medicalopenworld/IncuNest/README.md

# 🌍 IncuNest — Incubadora Neonatal de Código Abierto

**IncuNest** (de *in3ator*) es una incubadora neonatal de código abierto diseñada para hospitales con recursos limitados.
Su misión es reducir la mortalidad neonatal mundial proporcionando un dispositivo médico accesible, fiable y replicable localmente.

---

## 🩺 Contexto y Motivación

Cada año, más de **1,5 millones de bebés prematuros** mueren por falta de acceso a una incubadora. Las incubadoras comerciales son costosas (>35.000 €), haciéndolas inaccesibles en muchas regiones.

**IncuNest** es una alternativa **de bajo coste (≈ 350 € en componentes)** y **eficiente energéticamente**, capaz de mantener la temperatura y humedad vitales incluso con suministro eléctrico inestable.

---

## 📂 Estructura del Proyecto

Para una navegación detallada por todos los componentes del sistema, consulta nuestro **[Inventario de Documentación](docs/INVENTARIO.md)**.

### Resumen Rápido
- **[Firmware](Firmware/)**: Código fuente para ESP32 (Motherboard) y Pantalla (Display HMI).
- **[Hardware](Hardware/)**: Planos electrónicos (PCBs, Esquemáticos) y Mecánicos (CAD, Piezas 3D).
- **[Documentación](docs/)**: Guías detalladas e inventario.

---

## ⚙️ Características Clave

- **Control Automático**: Regulación precisa de temperatura y humedad.
- **Seguridad**: Sistema de energía redundante y alarmas.
- **Conectividad**: Telemetría remota y monitorización IoT.
- **Open Source**: Diseño libre para construir, adaptar y mejorar en cualquier lugar.

---

## 🌱 Impacto Social

El proyecto es desarrollado por la ONG [**Medical Open World**](https://medicalopenworld.org/).
- **+200 incubadoras** instaladas en 30 países.
- **Premio Social Princesa de Girona 2025**.

---

## 🤝 Contribuciones y Licencia

Este proyecto se distribuye bajo una **Licencia de Código Abierto para uso no comercial**.
Para uso comercial, se requiere autorización de **Medicina Abierta al Mundo**.

Consulta el archivo [`LICENSE`](LICENSE) para más detalles.

---

**IncuNest** - *"Para que el lugar donde nace un bebé prematuro no limite sus posibilidades de sobrevivir."*
