medicalopenworld/IncuNest/Firmware/SensorBoard_v2/docs/retro/README.md

# Retros (aprendizajes del loop)

Aquí aterrizan los aprendizajes que `retro-improver` extrae al cerrar cada iteración del loop engineering (paso 7, obligatorio al cerrar una sub-tarea de épica — lo blinda el hook `require-retro.sh`). Cada archivo describe qué costó, qué se repitió y qué mejora concreta se aplicó al propio framework (`.claude/` o `CLAUDE.md`), o bien registra el hallazgo como descartado con motivo cuando no supera el filtro de segunda ocurrencia.

## Convención de nombres

`docs/retro/<AAAA-MM-DD>-<slug>.md`, un archivo por retro.

## Filtro de segunda ocurrencia

No se sistematiza una regla por un fallo de primera vez (puede ser casualidad). Se enruta a `.claude/` (hook/rule/skill/agente) o a `CLAUDE.md` solo cuando el patrón se repite, tiene coste observable, o es claramente generalizable. Lo demás se anota aquí como descartado, con el motivo.

## Índice

- [2026-09-03 · Vigilante de host: reconexión USB sin cortar VBUS](2026-09-03-host-watch-reconexion-usb.md)
- [2026-09-03 · Autoswap D+/D- del PHY USB (conector invertido)](2026-09-03-usb-pin-autoswap.md)
- [2026-07-03 · Fase 5 · Cámara](2026-07-03-fase5-camera.md)
- [2026-07-03 · Fase 3 · Micrófono](2026-07-03-fase3-mic.md)
- [2026-07-03 · Fase 4 · Sensor de puerta](2026-07-03-fase4-door.md)
- [2026-07-03 · Fase 2 · Sensores ambientales](2026-07-03-fase2-env-sensors.md)
- [2026-07-03 · Fase 1 · Transporte USB CDC](2026-07-03-fase1-usb-cdc.md)
- [2026-07-03 · EPIC-000 · Adaptación del framework Genesis a ESP-IDF](2026-07-03-epic-000-adapt-genesis-esp-idf.md)
