medicalopenworld/IncuNest/Firmware/openspec/specs/mb-factory-test/spec.md

# mb-factory-test Specification

## Purpose
TBD - created by archiving change shared-factory-test. Update Purpose after archive.
## Requirements
### Requirement: La batería solo arranca con el control apagado

La motherBoard SHALL rechazar `HMI,FTEST,START` y `HMI,FTEST,RUN` con
`CTRL,FTEST_REJECT,1` si `in3.actuation != ACTUATION_OFF` o
`in3.phototherapy` está activa, y con `CTRL,FTEST_REJECT,0` si ya hay una
batería o un test único en curso. La comprobación SHALL hacerse antes de crear
la tarea de test.

#### Scenario: Control térmico activo
- **WHEN** llega `HMI,FTEST,START` con `in3.actuation = ACTUATION_TEMPERATURE`
- **THEN** la motherBoard responde `CTRL,FTEST_REJECT,1` y no toca ningún
  actuador
- *(Verificación manual en banco.)*

#### Scenario: Batería ya en curso
- **WHEN** llega un segundo `HMI,FTEST,START` mientras la tarea `FTEST` existe
- **THEN** la motherBoard responde `CTRL,FTEST_REJECT,0` y la batería en curso
  continúa sin alterarse
- *(Verificación manual en banco.)*

### Requirement: Estado seguro durante la batería y restauración incondicional

Antes del primer test la tarea SHALL: poner `in3.alarmsEnabled = false`,
levantar `g_factoryTestActive` (que hace que `PIDHandler()` y `turnFans()`
retornen sin escribir PWM), pasar los cuatro PIDs a MANUAL, escribir 0 en los
canales PWM de calefactor, fototerapia, ventilador y zumbador, apagar el
humidificador y poner `ACTUATORS_EN` en LOW. Al terminar, abortar o fallar,
SHALL restaurar `in3.alarmsEnabled` a su valor previo, bajar
`g_factoryTestActive` y dejar todos los PWM a 0 y `ACTUATORS_EN` LOW.

#### Scenario: Abort a mitad del test de actuadores
- **WHEN** llega `HMI,FTEST,ABORT` mientras corre `ACTUATORS`
- **THEN** el test en curso termina con `CTRL,FTEST,14,3,abort`, se emite
  `CTRL,FTEST_DONE`, todos los PWM quedan a 0, `ACTUATORS_EN` LOW,
  `in3.alarmsEnabled` vuelve a true y `PIDHandler()` vuelve a escribir PWM
- *(Verificación manual en banco.)*

#### Scenario: Ninguna alarma de actuador durante la batería
- **WHEN** la batería enciende el calefactor y la fototerapia en lazo abierto
- **THEN** no se declara `ALARM_HEATER_FAULT`, `ALARM_FAN_FAILURE` ni
  `ALARM_AIR_OUTLET_BLOCKED`, y `checkUsbFault()` no apaga el humidificador
- *(Verificación manual en banco.)*

### Requirement: El estado inhibido está acotado

La tarea SHALL estar suscrita al task WDT y alimentarlo en cada iteración y en
cada paso de espera. La batería SHALL abortar, con `restore()` y `FTEST_DONE`,
si supera `FTEST_BATTERY_MAX_MS` (6 min, `detail = max time`), si no llega
ninguna línea `HMI,` durante `FTEST_HMI_DEADMAN_MS` (5 s, `detail = hmi lost`)
o si `in3.actuation != ACTUATION_OFF || in3.phototherapy` pasa a ser cierto a
mitad (`detail = control on`). Ningún escritor de PWM (`PIDHandler()`,
`turnFans()`, bloque `newCommand`, regulación de fototerapia,
`buzzerHandler()`) SHALL escribir mientras `g_factoryTestActive`.

#### Scenario: El display se reinicia a mitad de la batería
- **WHEN** el HMI deja de enviar tramas durante más de 5 s con `ACTUATORS` en
  curso
- **THEN** el test termina como SKIP con `detail = hmi lost`, se emite
  `FTEST_DONE`, los PWM quedan a 0 y las alarmas se restauran
- *(Verificación manual en banco: desconectar el cable del HMI.)*

#### Scenario: Keepalive del HMI durante el test de actuadores
- **WHEN** la trama periódica `HMI,...` llega a 1 Hz mientras `actuatorsTest()`
  mide el calefactor al 100 %
- **THEN** el PWM del calefactor no cambia y la corriente medida se estabiliza
  igual que en el autotest de arranque
- *(Verificación manual en banco comparando el log `[HW] -> Heater:` con el
  del arranque.)*

### Requirement: Batería completa en orden fijo, un resultado por test

La tarea SHALL recorrer los `FTEST_MB_COUNT` tests en el orden de la tabla,
emitir `CTRL,FTEST,id,0` (RUNNING) al empezar cada uno y exactamente un
resultado final (`PASS`, `FAIL` o `SKIP`) al terminarlo, y cerrar con
`CTRL,FTEST_DONE,pass,fail,skip` cuyos contadores SHALL coincidir con la
secuencia emitida. `HMI,FTEST,RUN,id` SHALL ejecutar solo ese test dentro del
mismo estado seguro y cerrar igualmente con `FTEST_DONE`.

#### Scenario: Acumulación de resultados
- **WHEN** `ftest_summary` recibe la secuencia PASS, PASS, FAIL, SKIP, PASS
  para los IDs 0..4
- **THEN** los contadores son `pass = 3, fail = 1, skip = 1`, la máscara PASA
  vale `0b10011`, la máscara FALLA `0b00100` y la máscara EJECUTADO `0b11111`
- *(motherBoard `[env:native]`, `test/test_factory_test/`)*

#### Scenario: RUNNING, WAIT y CONFIRM no cuentan como resultado
- **WHEN** la secuencia para un ID es RUNNING, WAIT, WAIT, PASS
- **THEN** los contadores suman un único PASS y el ID aparece una vez en la
  máscara EJECUTADO
- *(motherBoard `[env:native]`)*

#### Scenario: Test único
- **WHEN** llega `HMI,FTEST,RUN,13` con el control apagado
- **THEN** solo se emiten `CTRL,FTEST,13,0`, un resultado final de 13 y
  `CTRL,FTEST_DONE` con la suma de ese único test
- *(Verificación manual en banco.)*

### Requirement: Tests de la SensorBoard por el enlace USB

`SB_STATUS` SHALL pedir `status` y exigir, en ≤ 5 s, las seis
disponibilidades (`sht0`, `sht1`, `sht2`, `als`, `door`, `cam`) a true,
informando `sb_fw` y `usb_swap` en `detail`; si no hay respuesta SHALL dar
FAIL con `detail = sin respuesta`. `SB_ENV` SHALL exigir las tres
temperaturas válidas y frescas, dispersión entre ellas ≤
`FTEST_SB_SPREAD_MAX_C` (1.0 °C) y diferencia entre su media y el SHT4x
exterior ≤ `FTEST_SB_VS_EXT_MAX_C` (3.0 °C). `SB_CAMERA` SHALL pedir una
captura y exigir un JPEG de ≥ 1000 bytes en ≤ 10 s, liberando el buffer. Los
cinco tests `SB_*` dependen de que `SENSORBOARD` haya pasado por USB.

#### Scenario: Decodificar la respuesta `status`
- **WHEN** `sb_json_decode_status_resp()` recibe
  `{"type":"resp","cmd":"status","id":7,"status":"ok","fw":"1.0.0","sensors":{"sht0":true,"sht1":true,"sht2":false,"als":true,"door":true,"cam":true,"usb_swap":false}}`
- **THEN** devuelve true con `fw = "1.0.0"`, `avail_sht = {true,true,false}`,
  `avail_als/door/cam = true`, `usb_swap = false`
- *(motherBoard `[env:native]`, `test/test_sensorboard_json/`)*

#### Scenario: Respuesta `status` incompleta
- **WHEN** falta el objeto `sensors` o `status` no es `"ok"`
- **THEN** el decodificador devuelve false y el snapshot no cambia
- *(motherBoard `[env:native]`)*

#### Scenario: Una SHT40 mal soldada
- **WHEN** `status` devuelve `sht2:false`
- **THEN** `SB_STATUS` da FAIL con `detail` que nombra `sht2`
- *(Verificación manual en banco.)*

### Requirement: Tests con estímulo del operario

`SB_DOOR` SHALL devolver SKIP con `detail = omitido` sin emitir WAIT mientras el
jig de fábrica no monte la puerta (pendiente de reactivar). `SB_LIGHT` SHALL
medir la base de lux durante 2 s, emitir WAIT y dar PASS si el lux cae por
debajo del 50 % de la base dentro de 20 s; con base < 20 lux SHALL dar SKIP con
`detail = poca luz`.

#### Scenario: Puerta omitida
- **WHEN** la batería llega a `SB_DOOR`
- **THEN** emite SKIP `omitido` de inmediato, sin instrucción al operario
- *(Verificación manual en banco.)*

#### Scenario: Operario no tapa el sensor de luz
- **WHEN** pasan 20 s sin caída de lux tras el WAIT de `SB_LIGHT`
- **THEN** `SB_LIGHT` da FAIL con `detail = timeout` y la batería continúa
- *(Verificación manual en banco.)*

### Requirement: Zumbador verificado con el micrófono, con confirmación de respaldo

`BUZZER` SHALL tomar la base de dBA del snapshot, activar el zumbador
(`ledcWrite(BUZZER_PWM_CHANNEL, BUZZER_HALF_PWM)`) hasta recibir una nueva
muestra de `sound_level` (≤ 7 s), apagarlo y dar PASS si la subida es ≥
`FTEST_BUZZER_DBA_DELTA` (6 dB). Si el snapshot no tiene `sound_seen`, SHALL
dar SKIP con `detail = sin microfono` sin hacer sonar el zumbador ni preguntar
al operario: el test de fábrica no hace preguntas de audio.

#### Scenario: Con SensorBoard con micrófono
- **WHEN** hay `sound_seen` y el zumbador suena
- **THEN** `BUZZER` da PASS con `detail` con la base y el pico en dBA
- *(Verificación manual en banco.)*

#### Scenario: Sin micrófono
- **WHEN** el snapshot no tiene `sound_seen`
- **THEN** `BUZZER` da SKIP `sin microfono` y no se emite ningún CONFIRM
- *(Verificación manual en banco.)*

### Requirement: Tests de actuadores y humidificador reutilizan el autotest

`ACTUATORS` SHALL invocar `actuatorsTest()` y dar FAIL si aparece en
`HW_error` cualquier bit nuevo de calefactor, fototerapia o ventilador
respecto al valor previo a la llamada. `FAN_RPM` SHALL exigir
`in3.fanHasSpeedFeedback && in3.fan_rpm >= FAN_MIN_RPM` tras `ACTUATORS`.
`HUMID_USB` SHALL devolver SKIP con `detail = omitido` sin tocar `USB_EN`
mientras el jig de fábrica no pueda medir el humidificador. `STANDBY` SHALL
invocar `testStandByCurrent()` con el mismo criterio de bits nuevos.

#### Scenario: Ventilador sin tacómetro
- **WHEN** `ACTUATORS` pasa pero `in3.fanHasSpeedFeedback` queda false
- **THEN** `FAN_RPM` da FAIL con `detail = sin feedback`
- *(Verificación manual en banco.)*

#### Scenario: Humidificador omitido
- **WHEN** la batería llega a `HUMID_USB`
- **THEN** emite SKIP `omitido` de inmediato y `USB_EN` sigue en LOW
- *(Verificación manual en banco.)*

### Requirement: Tests de comunicaciones pasivos

`GSM_AT` SHALL dar PASS si el módem ha respondido a algún comando AT
(`GPRS.modemResponded`, `GPRS.simReady`, `GPRS.connect` o `GPRS.post`) en ≤
45 s; `GSM_SIM` si `GPRS.simReady` (`+CPIN: READY`) en ≤ 15 s, con el CCID
solo informativo; `GSM_SIGNAL` (opcional) PASS si `1 <= GPRS.CSQ <= 31` en ≤
15 s, si no WARN `sin señal`; `GSM_NET` (opcional) PASS si `GPRS.post` en ≤
`FTEST_CONN_TIMEOUT_MS` (30 s), si no WARN `sin red`. `WIFI` (opcional) SHALL
dar PASS con RSSI si `WIFIIsConnected()` en ≤ 30 s, si no WARN `sin AP`.
`TB_PROVISION` (opcional) SHALL dar WARN `sin serie` si
`in3.serialNumber == 0`, PASS si `WIFIIsConnectedToServer() ||
GPRSIsConnectedToServer()` en ≤ 30 s, y WARN `sin servidor` en otro caso.
`TIME` (opcional) SHALL dar PASS si `time(nullptr) >= 1609459200` con la
fuente en `detail`, si no WARN `sin hora` a los 30 s. Ninguno de estos tests
SHALL escribir en `Serial2`, ni modificar credenciales WiFi, ni forzar
reconexiones. Solo `GSM_AT` y `GSM_SIM` pueden dar FAIL: conectarse es
opcional.

#### Scenario: Módem arrancado antes de pulsar el botón
- **WHEN** el módem completó su secuencia de arranque antes de `HMI,FTEST,START`
- **THEN** `GSM_AT` y `GSM_SIM` dan PASS de inmediato, sin esperar los 45 s
- *(Verificación manual en banco.)*

#### Scenario: Sin cobertura
- **WHEN** hay SIM pero `GPRS.CSQ` no es válido en 15 s
- **THEN** `GSM_SIGNAL` da WARN `sin señal` y `GSM_NET` WARN `sin red`; ningún
  test GSM queda en rojo
- *(Verificación manual en banco.)*

#### Scenario: Sin número de serie
- **WHEN** `in3.serialNumber == 0`
- **THEN** `TB_PROVISION` da WARN con `detail = sin serie` sin esperar los 30 s
- *(Verificación manual en banco.)*

#### Scenario: Sin SIM
- **WHEN** el módem responde pero `GPRS.simReady` sigue en false 15 s después
- **THEN** `GSM_SIM` da FAIL, y `GSM_SIGNAL` y `GSM_NET` dan SKIP con
  `detail = sin sim`
- *(Verificación manual en banco.)*

### Requirement: Persistencia del resultado

Al emitir `FTEST_DONE` tras una batería completa, la motherBoard SHALL
guardar en NVS `mb_ftest`: `epoch` (0 si no hay hora), máscaras PASA, FALLA,
AVISO y EJECUTADO, `FWversion` y `sb_fw`. Un test único SHALL actualizar solo
los bits de su ID en las cuatro máscaras.

#### Scenario: Reintento de un test fallido
- **WHEN** la batería guardó el ID 12 en FALLA y luego `RUN,12` da PASS
- **THEN** en NVS el bit 12 pasa de FALLA a PASA y el resto de bits no cambia
- *(motherBoard `[env:native]` para la lógica de máscaras de `ftest_summary`;
  la escritura NVS, verificación manual.)*

#### Scenario: Aviso que pasa a correcto
- **WHEN** `WIFI` quedó en AVISO y un `RUN` posterior da PASS
- **THEN** el bit pasa de la máscara AVISO a la máscara PASA
- *(motherBoard `[env:native]`)*

### Requirement: El TX hacia el display se serializa en una cola

Toda línea `CTRL,FTEST*` SHALL entregarse por una cola de
`FTEST_TX_QUEUE_LEN` (32) líneas de `FTEST_TX_LINE_MAX` (64) bytes que solo
`Communication_Task` drena y escribe en `hmiSerial`.

Los resultados y el `CTRL,FTEST_DONE` que emite la tarea FTEST SHALL usar
`CommunicationHost_EnqueueWait()`, esperando hasta 500 ms a que haya hueco:
la motherBoard emite UNA sola línea de resultado por test, y perderla deja
ese test sin cerrar en el display. La tarea FTEST corre a prioridad 3, por
debajo de `Communication_Task` (7), que drena la cola entera cada 1 ms, así
que esa espera es siempre corta.

Las líneas que emite `parse_line()` (eco de `RUN`, `CTRL,FTEST_REJECT`) SHALL
seguir usando `CommunicationHost_Enqueue()` sin espera: corren DENTRO de
`Communication_Task`, y esperar ahí sería esperarse a sí misma.

Agotado el plazo — o sin hueco, en la versión sin espera — la línea SHALL
descartarse con log de error y SHALL incrementar `CommunicationHost_TxDrops()`.
Al terminar cada batería la tarea FTEST SHALL registrar en el log el balance
(`p/f/s/w`) y ese contador: con el contador a 0 y tests sin cerrar en el
display, la pérdida NO fue en esta cola (banco 2026-09-07).

#### Scenario: Resultados durante la traza PPG
- **WHEN** la batería emite resultados mientras `CTRL,PPG` sale a 25 Hz
- **THEN** ninguna línea llega al display entrelazada con otra
- *(Verificación manual en banco con la sonda SpO2 aplicada.)*

### Requirement: Sensor ambiental por cualquiera de sus tres caminos

El test `ENV_SENSOR` (id 6) SHALL dar PASS si, en ≤ 10 s, cualquiera de estos
caminos entrega una lectura fresca (< 5 s; < 3 s para USB), finita y en rango:
`usb` (`sensorSourceGet() == SENSOR_SOURCE_SENSORBOARD`, enlace vivo,
`env_seen`, alguna temperatura válida), `i2c` (fuente I2C2 y
`in3.temperature[ROOM_DIGITAL_TEMP_SENSOR]` en `DIG_TEMP_ROOM_MIN..MAX`) o
`sht4x` (`ambientSensorPresent` e `in3.temperature[AMBIENT_DIGITAL_TEMP_SENSOR]`
en −10..60 °C). El camino va en `detail`. En otro caso FAIL con
`detail = sin sensor ambiental`. La cascada `sb_usb` SHALL marcarse OK solo
si el camino fue `usb`; `SB_STATUS`, `SB_ENV`, `SB_DOOR`, `SB_LIGHT` y
`SB_CAMERA` SHALL dar SKIP con `detail = sin usb` en otro caso. `SB_ENV` SHALL
comparar con el exterior solo si hay SHT4x con lectura fresca.

#### Scenario: Unidad con SensorBoard y sin SHT4x
- **WHEN** la SensorBoard publica `sensor_data` y no hay SHT4x exterior
- **THEN** `ENV_SENSOR` da PASS `usb` y `SB_ENV` evalúa solo la dispersión
  entre las tres SHT40
- *(Verificación manual en banco.)*

#### Scenario: Unidad antigua con SHT4x
- **WHEN** no hay SensorBoard, la fuente es I2C2 sin datos y el SHT4x lee
- **THEN** `ENV_SENSOR` da PASS `sht4x` y los cinco `SB_*` dan SKIP
- *(Verificación manual en banco.)*

### Requirement: Los tests no compiten por el bus I2C

Ningún cuerpo de test SHALL emitir transacciones I2C propias, salvo dentro de
`actuatorsTest()` y `testStandByCurrent()`. `CHARGER` SHALL esperar ≤ 12 s a
`g_bq_status_valid` con sello `g_bq_status_ms` fresco (que refresca
`sensors_Task` cada 5 s) y dar PASS si el BQ25730 respondió, informando VBAT,
VSYS y `ac`/`bat` en `detail`; si no responde SHALL dar WARN `sin vbus`: sin
alimentación externa el BQ25730 no está alimentado y no es un fallo de placa.
`POWER_SRC` SHALL devolver SKIP `omitido` mientras el jig no alimente por
VBUS. `SKIN_ADC` SHALL usar `skinProbeLastReading()` y el sello
`lastSuccesfullSensorUpdate[SKIN_SENSOR]`; `INA3221` SHALL usar los flags de
presencia. El runner SHALL esperar 60 ms entre el resultado final de un test y
el RUNNING del siguiente para no desbordar el anillo del display.

#### Scenario: Placa alimentada solo con batería
- **WHEN** no hay VBUS y el BQ25730 no responde
- **THEN** `CHARGER` da WARN `sin vbus` en ≤ 12 s y `POWER_SRC` da SKIP
  `omitido`; ningún test queda en RUNNING
- *(Verificación manual en banco.)*

#### Scenario: Ráfaga de tests omitidos
- **WHEN** varios tests consecutivos terminan en SKIP de inmediato
- **THEN** entre cada resultado y el RUNNING siguiente pasan al menos 60 ms
- *(Verificación manual en banco con el monitor serie.)*

### Requirement: Timeout cooperativo por test

El runner SHALL registrar el inicio de cada test y, si supera
`FTEST_TEST_TIMEOUT_MS` (90 s), el cuerpo SHALL terminar en su siguiente paso
de espera con FAIL y `detail = timeout`; la batería SHALL continuar con el
test siguiente. Un cuerpo bloqueado en una llamada no cooperativa solo lo
cubre el task WDT.

#### Scenario: Test que no progresa
- **WHEN** un cuerpo lleva 90 s en sus bucles de espera sin resultado
- **THEN** emite `CTRL,FTEST,<id>,2,timeout` y arranca el siguiente test
- *(Verificación manual en banco forzando un plazo corto.)*

### Requirement: Orden de ejecución con solape cooperativo

La tarea `FTEST` SHALL clasificar cada test como **pasivo** (solo observa
estado cacheado o una petición asíncrona: `charger`, `env_sensor`,
`sb_status`, `sb_camera`, `gsm_at`, `gsm_sim`, `gsm_signal`, `gsm_net`,
`wifi`, `tb_provision`, `time`, y los instantáneos `sysinfo`, `ina3221`,
`skin_adc`, `hmi_link`, `nvs`, `littlefs`, `power_src`, `humid_usb`,
`sb_door`, `afe_probe`) o **activo** (`standby`, `actuators`, `fan_rpm`,
`buzzer`, `afe_spi`, `sb_env`, `sb_light`). Al arrancar la batería SHALL
emitir RUNNING de todos los pasivos y arrancar un cronómetro común; SHALL
sondearlos cada 250 ms, incluidos los tramos de espera de los activos, y
emitir el resultado final de cada uno en cuanto se resuelva o venza su plazo
propio. Los activos SHALL ejecutarse secuencialmente, en el orden de la
tabla, uno a la vez y nunca solapados entre sí. Las cascadas SHALL
respetarse (`gsm_signal`/`gsm_net` esperan a `gsm_sim`; `sb_status`,
`sb_camera` y `sb_env` esperan a `env_sensor`). Tras el último activo la
tarea SHALL seguir sondeando hasta resolver todos los pasivos. ABORT,
dead-man y tope de batería SHALL cerrar los pasivos pendientes como SKIP con
el motivo. La cota de 90 s por test aplica a los activos; los pasivos se
acotan por su plazo propio. Todo ello sin crear tareas FreeRTOS nuevas: un
único escritor hacia el HMI y ningún acceso concurrente al bus.

#### Scenario: Fábrica sin cobertura ni AP
- **WHEN** no hay SIM registrable, ni AP, ni servidor, ni hora de red
- **THEN** la batería completa termina en menos de 60 s (frente a varios
  minutos en secuencial), con los mismos resultados WARN que antes
- *(Verificación manual en banco con cronómetro.)*

#### Scenario: Los activos nunca se solapan
- **WHEN** `actuators` está midiendo corriente
- **THEN** ningún otro activo está en RUNNING y los pasivos solo leen estado
  cacheado, sin tocar el bus I2C ni los actuadores
- *(Verificación manual en banco: monitor serie, un solo activo RUNNING a la vez.)*

#### Scenario: ABORT con pasivos pendientes
- **WHEN** llega `HMI,FTEST,ABORT` con `wifi` y `tb_provision` aún en RUNNING
- **THEN** ambos terminan como SKIP `abort`, se emite `FTEST_DONE` y se
  restaura el estado seguro
- *(Verificación manual en banco.)*

### Requirement: Activación de la SIM Onomondo

El test `SIM_ACT` (id 28, pasivo) SHALL ejecutarse solo si el ICCID leído del
módem empieza por `ONOMONDO_ICCID_PREFIX` (`894573`); con otra SIM SHALL dar
SKIP `sim no onomondo`, y SKIP `sin sim` si `GSM_SIM` falló. Con SIM Onomondo
SHALL arrancar la activación contra la API en cuanto haya ICCID y WiFi, y dar
PASS si la API confirma la SIM activada (ya activa, o activada en esta
pasada). Si la API **contesta** y la SIM queda sin activar (GET distinto de
200, cuerpo sin `activated`, PATCH rechazado) SHALL dar **FAIL** con el
motivo. Si **no se pudo consultar** la API (sin TLS/HTTP, 429/5xx
persistentes, build sin clave, sin tarea) o si en `FTEST_SIM_ACT_TIMEOUT_MS`
(80 s) no hubo ICCID o WiFi, SHALL dar **WARN** con el motivo (`sin iccid`,
`sin wifi`, `sin respuesta`, `api N`, `sin key`): no se conoce el estado de la
SIM y no es un fallo de la placa.

#### Scenario: Banco sin WiFi con SIM Onomondo
- **WHEN** hay ICCID `894573…` y `WIFIIsConnected()` es falso durante 80 s
- **THEN** `SIM_ACT` da WARN `sin wifi` y el veredicto no pasa a HW ERROR por
  ese test
- *(Verificación manual en banco.)*

#### Scenario: SIM Onomondo que la API no activa
- **WHEN** hay WiFi, el GET devuelve 404 (SIM fuera de la cuenta) o el PATCH
  es rechazado
- **THEN** `SIM_ACT` da FAIL con `get 404` o `patch N` y el veredicto es
  HW ERROR
- *(Verificación manual en banco con red.)*

#### Scenario: SIM de otro operador
- **WHEN** el ICCID no empieza por `894573`
- **THEN** `SIM_ACT` da SKIP `sim no onomondo` sin contactar con la API
- *(Verificación manual en banco.)*

#### Scenario: Activación correcta o ya activa
- **WHEN** hay WiFi y la API responde `activated: true`, ya sea antes o tras
  el PATCH
- **THEN** `SIM_ACT` da PASS con `ya activada` o `activada`
- *(Verificación manual en banco con red.)*
