medicalopenworld/IncuNest/Firmware/SensorBoard_v2/openspec/specs/usb-transport/spec.md

# usb-transport Specification

## Purpose
TBD - created by archiving change sb-phase1-usb-cdc. Update Purpose after archive.
## Requirements
### Requirement: CRC16-CCITT FALSE

El componente `usb_comm` SHALL calcular CRC16-CCITT FALSE (polinomio 0x1021, init 0xFFFF) sobre Type+Length+Payload, con API incremental (`sb_crc16_byte`) y por bloque (`sb_crc16`).

#### Scenario: Vector conocido

- **WHEN** se calcula el CRC de los 9 bytes ASCII `"123456789"`
- **THEN** el resultado es `0x29B1`

#### Scenario: Datos vacíos

- **WHEN** se calcula el CRC de 0 bytes
- **THEN** el resultado es el valor inicial `0xFFFF`

#### Scenario: Incremental equivale a bloque

- **WHEN** se calcula el CRC de un bloque byte a byte con `sb_crc16_byte`
- **THEN** el resultado es idéntico al de `sb_crc16` sobre el bloque completo

### Requirement: Frame encoder

`sb_frame_encode` SHALL producir `Magic(0xAB,0xCD) + Type(1B) + Length(4B little-endian) + Payload + CRC16(2B big-endian)`.

#### Scenario: Layout del frame

- **WHEN** se codifica un payload de N bytes
- **THEN** la salida mide N+9 bytes, empieza por `0xAB 0xCD`, lleva el tipo en el byte 2, la longitud little-endian en los bytes 3-6 y el payload desde el byte 7

#### Scenario: Buffer insuficiente

- **WHEN** el buffer de salida es menor que payload+9
- **THEN** el encoder devuelve 0 y no escribe fuera del buffer

### Requirement: Frame decoder con resincronización

El decoder SHALL ser una máquina de estados byte a byte que entrega frames válidos por callback, descarta silenciosamente frames con CRC inválido, se resincroniza tras bytes basura y rechaza longitudes mayores que su buffer.

#### Scenario: Round-trip

- **WHEN** se alimenta el decoder con un frame codificado por `sb_frame_encode`
- **THEN** el callback recibe exactamente una vez el mismo tipo y payload

#### Scenario: CRC corrupto

- **WHEN** se alimenta un frame con el CRC alterado
- **THEN** el callback no se invoca

#### Scenario: Resync tras basura

- **WHEN** se alimentan bytes arbitrarios que no forman un frame y después un frame válido
- **THEN** el callback se invoca exactamente una vez con el frame válido

#### Scenario: Payload vacío

- **WHEN** se alimenta un frame válido de longitud 0
- **THEN** el callback se invoca con longitud 0

#### Scenario: Longitud excesiva

- **WHEN** el campo Length excede el tamaño del buffer del decoder
- **THEN** el decoder descarta el frame y vuelve a buscar magic sin desbordar el buffer

### Requirement: Emisión única por cola TX

Todo dato saliente SHALL pasar por `sensorBoard_comm_send_json()` o `sensorBoard_comm_send_binary()`, que codifican el frame y lo encolan; solo `usb_tx_task` escribe en el endpoint CDC. `send_binary` SHALL enmarcar el payload en un buffer asignado en PSRAM (fallback a heap interna) cuyo **ownership pasa a la cola TX**: `usb_tx_task` lo transmite por chunks y lo libera siempre (también si el host no está conectado o el envío falla).

#### Scenario: JSON demasiado grande

- **WHEN** `send_json` recibe una cadena mayor que `SB_PROTO_MAX_JSON_PAYLOAD` (256 B)
- **THEN** devuelve error sin encolar nada

#### Scenario: send_binary con argumentos inválidos

- **WHEN** `send_binary` recibe buf NULL, longitud 0 o mayor que `SB_PROTO_MAX_BINARY_PAYLOAD`
- **THEN** devuelve error sin asignar memoria ni encolar

#### Scenario: send_binary sin init

- **WHEN** se invoca `send_binary` antes de `sensorBoard_comm_init()`
- **THEN** devuelve `ESP_ERR_INVALID_STATE`

#### Scenario: Round-trip de frame binario grande

- **WHEN** se codifica un payload `TYPE=0x01` de varios KB con `sb_frame_encode` y se alimenta a un decoder con buffer suficiente
- **THEN** el callback recibe el mismo tipo y payload exactos (el framing es el mismo de Fase 1)

### Requirement: Logs como frames JSON

`usb_comm` SHALL interceptar `ESP_LOG` vía `esp_log_set_vprintf()` y emitirlo como frames JSON `{"type":"log","ts":...,"msg":"..."}` con `"` y `\` escapados; si la cola TX no existe aún, el log se descarta sin bloquear.

#### Scenario: Log antes de init

- **WHEN** se emite un `ESP_LOG` antes de que exista la cola TX
- **THEN** el interceptor retorna sin bloquear ni crashear

### Requirement: Tolerancia a la inversión de D+/D-

`usb_comm` SHALL tolerar que el conector USB (SensorBoard HW_NUM 4) llegue con D+ y D- cruzados, intercambiándolos en el PHY USB del ESP32-S3 (`exchg_pins`) con un detach/attach visible para el host, **solo con evidencia de host**: la política SHALL armar un plazo de `CONFIG_SB_USB_AUTOSWAP_TIMEOUT_MS` (2000 ms por defecto, mínimo 1500) al observar el **primer bus reset** (`DCD_EVENT_BUS_RESET`) y, si al vencer el plazo el host no ha hablado al dispositivo (ni primer SETUP — `tud_connected` — ni `SET_CONFIGURATION` — `tud_mounted`), SHALL intercambiar **una sola vez** y esperar un nuevo bus reset antes de volver a intercambiar. Sin bus reset la orientación NUNCA cambia (arranque y espera sin host en orientación normal). Resets adicionales mientras el plazo está armado NO lo extienden. Con host activo NUNCA intercambia y el plazo se desarma. La decisión SHALL residir en una política pura (`sb_usb_orient_*`) sin dependencia de hardware. Cada intercambio SHALL registrarse con `ESP_LOGW` (visible en la retención de arranque al conectar) y el estado SHALL exponerse en la resp de `status` como `sensors.usb_swap`. Antes de intercambiar, `usb_comm` SHALL re-armar la retención de arranque (el flag DTR es pegajoso sin VBUS sensing), y toda escritura al CDC SHALL exigir DTR visto **y** `tud_cdc_n_connected()`.

#### Scenario: Sin evidencia de host no intercambia

- **WHEN** la política recibe ticks sin bus reset y sin host activo durante un tiempo arbitrariamente largo
- **THEN** no devuelve ninguna acción y la orientación sigue siendo la normal

#### Scenario: Reset sin host: un intercambio y quieto

- **WHEN** ve un bus reset en `t0` y no llega host activo
- **THEN** no actúa antes de `t0 + T`, devuelve la acción de intercambio exactamente una vez en `>= t0 + T`, la orientación pasa a intercambiada, y sin un nuevo reset no vuelve a actuar aunque pase el tiempo

#### Scenario: Resets repetidos no extienden el plazo

- **WHEN** ve bus resets en `t0`, `t0 + T/4` y `t0 + T/2` sin host activo
- **THEN** intercambia en `t0 + T`, no más tarde

#### Scenario: Host activo desarma

- **WHEN** ve un bus reset en `t0` y host activo antes de `t0 + T`
- **THEN** no devuelve ninguna acción en `t0 + T` ni después, y una caída posterior del host sin nuevo reset tampoco provoca intercambio

#### Scenario: Reset y host activo en el mismo tick

- **WHEN** en un mismo tick se observa un bus reset y el host ya está activo
- **THEN** no se arma ningún plazo: los ticks posteriores sin host ni reset no provocan intercambio

#### Scenario: Nueva evidencia tras intercambiar

- **WHEN** tras un intercambio ve otro bus reset sin host activo
- **THEN** intercambia de nuevo (vuelve a la orientación anterior) `T` después de ese reset, y el contador de intercambios vale 2

#### Scenario: Desbordamiento del reloj

- **WHEN** `now_ms` da la vuelta (uint32) entre el reset y el vencimiento
- **THEN** el plazo vence igualmente en `t0 + T` módulo 2^32

#### Scenario: Política desactivada

- **WHEN** el timeout configurado es 0
- **THEN** ningún tick devuelve acción, con o sin reset, con o sin host
