medicalopenworld/IncuNest/Firmware/docs/alarm_images_refs/sensor_aire/QUE_FOTOGRAFIAR.md

# Sensor de temperatura de aire

**Usada por las alarmas:** 3, 15

DOS fotos y la segunda es la que falta hoy: el sensor de cerca, y el sensor MONTADO, con suficiente contexto para ver en que punto de la cupula esta. El modelo lo esta colocando a ojo en la pared trasera.

Deja aqui los ficheros .jpg o .png sin mas. El script los reescala a 1024 px antes de enviarlos, asi que no hace falta prepararlos.

Si esta carpeta se queda vacia no pasa nada: el script avisa y genera igual, con la forma inventada que tiene hoy.
