medicalopenworld/IncuNest/Firmware/docs/alarm_images_refs/sensor_corriente/QUE_FOTOGRAFIAR.md

# Sensor de corriente del calefactor

**Usada por las alarmas:** 17

La placa con su pinza alrededor del cable, y un primer plano del conector de senal, enchufado y desenchufado. La 17 se juega en ese conector.

Deja aqui los ficheros .jpg o .png sin mas. El script los reescala a 1024 px antes de enviarlos, asi que no hace falta prepararlos.

Si esta carpeta se queda vacia no pasa nada: el script avisa y genera igual, con la forma inventada que tiene hoy.
