medicalopenworld/IncuNest/Firmware/docs/alarm_images_refs/sensorboard/QUE_FOTOGRAFIAR.md

# SensorBoard y su enlace USB

**Usada por las alarmas:** 18

El modulo montado en su sitio, su cable USB, y el puerto del equipo donde entra. La 18 necesita mostrar ese conector fuera del puerto.

Deja aqui los ficheros .jpg o .png sin mas. El script los reescala a 1024 px antes de enviarlos, asi que no hace falta prepararlos.

Si esta carpeta se queda vacia no pasa nada: el script avisa y genera igual, con la forma inventada que tiene hoy.
