medicalopenworld/IncuNest/Firmware/docs/alarm_images_refs/sonda_piel/QUE_FOTOGRAFIAR.md

# Sonda de temperatura de piel

**Usada por las alarmas:** 2, 4, 10, 11, 15

El disco y su cable sueltos, y la sonda COLOCADA sobre el abdomen (vale un muneco). La segunda define como se dibuja en 4, 10 y 11.

Deja aqui los ficheros .jpg o .png sin mas. El script los reescala a 1024 px antes de enviarlos, asi que no hace falta prepararlos.

Si esta carpeta se queda vacia no pasa nada: el script avisa y genera igual, con la forma inventada que tiene hoy.
