medicalopenworld/IncuNest/Hardware/Electronics/Motherboard/Project Outputs for IncuNest/BOM/Bill of Materials-IncuNest(Main).xlsx

Comment | Designator | Quantity | LCSC_PN
CUI CMT-1285C-035 | BUZ1 | 1 | C252915
1uF 0402 X5R 50V | C1, C13, C40, C56, C61, C96, C97 | 7 | C1518208
10uF 0402 X5R 10V | C2, C4, C5, C14, C15, C69, C70, C71, C72, C79, C80, C81, C82, C88, C89, C90, C91 | 17 | C77000
100nF 0402 X7R 50V | C3, C11, C12, C23, C24, C25, C26, C43, C57, C68, C73, C76, C77, C78, C83, C86, C87, C92, C95, C98, C99, C100, C103, C104, C106 | 25 | C77020
18pF 0402 X5R 50V | C6, C10, C21 | 3 | C33149
10nF 0402 X7R 50V | C7, C27, C29, C52 | 4 | C60133
2.2uF 0402 X5R 25V | C8, C9, C55 | 3 | C77002
15pF 0402 X5R 50V | C16, C62 | 2 | C86285
33pF 0402 X7R 50V | C22, C65 | 2 | C107005
1nF 0402 X7R 50V | C28 | 1 | C93920
10uF 0805 X5R 50V | C30, C31, C32, C33, C34, C35, C36, C37, C44, C45, C46, C47, C48, C49, C50, C51, C58, C59, C101, C102 | 20 | C2932476
47nF 1206 X7R 50V | C38, C39 | 2 | C107209
150pF 0402 X7R 50V | C41, C42 | 2 | C113789
33nF 0402 X7R 50V | C53, C54 | 2 | C106862
680pF 0402 X5R 50V | C60 | 1 | C307451
100pF 0402 X7R 50V | C63, C64, C66 | 3 | C281751
4.7 uF 0402 X7R 50V | C67 | 1 | C23733
10uF 0603 X5R 25V | C74, C75, C84, C85, C93, C94 | 6 | C91606
100uF 6v3 | C105 | 1 | C1954161
100uF 25V | C107 | 1 | C7469933
LESD5D5.0CT1G | D1, D12 | 2 | C383211
SS14 | D2 | 1 | C2480
BAV99W-7-F | D4, D5, D6, D7 | 4 | C93035
MMSZ5231BT1G | D8 | 1 | C2759896
ESDA6V1-5SC6 | D9 | 1 | C2827672
SMBJ24CA-E3/52 | D10 | 1 | C83268
SMBJ33CA-TR | D11 | 1 | C83325
SMBJ18CA | D13 | 1 | C83327
BAT54C | D14 | 1 | C181200
BZT52C3V0-7-F | D15 | 1 | C85212
BAS316Z | D16 | 1 | C549222
691305530004 | J3 | 1 | C441388
WJ15EDGVC-3.81-2P | J4 | 1 | C22365241
B4B-XH-A(LF)(SN) | J5 | 1 | C144395
2-5747706-0 | J6 | 1 | C189689
PJ-612 | J7 | 1 | C309284
691311400102 | J8, J11 | 2 | C19724644
Degson 2EDGK-5.08-02P-14-00AH | J9 | 1 | C8445
B6B-PH-K_LF__SN_ | J10 | 1 | C495261
1042240820 | J12 | 1 | C585349
TYPE-C 16PLC-H10.0 | J13, J14 | 2 | C3151747
SRP1265A-3R3M | L1 | 1 | C19268665
1217AS-H-3R3N=P3 | L2, L3, L4 | 3 | C514864
IPD90P03P404ATMA1 | Q1 | 1 | C845609
IRLR7843TRPBF | Q2, Q5 | 2 | C21988
2N7002-7-F | Q3, Q6 | 2 | C65189
IRLML6244TRPBF | Q4 | 1 | C143946
AON7528 | Q7, Q8 | 2 | C5297617
BSC059N04LS6ATMA1 | Q9, Q10, Q11, Q12 | 4 | C534356
AON6407 | Q13 | 1 | C13899
AON6442 | Q14 | 1 | C182465
AOD4185 | Q15, Q16 | 2 | C400894
10k 0402 0.1% | R1, R2, R3, R4, R8, R11, R12, R15, R20, R21, R23, R24, R25, R37, R64, R72, R73, R75, R76, R78, R80 | 21 | C190095
4k7 0402 1% | R5, R6 | 2 | C105871
33k 0402 1% | R7, R58 | 2 | C138003
100R 0402 0.1% | R9, R14, R22, R41, R42, R43, R45, R47, R83 | 9 | C106233
1k 0402 1% | R10, R28, R36, R38 | 4 | C106235
0.1R 0402 0.1% | R13, R19 | 2 | C2139031
4.99R 0402 1% | R16, R53, R54 | 3 | C844114
0.005R 1206 0.5W 1% | R17, R48, R49, R59 | 4 | C728276
0R 0402 1% | R18, R34, R35, R39, R40, R55, R56 | 7 | C60485
130Ohm 0402 1% | R26, R27, R29, R30, R31, R32, R33 | 7 | C413066
2k26 0402 0.1% | R44 | 1 | C852697
0.002R 1206 0.5W 1% | R46 | 1 | C728282
3R9 1206 0.5W 1% | R50, R51 | 2 | C17885
1R 0805 0.5W 1% | R60 | 1 | C144579
10R 0402 0.1% | R61, R62, R63, R65 | 4 | C138066
15k 0402 0.1% | R66 | 1 | C852545
383k 0402 1% | R67 | 1 | C2076791
169k 0402 1% | R68 | 1 | C327367
220k 0402 1% | R69 | 1 | C138030
30.1k 0402 1% | R70 | 1 | C138009
40.2k 0402 1% | R71 | 1 | C137983
73k2 0402 1% | R74 | 1 | C185398
56k 0402 0.1% | R77 | 1 | C114756
47k 0402 0.1% | R79 | 1 | C93943
PTS647SK70SMTR2N_LFS | S1 | 1 | C47324878
TS-1088-AR02016 | S2 | 1 | C720477
ESP32-S3-WROOM-1-N8 | U1 | 1 | C2913198
TPS2553DBVR | U2 | 1 | C55266
LM4040EIM7-2.0_NOPB | U3 | 1 | C1848440
AFE4490RHAR | U4 | 1 | C2651608
Simcom SIM800C | U5 | 1 | C2981431
INA3221AIRGVR | U7, U8 | 2 | C181255
ADS1110A0IDBVR | U9 | 1 | C16598
LM74700QDBVRQ1 | U10, U16, U17 | 3 | C2941042
BQ25730RSNR | U11 | 1 | C5219071
TPS563231DRLR | U12, U13, U14 | 3 | C779412
SPX3819M5-L-3-3/TR | U15 | 1 | C9055
UCC27517ADBVR | U18 | 1 | C2653784
ABM3-8.000MHZ-D2Y-T | Y1 | 1 | C144380
