medicalopenworld/IncuNest/Hardware/Electronics/SensorBoard/Project Outputs for SensorBoard/BOM/Bill of Materials-SensorBoard(Main).xlsx

Comment | Designator | Quantity | LCSC_PN
1uF 0402 X5R 50V | C1, C14, C16, C20, C22 | 5 | C1518208
10uF 0402 X5R 10V | C2, C9, C12, C18, C23 | 5 | C77000
100nF 0402 X7R 50V | C3, C4, C5, C6, C7, C8, C10, C11, C13, C15, C19, C21, C24 | 13 | C77020
22pF 0402 X5R 10V | C17 | 1 | C106203
LESD5D5.0CT1G | D1, D2, D3 | 3 | C5274290
SFV24R-1STE1HLF | J2 | 1 | C599469
KH-TYPE-C-16P | J3 | 1 | C709357
SWPA3015S2R2NT | L1 | 1 | C19734
ALS-PT19-315C_L177_TR8 | Q1 | 1 | C146233
10k 0402 0.1% | R1, R2, R6, R12, R14 | 5 | C190095
1k 0402 1% | R7 | 1 | C106235
100k 0402 1% | R8 | 1 | C60491
4k7 0402 1% | R9, R10, R23, R24 | 4 | C105871
0R 0402 1% | R11, R13, R15 | 3 | C60485
33R 0402 1% | R16, R17 | 2 | C138002
5k1 0402 1% | R18, R19 | 2 | C105872
680k 0402 1% | R20 | 1 | C163456
10k 0402 1% | R21 | 1 | C60490
150k 0402 1% | R22 | 1 | C93947
TS-1088-AR02016 | S1 | 1 | C720477
ESP32-S3-WROOM-1-N16R8 | U1 | 1 | C2913202
SHT40-AD1B-R3 | U2, U9 | 2 | C2848306
ICS-41350 | U3 | 1 | C3171856
SHT40-CD1B-R3 | U4 | 1 | C7461852
DRV5032FBDBZR | U5 | 1 | C2655033
XC6206P282MR-G | U6 | 1 | C347374
SY8088AAC | U7 | 1 | C79313
XC6206P152MR-G | U8 | 1 | C424701
