medicalopenworld/IncuNest/(list of files, cad)

Other CAD files:
Hardware/Electronics/FullLEDStrip/Project Outputs for IncuNest_Phototherapy/V4/ExportSTEP/IncuNest_Phototherapy.step
Hardware/Electronics/SensorBoard/Step/IncuNest.step
