medicalopenworld/IncuNest/Firmware/openspec/changes/shared-cascade-ota-distribution/README.md

# shared-cascade-ota-distribution

MB as the only ThingsBoard device, distributing firmware to Display_HMI (UART) and SensorBoard (USB CDC)
