medicalopenworld/IncuNest/Firmware/SensorBoard_v2/openspec/changes/sb-ota-receiver/README.md

# sb-ota-receiver

OTA receiver over USB CDC: write the motherBoard-pushed image to the inactive slot with rollback
