medicalopenworld/IncuNest/Firmware/SensorBoard_v2/CHANGELOG.md

# Changelog

Todos los cambios notables de este proyecto se documentan en este archivo.

El formato sigue [Keep a Changelog](https://keepachangelog.com/es-ES/1.1.0/) y este proyecto usa [Semantic Versioning](https://semver.org/lang/es/). La versión de referencia es `SB_PROTO_FW_VERSION` (definida en `sensorBoard_comm_protocol.h`), no un `package.json`.

## [Unreleased]

### Fixed

- **Tabla de particiones: OTA prometido pero imposible, y sin core dump.** `partitions.csv` (heredada del documento de fase 1) declaraba `factory` + `ota_0` + `ota_1` de 3 MB cada una **sin partición `otadata`**: sin ella `esp_ota_set_boot_partition()` no tiene dónde escribir y el bootloader arranca siempre `factory`, así que eran 6 MB reservados para una capacidad de actualización que no existía (tampoco hay ninguna llamada `esp_ota_*` en el código). Nuevo reparto sobre una app de 356 KB: `ota_0`/`ota_1` de 2 MB con su `otadata` en `0xD000`, `coredump` de 64 KB y `storage` de ~11,9 MB para los JPEG de la fase 5. `ota_0` sigue en `0x10000`, así que el flasheo de fábrica no cambia de offset — pero `flasher_tool` escribe ahora también `ota_data_initial.bin` en `0xD000`, que antes caía dentro de la NVS vieja.
- **Core dump a flash activado.** Con `CONFIG_ESP_CONSOLE_NONE=y` no hay consola y el backtrace de un panic no salía por ningún sitio. `CONFIG_ESP_COREDUMP_ENABLE_TO_FLASH=y` + `CONFIG_ESP_COREDUMP_CHECK_BOOT=y` en `sdkconfig.defaults`, y **`espcoredump` añadido explícitamente a `set(COMPONENTS ...)`**: con el build mínimo el componente quedaba fuera, y entonces sus símbolos Kconfig no existen y confgen descarta las opciones **en silencio** — compilaba, arrancaba y no volcaba nada. Se lee con `idf.py -p COMx coredump-info`. Coste: +18 KB de app.
- **Reconexión USB tras perder el host sin cortar VBUS** (`usb_comm`): el vigilante de host se disparaba solo con el DTR, que no cambia al desenchufar el cable ni al reiniciarse la motherboard (TinyUSB solo lo notifica ante `SET_CONTROL_LINE_STATE`; sin sensado de VBUS el bus solo reporta `SUSPEND`). Ahora "host presente" = `DTR && tud_ready()`, con la política en `sb_host_watch` (función pura con tests Unity `[hostwatch]`) y callbacks de suspend/resume de TinyUSB que limpian el flag de transmisión para que los frames vuelvan a la retención. Además se emite un heartbeat inmediato al volver el host, para que la motherboard levante el enlace en ~1 s y no en ≤30 s.

### Added

- **Tolerancia a la orientación del conector USB — HW_NUM 4 (`usb_comm`)**: tras ver un bus reset del host sin que llegue SETUP ni `SET_CONFIGURATION` en `CONFIG_SB_USB_AUTOSWAP_TIMEOUT_MS` (2 s, mín. 1,5 s), se intercambian D+/D- en el PHY del ESP32-S3 (`exchg_pins`) con detach/attach de 250 ms, una vez por evidencia (sin host no se alterna: la alternancia ciega enganchaba en fase con la pila host de la motherboard, banco 2026-09-03); política pura `sb_usb_orient_*` con 6 `TEST_CASE` en `comm_test`, Kconfig `SB_USB_AUTOSWAP`, log retenido por intercambio y estado `sensors.usb_swap` en `status` (ADR-0003). La V5 corrige el conector en hardware; el mecanismo queda activo e inocuo. El bootloader ROM no aplica el intercambio: flashear con el cable invertido sigue requiriendo girarlo.

### Fixed

- **Autoswap con la motherboard como host (banco 2026-09-03).** El detach del intercambio pasa a `CONFIG_SB_USB_SWAP_DETACH_MS` (1 s) y el enlace queda trazado con `USB bus reset seen` / `USB host active|inactive` (INFO, un evento por conexión). La causa raíz estaba en la motherboard: `gpio_reset_pin(19/20)` dejaba el pull-up interno en las líneas USB y el SensorBoard en modo intercambiado no se detectaba (fix en `sensorboard_comm.cpp` de la motherboard). Nueva opción `CONFIG_SB_LOG_MIRROR_CONSOLE` (por defecto off) para duplicar los logs a UART0 en banco.
- **`usb_comm`: DTR pegajoso.** Las escrituras al CDC exigen ahora DTR **y** `tud_cdc_n_connected()`: si el host desaparece sin cerrar el puerto (sin VBUS sensing), los frames vuelven a la retención de arranque en vez de perderse en un FIFO muerto.
- **Fase 5 — Cámara (`camera_sensor`)**: OV2640 (esp32-camera, QVGA JPEG) con SCCB compartiendo el bus I2C principal, comando `capture` bajo demanda (registro de comandos por componente en `usb_comm`), `sensorBoard_comm_send_binary()` real con frames `TYPE=0x01` en PSRAM y ownership en la cola TX, y `sensors.cam` en `status`.
- **Fase 3 — Micrófono (`mic_sensor`)**: ICS-41350 por I2S en modo PDM RX (16 kHz/16 bit), RMS→dB con offset de calibración Kconfig y gate de plausibilidad [0,140] dB, evento `sound_level` periódico y `sensors.mic` en `status`. El valor `dba` aún no lleva ponderación A (diferido hasta calibrar con sonómetro).
- **Fase 4 — Sensor de puerta (`door_sensor`)**: hall DRV5032FB en IO47 con ISR de solo hand-off, debounce configurable (≥ muestreo interno de 5 Hz del sensor), eventos `door_open`/`door_closed` solo en cambio estable, estado inicial publicado al arrancar y `sensors.door` en `status`.
- **Fase 2 — Sensores ambientales (`env_sensors`)**: 3× SHT40 en dos buses I2C con CRC-8 y conversión datasheet, ALS-PT19 por ADC (conversión sin calibrar, `CONFIG_SB_ALS_UV_PER_LUX`), `sensor_task` con polling configurable, evento `sensor_data` con redundancia posicional y `null` por sensor caído (ADR-0002), y campo `sensors{}` en la resp de `status` vía registro agnóstico en `usb_comm`.
- **Fase 1 — Transporte USB CDC (`usb_comm`)**: proyecto ESP-IDF v6 (ESP32-S3 N16R8, flash 16MB OTA, PSRAM OPI), framing binario `Magic+Type+Length+Payload+CRC16-CCITT`, tareas FreeRTOS RX/TX con `tx_queue`, logs `ESP_LOG` como frames JSON, comando `status`, heartbeat 30 s y test app Unity `comm_test` (ADR-0001).
- Documento de hardware `docs/hardware.md` con el pinout completo confirmado (SHT40 ×3, ALS-PT19 analógico, mic PDM ICS-41350, hall DRV5032, OV2640).
- Framework de agentes Genesis adaptado a ESP-IDF v6/C/FreeRTOS (agentes, rules, hooks, skills y documentación mínima: `ESTADO.md`, `docs/adr/`, `docs/retro/`, `docs/epics/`, `docs/architecture.md`, `docs/blueprint/`).

<!--
Plantilla de entrada al cortar una release (mover [Unreleased] a una sección versionada):

## [X.Y.Z] - AAAA-MM-DD

### Added
### Changed
### Fixed
### Removed
-->
