medicalopenworld/IncuNest/(list of files, drawings)

Other design files:
Hardware/Electronics/FullLEDStrip/IncuNest_Phototherapy.PcbDoc
Hardware/Electronics/FullLEDStrip/IncuNest_Phototherapy.PcbLib
Hardware/Electronics/FullLEDStrip/IncuNest_Phototherapy.PrjPcb
Hardware/Electronics/FullLEDStrip/IncuNest_Phototherapy.SchDoc
Hardware/Electronics/FullLEDStrip/IncuNest_Phototherapy.SchLib
Hardware/Electronics/Motherboard/IncuNest.PrjPcb
Hardware/Electronics/Motherboard/PCB/Motherboard.PcbDoc
Hardware/Electronics/Motherboard/Schematic/Actuators.SchDoc
Hardware/Electronics/Motherboard/Schematic/AFE.SchDoc
Hardware/Electronics/Motherboard/Schematic/Buzzer.SchDoc
Hardware/Electronics/Motherboard/Schematic/Display.SchDoc
Hardware/Electronics/Motherboard/Schematic/GSM.SchDoc
Hardware/Electronics/Motherboard/Schematic/Main.SchDoc
Hardware/Electronics/Motherboard/Schematic/PowerInput.SchDoc
Hardware/Electronics/Motherboard/Schematic/PowerManagement.SchDoc
Hardware/Electronics/Motherboard/Schematic/Sensors.SchDoc
Hardware/Electronics/Motherboard/Schematic/uC.SchDoc
Hardware/Electronics/old/Ambient_sensor/Camera.SchDoc
Hardware/Electronics/old/Ambient_sensor/Main.SchDoc
Hardware/Electronics/old/Ambient_sensor/Power_Input.SchDoc
Hardware/Electronics/old/Ambient_sensor/SensorBoard.PcbDoc
Hardware/Electronics/old/Ambient_sensor/SensorBoard.PrjPcb
Hardware/Electronics/old/Ambient_sensor/Sensors.SchDoc
Hardware/Electronics/old/Ambient_sensor/uC.SchDoc
Hardware/Electronics/SensorBoard/PCB/SensorBoard.PcbDoc
Hardware/Electronics/SensorBoard/Schematic/Main.SchDoc
Hardware/Electronics/SensorBoard/Schematic/PowerManagement.SchDoc
Hardware/Electronics/SensorBoard/Schematic/Sensors.SchDoc
Hardware/Electronics/SensorBoard/Schematic/uC.SchDoc
Hardware/Electronics/SensorBoard/SensorBoard.PcbDoc
Hardware/Electronics/SensorBoard/SensorBoard.PrjPcb
