medicalopenworld/IncuNest/Firmware/motherBoard/include/config/board.h

#ifndef HW_NUM
#error "HW_NUM must be defined via build_flags in platformio.ini (-DHW_NUM=16, -DHW_NUM=17 or -DHW_NUM=18)"
#endif
#define IS_HMI false
#define GPIO_EXP_BASE 100 // To differentiate with ESP32 GPIO
#define PWR_EN 2
#define ON_OFF_SWITCH 4
#define BUZZER 1
#define GSM_UART_TX_PIN 9
#define GSM_UART_RX_PIN 10
#define UART_MB_TX_PIN 15
#define UART_MB_RX_PIN 16
#define ACTUATORS_EN 14
#define HEATER 45
#define FAN 12
#define PHOTOTHERAPY 13
#define FAN_CTL 11
#define FAN_SPEED_FEEDBACK 38
#define USB_EN 5
#define USB_FAULT 6
#define BABY_NTC_PIN 8
#define BABY_TEMP_EN 18
#define ADS1110_I2C_ADDRESS 0x48 // I2C ADC for baby NTC
#define USB_D_MINUS 19
#define USB_D_PLUS 20
#define I2C2_SCL 19 // repurposed from USB_D_PLUS
#define I2C2_SDA 20 // repurposed from USB_D_MINUS
#define I2C_SDA 47
#define I2C_SCL 48
#define AFE_MISO 37
#define AFE_MOSI 35
#define AFE_SCK 36
#define AFE_ADC_READY 17
#define AFE44XX_CS 21
#define FAKE_PIN 46
#define SCREENBACKLIGHT FAKE_PIN
#define AFE44XX_PWDN_PIN FAKE_PIN
#define GPRS_PWRKEY FAKE_PIN
#undef TFT_DC
#define TFT_DC FAKE_PIN
#define ENC_SWITCH FAKE_PIN
#define ENC_A FAKE_PIN
#define ENC_B FAKE_PIN
#undef TFT_CS
#define TFT_CS FAKE_PIN
#if ARDUINO_USB_MODE == 1
#define debugSerial Serial
#else
#define debugSerial Serial
#endif
#define SKIN_SENSOR 0
#define ROOM_DIGITAL_TEMP_SENSOR 1
#define AMBIENT_DIGITAL_TEMP_SENSOR 2
#define SENSOR_TEMP_QTY 3 // number of total temperature sensors in system
#define ROOM_DIGITAL_HUM_SENSOR 0
#define AMBIENT_DIGITAL_HUM_SENSOR 1
#define SENSOR_HUM_QTY 2 // number of total humidity sensors in system
#define SYSTEM_SHUNT_CHANNEL INA3221_CH1
#define PHOTOTHERAPY_SHUNT_CHANNEL INA3221_CH2
#define FAN_SHUNT_CHANNEL INA3221_CH3
#define HEATER_SHUNT_CHANNEL INA3221_CH1
#define DISPLAY_SHUNT_CHANNEL INA3221_CH2
#define USB_SHUNT_CHANNEL INA3221_CH2
#define BATTERY_SHUNT_CHANNEL INA3221_CH3
#if (HW_NUM >= 17)
#define HUMIDIFIER_SHUNT 100 // miliohms
#else
#define HUMIDIFIER_SHUNT 1   // flag (boolean legacy, not used as resistance)
#endif
#define SKIN_NTC_PULSED_EXCITATION false
#if (HW_NUM == 17)
#define HEATER_CURRENT_CORRECTION_FACTOR 5.80f
#define SYSTEM_SHUNT 1000        // miliohms (VSYS_SHUNT+ is not connected properly, is connected before O-ring)
#define HEATER_SHUNT 5        // miliohms
#define FAN_SHUNT 100         // miliohms
#define PHOTOTHERAPY_SHUNT 5   // miliohms
#define USB_SHUNT 100         // miliohms (humidifier via USB_EN channel)
#define BATTERY_SHUNT 27000   // miliohms
#elif (HW_NUM == 18)
#define SYSTEM_SHUNT 5        // miliohms
#define HEATER_SHUNT 2        // miliohms
#define FAN_SHUNT 100         // miliohms
#define PHOTOTHERAPY_SHUNT 5   // miliohms
#define USB_SHUNT 100         // miliohms (humidifier via USB_EN channel)
#define BATTERY_SHUNT 27000   // miliohms
#elif (HW_NUM >= 16)
#define SYSTEM_SHUNT 3        // miliohms
#define FAN_SHUNT 3           // miliohms
#define PHOTOTHERAPY_SHUNT 15 // miliohms
#define BATTERY_SHUNT 27000   // miliohms
#define USB_SHUNT 3           // miliohms
#define HEATER_SHUNT 3        // miliohms
#endif
#define DISPLAY_DEFAULT_ROTATION 3
#define SCREENBACKLIGHT_PWM_CHANNEL 0
#define BUZZER_PWM_CHANNEL 1
#define HEATER_PWM_CHANNEL 2
#define FAN_PWM_CHANNEL 7
#define PHOTOTHERAPY_PWM_CHANNEL 4
#define HUMIDIFIER_PWM_CHANNEL 5
#define FAN_CTL_PWM_CHANNEL 6
#define DEFAULT_PWM_RESOLUTION 8
#define DEFAULT_PWM_FREQUENCY 400
#define BUZZER_PWM_FREQUENCY 400
#define PHOTOTHERAPY_PWM_FREQUENCY 10000
#define HEATER_PWM_FREQUENCY DEFAULT_PWM_FREQUENCY
#define FAN_PWM_FREQUENCY DEFAULT_PWM_FREQUENCY
#define HUMIDIFIER_PWM_FREQUENCY 109000
#define maxADCvalue 4095
#define PWM_MAX_VALUE (pow(2, DEFAULT_PWM_RESOLUTION) - 1)
#define FAN_PWR_SUPPLY_PWM PWM_MAX_VALUE
#define FAN_CTL_PWM_DEFAULT 130
#define FAN_MIN_RPM 3000            // minimum acceptable fan RPM when speed feedback is present
#define FAN_MIN_RPM_HYSTERESIS 300  // rpm above FAN_MIN_RPM required to clear ALARM_FAN_FAILURE
#define FAN_TARGET_RPM 4000
#define FAN_PID_ENABLED_DEFAULT true
#define FAN_SPINUP_GRACE_MS 6000
#define FAN_DUTY_BLOCKED_THRESHOLD 220
#define FAN_DUTY_BLOCKED_HYSTERESIS 20 // duty below (threshold - this) required to clear ALARM_AIR_OUTLET_BLOCKED
#define FAN_DUTY_NORMAL_MAX_OBSERVED 188
#define AIR_BLOCKED_DETECTION_ENABLED true
#define AIR_BLOCKED_SUSTAIN_MS 5000
#if (ADC_READ_FUNCTION == MILLIVOTSREAD_ADC)
#define ADC_TO_DISCARD_MIN 500  // in mV
#define ADC_TO_DISCARD_MAX 2500 // in mV
#else
#define ADC_TO_DISCARD_MIN maxADCvalue / 5     // in ADC points
#define ADC_TO_DISCARD_MAX maxADCvalue * 4 / 5 // in ADC points
#endif
#define DIG_TEMP_TO_DISCARD_MAX 60
#define DIG_TEMP_TO_DISCARD_MIN 5
#define HEATER_CURRENT_LIMIT_ENABLED true
#if (HW_NUM == 18)
#define HEATER_POWER_REFERENCE_IS_SYSTEM_CURRENT true
#else
#define HEATER_POWER_REFERENCE_IS_SYSTEM_CURRENT false
#endif
#define HEATER_MAX_PWM PWM_MAX_VALUE
#define HEATER_HALF_PWR PWM_MAX_VALUE / 2
#define HEATER_START_PWM 1
#define BUZZER_MAX_PWM PWM_MAX_VALUE
#define BUZZER_HALF_PWM PWM_MAX_VALUE / 2
#define MIN_SYSTEM_VOLTAGE_TRIGGER 0
#define MAX_SYSTEM_VOLTAGE_TRIGGER 8
#define SCREEN_BRIGHTNESS_FACTOR                                               \
  0.7 // Max brightness will be multiplied by this constant
#define BACKLIGHT_POWER_DEFAULT PWM_MAX_VALUE *SCREEN_BRIGHTNESS_FACTOR
