medicalopenworld/IncuNest/Firmware/motherBoard/src/main.cpp

/*
  MIT License

  Copyright (c) 2022 Medical Open World, Pablo Sánchez Bergasa

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
*/

// pio run -e IncuNest_V15 -t upload ; pio device monitor

// Firmware version and head title of UI screen

#include "main.h"
#include "modules/util/system_clock.h"
#include "state/state.h"
#include "modules/debug/debug_mode.h"
#include "modules/control/photo_override.h"
#include "modules/sensorboard_comm/sensorboard_comm.h"
#include "modules/sensors/sensor_source.h"
#include "system/hw_selftest.h"
#include "DriveUpload.h"
#include "CrashReporter.h"
#include <Preferences.h>

static Preferences diag_prefs;
uint32_t g_bootCount = 0;
uint32_t g_gprsKillCount = 0;
uint32_t g_monKillCount = 0;
int g_hmiBootCount = 0;
int g_hmiLastRst = 0;
int g_restore_photo_minutes = 0;

// Build-flag crash simulator. Se enciende con la variable de entorno
// INCUNEST_CRASH_TEST (ver main/CMakeLists.txt); la instruccion anterior decia
// platformio.ini, que el porte a ESP-IDF dejo sin efecto. Dispara un panic
// pasados CRASH_TEST_MB_DELAY_S segundos (130 por defecto).
// La alternativa en caliente y sin recompilar es POST /debug/crash.
// Nunca en un binario de produccion.
//   CRASH_TEST_MB=1  → abort() (panic, RST_reason=12)
//   CRASH_TEST_MB=2  → null-pointer LoadProhibited
#ifdef CRASH_TEST_MB
#ifndef CRASH_TEST_MB_DELAY_S
#define CRASH_TEST_MB_DELAY_S 130
#endif
static void CrashTestMBTask(void *pv) {
  for (int i = CRASH_TEST_MB_DELAY_S; i > 0; i--) {
    ESP_LOGW("CRASH_TEST_MB", "MB crash firing in %d s", i);
    vTaskDelay(pdMS_TO_TICKS(1000));
  }
  ESP_LOGE("CRASH_TEST_MB", "Crashing now (CRASH_TEST_MB=%d)", CRASH_TEST_MB);
  vTaskDelay(pdMS_TO_TICKS(50));
#if CRASH_TEST_MB == 2
  { volatile int *p = (int *)0; *p = 0xDEAD; }
#else
  abort();
#endif
  vTaskDelete(NULL);
}
#endif

#if !CONFIG_IDF_TARGET_ESP32S3
TelemetryMessage ctrl_tel_msg = {0, 0, 0, 0};
HMI_CommandMessage hmi_cmd_msg = {0, 0, 0, 0, 0, 0, 0, false};
#endif
char pendingSSID[64] = "";
char pendingPass[64] = "";
char wifi_ssid[64] = "";
char wifi_pass[64] = "";

#include <Arduino.h>
#include <stdarg.h>
#include <stdio.h>

TwoWire *wire;
TwoWire *wire2 = nullptr; // second I2C bus (HW16: SHTC3 + STS35 on pins 19/20)
MAM_IncuNest_Humidifier in3_hum(DEFAULT_ADDRESS);
TFT_eSPI tft = TFT_eSPI(); // Invoke custom library
SHTC3 mySHTC3;             // Declare an instance of the SHTC3 class
SensirionI2cSts3x mySTS35[STS3X_NUM];
Adafruit_SHT4x sht4 = Adafruit_SHT4x();
Beastdevices_INA3221 mainDigitalCurrentSensor(INA3221_ADDR41_VCC);
Beastdevices_INA3221 secundaryDigitalCurrentSensor(INA3221_ADDR40_GND);
// BQ25730 gestionado por BQ25730.cpp (chargerPresent definido allí)

// Encoder rotativo. En la linea del port a ESP-IDF se retiro (e2e3ede), y al
// portar el modo depuracion (17312e3) el rebase arrastro la retirada de estos
// globales como un hunk limpio, dejando colgados los `extern` de ISR.cpp y
// security.cpp. En esta linea el encoder sigue en el arbol, asi que los
// globales vuelven aqui tal cual estaban.
RotaryEncoder encoder(ENC_A, ENC_B, RotaryEncoder::LatchMode::TWO03);
boolean A_set;
boolean B_set;
int encoderpinA = ENC_A;         // pin  encoder A
int encoderpinB = ENC_B;         // pin  encoder B
bool encPulsed, encPulsedBefore; // encoder switch status
bool updateUIData;
volatile int EncMove;                 // moved encoder
volatile int lastEncMove;             // moved last encoder
volatile int EncMoveOrientation = -1; // set to -1 to increase values clockwise
volatile int last_encoder_move;       // moved encoder
long encoder_debounce_time =
    true; // in milliseconds, debounce time in encoder to filter signal bounces
long last_encPulsed; // last time encoder was pulsed

bool WIFI_EN = true;
long lastDebugUpdate;
long loopCounts;
int page;

double errorTemperature[SENSOR_TEMP_QTY], temperatureCalibrationPoint;
double ReferenceTemperatureRange, ReferenceTemperatureLow;
double provisionalReferenceTemperatureLow;
float diffSkinTemperature,
    diffAirTemperature; // difference between measured temperature and user
                        // input real temperature
double RawTemperatureLow[SENSOR_TEMP_QTY], RawTemperatureRange[SENSOR_TEMP_QTY];
double provisionalRawTemperatureLow[SENSOR_TEMP_QTY];
double temperatureMax[SENSOR_TEMP_QTY], temperatureMin[SENSOR_TEMP_QTY];
int temperature_array_pos; // temperature sensor number turn to measure
bool humidifierState, humidifierStateChange;
int previousHumidity; // previous sampled humidity
float diffHumidity; // difference between measured humidity and user input real
                    // humidity

byte autoCalibrationProcess;

// Sensor check rate (in ms). Both sensors are checked in same interrupt and
// they have different check rates
byte encoderRate = true;
byte encoderCount = false;

volatile long lastEncPulse;
volatile bool statusEncSwitch;

bool roomSensorPresent[ROOM_SENSOR_POSIBILITIES];
bool ambientSensorPresent = false;
bool digitalCurrentSensorPresent[2];

// room variables

float minDesiredTemp[2] = {
    SKIN_TEMPERATURE_SET_MIN,
    AIR_TEMPERATURE_SET_MIN}; // minimum allowed temperature to be set
float maxDesiredTemp[2] = {
    SKIN_TEMPERATURE_SET_MAX,
    AIR_TEMPERATURE_SET_MAX}; // maximum allowed temperature to be set
int presetTemp[2] = {36, 32}; // preset baby skin temperature

// Text Graphic position variables
int humidityX;
int humidityY;
int temperatureX;
int temperatureY;
int separatorTopYPos, separatorMidYPos, separatorBotYPos;

bool enableSet;
float temperaturePercentage, temperatureAtStart;
float humidityPercentage, humidityAtStart;
int barWidth, barHeight, tempBarPosX, tempBarPosY, humBarPosX, humBarPosY;
int screenTextColor, screenTextBackgroundColour;

// User Interface display variables
bool selected;
char cstring[128];
char *textToWrite;
char *words[12];
char *helpMessage;
byte bar_pos = true;
byte menu_rows;
byte length;
long lastGraphicSensorsUpdate;
long lastSensorsUpdate;
bool enableSetProcess;
long blinking;
bool state_blink;
bool blinkSetMessageState;
long lastBlinkSetMessage;

long lastSuccesfullSensorUpdate[SENSOR_TEMP_QTY];
uint32_t g_sensorsTaskStartedMs = 0;

long lastSkinAttachedSensorUpdate;
long lastRoomSensorUpdate, lastCurrentSensorUpdate;
bool roomSensorOk = false;

IncuNest_parameters in3;

TaskHandle_t taskHandle =
    NULL; // Handle for the task we want to delete if it hangs
long GPRS_lastMillisTaskClear;
bool TB_connected;

void GPRS_Task(void *pvParameters); // forward decl: GPRSMonitorTask restarts it on hang

QueueHandle_t sharedSensorQueue;
// Mutex for protecting the shared variable
SemaphoreHandle_t GPRS_monitor_mutex;
SemaphoreHandle_t log_mutex = NULL;

void GPRSMonitorTask(void *pvParameters) {
  for (;;) {
    if (xSemaphoreTake(GPRS_monitor_mutex, portMAX_DELAY)) // Lock the mutex
    {
      if (millis() - GPRS_lastMillisTaskClear > GPRS_MONITOR_TASK_DELETE) {
        g_monKillCount++;
        diag_prefs.begin("diag", false);
        diag_prefs.putUInt("mon_kill", g_monKillCount);
        diag_prefs.end();
        {
          const char *m = "[MON] GPRS_Task hung, restarting it\n";
          crashReporterPut(m, strlen(m));
        }
        vTaskDelete(taskHandle); // Delete the hung task
        GPRS = GPRSstruct();     // drop state left over from the aborted attempt
        GPRS_lastMillisTaskClear = millis();
        // Recreate GPRS_Task so a single hung AT call doesn't kill cellular
        // connectivity for good; the new task spawns its own fresh monitor.
        xTaskCreatePinnedToCore(GPRS_Task, "GPRS", 16384, NULL,
                                GPRS_TAST_PRIORITY, &taskHandle,
                                CORE_ID_FREERTOS);
        xSemaphoreGive(GPRS_monitor_mutex);
        vTaskDelete(NULL); // this monitor's job is done
      }
      if (GPRSIsConnectedToServer() || WIFIIsConnectedToServer()) {
        vTaskDelete(NULL); // Delete the monitor task
      }
      // Unlock the mutex
      xSemaphoreGive(GPRS_monitor_mutex);
    }
    vTaskDelay(pdMS_TO_TICKS(GPRS_MONITOR_TASK_PERIOD));
  }
}

void GPRS_Task(void *pvParameters) {
  xTaskCreatePinnedToCore(GPRSMonitorTask, (const char *)"GPRS_MONITOR", 4096,
                          NULL, GPRS_MONITOR_TASK_PRIORITY, NULL,
                          CORE_MONITOR_FREERTOS);
  initGPRS();
  GPRS_TB_Init();
  for (;;) {
    GPRS_Handler();
    // Modify the shared variable
    GPRS_lastMillisTaskClear = millis();
    // Unlock the mutex
    xSemaphoreGive(GPRS_monitor_mutex);
    vTaskDelay(pdMS_TO_TICKS(GPRS_TASK_PERIOD_MS));
  }
}

BQ25730_Status g_bq_status      = {};
bool           g_bq_status_valid = false;
// millis() del ultimo refresco con exito: el test de fabrica exige frescura
// ademas del flag, porque un `true` sin sello sobreviviria a una tarea parada.
uint32_t       g_bq_status_ms    = 0;
void sensors_Task(void *pvParameters) {
  // Instante en que empieza a haber muestras periodicas de verdad. Lo usa
  // checkStatusOfSensor() (security.cpp) como referencia de frescura: el sello
  // que deja el autotest de initHardware() es varios segundos anterior y
  // levantaba ALARM_AIR_SENSOR_FAULT en cada arranque.
  g_sensorsTaskStartedMs = millis();
  if (g_sensorsTaskStartedMs == 0) {
    g_sensorsTaskStartedMs = 1; // 0 es el centinela de "aun no arranco"
  }
  for (;;) {
    fanSpeedHandler();
    if (millis() - lastSkinAttachedSensorUpdate >
        SKIN_SENSOR_UPDATE_PERIOD_MS) {
      measureSkinSensor();
      lastSkinAttachedSensorUpdate = millis();
    }
    {
      long roomPeriod = roomSensorOk ? ROOM_SENSOR_UPDATE_PERIOD_MS
                                     : ROOM_SENSOR_RECONNECT_MS;
      if (millis() - lastRoomSensorUpdate > roomPeriod) {
        roomSensorOk = updateRoomSensor();
        updateAmbientSensor();
        lastRoomSensorUpdate = millis();
      }
    }
    if (millis() - lastCurrentSensorUpdate > DIGITAL_CURRENT_SENSOR_PERIOD_MS) {
      powerMonitor();
      lastCurrentSensorUpdate = millis();
    }
    {
      static long lastChargerUpdate = 0;
      static bool prev_ac_present   = false;
      static bool charger_in_float  = false;
      static long ichg_low_since    = 0;
      if (chargerPresent && millis() - lastChargerUpdate > 5000) {
        g_bq_status_valid = charge_status(&g_bq_status);
        if (g_bq_status_valid) g_bq_status_ms = millis();
        lastChargerUpdate = millis();
        // Detecta transición ausente→presente del adaptador y reinicializa el
        // chip: algunos BQ25xxx pierden VINDPM/IIN al re-detectar VBUS, así que
        // reaplicamos toda la config para asegurar carga estable.
        // Al reconectar siempre se vuelve a absorción: la batería pudo haberse
        // descargado parcialmente durante el corte.
        if (g_bq_status_valid && g_bq_status.ac_present && !prev_ac_present) {
          if (LOG_CHARGER) logCharger("[CHG] Adaptador detectado → reinicializando config");
          extern TwoWire *wire;
          init_BQ25730(wire);  // restaura MaxChargeVoltage = 14.4V (absorción)
          charger_in_float = false;
          ichg_low_since   = 0;
        }
        if (g_bq_status_valid) prev_ac_present = g_bq_status.ac_present;

        // ── Transición Absorción → Flotación ─────────────────────────────────
        // Cuando ICHG cae por debajo del umbral de corte durante 60 s seguidos,
        // se cambia la tensión objetivo a flotación para mantener la batería sin
        // seguir gasificándola. El umbral (320 mA ≈ C/22 para 7 Ah) equivale a
        // 2–3 counts ADC; la ventana de 60 s evita falsos disparos por ruido.
        if (g_bq_status_valid && g_bq_status.ac_present && !charger_in_float) {
          if (g_bq_status.ichg_ma < BQ25730_ICHG_TERM_MA) {
            if (ichg_low_since == 0) {
              ichg_low_since = millis();
            } else if (millis() - ichg_low_since >= 60000UL) {
              set_charge_voltage(BQ25730_VCHARGE_FLOAT_MV);
              charger_in_float = true;
              ichg_low_since   = 0;
              if (LOG_CHARGER)
                logCharger("[CHG] Absorcion completa → Flotacion " +
                           String(BQ25730_VCHARGE_FLOAT_MV) + " mV");
            }
          } else {
            ichg_low_since = 0;
          }
        }
      }
    }
    // Las medidas simuladas del modo depuracion se pisan AQUI: despues de que
    // los sensores reales hayan escrito y ANTES de copiar a ctrl_tel_msg, para
    // que el control, securityCheck() y el display vean todos exactamente el
    // mismo valor. Con el modo apagado no hace nada y la medida real vuelve
    // sola en la pasada siguiente. Ver modules/debug/debug_mode.h.
    debug_sensors_apply();

    ctrl_tel_msg.detectedAirTemperature =
        in3.temperature[ROOM_DIGITAL_TEMP_SENSOR];
    ctrl_tel_msg.detectedSkinTemperature = in3.temperature[SKIN_SENSOR];
    ctrl_tel_msg.detectedHumidity = in3.humidity[ROOM_DIGITAL_HUM_SENSOR];
    vTaskDelay(pdMS_TO_TICKS(SENSORS_TASK_PERIOD_MS));
  }
}

// ---------------------------------------------------------------------------
// Consola de depuracion sobre debugSerial (el puerto por el que sale el log).
//
// NO es el enlace con el display: ese es Serial1 en los pines 15/16
// (hmiSerial en CommTask.cpp). Por debugSerial no habla nadie, asi que un
// comando aqui no compite con las tramas del protocolo ni puede corromperlas.
//
// Dos comandos, y a proposito ninguno mas:
//
//   "WIFI_EN,<0|1>"  para probar la OTA por 2G, que con la WiFi levantada no se
//                    ejercita nunca.
//   "PHOTO,<0|1>"    enciende/suelta la fototerapia para probar el lazo de
//                    intensidad sin nadie en la pantalla. PHOTO,1 exige el modo
//                    depuracion encendido; PHOTO,0 se acepta siempre, porque
//                    apagar nunca es lo peligroso. Va SOLO por aqui, sin
//                    endpoint HTTP: acciona un actuador y esta consola pide
//                    acceso fisico al USB (ver debug_mode.h).
//
// Nada de esto se guarda: cualquier reinicio vuelve a dejar la WiFi encendida
// y la fototerapia como la tenga el display. Lo demas se ignora.
// ---------------------------------------------------------------------------
// ESP_LOGx y no logI/logE: main.h compila esos dos fuera del binario
// (LOG_INFORMATION y LOG_ERRORS estan a false), asi que un acuse escrito con
// logI no se imprime nunca y la consola parece muerta aunque funcione.
static const char *DBGCON_TAG __attribute__((unused)) = "DBGCON";

static void debugConsoleHandle(const char *line) {
  if (strncmp(line, "PHOTO,", 6) == 0) {
    const char *arg = line + 6;
    // Mismo parseo estricto que WIFI_EN: un '0' o un '1' y nada mas.
    if ((arg[0] != '0' && arg[0] != '1') || arg[1] != '\0') {
      ESP_LOGW(DBGCON_TAG, "PHOTO: argumento invalido, se espera 0 o 1");
      return;
    }
    if (arg[0] == '0') {
      debug_photo_off();
      ESP_LOGW(DBGCON_TAG, "PHOTO,0: fototerapia de depuracion soltada; vuelve "
               "a mandar el display tras %u ms de gracia",
               (unsigned)PHOTO_OVERRIDE_RELEASE_GRACE_MS);
      return;
    }
    // in3.phototherapy es aqui la ultima orden REAL del display: todavia no
    // la ha podido contaminar esta prueba.
    if (!debug_photo_on(in3.phototherapy)) {
      ESP_LOGW(DBGCON_TAG, "PHOTO,1 rechazado: el modo depuracion esta apagado "
               "(POST /debug/mode?on=1)");
      return;
    }
    ESP_LOGW(DBGCON_TAG, "PHOTO,1: fototerapia de depuracion ENCENDIDA (se "
             "aplica con la siguiente trama del display)");
    return;
  }
  if (strncmp(line, "WIFI_EN,", 8) != 0) {
    ESP_LOGI(DBGCON_TAG, "comando desconocido, ignorado: %s", line);
    return;
  }
  const char *arg = line + 8;
  // Exactamente un '0' o un '1' y nada mas: sin atoi(), "WIFI_EN,0abc" no se
  // cuela como un apagado valido.
  if ((arg[0] != '0' && arg[0] != '1') || arg[1] != '\0') {
    ESP_LOGW(DBGCON_TAG, "WIFI_EN: argumento invalido, se espera 0 o 1");
    return;
  }
  wifiRequestEnable(arg[0] == '1');
}

void debugConsolePoll(void) {
  static char buf[40];
  static size_t len = 0;
  while (debugSerial.available()) {
    const char c = (char)debugSerial.read();
    if (c == '\r') continue;
    if (c != '\n') {
      // Al pasarse de largo se marca la linea y se descarta ENTERA al final,
      // en vez de procesar un trozo: media linea podria ser un comando valido
      // por accidente.
      if (len < sizeof(buf) - 1)
        buf[len++] = c;
      else
        len = sizeof(buf);
      continue;
    }
    if (len < sizeof(buf)) {
      buf[len] = '\0';
      debugConsoleHandle(buf);
    }
    len = 0;
  }
}

void OTA_WIFI_Task(void *pvParameters) {
  WIFI_TB_Init();
  for (;;) {
    debugConsolePoll();
    WifiOTAHandler();
    vTaskDelay(pdMS_TO_TICKS(OTA_TASK_PERIOD_MS));
  }
}

void buzzer_Task(void *pvParameters) {
  for (;;) {
    buzzerHandler();
    vTaskDelay(pdMS_TO_TICKS(BUZZER_TASK_PERIOD_MS));
  }
}

void security_Task(void *pvParameters) {
  for (;;) {
    if (ALARM_SYSTEM_ENABLED && in3.alarmsEnabled) {
      securityCheck();
    }
    vTaskDelay(pdMS_TO_TICKS(SECURITY_TASK_PERIOD_MS));
  }
}

void TimeTrack_Task(void *pvParameters) {
  for (;;) {
    timeTrackHandler();
    vTaskDelay(pdMS_TO_TICKS(TIME_TRACK_TASK_PERIOD_MS));
  }
}

void Communication_Receiver(void *pvParameters) {
  for (;;) {
    if (hmi_cmd_msg.newCommand) {
      hmi_cmd_msg.newCommand = false;

      String msg = "HMI CMD -> act=" + String(hmi_cmd_msg.actuation) +
                   " mode=" + String(hmi_cmd_msg.controlMode) +
                   " air=" + String(hmi_cmd_msg.desiredAirTemperature, 1) +
                   " skin=" + String(hmi_cmd_msg.desiredSkinTemperature, 1) +
                   " hum=" + String(hmi_cmd_msg.desiredHumidity, 0) +
                   " photo=" + String(hmi_cmd_msg.phototherapyMode) +
                   " mute=" + String(hmi_cmd_msg.muteAlarm) +
                   " lang=" + String(hmi_cmd_msg.language);

      logI(msg);

      // Reset the alarm stabilization window (see alarmTimerStart(),
      // security.cpp) only on the OFF->ON transition, matching what the
      // now-removed on-board UI (legacy/UI_actuatorsProgress.cpp) used to do
      // when a user confirmed activation from its menu. The HMI-driven path
      // resends this command on every command cycle even while actuation
      // stays on, so gating on the transition (rather than "actuation != 0")
      // avoids perpetually postponing the window and suppressing alarms.
      bool actuationWasOff = (in3.actuation == ACTUATION_OFF);
      in3.actuation = hmi_cmd_msg.actuation;
      { Preferences p; p.begin(NS_STATE, false); p.putUChar(KEY_ACTUATION, in3.actuation); p.end(); }
      if (actuationWasOff && in3.actuation != ACTUATION_OFF) {
        alarmTimerStart();
      }
      if (in3.controlMode != hmi_cmd_msg.controlMode) {
        in3.controlMode = hmi_cmd_msg.controlMode;
        { Preferences p; p.begin(NS_CFG, false); p.putUChar(KEY_CTRL_MODE, in3.controlMode); p.end(); }
      }

      const bool tempBlocked = ongoingCriticalWiringAlarm();

      switch (in3.actuation) {
      case ACTUATION_TEMPERATURE:
        in3.temperatureControl = !tempBlocked;
        in3.humidityControl = false;
        break;
      case ACTUATION_HUMIDITY:
        in3.temperatureControl = false;
        in3.humidityControl = true;
        break;
      case ACTUATION_TEMP_AND_HUMIDITY:
        in3.temperatureControl = !tempBlocked;
        in3.humidityControl = true;
        break;
      default:
        in3.temperatureControl = false;
        in3.humidityControl = false;
        break;
      }

      if (in3.temperatureControl) {
        double newDesiredTemp = in3.controlMode ? hmi_cmd_msg.desiredAirTemperature
                                                 : hmi_cmd_msg.desiredSkinTemperature;
        if (newDesiredTemp != in3.desiredControlTemperature) {
          in3.desiredControlTemperature = newDesiredTemp;
          // Persisted so a restoreState boot (crash/WDT) restarts the PID at
          // the setpoint the user actually configured, not the compiled-in
          // default (KEY_CTRL_TEMP's fallback in recapVariables()).
          Preferences p;
          p.begin(NS_CFG, false);
          p.putFloat(KEY_CTRL_TEMP, in3.desiredControlTemperature);
          p.end();
        }
        startPID(in3.controlMode);
      } else {
        stopPID(CONTROL_AIR);
        stopPID(!CONTROL_AIR);
        // El test de fabrica tiene el canal del calefactor en estado seguro
        // (design.md D4, shared-factory-test): no pisarlo con este keepalive
        // del HMI, que se repite en cada trama aunque actuation ya este OFF.
        if (!g_factoryTestActive)
          ledcWrite(HEATER_PWM_CHANNEL, false);
      }
      if (in3.humidityControl) {
        if (hmi_cmd_msg.desiredHumidity != in3.desiredControlHumidity) {
          in3.desiredControlHumidity = hmi_cmd_msg.desiredHumidity;
          // Same rationale as KEY_CTRL_TEMP above, for humidity restoreState boots.
          Preferences p;
          p.begin(NS_CFG, false);
          p.putUChar(KEY_CTRL_HUM, in3.desiredControlHumidity);
          p.end();
        }
        startPID(humidityPID);
      } else {
        stopPID(humidityPID);
        // Idem HEATER_PWM_CHANNEL arriba: el humidificador tambien es parte
        // del estado seguro del test de fabrica (design.md D4).
        if (!g_factoryTestActive)
          in3_hum.turn(OFF);
      }

      // Estado ANTERIOR, para distinguir el flanco de encendido del keepalive.
      const bool photoEstabaEncendida = in3.phototherapy;
      // Normalmente es lo que manda el display. Con un encendido de depuracion
      // en marcha (o en su ventana de gracia) manda photo_override: fuerza ON
      // durante la prueba e ignora despues el ON rancio que el display habra
      // adoptado. Ver modules/control/photo_override.h.
      in3.phototherapy = debug_photo_effective(hmi_cmd_msg.phototherapyMode);
      // Se guarda la orden DEL DISPLAY, y solo cuando no hay prueba en curso:
      // durante ella el display devuelve el ON adoptado, y guardarlo haria que
      // una caida reanudase una sesion de depuracion como si fuera real.
      if (debug_photo_may_persist()) {
        Preferences p;
        p.begin(NS_STATE, false);
        p.putUChar(KEY_PHOTO_ACTIVE, hmi_cmd_msg.phototherapyMode);
        p.end();
      }
      if (in3.language != hmi_cmd_msg.language) {
        in3.language = hmi_cmd_msg.language;
        resendActiveAlarms();
      }
      if (in3.phototherapy) {
        if (in3.photoFirstRun) {
          in3.phototherapy_intensity = PWM_MAX_VALUE * PHOTOTHERAPY_INITIAL_PWM_PCT / 100;
          in3.photoFirstRun = false;
        }
        // SOLO en el flanco de encendido. Esto estaba fuera del if y se
        // ejecutaba en cada mandato del HMI, que es un KEEPALIVE: CommTask.cpp
        // pone newCommand=true en cada trama recibida, ~1 por segundo.
        //
        // photoTurnOnTime es la marca de asentamiento que mira el lazo de
        // regulacion de intensidad (sensors_module.cpp, currentMonitor):
        //
        //     millis() - in3.photoTurnOnTime > PHOTO_SETTLE_MS   // 3000 ms
        //
        // Refrescandola cada segundo esa condicion NO se cumple NUNCA, asi que
        // el lazo no llegaba a ejecutarse jamas y PHOTO_TARGET_CURRENT era
        // codigo muerto: la lampara se quedaba en la semilla en lazo abierto.
        //
        // Medido en banco el 2026-09-23: semilla PWM 102 (extrapolada por el
        // autotest para 0.27 A desde una lectura de 0.10 A al 10 % de PWM) y
        // corriente real 0.59-0.60 A sostenida durante 6 minutos. La
        // extrapolacion 1/x se equivoca por 2.2x porque el consumo del LED no
        // es lineal con el duty; corregir eso es justo el trabajo del lazo.
        if (!photoEstabaEncendida) {
          in3.photoTurnOnTime = millis();
        }
      }
      // Idem: el canal de fototerapia tambien lo posee el test de fabrica
      // mientras dura la bateria. La reconciliacion con in3.phototherapy
      // (actualizado arriba, sin gate: eso SI debe seguir reflejando la
      // trama) la hace este mismo newCommand en su siguiente vuelta, en
      // cuanto g_factoryTestActive baje (ver cabecera de
      // factory_test_task.cpp).
      if (!g_factoryTestActive)
        ledcWrite(PHOTOTHERAPY_PWM_CHANNEL,
                  in3.phototherapy * in3.phototherapy_intensity);
      turnFans(bool(in3.phototherapy || in3.actuation));

      // AQUI NO SE PITA AL RECIBIR UNA TRAMA DEL DISPLAY.
      //
      // Habia un shutBuzzer() + buzzerTone() en este punto: el zumbador de la
      // placa sonaba cada vez que llegaba una trama, que era el truco con el
      // que el display conseguia confirmacion sonora al tocar un boton. Ese
      // papel lo cubre ahora el zumbador del propio display, y los envios de
      // estado que solo existian para dispararlo ya se retiraron.
      //
      // Quitarlo era obligado desde el latido de 1 Hz, que lo convertia en un
      // pitido por segundo. Pero el problema de fondo es peor y llevaba aqui
      // desde antes: buzzerHandler()/buzzerTone() y buzzerAlarmUpdate()
      // escriben el MISMO canal PWM. Cada trama recibida hacia shutBuzzer(),
      // o sea ledcWrite(0), pisando la rafaga de alarma que estuviera sonando
      // y destrozando el patron de la Tabla 3.
      //
      // Y un pulso suelto del zumbador de la placa es acusticamente identico
      // a una rafaga de prioridad BAJA, que es de UN solo pulso: el
      // transductor de las alarmas no puede emitir sonidos que no sean
      // alarmas.
    }

    // Handle Phototherapy timer expiration/calculation constantly
    // This runs even if no HMI is connected, ensuring hardware turns OFF.
    getRemainingPhotoTime();

    // Unconditional: every loop inside gates itself on its own PID mode, and
    // the fan loop must run for phototherapy-only activation too (fan is
    // commanded on with in3.actuation == 0 — gating on actuation left
    // FAN_CTL_PWM_CHANNEL undriven and false-fired ALARM_FAN_FAILURE).
    PIDHandler();
    vTaskDelay(pdMS_TO_TICKS(COMMUNICATION_TASK_PERIOD_MS));
  }
}

#if (HW_NUM >= 16)
// Apagado por pulsación larga del ON_OFF_SWITCH deshabilitado hasta nuevo
// aviso: mientras sea false, el equipo solo se apaga cortando alimentación
// externa (PWR_EN se mantiene latcheado por el arranque en setup()).
constexpr bool ON_OFF_SWITCH_POWEROFF_ENABLED = false;

void PowerManagement_Task(void *pvParameters) {
  if (!ON_OFF_SWITCH_POWEROFF_ENABLED) {
    vTaskDelete(NULL);
  }

  while (GPIORead(ON_OFF_SWITCH)) {
    vTaskDelay(pdMS_TO_TICKS(10));
  }
  for (;;) {
    if (GPIORead(ON_OFF_SWITCH)) { // button pressed (active HIGH)
      unsigned long pressStart = millis();
      unsigned long lastSend = 0;
      char msg[32];

      // Send initial PWR_OFF message with full hold time
      snprintf(msg, sizeof(msg), "CTRL,PWR_OFF,%d\n", PWR_HOLD_MS);
      CommunicationHost_Send(msg);
      lastSend = millis();

      while (GPIORead(ON_OFF_SWITCH)) {
        unsigned long elapsed = millis() - pressStart;
        if (elapsed >= (unsigned long)PWR_HOLD_MS) {
          CommunicationHost_Send("CTRL,PWR_OFF,0\n");
          logI("[PWR] Long press detected, powering off");
          vTaskDelay(pdMS_TO_TICKS(50)); // allow UART to flush
          digitalWrite(PWR_EN, LOW);
          while (true) {
            vTaskDelay(pdMS_TO_TICKS(100));
          }
        }
        // Send remaining time every PWR_OFF_UPDATE_INTERVAL_MS
        if (millis() - lastSend >= PWR_OFF_UPDATE_INTERVAL_MS) {
          int remaining = PWR_HOLD_MS - (int)elapsed;
          if (remaining < 0)
            remaining = 0;
          snprintf(msg, sizeof(msg), "CTRL,PWR_OFF,%d\n", remaining);
          CommunicationHost_Send(msg);
          lastSend = millis();
        }
        vTaskDelay(pdMS_TO_TICKS(10));
      }
      // Button released before timeout — cancel
      CommunicationHost_Send("CTRL,PWR_OFF_CANCEL\n");
    }
    vTaskDelay(pdMS_TO_TICKS(POWER_MANAGEMENT_TASK_PERIOD_MS));
  }
}
#endif

extern "C" int sync_vprintf(const char *fmt, va_list args) {
  // Tee formatted output into the crash-report ring so that, after a panic,
  // the last few KB of ESP_LOG context survive in RTC memory.
  char ring_buf[256];
  va_list args_copy;
  va_copy(args_copy, args);
  int ring_len = vsnprintf(ring_buf, sizeof(ring_buf), fmt, args_copy);
  va_end(args_copy);
  if (ring_len > 0) {
    if (ring_len > (int)sizeof(ring_buf))
      ring_len = sizeof(ring_buf);
    crashReporterPut(ring_buf, ring_len);
  }

  if (log_mutex == NULL) {
    return vprintf(fmt, args);
  }
  if (xSemaphoreTakeRecursive(log_mutex, portMAX_DELAY) == pdTRUE) {
    int res = vprintf(fmt, args);
    xSemaphoreGiveRecursive(log_mutex);
    return res;
  }
  return vprintf(fmt, args);
}

void setup() {
  state_init();

#if (HW_NUM >= 16)
  // Power latch: a single press (button already held when boot starts) is
  // enough to keep the device ON. Latch PWR_EN immediately, then wait for
  // the button to be released so the runtime task starts from a clean state.
  {
    pinMode(PWR_EN, OUTPUT);
    digitalWrite(PWR_EN, HIGH);
  }
#endif
  esp_bt_controller_mem_release(ESP_BT_MODE_BLE);
  debugSerial.begin(115200);
  log_mutex = xSemaphoreCreateRecursiveMutex();
  crashReporterInit();
  esp_log_set_vprintf(sync_vprintf);

  // Antes de que arranque ninguna tarea que haga configTime(): con SNTP el
  // reloj lo escribe lwIP por su cuenta, y sin este callback la motherBoard no
  // se enteraria de que la hora vigente la puso NTP. Sin eso el arbitro la
  // daria por desconocida y una fuente peor podria pisarla.
  systemClockInit();

  GPRS_monitor_mutex = xSemaphoreCreateBinary();
  security_check_reboot_cause();

  diag_prefs.begin("diag", false);
  g_bootCount = diag_prefs.getUInt("boots", 0) + 1;
  diag_prefs.putUInt("boots", g_bootCount);
  diag_prefs.putInt("last_rst", (int)esp_reset_reason());
  g_gprsKillCount = diag_prefs.getUInt("gprs_kill", 0);
  g_monKillCount  = diag_prefs.getUInt("mon_kill", 0);
  diag_prefs.end();
  logI("[DIAG] bootCount=" + String(g_bootCount) +
       " lastRst="    + String((int)esp_reset_reason()) +
       " gprs_kill="  + String(g_gprsKillCount) +
       " mon_kill="   + String(g_monKillCount));

  initEEPROM();
  initGPIO();

  // Set the serial number and log it
  ctrl_tel_msg.serialNumber = in3.serialNumber;
  logI("IncuNest debug uart, version v" + String(FWversion) + "/" +
       String(HWversion) + ", SN: " + String(in3.serialNumber));

  initHardware(false);
  initDriveUpload();
  crashReporterMaybeFlush();
  // SPO2/AFE must initialize SPI (GPIO19 as MISO) before USB host starts.
  // On V15, usb_host_install() claims GPIO19 as USB D−, which conflicts with
  // AFE SPI MISO. Initializing AFE first ensures the chip is configured and
  // DRDY is active before USB takes GPIO19.
  initSPO2();

#if CONFIG_IDF_TARGET_ESP32S3
  // --- Initialize UART/USB communication between ESP32 boards ---
  logI("Initializing communication task ...");
  CommunicationHost_Init();

  // 8 KB, up from 4 KB: the baby-profile handlers added a much deeper path
  // through this task (protocol parse -> LittleFS read/write -> float
  // formatting in the NTE range builder), which 4 KB could not absorb.
  xTaskCreatePinnedToCore(Communication_Task, "COMM_TASK", 8192, NULL,
                          COMMUNICATION_TASK_PRIORITY, NULL,
                          CORE_ID_FREERTOS // o 0/1 según tu placa
  );

  xTaskCreatePinnedToCore(Communication_Receiver, "COMM_TASK_RX", 4096, NULL,
                          COMMUNICATION_RECEIVER_PRIORITY, NULL,
                          CORE_ID_FREERTOS // o 0/1 según tu placa
  );
  logI("Communication task successfully created!\n");

  // ¿De dónde vienen la temperatura y la humedad de cabina en ESTE equipo?
  // Los pines 19/20 son el bus I2C2 hacia la PCBA de sensores en los equipos
  // antiguos y el USB hacia el SensorBoard en los nuevos. El sondeo del bus ya
  // lo hizo initRoomSensor() dentro de initHardware(): si respondió alguien,
  // este equipo lleva los sensores por I2C y NO se levanta el host USB —
  // hacerlo reclamaría esos pads y dejaría al PID sin variable de control.
  //
  // Va aquí, después de initSPO2(), para no cambiar el orden de arranque que
  // ya estaba validado.
  if (roomSensorI2CDetected()) {
    sensorSourceSet(SENSOR_SOURCE_I2C);
    logI("Air sensors found on I2C2: SensorBoard USB link not started");
  } else {
    sensorSourceSet(SENSOR_SOURCE_SENSORBOARD);
    logI("No air sensor on I2C2: starting SensorBoard USB link ...");
    sensorboard_comm_init();
    xTaskCreatePinnedToCore(sensorboard_comm_task, "SB_COMM", 4096, NULL,
                            SENSORBOARD_TASK_PRIORITY, NULL, CORE_ID_FREERTOS);
    logI("SensorBoard task successfully created!\n");
  }
#endif
  if (WIFI_EN) {
    wifiInit();
    logI("WiFi Initialization started.");
  }

#if (HW_NUM >= 16)
  logI("Creating power management task ...\n");
  while (xTaskCreatePinnedToCore(PowerManagement_Task, "PWR_MGMT", 2048, NULL,
                                 POWER_MANAGEMENT_TASK_PRIORITY, NULL,
                                 CORE_ID_FREERTOS) != pdPASS)
    ;
  logI("Power management task successfully created!\n");
#endif

  logI("Creating buzzer task ...\n");
  while (xTaskCreatePinnedToCore(buzzer_Task, "BUZZER", 4096, NULL,
                                 BUZZER_TASK_PRIORITY, NULL,
                                 CORE_ID_FREERTOS) != pdPASS)
    ;
  logI("Buzzer task successfully created!\n");

  logI("Creating sensors task ...\n");
  while (xTaskCreatePinnedToCore(sensors_Task, "SENSORS", 4096, NULL,
                                 SENSORS_TASK_PRIORITY, NULL,
                                 CORE_ID_FREERTOS) != pdPASS)
    ;
  logI("Sensors task successfully created!\n");

  logI("Creating security task ...\n");
  while (xTaskCreatePinnedToCore(security_Task, "SECURITY", 4096, NULL,
                                 SECURITY_TASK_PRIORITY, NULL,
                                 CORE_ID_FREERTOS) != pdPASS)
    ;
  logI("Security task successfully created!\n");

  logI("Creating GPRS task ...\n");
  while (xTaskCreatePinnedToCore(GPRS_Task, "GPRS", 16384, NULL,
                                 GPRS_TAST_PRIORITY, &taskHandle,
                                 CORE_ID_FREERTOS) != pdPASS)
    ;
  logI("GPRS task successfully created!\n");

  logI("Creating OTA task ...\n");
  while (xTaskCreatePinnedToCore(OTA_WIFI_Task, "OTA", 16384, NULL,
                                 OTA_TASK_PRIORITY, NULL,
                                 CORE_ID_FREERTOS) != pdPASS)
    ;
  logI("OTA task successfully created!\n");

  logI("Creating time track task ...\n");
  while (xTaskCreatePinnedToCore(TimeTrack_Task, "TimeTrack", 4096, NULL,
                                 TIME_TRACK_TASK_PRIORITY, NULL,
                                 CORE_ID_FREERTOS) != pdPASS)
    ;
  logI("Time track task successfully created!\n");

#ifdef CRASH_TEST_MB
  xTaskCreatePinnedToCore(CrashTestMBTask, "CRASH_TEST_MB", 2048, NULL, 1,
                          NULL, CORE_ID_FREERTOS);
#endif
}

void loop() {
  watchdogReload();
  updateData();
  vTaskDelay(pdMS_TO_TICKS(LOOP_TASK_PERIOD_MS));
}
