medicalopenworld/IncuNest/Firmware/motherBoard/include/main.h

#define _MAIN_H
#define TINY_GSM_MODEM_SIM800
#define modemSerial Serial2
#define THINGSBOARD_ENABLE_PSRAM 0
#define THINGSBOARD_ENABLE_DYNAMIC 1
#define THINGSBOARD_ENABLE_STREAM_UTILS 1
#include "ThingsBoard.h"
#include "config/transport_policy.h" // tabla única GPRS/WiFi
#include <Arduino.h>
#include <TinyGsmClient.h>
#include <ESPmDNS.h>
#include <Update.h>
#include <WebServer.h>
#include <WiFi.h>
#include "esp_log.h"
#include "esp_system.h"
#include "freertos/semphr.h"
#include <Beastdevices_INA3221.h>
#include <Preferences.h>
#include <Filters.h>
#include <RotaryEncoder.h>
#include <Wire.h>
#include <AH/Timing/MillisMicrosTimer.hpp>
#undef DEBUG
#include <Filters/Butterworth.hpp>
#include "Adafruit_GFX.h"
#include "Adafruit_SHT4x.h"
#include "BluetoothSerial.h"
#include "CommTask.h"
#include "control_types.h"
#include "alarm_ids.h"
#include "Credentials_public.h"
#include "ESP32_config.h"
#include "GPRS.h"
#include "PID.h"
#include "SPI.h"
#include "SPO2.h"
#include "SparkFun_SHTC3.h"
#include "TCA9555.h"
#include "Wifi_OTA.h"
#include "board.h"
#include "driver/rtc_io.h"
#include "esp32/ulp.h"
#include "esp_bt.h"
#include "esp_bt_main.h"
#include "IncuNest_humidifier.h"
#include "nvs_flash.h"
#if CONFIG_IDF_TARGET_ESP32S3
#include "usb/cdc_acm_host.h"
#include "usb/usb_host.h"
#include "usb/vcp.hpp"
#include "usb/vcp_ch34x.hpp"
#endif
#include "BQ25730.h"
#include <SensirionI2cSts3x.h>
#include <TFT_eSPI.h> // Hardware-specific library
#include <Arduino_MQTT_Client.h>
#include <Espressif_MQTT_Client.h>
#include <Espressif_Updater.h>
#define HW_REVISION 'A'
#define HWversion String(HW_NUM) + "." + String(HW_REVISION)
#define FWversion "18.48.0"
#define WIFI_NAME "IncuNest"
#define CURRENT_FIRMWARE_TITLE "IncuNest"
#define DEFAULT_WIFI_EN ON
#define LOG_MODEM_DATA true
#define LOG_INFORMATION false
#define LOG_ERRORS false
#define LOG_ALARMS true
#define LOG_PULSIOXIMETRY false
#define LOG_DRIVE false // Google Drive upload + MB/HMI crash capture
#define LOG_CHARGER false
#define DRIVE_DISABLE_UPLOAD 0
#define USE_SYSTEM_WITHOUT_ACTUATORS_TEST \
  true // only if previous test was OK and that fail cause is not being able to
#define WDT_TIMEOUT 75
#if (HW_NUM >= 14 && HW_NUM <= 16)
#define HEATER_MAX_POWER_AMPS 7.5
#else
#define HEATER_MAX_POWER_AMPS 9.5
#endif
#define HEATER_SAFE_MARGIN_AMPS 1
#define HEATER_POWER_FACTOR_INCREASE 3
#define HEATER_POWER_FACTOR_DECREASE 3
#define HEATER_RAMP_SAMPLE_CYCLES 3
#define HEATER_SENSOR_DROPOUT_ALARM_CYCLES 10
#define CURRENT_STABILIZE_THRESHOLD_RATIO 0.1
#define FAN_RPM_CONVERSION 13333333
#define FAN_UPDATE_TIME_MIN 1000
#define ALARM_SYSTEM_ENABLED true
#define FAN_MAX_CURRENT_OVERRIDE false
#define ACTUATORS_ALARM_STABILIZATION_MINS 30
#define RESTART_ALARM_GRACE_MINS 0
#define UKRAINE_MODE false
#define SENEGAL_MODE false
#define HOLD_PRESS_TO_GO_TO_SETTINGS 0
#define BROWN_OUT_BATTERY_MODE 0
#define BROWN_OUT_NORMAL_MODE 0
#define INIT_I2C_RETRIES 3
#define DEFAULT_I2C_SPEED 10000
#define INIT_CURRENT_SENSOR_RETRIES 3
#define ENABLE_WIFI_OTA true // enable wifi OTA
#define ENABLE_GPRS_OTA true // enable GPRS OTA
#define THINGSBOARD_BUFFER_SIZE 4096
#define THINGSBOARD_FIELDS_AMOUNT 112
#define MAX_MESSAGE_SIZE 1024
#define THINGSBOARD_QOS false
#define TELEMETRIES_DECIMALS 2
#define FIRMWARE_FAILURE_RETRIES 12
#define FIRMWARE_PACKET_SIZE 512
#define WAIT_FAILED_OTA_CHUNKS 10U * 1000U * 1000U
extern SemaphoreHandle_t GPRS_monitor_mutex;
extern SemaphoreHandle_t log_mutex;
#define defaultLanguage \
  ENGLISH // Preset number configuration when booting for first time
typedef enum
{
  NTC_BABY_MIN_ERROR = 0,
  NTC_BABY_MAX_ERROR,
  DIG_TEMP_ROOM_MIN_ERROR,
  DIG_TEMP_ROOM_MAX_ERROR,
  DIG_HUM_ROOM_MIN_ERROR,
  DIG_HUM_ROOM_MAX_ERROR,
  DIGITAL_SENSOR_NOTFOUND,
  HEATER_CONSUMPTION_MIN_ERROR,
  FAN_CONSUMPTION_MIN_ERROR,
  PHOTOTHERAPY_CONSUMPTION_MIN_ERROR,
  HUMIDIFIER_CONSUMPTION_MIN_ERROR,
  HEATER_CONSUMPTION_MAX_ERROR,
  FAN_CONSUMPTION_MAX_ERROR,
  PHOTOTHERAPY_CONSUMPTION_MAX_ERROR,
  HUMIDIFIER_CONSUMPTION_MAX_ERROR,
  STANDBY_CONSUMPTION_MAX_ERROR,
  DEFECTIVE_SCREEN,
  DEFECTIVE_BUZZER,
  DEFECTIVE_CURRENT_SENSOR,
  UNCALIBRATED_SENSOR,
  FAN_RPM_MIN_ERROR,
} HW_ERROR_ID;
#include "telemetry_keys.h"
extern uint32_t g_bootCount;
extern uint32_t g_sensorsTaskStartedMs;
extern uint32_t g_gprsKillCount;
extern uint32_t g_monKillCount;
extern int g_hmiBootCount;
extern int g_hmiLastRst;
extern int g_restore_photo_minutes;
#define ANALOGREAD_ADC 0
#define MILLIVOTSREAD_ADC 1
#define ADC_READ_FUNCTION MILLIVOTSREAD_ADC
#define ON true
#define OFF false
#define BASIC_CONTROL false
#define PID_CONTROL true
#define CONTROL_SKIN false
#define CONTROL_AIR true
#include "task_config.h"
#define DIGITAL_CURRENT_SENSOR_READ_PERIOD_MS 500
#define CURRENT_UPDATE_PERIOD_MS 110 // in millis
#define VOLTAGE_UPDATE_PERIOD_MS 50 // in millis
#define UI_SENSOR_UPDATE_PERIOD_MS 1000
#define POWER_SUPPLY_CHECK_PERIOD 2000 // 2 secs
#define buzzerStandbyPeriod \
  10000                              // in millis, there will be a periodic tone when regulating baby's
#define buzzerStandbyTone 500        // in micros, tone freq
#define buzzerRotaryEncoderTone 2200 // in micros, tone freq
#define buzzerStandbyToneDuration 50 // in micros, tone freq
#define buzzerSwitchDuration 10      // in micros, tone freq
#define buzzerStandbyToneTimes 1     // in micros, tone freq
#include "alarm_audio_pattern.h"
#include "alarm_policy.h"
#include "preferences_keys.h"
#define SKIN_CALIBRATION_CORRECTION_FACTOR 0
#define SWITCH_DEBOUNCE_TIME_MS 30 // encoder debouncing time
#define timePressToSettings \
  3000                        // in millis, time to press to go to settings window in UI
#define DEBUG_LOOP_PRINT 1000 // in millis,
#define DEFAULT_CONTROL_MODE CONTROL_AIR
#define setupAutoCalibrationPoint 0
#define firstAutoCalibrationPoint 1
#define secondAutoCalibrationPoint 2
#define turnedOn 0     // transmit first turned ON with hardware verification
#define room 1         // transmit room variables
#define aliveRefresh 2 // message to let know that incubator is still ON
#define defaultCurrentSamples 30
#define defaultTestingSamples 8000
#define Rsense 3000 // 3 microohm as shunt resistor
#define MAIN 0
#define SECUNDARY 1
#define MAIN_DIGITAL_CURRENT_SENSOR_I2C_ADDRESS 0x41
#define SECUNDARY_DIGITAL_CURRENT_SENSOR_I2C_ADDRESS 0x40
#define AMBIENT_SENSOR_I2C_ADDRESS 0x44
typedef enum
{
  ROOM_SENSOR_STS3X_MAIN = 0,
  ROOM_SENSOR_STS3X_REDUNDANT,
  ROOM_SENSOR_SHTC3,
  ROOM_SENSOR_POSIBILITIES,
} ROOM_SENSORS;
typedef enum
{
  STS3X_MAIN = 0,
  STS3X_REDUNDANT,
  STS3X_NUM,
} STS3X_SENSORS;
#define ROOM_SENSOR_SHTC3_I2C_ADDRESS 0x70
#define ROOM_SENSOR_STS35_I2C_ADDRESS_MAIN 0x4A
#define ROOM_SENSOR_STS35_I2C_ADDRESS_REDUNDANT 0x4B
#define HUMIDIFIER_DUTY_CYCLE_MAX \
  95 // maximum humidity cycle in heater to be set
#define HUMIDIFIER_DUTY_CYCLE_MIN \
  0 // minimum humidity cycle in heater to be set
#define stepTemperatureIncrement 0.1 // maximum allowed temperature to be set
#define stepHumidityIncrement 5      // maximum allowed temperature to be set
#define presetHumidity 60            // preset humidity
#define maxHum 90                    // maximum allowed humidity to be set
#define minHum 20                    // minimum allowed humidity to be set
#define SKIN_TEMPERATURE_SET_MIN 35
#define AIR_TEMPERATURE_SET_MIN 30
#define SKIN_TEMPERATURE_SET_MAX 37.5
#define AIR_TEMPERATURE_SET_MAX ALARM_AIR_SETPOINT_MAX_C
#define AIR_THERMAL_CUTOUT_DEFAULT_C 40
#define NUMENCODERS 1 // number of encoders in circuit
#define ENCODER_TICKS_DIV 0
#define encPulseDebounce 200
#define ERASE false
#define DRAW true
#define graphicTextOffset 1 // bar pos is counted from 1, but text from 0
#define CENTER true
#define LEFT_MARGIN false
#define TEMP_CALIB_UI_ROW 0
#define SET_CALIB_UI_ROW 1
#define AUTO_CALIB_MESSAGE_UI_ROW 0
#define INIT_I2C_DELAY 50
#define INIT_ROOM_SENSOR_STS3X_DELAY 100
#define INIT_CURRENT_SENSOR_DELAY 50
#define BACKLIGHT_DELAY 2
#define INIT_TFT_DELAY 300
#define WHILE_LOOP_DELAY 1
#define TIME_TRACK_UPDATE_PERIOD 900000 // 15 minutes
typedef struct
{
  int skinSensorCapacitance;
  double temperature[SENSOR_TEMP_QTY];
  double airTemperatureRedundantSensor = 0;
  double humidity[SENSOR_HUM_QTY];
  double desiredControlTemperature = false;
  double desiredControlHumidity = false;
  double fineTuneSkinTemperature = false;
  double fineTuneAirTemperature = false;
  double system_current_standby_test = false;
  double heater_current_test = false;
  double fan_current_test = false;
  double phototherapy_current_test = false;
  double humidifier_current_test = false;
  double display_current_test = false;
  double buzzer_current_test = false;
  bool HW_critical_error = false;
  double HW_test_error_code = false;
  double system_current = false;
  double system_voltage = false;
  double heater_current = false;
  int heaterSafeMAXPWM = HEATER_MAX_PWM;
  double fan_current = false;
  double humidifier_current = false;
  double humidifier_voltage = false;
  double phototherapy_current = false;
  double USB_current = false;
  double USB_voltage = false;
  double BATTERY_current = false;
  double BATTERY_voltage = false;
  int serialNumber = false;
  int resetReason = false;
  bool restoreState = false;
  int actuation = false;
  bool controlMode = DEFAULT_CONTROL_MODE;
  bool temperatureControl = false;
  bool humidityControl = false;
  bool phototherapy = false;
  byte phototherapy_intensity = PWM_MAX_VALUE;
  bool photoFirstRun = true;
  long photoTurnOnTime = 0;
  int fanPwrSupplyPWM = FAN_PWR_SUPPLY_PWM;
  int fanCtlPWM = FAN_CTL_PWM_DEFAULT;
  bool fanHasSpeedFeedback = false;
  bool fanPidEnabled = FAN_PID_ENABLED_DEFAULT;
  float heaterMaxPowerAmps = HEATER_MAX_POWER_AMPS;
  float skinTemperatureSetMax = SKIN_TEMPERATURE_SET_MAX;
  float airTemperatureSetMax = AIR_THERMAL_CUTOUT_DEFAULT_C;
  int actuating_gprs_period = TX_GPRS_PERIOD_ACTUATING_S;
  int phototherapy_gprs_period = TX_GPRS_PERIOD_PHOTOTHERAPY_S;
  int standby_gprs_period = TX_GPRS_PERIOD_STANDBY_S;
  bool calibrationError = false;
  long last_check_time = false;
  float standby_time = false;
  float control_active_time = false;
  float heater_active_time = false;
  float fan_active_time = false;
  float phototherapy_active_time = false;
  float humidifier_active_time = false;
  bool alarmsEnabled = true;
  bool alarmToReport[NUM_ALARMS];
  char alarmMessage[MAX_ALARM_STRING_SIZE];
  bool previousAlarmReport;
  double fan_rpm = false;
  bool fanEncoderUpdate = false;
  long fanEncoderPeriod[2] = {false, false};
  bool fanCommandedOn = false;
  byte language;
} IncuNest_parameters;
void logE_impl(const String &dataString);
void logAlarm_impl(const String &dataString);
void logI_impl(const String &dataString);
void logCharger_impl(const String &dataString);
void logModemData_impl(const String &dataString);
void logSPO2_impl(const String &dataString);
void logDrive_impl(const String &dataString);
#define logI(expr)         do { if (LOG_INFORMATION)   { logI_impl(expr); } } while (0)
#define logE(expr)         do { if (LOG_ERRORS)        { logE_impl(expr); } } while (0)
#define logAlarm(expr)     do { if (LOG_ALARMS)        { logAlarm_impl(expr); } } while (0)
#define logCharger(expr)   do { if (LOG_CHARGER)       { logCharger_impl(expr); } } while (0)
#define logModemData(expr) do { if (LOG_MODEM_DATA)    { logModemData_impl(expr); } } while (0)
#define logSPO2(expr)      do { if (LOG_PULSIOXIMETRY) { logSPO2_impl(expr); } } while (0)
#define logDrive(expr)     do { if (LOG_DRIVE)         { logDrive_impl(expr); } } while (0)
long secsToMillis(long timeInMillis);
long minsToMillis(long timeInMillis);
float millisToHours(long timeInMillis);
void initHardware(bool printOutputTest);
void updateData();
void buzzerHandler();
void buzzerTone(int beepTimes, int timevTaskDelay, int freq);
void shutBuzzer();
void buzzerAlarmUpdate(bool audioRequired, AlarmPriority priority);
double measureMeanConsumption(bool, int);
double measureStabilizedCurrent(bool sensor, int shunt, float offsetCurrent,
                                float minExpected, float maxExpected,
                                int maxTimeMs, int intervalMs = 200,
                                int window = 3);
float measureMeanVoltage(bool, int);
void WIFI_TB_Init();
void WifiOTAHandler(void);
void wifiRequestEnable(bool enable);
void securityCheck();
void turnFans(bool mode);
void setFanPidEnabled(bool enabled);
void alarmTimerStart(long graceMinutes = ACTUATORS_ALARM_STABILIZATION_MINS);
void timeTrackHandler();
bool ongoingCriticalAlarm();
bool ongoingCriticalWiringAlarm();
bool ongoingFanCriticalAlarm();
int getActiveAlarmCount();
void PIDInit();
void PIDHandler();
void startPID(byte var);
void stopPID(byte var);
bool ongoingAlarms();
byte activeAlarm();
void silenceActiveAlarmsFromDisplayMute();
char *alarmIDtoString(byte alarmID);
void resendActiveAlarms();
bool updateRoomSensor();
bool updateAmbientSensor();
void wifiInit(void);
void loaddefaultValues();
void recapVariables();
void initRoomSensor();
void initAmbientSensor();
void initSkinSensor();
void powerMonitor();
void currentMonitor();
void voltageMonitor();
extern unsigned long heaterCurrentSampleSeq;
extern unsigned long systemCurrentSampleSeq;
double roundSignificantDigits(double value, int numberOfDecimals);
void initGPIO();
void initEEPROM();
void initAlarms();
void alarmHistorySave();
void alarmHistoryLoad();
void security_check_reboot_cause();
void IRAM_ATTR encoderISR();
void IRAM_ATTR fanEncoderISR();
void fanSpeedHandler();
bool measureSkinSensor();
void pinMode(uint8_t GPIO, uint8_t Mode);
bool GPIORead(uint8_t GPIO);
void digitalWrite(uint8_t GPIO, uint8_t Mode);
void basictemperatureControl();
