medicalopenworld/IncuNest/Firmware/motherBoard/src/modules/sensors/sensors_module.cpp

#include "sensors_module.h"

#include <Arduino.h>

#include "main.h"
#include "modules/control/alarm_machine.h"
#include "modules/sensorboard_comm/sensorboard_comm.h"
#include "sensor_source.h"
#include "system/hw_selftest.h"

extern TwoWire *wire;
extern SHTC3 mySHTC3; // Declare an instance of the SHTC3 class
extern SensirionI2cSts3x mySTS35[STS3X_NUM];
extern Adafruit_SHT4x sht4;
extern Beastdevices_INA3221 mainDigitalCurrentSensor;
extern Beastdevices_INA3221 secundaryDigitalCurrentSensor;

extern double errorTemperature[SENSOR_TEMP_QTY];
extern double ReferenceTemperatureRange, ReferenceTemperatureLow;
extern double RawTemperatureLow[SENSOR_TEMP_QTY],
    RawTemperatureRange[SENSOR_TEMP_QTY];

extern bool roomSensorPresent[ROOM_SENSOR_POSIBILITIES];
extern bool ambientSensorPresent;
extern bool digitalCurrentSensorPresent[2];

extern long lastSuccesfullSensorUpdate[SENSOR_TEMP_QTY];

extern IncuNest_parameters in3;

// Sampling frequency
const double FILTER_SAMPLE_FREQUENCY = 1000; // Hz
// Cut-off frequency (-3 dB)
const double FILTER_CUTOFF_FREQUENCY = 10; // Hz
// Normalized cut-off frequency
const double FILTER_NORMALIZED_CUT_OFF_FREQUENCY =
    (2 * FILTER_CUTOFF_FREQUENCY / FILTER_SAMPLE_FREQUENCY);

// filter_1 (NTC piel) se llama a 1000/SKIN_SENSOR_UPDATE_PERIOD_MS ≈ 5 Hz.
// Con ω_n=0.02 (diseñado a 1000 Hz) el corte efectivo cae a 0.05 Hz → τ≈3 s.
// Con ω_n=0.2 (f_c=0.5 Hz a 5 Hz) → τ≈0.32 s → 5τ≈1.5 s de asentamiento.
const double SKIN_FILTER_NORMALIZED_CUT_OFF_FREQUENCY =
    2.0 * 0.5 / (1000.0 / SKIN_SENSOR_UPDATE_PERIOD_MS);

// Sample timer for filter
Timer<micros> timer = std::round(1e6 / FILTER_SAMPLE_FREQUENCY);
// Sixth-order Butterworth filter
auto filter_0 = butter<6>(FILTER_NORMALIZED_CUT_OFF_FREQUENCY);
auto filter_1 = butter<6>(SKIN_FILTER_NORMALIZED_CUT_OFF_FREQUENCY);
auto filter_2 = butter<6>(FILTER_NORMALIZED_CUT_OFF_FREQUENCY);

long lastCurrentMeasurement, lastVoltageMeasurement;
// Incremented only when in3.heater_current is genuinely refreshed (SECUNDARY
// sensor present and read). heaterPowerConsumptionCheck() (PID.cpp) keys off
// this instead of lastCurrentMeasurement, which advances every tick
// regardless of whether the heater channel was actually read - using it
// directly would let the PWM ramp climb blind if the heater sensor is
// absent or drops out.
unsigned long heaterCurrentSampleSeq = 0;
// Same idea as heaterCurrentSampleSeq above, but for in3.system_current
// (MAIN sensor) - used as the heaterPowerConsumptionCheck() reference on
// HW18 (see HEATER_POWER_REFERENCE_IS_SYSTEM_CURRENT, board.h).
unsigned long systemCurrentSampleSeq = 0;
long lastEncoderUpdate;
static long lastPhotoControl = 0;
static int heaterSensorDropoutCycles = 0;

// The Beastdevices_INA3221 library (getCurrent()) does not check I2C
// transaction results: on a NACK/timeout it silently returns whatever was
// last in the register (or 0), with no error signal - see
// Beastdevices_INA3221::_read(). A cheap independent bus-presence probe lets
// currentMonitor() tell a real dropout from a normal reading, instead of
// trusting a value that only looks plausible.
static bool i2cDevicePresent(uint8_t addr) {
  wire->beginTransmission(addr);
  return wire->endTransmission() == 0;
}

void currentMonitor() {
  if (millis() - lastCurrentMeasurement > CURRENT_UPDATE_PERIOD_MS) {
    if (digitalCurrentSensorPresent[MAIN] &&
        i2cDevicePresent(MAIN_DIGITAL_CURRENT_SENSOR_I2C_ADDRESS)) {
      in3.system_current = measureMeanConsumption(MAIN, SYSTEM_SHUNT_CHANNEL);
      in3.fan_current = measureMeanConsumption(MAIN, FAN_SHUNT_CHANNEL);
      in3.phototherapy_current =
          measureMeanConsumption(MAIN, PHOTOTHERAPY_SHUNT_CHANNEL);
      systemCurrentSampleSeq++;
    }
    if (digitalCurrentSensorPresent[SECUNDARY] &&
        i2cDevicePresent(SECUNDARY_DIGITAL_CURRENT_SENSOR_I2C_ADDRESS)) {
      heaterSensorDropoutCycles = 0;
      in3.heater_current =
          measureMeanConsumption(SECUNDARY, HEATER_SHUNT_CHANNEL);
#if (HW_NUM == 17)
      if (in3.heater_current < 0) {
        in3.heater_current = -in3.heater_current / HEATER_CURRENT_CORRECTION_FACTOR;
      }
#endif
      in3.USB_current = measureMeanConsumption(SECUNDARY, USB_SHUNT_CHANNEL);
      in3.BATTERY_current =
          measureMeanConsumption(SECUNDARY, BATTERY_SHUNT_CHANNEL);
      heaterCurrentSampleSeq++;
    } else if (digitalCurrentSensorPresent[SECUNDARY]) {
      // Chip was found at boot but is not answering now. Leave
      // in3.heater_current/USB/BATTERY at their last known values and do NOT
      // advance heaterCurrentSampleSeq, so heaterPowerConsumptionCheck()
      // (PID.cpp) parks the PWM ramp instead of climbing on stale/invalid
      // data. Escalate to ALARM_HEATER_FAULT (unrecoverable within the
      // session, same as the existing boot-time heater fault) if the
      // dropout persists.
      // ALARM_HEATER_SENSOR_FAULT y no ALARM_HEATER_FAULT: el calefactor puede
      // estar perfecto: lo que se ha perdido es la medida de su consumo. Corta
      // igual (no se deja calentar sin vigilancia), pero el operador tiene que
      // revisar el conector del SENSOR, no el del calefactor.
      if (++heaterSensorDropoutCycles >= HEATER_SENSOR_DROPOUT_ALARM_CYCLES &&
          alarm_machine_state(ALARM_HEATER_SENSOR_FAULT) == ALARM_STATE_INACTIVE)
      {
        logE("[SENSOR] -> Heater current sensor (SECUNDARY) stopped answering on I2C");
        alarm_machine_condition(ALARM_HEATER_SENSOR_FAULT, true, millis());
      }
    }
    lastCurrentMeasurement = millis();
  }

  // g_factoryTestActive: el canal de fototerapia esta en estado seguro
  // durante la bateria de fabrica (design.md D4, shared-factory-test); esta
  // regulacion de intensidad es un tercer escritor de PWM que sobrevive con
  // el control apagado y debe respetar el mismo gate que PIDHandler()/
  // turnFans().
  if (!g_factoryTestActive && in3.phototherapy &&
      (millis() - in3.photoTurnOnTime  > PHOTO_SETTLE_MS) &&
      (millis() - lastPhotoControl     > PHOTO_CONTROL_PERIOD_MS) &&
      in3.phototherapy_current > 0.0f) {

    float error = in3.phototherapy_current - PHOTO_TARGET_CURRENT;
    if (error > PHOTO_TOLERANCE_A || error < -PHOTO_TOLERANCE_A) {
      int newIntensity = (int)(in3.phototherapy_intensity *
                               PHOTO_TARGET_CURRENT / in3.phototherapy_current + 0.5f);
      int delta = newIntensity - (int)in3.phototherapy_intensity;
      if (delta >  PHOTO_MAX_STEP) delta =  PHOTO_MAX_STEP;
      if (delta < -PHOTO_MAX_STEP) delta = -PHOTO_MAX_STEP;
      int next = (int)in3.phototherapy_intensity + delta;
      if (next < PHOTO_MIN_PWM)   next = PHOTO_MIN_PWM;
      if (next > PWM_MAX_VALUE)   next = PWM_MAX_VALUE;
      in3.phototherapy_intensity = (byte)next;
      ledcWrite(PHOTOTHERAPY_PWM_CHANNEL, in3.phototherapy_intensity);
    }
    lastPhotoControl = millis();

    // Guarda la intensidad a la que el lazo ha convergido, para sembrar con
    // ella en el proximo encendido en vez de con la extrapolacion del
    // autotest.
    //
    // La extrapolacion parte de una lectura al 10 % de PWM y asume
    // I proporcional a (PWM+20). En la flota eso acierta, pero no en todas las
    // unidades: en la de banco (2026-09-23) el lazo convergio a PWM 47 para
    // 0,28 A, mientras que su lectura al 10 % --0,10 A-- queda por debajo de
    // esa recta y hace que la extrapolacion pida en torno al doble de PWM. El
    // valor convergido es medido, no modelado, asi que es mejor semilla.
    //
    // Se escribe como mucho cada 60 s y solo si ha cambiado: esto corre una
    // vez por segundo y NVS es flash.
    //
    // Y SOLO DENTRO DE BANDA. La primera version guardaba cualquier valor, y
    // la primera escritura de una sesion caia en la semilla de la
    // extrapolacion: en banco (2026-09-23, objetivo 0,45 A) eso fue PWM 175 a
    // 1,06 A. Si la sesion se cortaba antes del siguiente guardado, la
    // proxima volvia a arrancar al doble del objetivo. Una semilla solo vale
    // si es un punto donde el lazo YA estaba en su sitio.
    const bool enBanda =
        (error <= PHOTO_TOLERANCE_A) && (error >= -PHOTO_TOLERANCE_A);
    static uint32_t ultimoGuardadoPwm = 0;
    static uint8_t  pwmGuardado = 0;
    if (enBanda && in3.phototherapy_intensity != pwmGuardado &&
        millis() - ultimoGuardadoPwm > 60000) {
      Preferences p;
      p.begin(NS_STATE, false);
      p.putUChar(KEY_PHOTO_PWM, in3.phototherapy_intensity);
      p.putUShort(KEY_PHOTO_PWM_TGT,
                  (uint16_t)(PHOTO_TARGET_CURRENT * 1000.0f + 0.5f));
      p.end();
      pwmGuardado = in3.phototherapy_intensity;
      ultimoGuardadoPwm = millis();
    }
  }
}

void voltageMonitor() {
  if (millis() - lastVoltageMeasurement > VOLTAGE_UPDATE_PERIOD_MS) {
    if (digitalCurrentSensorPresent[MAIN]) {
      in3.system_voltage = measureMeanVoltage(MAIN, SYSTEM_SHUNT_CHANNEL);
    }
    if (digitalCurrentSensorPresent[SECUNDARY]) {
      in3.USB_voltage = measureMeanVoltage(SECUNDARY, USB_SHUNT_CHANNEL);
      in3.BATTERY_voltage =
          measureMeanVoltage(SECUNDARY, BATTERY_SHUNT_CHANNEL);
    }
    lastVoltageMeasurement = millis();
  }
}

double measureStabilizedCurrent(bool sensor, int shunt, float offsetCurrent,
                                 float minExpected, float maxExpected,
                                 int maxTimeMs, int intervalMs, int window) {
  // Ventana deslizante de `window` lecturas: compara rango (max-min) contra
  // threshold. Evita salidas prematuras por deriva térmica lenta (heater,
  // fotosterapia), donde |curr-prev| en un solo intervalo es menor que el
  // threshold aunque la corriente siga subiendo.
  // Cargas rápidas: window=3 (~330 ms a 110 ms/intervalo).
  // Cargas térmicas: window=10 (~1.1 s a 110 ms/intervalo).
  const int WINDOW = window;
  float threshold = (maxExpected - minExpected) * CURRENT_STABILIZE_THRESHOLD_RATIO;

  float first = measureMeanConsumption(sensor, shunt) - offsetCurrent;
  float buf[WINDOW];
  for (int i = 0; i < WINDOW; i++) buf[i] = first;

  int idx = 0, count = 0, elapsed = 0, overMaxCount = 0;
  float curr = first;

  while (elapsed < maxTimeMs) {
    vTaskDelay(pdMS_TO_TICKS(intervalMs));
    elapsed += intervalMs;
    curr = measureMeanConsumption(sensor, shunt) - offsetCurrent;
    if (curr > maxExpected) {
      if (++overMaxCount >= 2) return curr;  // confirmed overcurrent, not a transient spike
    } else {
      overMaxCount = 0;
    }
    buf[idx % WINDOW] = curr;
    idx++;
    count++;
    if (count >= WINDOW) {
      float mn = buf[0], mx = buf[0];
      for (int i = 1; i < WINDOW; i++) {
        if (buf[i] < mn) mn = buf[i];
        if (buf[i] > mx) mx = buf[i];
      }
      if ((mx - mn) < threshold && curr >= minExpected && curr <= maxExpected) {
        return curr;
      }
    }
  }
  return curr;
}

double measureMeanConsumption(bool sensor, int shunt) {
  if (digitalCurrentSensorPresent[sensor]) {
    if (sensor == SECUNDARY) {
      return (secundaryDigitalCurrentSensor.getCurrent(
          ina3221_ch_t(shunt))); // Amperes
    }
    return (
        mainDigitalCurrentSensor.getCurrent(ina3221_ch_t(shunt))); // Amperes
  }
  return (false);
}

float measureMeanVoltage(bool sensor, int shunt) {
  if (digitalCurrentSensorPresent[sensor]) {
    if (sensor) {
      return (secundaryDigitalCurrentSensor.getVoltage(
          ina3221_ch_t(shunt))); // Volts
    }
    return (mainDigitalCurrentSensor.getVoltage(ina3221_ch_t(shunt))); // Volts
  }
  return (false);
}

struct YsiPoint {
  float tempC;
  float resistance;
};

// Valores calibrados: base teórica S-H YSI 44006 (2252 Ω a 25 °C,
// A=1.4733e-3, B=2.3730e-4, C=1.0540e-7) con corrección de +0.37 °C
// aplicada sobre un punto de calibración real (36 °C → leía 36.6 °C).
// Método: R_corr(T) = R_teorica(T - 0.37 °C) para cada entrada.
// Resistencias en orden DESCENDENTE (NTC: más temperatura → menos resistencia).
static const YsiPoint ysi400Table[] = {
    {10.0f, 4574.0f}, {11.0f, 4361.0f}, {12.0f, 4156.0f}, {13.0f, 3964.0f},
    {14.0f, 3781.0f}, {15.0f, 3607.0f}, {16.0f, 3443.0f}, {17.0f, 3288.0f},
    {18.0f, 3141.0f}, {19.0f, 3000.0f}, {20.0f, 2867.0f}, {21.0f, 2741.0f},
    {22.0f, 2621.0f}, {23.0f, 2506.0f}, {24.0f, 2397.0f}, {25.0f, 2293.0f},
    {26.0f, 2194.0f}, {27.0f, 2100.0f}, {28.0f, 2011.0f}, {29.0f, 1927.0f},
    {30.0f, 1846.0f}, {31.0f, 1768.0f}, {32.0f, 1695.0f}, {33.0f, 1626.0f},
    {34.0f, 1559.0f}, {35.0f, 1495.0f}, {36.0f, 1435.0f}, {37.0f, 1377.0f},
    {38.0f, 1322.0f}, {39.0f, 1270.0f}, {40.0f, 1221.0f}, {41.0f, 1173.0f},
    {42.0f, 1127.0f},
};

static float resistanceToTempYSI400(float rntc) {
  const int n = sizeof(ysi400Table) / sizeof(ysi400Table[0]);

  if (rntc <= 0.0f)
    return NAN;

  // La NTC baja su resistencia al subir temperatura
  for (int i = 0; i < n - 1; ++i) {
    float r1 = ysi400Table[i].resistance;
    float r2 = ysi400Table[i + 1].resistance;

    if ((rntc <= r1 && rntc >= r2) || (rntc >= r1 && rntc <= r2)) {
      float t1 = ysi400Table[i].tempC;
      float t2 = ysi400Table[i + 1].tempC;

      float frac = (rntc - r1) / (r2 - r1);
      return t1 + frac * (t2 - t1);
    }
  }

  return NAN;
}

// Resistencia de la NTC a partir de la tensión medida, o NAN si la lectura
// está fuera del divisor. Se extrae de adcToCelsius() porque la clasificación
// de averías (skinProbeFault()) razona en resistencia, no en milivoltios:
// duplicar la fórmula del divisor en dos sitios es pedir que diverjan.
float adcToResistance(float adcReading_mV) {
  const float rTop = 2260.0f; // Resistencia del divisor (Ω, 0.1%)
#if (HW_NUM >= 17)
  const float vExc = 2.048f;  // Tensión de excitación (LM4040EIM7-2.0, 2.048 V)
#else
  const float vExc = 3.3f;    // Tensión de excitación (GPIO, 3.3 V)
#endif

  if (adcReading_mV <= 0.0f || adcReading_mV >= vExc * 1000.0f)
    return NAN;

  float vm = adcReading_mV / 1000.0f;
  return rTop * vm / (vExc - vm);
}

float adcToCelsius(float adcReading_mV) {
  const float rntc = adcToResistance(adcReading_mV);
  if (isnan(rntc))
    return NAN;
  return resistanceToTempYSI400(rntc);
}

// Clasificación de la avería de la sonda, por RESISTENCIA y no por la ventana
// en milivoltios que había antes.
//
// El motivo no es elegancia. Los límites viejos (ADC_TO_DISCARD_MIN/MAX =
// 500/2500 mV) venían de cuando la excitación eran 3,3 V y nunca se
// rehicieron para los 2,048 V del LM4040: el superior queda POR ENCIMA del
// raíl, así que no filtraba nada, y el inferior corresponde a ~730 Ω, muy por
// debajo de los 1127 Ω que son 42 °C. La banda fisiológica real es 681–1371 mV
// y la ventana era mucho más ancha.
//
// Ahí estaba el agujero: un cortocircuito PARCIAL —humedad puenteando el
// conector— da una resistencia baja que se traduce en una piel plausiblemente
// caliente. En modo piel eso hace que el control deje de calentar, sin ninguna
// alarma. Hipotermia silenciosa, con el corte térmico de 40 °C como único
// backstop. Acotar por fisiología en vez de por raíles lo cierra.
//
// SkinProbeReading vive en sensors_module.h: factory_test_hw.cpp (SKIN_ADC)
// tambien la usa.

// ~45 °C y ~5 °C en la YSI 400. Ni la piel de un neonato baja de 5 °C ni sube
// de 45 °C con la sonda puesta: cualquier cosa fuera de ahí es avería, no
// medida. Se deja margen sobre la tabla (10–42 °C) para no rechazar lecturas
// legítimas en sus extremos.
#define SKIN_NTC_SHORT_OHMS 800.0f
#define SKIN_NTC_OPEN_OHMS 6000.0f

static SkinProbeReading s_lastSkinProbeReading = SKIN_PROBE_READING_OK;

static SkinProbeReading skinProbeFault(float millivolts) {
  const float rntc = adcToResistance(millivolts);
  // Fuera del divisor: el ADC saturó por arriba (circuito abierto) o leyó cero.
  if (isnan(rntc))
    return (millivolts <= 0.0f) ? SKIN_PROBE_READING_SHORT
                                : SKIN_PROBE_READING_OPEN;
  if (rntc < SKIN_NTC_SHORT_OHMS)
    return SKIN_PROBE_READING_SHORT;
  if (rntc > SKIN_NTC_OPEN_OHMS)
    return SKIN_PROBE_READING_OPEN;
  return SKIN_PROBE_READING_OK;
}

// Última clasificación, para el log y el diagnóstico en banco. La URGENCIA de
// la avería sigue dependiendo del modo (ALARM_SKIN_SENSOR_FAULT_SKIN_MODE es
// ALTA y corta calefactor; la de modo aire es BAJA), que es lo correcto: lo
// que cambia con el corto no es la gravedad, es qué hay que revisar.
SkinProbeReading skinProbeLastReading(void) { return s_lastSkinProbeReading; }

void fanSpeedHandler() {
  double fanEncoderPeriodFiltered;
  if (in3.fanEncoderUpdate) {
    in3.fanEncoderUpdate = false;
    long rawPeriod = in3.fanEncoderPeriod[1] - in3.fanEncoderPeriod[0];
    // The first edge after an idle gap pairs a fresh timestamp with one from
    // the last time the fan spun (possibly minutes old), producing a huge
    // bogus period. Fed into the stateful 6th-order Butterworth, that single
    // impulse dominates its output for hundreds of samples, holding fan_rpm
    // near 0 well past the spin-up grace and firing a spurious
    // ALARM_FAN_FAILURE right after the fan is commanded back on. Discard any
    // period longer than the zero-RPM timeout already covers; don't refresh
    // lastEncoderUpdate for discarded samples so a genuinely dead/slow fan
    // still falls through to the timeout below.
    if (rawPeriod <= 0 || rawPeriod > (long)FAN_UPDATE_TIME_MIN * 1000) {
      return;
    }
    lastEncoderUpdate = millis();
    fanEncoderPeriodFiltered = filter_0(rawPeriod);
    if (fanEncoderPeriodFiltered) {
      in3.fan_rpm = FAN_RPM_CONVERSION / fanEncoderPeriodFiltered;
    }
  } else if (millis() - lastEncoderUpdate > FAN_UPDATE_TIME_MIN) {
    in3.fan_rpm = 0;
  }
}

// Shared post-processing: calibration, filter, clamp
static bool applyNTCResult(float millivolts) {
  const SkinProbeReading fault = skinProbeFault(millivolts);
  s_lastSkinProbeReading = fault;
  if (fault != SKIN_PROBE_READING_OK) {
    // Se distingue en el log porque la accion del servicio tecnico es
    // distinta: un corto es sonda o conector danado y hay que sustituirla; un
    // circuito abierto suele ser que esta desenchufada.
    static uint32_t lastFaultLog = 0;
    if (millis() - lastFaultLog >= 1000) {
      logE(String("[SKIN] sonda ") +
           (fault == SKIN_PROBE_READING_SHORT ? "en CORTOCIRCUITO"
                                              : "en CIRCUITO ABIERTO") +
           " (mV=" + String(millivolts, 1) +
           " R=" + String(adcToResistance(millivolts), 0) + ")");
      lastFaultLog = millis();
    }
    in3.temperature[SKIN_SENSOR] = 0;
    return false;
  }
  {
    float tempRaw = adcToCelsius(millivolts);
    if (isnan(tempRaw)) {
      in3.temperature[SKIN_SENSOR] = 0;
      return false;
    }
    // filter_1 tiene ω_n=0.2 a 5 Hz → τ≈1.6 muestras. 200 iteraciones
    // garantizan convergencia total en la primera lectura válida.
    if (lastSuccesfullSensorUpdate[SKIN_SENSOR] == 0) {
      for (int i = 0; i < 200; i++)
        filter_1(tempRaw);
    }
    lastSuccesfullSensorUpdate[SKIN_SENSOR] = millis();
    in3.temperature[SKIN_SENSOR] = filter_1(tempRaw);
    errorTemperature[SKIN_SENSOR] = in3.temperature[SKIN_SENSOR];
    if (RawTemperatureRange[SKIN_SENSOR]) {
      in3.temperature[SKIN_SENSOR] =
          (((in3.temperature[SKIN_SENSOR] - RawTemperatureLow[SKIN_SENSOR]) *
            ReferenceTemperatureRange) /
           RawTemperatureRange[SKIN_SENSOR]) +
          ReferenceTemperatureLow;
    }
    in3.temperature[SKIN_SENSOR] += in3.fineTuneSkinTemperature;
    errorTemperature[SKIN_SENSOR] -= in3.temperature[SKIN_SENSOR];
    if (in3.temperature[SKIN_SENSOR] < 0) {
      in3.temperature[SKIN_SENSOR] = 0;
    }
    return true;
  }
  in3.temperature[SKIN_SENSOR] = 0;
  return false;
}

bool measureSkinSensor() {
  // Alimenta el divisor resistivo, espera estabilización y dispara una
  // conversión single-shot en el ADS1110 (14-bit/60 SPS, PGA=1).
  // [ST=1][SC=1][PGA=00][DR=01][00] = 0xC4
  // Con single-shot no hay riesgo de leer una conversión obsoleta y el
  // tiempo de excitación de la NTC queda en ~22 ms (5 ms settle + ~17 ms
  // conversión), minimizando el autocalentamiento.
  digitalWrite(BABY_TEMP_EN, HIGH);
  vTaskDelay(pdMS_TO_TICKS(22)); // espera estabilización del divisor

  wire->beginTransmission(ADS1110_I2C_ADDRESS);
  wire->write(0xC4); // dispara conversión single-shot
  if (wire->endTransmission() != 0) {
#if SKIN_NTC_PULSED_EXCITATION
    digitalWrite(BABY_TEMP_EN, LOW);
#endif
    in3.temperature[SKIN_SENSOR] = 0;
    return false;
  }

  // Espera a que el ADS1110 complete la conversión (/RDY=0).
  // Timeout: 100 ms (14-bit/60 SPS tarda ~17 ms).
  int16_t raw = 0;
  uint8_t msb = 0, lsb = 0, cfg = 0;
  bool convReady = false;
  uint32_t deadline = millis() + 100;
  while (millis() < deadline) {
    uint8_t n = wire->requestFrom((uint8_t)ADS1110_I2C_ADDRESS, (uint8_t)3);
    if (n < 3) {
#if SKIN_NTC_PULSED_EXCITATION
      digitalWrite(BABY_TEMP_EN, LOW);
#endif
      static uint32_t lastI2cErrLog = 0;
      if (millis() - lastI2cErrLog >= 1000) {
        logI("[SKIN] ADS1110 I2C error: only " + String(n) + " bytes received");
        lastI2cErrLog = millis();
      }
      in3.temperature[SKIN_SENSOR] = 0;
      return false;
    }
    msb = wire->read();
    lsb = wire->read();
    cfg = wire->read();
    if (!(cfg & 0x80)) { // /RDY=0: conversion complete, data fresh
      raw = (int16_t)((msb << 8) | lsb);
      convReady = true;
      break;
    }
    vTaskDelay(pdMS_TO_TICKS(10));
  }
#if SKIN_NTC_PULSED_EXCITATION
  digitalWrite(BABY_TEMP_EN, LOW); // power off NTC divider after read
#endif

  if (!convReady) {
    static uint32_t lastTimeoutLog = 0;
    if (millis() - lastTimeoutLog >= 1000) {
      logI("[SKIN] ADS1110 timeout waiting for /RDY (cfg=0x" +
           String(cfg, HEX) + ")");
      lastTimeoutLog = millis();
    }
    return false;
  }

  // En 14-bit, raw=8191 indica saturación del ADS1110 (vm >= 2.048 V).
  // Esto ocurre cuando la sonda está desconectada (circuito abierto) o
  // cuando la temperatura es tan baja que rNTC > 3697 Ω (~< 16 °C).
  // En ambos casos reportar temperatura=0.
  if (raw >= 8191) {
    in3.temperature[SKIN_SENSOR] = 0;
    return false;
  }

  // ADS1110 right-justifica el dato. En 14-bit (DR=01): rango ±8191,
  // LSB = 4096 mV / 16384 = 0.25 mV/bit.
  float millivolts = raw * 0.25f;
  float tempC = adcToCelsius(millivolts);

  static uint32_t lastAds1110Log = 0;
  if (millis() - lastAds1110Log >= 1000) {
    logI("[SKIN] ADS1110 raw=" + String(raw) + " mV=" + String(millivolts, 1) +
         " T=" + String(tempC, 2) + "C" + " cfg=0x" + String(cfg, HEX));
    lastAds1110Log = millis();
  }

  return applyNTCResult(millivolts);
}

bool updateRoomSensor() {
  // En un equipo con SensorBoard la temperatura y la humedad de cabina llegan
  // por USB, no por I2C2: esos pines son ahora D-/D+. Se delega y se sale
  // ANTES de tocar el bus, porque el camino de abajo pondria las magnitudes a
  // 0 y volveria a sondear un bus que ya no existe.
  //
  // La escritura de in3.temperature[]/in3.humidity[] la hace
  // sensorboard_apply_room_sensor(), pero desde ESTA tarea: son las mismas
  // variables clinicas que escribe el camino I2C y no conviene que las toquen
  // dos tareas distintas.
  if (sensorSourceGet() == SENSOR_SOURCE_SENSORBOARD) {
    return sensorboard_apply_room_sensor();
  }
  static char errorMessage[64];

  // Lecturas aisladas para decidir primario/redundante tras el loop.
  float sts_sum = 0.0f;
  int sts_count = 0;
  bool shtc3_ok = false;
  float shtc3_T = 0.0f;
  float shtc3_H = 0.0f;

  in3.airTemperatureRedundantSensor = 0;

  for (int i = 0; i < ROOM_SENSOR_POSIBILITIES; i++) {
    if (!roomSensorPresent[i])
      continue;

    switch (i) {
    case ROOM_SENSOR_STS3X_MAIN:
    case ROOM_SENSOR_STS3X_REDUNDANT: {
      float aTemperature = 0.0f;
      uint16_t err =
          mySTS35[i].measureSingleShot(REPEATABILITY_HIGH, false, aTemperature);
      if (err != NO_ERROR) {
        errorToString(err, errorMessage, sizeof(errorMessage));
        logI(String("Error in measureSingleShot() STS35: ") +
             String(errorMessage));
        break;
      }
      if (aTemperature > DIG_TEMP_TO_DISCARD_MIN &&
          aTemperature < DIG_TEMP_TO_DISCARD_MAX) {
        sts_sum += aTemperature;
        sts_count++;
        logI(String("STS35 OK: ") + String(aTemperature, 2) + " °C");
      } else {
        logI(String("STS35 out of range: ") + String(aTemperature, 2) + " °C");
      }
      break;
    }

    case ROOM_SENSOR_SHTC3: {
      SHTC3_Status_TypeDef shtc3_sensor_status = mySHTC3.update();
      if (!shtc3_sensor_status) {
        float sensedTemperature = mySHTC3.toDegC();
        if (sensedTemperature > DIG_TEMP_TO_DISCARD_MIN &&
            sensedTemperature < DIG_TEMP_TO_DISCARD_MAX) {
          shtc3_ok = true;
          shtc3_T = sensedTemperature;
          shtc3_H = mySHTC3.toPercent();
          logI(String("SHTC3 OK: ") + String(sensedTemperature, 2) + " °C, " +
               String(shtc3_H, 2) + " %RH");
        }
      }
      break;
    }
    default:
      break;
    }
  }

  // SHTC3 es la única fuente de humedad: actualiza siempre que haya lectura.
  if (shtc3_ok) {
    in3.humidity[ROOM_DIGITAL_HUM_SENSOR] = shtc3_H;
  }

  // Primario: STS35 si lee; si no, fallback al SHTC3. Redundante: SHTC3 solo
  // cuando el STS35 provee el primario (de lo contrario no hay redundancia).
  if (sts_count > 0) {
    lastSuccesfullSensorUpdate[ROOM_DIGITAL_TEMP_SENSOR] = millis();
    in3.temperature[ROOM_DIGITAL_TEMP_SENSOR] = sts_sum / sts_count;
    if (shtc3_ok) {
      in3.airTemperatureRedundantSensor = shtc3_T;
    }
    return true;
  }

  if (shtc3_ok) {
    lastSuccesfullSensorUpdate[ROOM_DIGITAL_TEMP_SENSOR] = millis();
    in3.temperature[ROOM_DIGITAL_TEMP_SENSOR] = shtc3_T;
    return true;
  }

  in3.temperature[ROOM_DIGITAL_TEMP_SENSOR] = 0;
  in3.humidity[ROOM_DIGITAL_HUM_SENSOR] = 0;
  initRoomSensor();
  return false;
}

bool updateAmbientSensor() {
  if (ambientSensorPresent) {
    sensors_event_t humidity, temp;
    sht4.getEvent(&humidity,
                  &temp); // populate temp and humidity objects with fresh data
    in3.temperature[AMBIENT_DIGITAL_TEMP_SENSOR] = temp.temperature;
    in3.humidity[AMBIENT_DIGITAL_HUM_SENSOR] = humidity.relative_humidity;
    return true;
  } else {
    initAmbientSensor();
  }
  return false;
}

// Sensors module — sensor acquisition (current/voltage monitoring, room/
// ambient/skin temperature, fan speed). Migrated from legacy/sensors.cpp,
// which predated Display_HMI and mixed this logic with on-board UI externs
// that no function here ever used.

void sensors_module_init(void) {
  initRoomSensor();
  initAmbientSensor();
  initSkinSensor();
}

void sensors_module_update(void) {
  measureSkinSensor();
  updateRoomSensor();
  updateAmbientSensor();
  powerMonitor();
  fanSpeedHandler();
}
