medicalopenworld/IncuNest/Firmware/shared/include/alarm_ids.h

#pragma once

#ifdef __cplusplus
extern "C" {
#endif

// Conjunto de condiciones de alarma derivado de IEC 60601-2-19 (201.12.3.101
// a 201.12.3.103, 201.15.4.2.1) y de la Tabla 1 de IEC 60601-1-8. La
// justificacion por condicion vive en docs/alarms_normative_analysis.md §5.
//
// El valor numerico es el indice de bit en el bitmask del protocolo, asi que
// insertar en medio rompe la compatibilidad: las condiciones nuevas van al
// final, antes de ALARM_COUNT.
typedef enum {
  ALARM_NONE = 0,
  // --- Prioridad ALTA ---
  ALARM_AIR_THERMAL_CUTOUT = 1,       // 201.15.4.2.1 aa)
  ALARM_SKIN_THERMAL_CUTOUT = 2,      // 201.15.4.2.1 bb)
  ALARM_AIR_SENSOR_FAULT = 3,
  ALARM_SKIN_SENSOR_FAULT_SKIN_MODE = 4,  // 201.12.3.102
  ALARM_FAN_FAILURE = 5,                  // 201.12.3.101
  ALARM_AIR_OUTLET_BLOCKED = 6,           // 201.12.3.101
  ALARM_MAINS_INTERRUPTION = 7,           // 201.12.3.103
  // --- Prioridad MEDIA ---
  ALARM_AIR_TEMP_DEVIATION_HIGH = 8,   // 201.15.4.2.1 dd), +3 C
  ALARM_AIR_TEMP_DEVIATION_LOW = 9,    // 201.15.4.2.1 dd), -3 C
  ALARM_SKIN_TEMP_DEVIATION_HIGH = 10, // 201.15.4.2.1 ee), +1 C
  ALARM_SKIN_TEMP_DEVIATION_LOW = 11,  // 201.15.4.2.1 ee), -1 C
  ALARM_HEATER_FAULT = 12,
  ALARM_SUPPLY_UNDERVOLTAGE = 13,
  ALARM_HMI_LINK_LOST = 14,
  // --- Prioridad BAJA ---
  ALARM_SKIN_SENSOR_FAULT_AIR_MODE = 15,
  ALARM_HUMIDITY_DEVIATION = 16,
  // Fallo del SENSOR de corriente del calefactor, no del calefactor.
  //
  // Se separo de ALARM_HEATER_FAULT porque son averias distintas con acciones
  // distintas. Aquella la declara el autotest de arranque cuando la corriente
  // del calefactor esta fuera de rango: es cableado o resistencia, permanente,
  // y no se puede hacer nada sin servicio tecnico. Esta la declara la caida
  // del sondeo I2C del sensor de corriente en marcha: el calefactor puede
  // estar perfecto y lo que se ha perdido es la capacidad de VIGILARLO, asi
  // que lo que hay que revisar es otro conector.
  //
  // Va al final del enum, no junto a la 12, porque el valor numerico es el
  // indice de bit del protocolo y renumerar romperia la compatibilidad.
  ALARM_HEATER_SENSOR_FAULT = 17,
  // Enlace USB con el SensorBoard perdido: sin heartbeat >90 s (3 periodos
  // de 30 s), o el dispositivo nunca ha llegado a enumerar. Mismo criterio
  // que ALARM_HMI_LINK_LOST: perder una placa periferica completa se trata
  // igual con independencia de que placa sea.
  ALARM_SENSORBOARD_LINK_LOST = 18,
  // Sensor de puerta (hall DRV5032) implausible: con una sola linea digital
  // el SensorBoard no puede distinguir "puerta abierta" de "hall
  // desconectado/averiado" (ver SensorBoard_v2/README.md #Puerta). Aqui solo
  // se declara el sensor sospechoso, nunca se usa como entrada de control
  // termico.
  ALARM_SENSORBOARD_DOOR_FAULT = 19,
  ALARM_COUNT
} AlarmId;

// Alias de compatibilidad: hay bucles que iteran el rango completo del enum.
#define NO_ALARMS  ALARM_NONE
#define NUM_ALARMS ALARM_COUNT

typedef enum {
  ALARM_PRIORITY_LOW = 0,
  ALARM_PRIORITY_MEDIUM = 1,
  ALARM_PRIORITY_HIGH = 2,
} AlarmPriority;

#define MAX_ALARM_STRING_SIZE 255

// Capacidad de los dos campos de texto de la linea del protocolo
// `CTRL,ALM,<id>,<titulo>,<descripcion>,<0|1>`, SIN contar el terminador.
//
// Fuente unica: motherBoard compone la linea con estos limites y el display la
// parsea con estos mismos anchos (los usa para construir el formato de sscanf
// y para dimensionar sus buffers). Que fueran dos constantes independientes es
// lo que dejo el ancho de parseo en 31 mientras las descripciones crecian
// hasta 43 caracteres: sscanf paraba a los 31, no encontraba la coma que exige
// el formato, devolvia 3 en vez de 4 y el display DESCARTABA LA LINEA ENTERA —
// 12 de las 16 alarmas no llegaban a aparecer en pantalla en espanol.
//
// Son macros y no constexpr a proposito: el formato de sscanf del display se
// construye stringificando el ancho en el preprocesador, y un constexpr no se
// puede stringificar.
#define ALARM_TITLE_MAX_CHARS 29
#define ALARM_DESC_MAX_CHARS  99

// Tamano del buffer con el que motherBoard compone la linea CTRL,ALM completa
// (`sendAlarmUSB()`), terminador incluido. Es el segundo limite que puede
// truncar un texto, esta vez en el emisor: snprintf recorta en silencio y la
// linea llegaria sin el ultimo campo. El test nativo lo comprueba con las
// cadenas reales.
#define ALARM_LINE_BUF_SIZE 128

// La linea de CTRL,ALM_HISTORY lleva las 10 entradas de una vez, con su texto
// incluido: la motherBoard es la dueña de la informacion y el display solo la
// pinta, asi que el titulo viaja resuelto y el display no compone nada.
//
// Peor caso por entrada: id(2) + prioridad(1) + dos epoch(10+10) + limite(6) +
// valor(6) + titulo(ALARM_TITLE_MAX_CHARS) + 7 comas = 71. Por 10 entradas mas
// la cabecera "CTRL,ALM_HISTORY,10" y el salto de linea: ~730. Se redondea a
// 1024 para dejar margen a un titulo mas largo sin volver a tocar esto, y
// queda por debajo del buffer de recepcion del display (COMM_RX_BUFFER_SIZE),
// que es el limite real que no se puede rebasar.
#define ALARM_HISTORY_LINE_BUF_SIZE 1024

#ifdef __cplusplus
}
#endif
