medicalopenworld/IncuNest/Firmware/motherBoard/src/system/EEPROM.cpp

/*
  MIT License

  Copyright (c) 2022 Medical Open World, Pablo Sánchez Bergasa

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
*/
#include <Arduino.h>
#include <Preferences.h>

#include "main.h"
#include "alarm_policy.h"

extern bool WIFI_EN;
extern int presetTemp[2]; // preset baby skin temperature
extern double RawTemperatureLow[SENSOR_TEMP_QTY];
extern double RawTemperatureRange[SENSOR_TEMP_QTY];
extern double ReferenceTemperatureRange, ReferenceTemperatureLow;
extern IncuNest_parameters in3;
extern char wifi_ssid[64];
extern char wifi_pass[64];
extern int g_restore_photo_minutes;

void resetFlash()
{
  Preferences p;
  const char *ns[] = {NS_CFG, NS_CAL, NS_WIFI, NS_GPRS, NS_RT, NS_STATE, "photo"};
  for (auto n : ns)
  {
    p.begin(n, false);
    p.clear();
    p.end();
  }
}

void loaddefaultValues()
{
  in3.language = defaultLanguage;
  in3.controlMode = CONTROL_AIR;
  in3.desiredControlTemperature = presetTemp[CONTROL_AIR];
  in3.desiredControlHumidity = presetHumidity;
  in3.fanCtlPWM = FAN_CTL_PWM_DEFAULT;
  in3.fanPidEnabled = FAN_PID_ENABLED_DEFAULT;
  ReferenceTemperatureRange = 0.0;
  ReferenceTemperatureLow = 0.0;
  for (int i = 0; i < SENSOR_TEMP_QTY; i++)
  {
    RawTemperatureLow[i] = 0.0;
    RawTemperatureRange[i] = 0.0;
  }

  {
    Preferences p;
    p.begin(NS_CFG, false);
    p.putUChar(KEY_LANG, in3.language);
    p.putUChar(KEY_CTRL_MODE, in3.controlMode);
    p.putFloat(KEY_CTRL_TEMP, in3.desiredControlTemperature);
    p.putUChar(KEY_CTRL_HUM, in3.desiredControlHumidity);
    p.putInt(KEY_FAN_CTL_PWM, in3.fanCtlPWM);
    p.putUChar(KEY_FAN_PID_EN, in3.fanPidEnabled);
    p.putInt(KEY_FAN_PWR_SUPPLY_PWM, FAN_PWR_SUPPLY_PWM);
    p.putFloat(KEY_HEAT_MAX_A, HEATER_MAX_POWER_AMPS);
    p.putFloat(KEY_SKIN_T_MAX, SKIN_TEMPERATURE_SET_MAX);
    p.putFloat(KEY_AIR_T_MAX, AIR_THERMAL_CUTOUT_DEFAULT_C);
    p.putInt(KEY_ACT_PERIOD, 60);
    p.putInt(KEY_PHOTO_PERIOD, 180);
    p.putInt(KEY_STBY_PERIOD, 3600);
    p.end();
  }

  {
    Preferences p;
    p.begin(NS_CAL, false);
    p.putFloat(KEY_CAL_SK_LOW, 0.0f);
    p.putFloat(KEY_CAL_SK_RNG, 0.0f);
    p.putFloat(KEY_CAL_REF_RNG, 0.0f);
    p.putFloat(KEY_CAL_REF_LOW, 0.0f);
    p.putFloat(KEY_FT_SKIN, 0.0f);
    p.putFloat(KEY_FT_AIR, 0.0f);
    p.end();
  }

  {
    Preferences p;
    p.begin(NS_WIFI, false);
    p.putString(KEY_SSID, "");
    p.putString(KEY_PASSWORD, "");
    p.end();
  }

  {
    Preferences p;
    p.begin(NS_RT, false);
    p.putFloat(KEY_RT_STANDBY, 0.0f);
    p.putFloat(KEY_RT_CTRL, 0.0f);
    p.putFloat(KEY_RT_HEATER, 0.0f);
    p.putFloat(KEY_RT_FAN, 0.0f);
    p.putFloat(KEY_RT_PHOTO, 0.0f);
    p.putFloat(KEY_RT_HUM, 0.0f);
    p.end();
  }

  {
    Preferences p;
    p.begin(NS_STATE, false);
    p.putUChar(KEY_PHOTO_ACTIVE, 0);
    p.putUChar(KEY_ACTUATION, 0);
    p.end();
  }
}

static bool migrateFromEEPROM()
{
  constexpr int OLD_MAGIC_OFFSET = 10;
  constexpr uint8_t OLD_MAGIC_VAL = 0xAB;
  constexpr int OLD_LANG = 30;
  constexpr int OLD_SERIAL = 40;
  constexpr int OLD_CTRL_ACTIVE = 60;
  constexpr int OLD_PHOTO_ACTIVE = 65;
  constexpr int OLD_CTRL_MODE = 70;
  constexpr int OLD_CTRL_TEMP = 80;
  constexpr int OLD_CTRL_HUM = 90;
  constexpr int OLD_SK_LOW = 100;
  constexpr int OLD_SK_RNG = 110;
  constexpr int OLD_WIFI_SSID = 115;
  constexpr int OLD_WIFI_PASS = 145;
  constexpr int OLD_REF_RNG = 170;
  constexpr int OLD_REF_LOW = 180;
  constexpr int OLD_FT_SKIN = 190;
  constexpr int OLD_FT_AIR = 194;
  constexpr int OLD_TB_PROV = 200;
  constexpr int OLD_TB_TOKEN = 205;
  constexpr int OLD_STANDBY = 226;
  constexpr int OLD_CTRL_TIME = 230;
  constexpr int OLD_HEATER_TIME = 234;
  constexpr int OLD_FAN_TIME = 238;
  constexpr int OLD_PHOTO_TIME = 242;
  constexpr int OLD_HUM_TIME = 246;
  constexpr int OLD_FAN_PWM = 254;
  constexpr int OLD_HEAT_MAX_A = 258;
  constexpr int OLD_SKIN_T_MAX = 262;
  constexpr int OLD_AIR_T_MAX = 266;
  constexpr int OLD_ACT_PERIOD = 270;
  constexpr int OLD_PHOTO_PERIOD = 274;
  constexpr int OLD_STBY_PERIOD = 278;
  constexpr int OLD_FAN_CTL_PWM = 282;

  Preferences old;
  old.begin("eeprom", true);
  uint8_t buf[512] = {};
  size_t len = old.getBytes("data", buf, sizeof(buf));
  old.end();

  if (len < 512 || buf[OLD_MAGIC_OFFSET] != OLD_MAGIC_VAL)
  {
    return false;
  }

  auto rf = [&](int off)
  { float v;   memcpy(&v, buf + off, 4); return v; };
  auto ri = [&](int off)
  { int32_t v; memcpy(&v, buf + off, 4); return v; };

  {
    Preferences p;
    p.begin(NS_CFG, false);
    p.putUChar(KEY_LANG, buf[OLD_LANG]);
    p.putInt(KEY_SERIAL, ri(OLD_SERIAL));
    p.putUChar(KEY_CTRL_MODE, buf[OLD_CTRL_MODE]);
    p.putFloat(KEY_CTRL_TEMP, rf(OLD_CTRL_TEMP));
    p.putUChar(KEY_CTRL_HUM, buf[OLD_CTRL_HUM]);
    p.putInt(KEY_FAN_PWR_SUPPLY_PWM, ri(OLD_FAN_PWM));
    p.putFloat(KEY_HEAT_MAX_A, rf(OLD_HEAT_MAX_A));
    p.putFloat(KEY_SKIN_T_MAX, rf(OLD_SKIN_T_MAX));
    p.putFloat(KEY_AIR_T_MAX, rf(OLD_AIR_T_MAX));
    p.putInt(KEY_FAN_CTL_PWM, ri(OLD_FAN_CTL_PWM));
    p.end();
  }

  {
    Preferences p;
    p.begin(NS_CAL, false);
    p.putFloat(KEY_CAL_SK_LOW, rf(OLD_SK_LOW));
    p.putFloat(KEY_CAL_SK_RNG, rf(OLD_SK_RNG));
    p.putFloat(KEY_CAL_REF_RNG, rf(OLD_REF_RNG));
    p.putFloat(KEY_CAL_REF_LOW, rf(OLD_REF_LOW));
    p.putFloat(KEY_FT_SKIN, rf(OLD_FT_SKIN));
    p.putFloat(KEY_FT_AIR, rf(OLD_FT_AIR));
    p.end();
  }

  char ssid_tmp[31] = {};
  char pass_tmp[26] = {};
  char token_tmp[22] = {};
  memcpy(ssid_tmp, buf + OLD_WIFI_SSID, 30);
  memcpy(pass_tmp, buf + OLD_WIFI_PASS, 25);
  memcpy(token_tmp, buf + OLD_TB_TOKEN, 21);

  {
    Preferences p;
    p.begin(NS_WIFI, false);
    p.putString(KEY_SSID, ssid_tmp);
    p.putString(KEY_PASSWORD, pass_tmp);
    p.end();
  }

  {
    Preferences p;
    p.begin(NS_GPRS, false);
    p.putUChar(KEY_PROVISIONED, buf[OLD_TB_PROV]);
    p.putString(KEY_TOKEN, token_tmp);
    p.putInt(KEY_ACT_PERIOD, ri(OLD_ACT_PERIOD));
    p.putInt(KEY_PHOTO_PERIOD, ri(OLD_PHOTO_PERIOD));
    p.putInt(KEY_STBY_PERIOD, ri(OLD_STBY_PERIOD));
    p.end();
  }

  {
    Preferences p;
    p.begin(NS_RT, false);
    p.putFloat(KEY_RT_STANDBY, rf(OLD_STANDBY));
    p.putFloat(KEY_RT_CTRL, rf(OLD_CTRL_TIME));
    p.putFloat(KEY_RT_HEATER, rf(OLD_HEATER_TIME));
    p.putFloat(KEY_RT_FAN, rf(OLD_FAN_TIME));
    p.putFloat(KEY_RT_PHOTO, rf(OLD_PHOTO_TIME));
    p.putFloat(KEY_RT_HUM, rf(OLD_HUM_TIME));
    p.end();
  }

  {
    Preferences p;
    p.begin(NS_STATE, false);
    p.putUChar(KEY_PHOTO_ACTIVE, buf[OLD_PHOTO_ACTIVE]);
    p.putUChar(KEY_ACTUATION, buf[OLD_CTRL_ACTIVE]); // actuation encodes same byte
    p.end();
  }

  old.begin("eeprom", false);
  old.clear();
  old.end();

  ESP_LOGI("APP", "Migración EEPROM → Preferences completada");
  return true;
}

void initEEPROM()
{
  // Read any flasher-provisioned serial before a potential resetFlash clears it.
  Preferences p;
  p.begin(NS_CFG, false);
  bool initialized = p.isKey(KEY_LANG);
  int flashedSerial = p.getInt(KEY_SERIAL, -1);
  p.end();
  ESP_LOGI("APP", "initEEPROM: initialized=%d flashedSerial=%d", initialized, flashedSerial);

  if (!initialized)
  {
    if (!migrateFromEEPROM())
    {
      ESP_LOGI("APP", "Primer arranque — cargando valores por defecto");
      resetFlash();
      loaddefaultValues();
      // Restore serial written by flasher tool (resetFlash cleared it).
      if (flashedSerial >= 0)
      {
        Preferences p2;
        p2.begin(NS_CFG, false);
        p2.putInt(KEY_SERIAL, flashedSerial);
        p2.end();
        ESP_LOGI("APP", "Serial restaurado desde flasher: %d", flashedSerial);
      }
    }
  }
  else
  {
    ESP_LOGI("APP", "Cargando variables desde Preferences");
  }
  recapVariables();
}

void recapVariables()
{
  {
    Preferences p;
    p.begin(NS_CFG, true);
    in3.language = p.getUChar(KEY_LANG, defaultLanguage);
    in3.serialNumber = p.getInt(KEY_SERIAL, 0);
    in3.controlMode = p.getUChar(KEY_CTRL_MODE, CONTROL_AIR);
    in3.desiredControlTemperature = p.getFloat(KEY_CTRL_TEMP, presetTemp[CONTROL_AIR]);
    if (isnan(in3.desiredControlTemperature) ||
        in3.desiredControlTemperature < AIR_TEMPERATURE_SET_MIN ||
        in3.desiredControlTemperature > AIR_TEMPERATURE_SET_MAX)
      in3.desiredControlTemperature = presetTemp[CONTROL_AIR];
    in3.desiredControlHumidity = p.getUChar(KEY_CTRL_HUM, presetHumidity);
    logI("[BOOT][DEBUG] recapVariables: KEY_CTRL_TEMP as read from NVS -> desiredControlTemperature=" +
         String(in3.desiredControlTemperature) +
         " desiredControlHumidity=" + String(in3.desiredControlHumidity) +
         " (fallback defaults would be " + String(presetTemp[CONTROL_AIR]) +
         "/" + String(presetHumidity) + " - if these match, the setpoint was never persisted)");
    in3.fanPwrSupplyPWM = p.getInt(KEY_FAN_PWR_SUPPLY_PWM, FAN_PWR_SUPPLY_PWM);
    if (in3.fanPwrSupplyPWM <= 0 || in3.fanPwrSupplyPWM > 255)
      in3.fanPwrSupplyPWM = FAN_PWR_SUPPLY_PWM;
    in3.heaterMaxPowerAmps = p.getFloat(KEY_HEAT_MAX_A, HEATER_MAX_POWER_AMPS);
    if (isnan(in3.heaterMaxPowerAmps) || in3.heaterMaxPowerAmps <= 0)
      in3.heaterMaxPowerAmps = HEATER_MAX_POWER_AMPS;
    in3.skinTemperatureSetMax = p.getFloat(KEY_SKIN_T_MAX, SKIN_TEMPERATURE_SET_MAX);
    if (isnan(in3.skinTemperatureSetMax) || in3.skinTemperatureSetMax <= 0)
      in3.skinTemperatureSetMax = SKIN_TEMPERATURE_SET_MAX;
    // 201.15.4.2.1 bb): un valor persistido antes de que existiera este limite
    // (o corrupto) no debe superar el tope normativo al restaurarse.
    in3.skinTemperatureSetMax = alarm_clamp_skin_cutout(in3.skinTemperatureSetMax);
    in3.airTemperatureSetMax = p.getFloat(KEY_AIR_T_MAX, AIR_THERMAL_CUTOUT_DEFAULT_C);
    if (isnan(in3.airTemperatureSetMax) || in3.airTemperatureSetMax <= 0)
      in3.airTemperatureSetMax = AIR_THERMAL_CUTOUT_DEFAULT_C;
    // Idem para el corte por aire; el techo esta en shared/alarm_policy.h.
    in3.airTemperatureSetMax = alarm_clamp_air_cutout(in3.airTemperatureSetMax);
    // UNA UNIDAD YA INICIALIZADA NO HEREDA EL CORTE NUEVO. KEY_AIR_T_MAX se
    // escribe en la inicializacion de fabrica, asi que cualquier equipo que ya
    // haya arrancado con el firmware anterior lleva 38 guardado y se queda en
    // 38 aunque el compilado diga 40: lo de arriba lee NVS, que manda. Con la
    // consigna topada en 39 eso deja un equipo que NO puede alcanzar lo que se
    // le pide — al cruzar 38 salta el corte, que es ALTA y apaga el
    // calefactor. No se migra en silencio: subir un umbral de seguridad por
    // nuestra cuenta es justo lo que no se debe hacer, y ademas borraria un 38
    // puesto a proposito. Se avisa, y se corrige a mano con air_tmax en
    // /config (o por el enlace).
    //
    // Va por ESP_LOGW y no por logI() a proposito: logI esta detras de
    // LOG_INFORMATION, que es false, asi que se compilaria a nada. Un aviso
    // que no se ve no es un aviso.
    if (in3.airTemperatureSetMax < AIR_TEMPERATURE_SET_MAX) {
      ESP_LOGW("APP",
               "corte termico de aire a %.1f C, por debajo del tope de "
               "consigna (%.1f C): una consigna por encima del corte "
               "disparara ALARM_AIR_THERMAL_CUTOUT sin poder alcanzarse. "
               "Ajusta air_tmax a %.1f en /config.",
               in3.airTemperatureSetMax, (float)AIR_TEMPERATURE_SET_MAX,
               (float)AIR_THERMAL_CUTOUT_DEFAULT_C);
    }
    in3.fanCtlPWM = p.getInt(KEY_FAN_CTL_PWM, FAN_CTL_PWM_DEFAULT);
    if (in3.fanCtlPWM <= 0 || in3.fanCtlPWM > 255)
      in3.fanCtlPWM = FAN_CTL_PWM_DEFAULT;
    in3.fanHasSpeedFeedback = p.getUChar(KEY_FAN_RPM_FEEDBACK, 0);
    in3.fanPidEnabled = p.getUChar(KEY_FAN_PID_EN, FAN_PID_ENABLED_DEFAULT);
    p.end();
  }

  {
    Preferences p;
    p.begin(NS_CAL, true);
    RawTemperatureLow[SKIN_SENSOR] = p.getFloat(KEY_CAL_SK_LOW, 0.0f);
    RawTemperatureRange[SKIN_SENSOR] = p.getFloat(KEY_CAL_SK_RNG, 0.0f);
    ReferenceTemperatureRange = p.getFloat(KEY_CAL_REF_RNG, 0.0f);
    ReferenceTemperatureLow = p.getFloat(KEY_CAL_REF_LOW, 0.0f);
    in3.fineTuneSkinTemperature = p.getFloat(KEY_FT_SKIN, 0.0f);
    if (isnan(in3.fineTuneSkinTemperature))
      in3.fineTuneSkinTemperature = 0.0f;
    in3.fineTuneAirTemperature = p.getFloat(KEY_FT_AIR, 0.0f);
    if (isnan(in3.fineTuneAirTemperature))
      in3.fineTuneAirTemperature = 0.0f;
    p.end();
  }

  if (!ReferenceTemperatureRange)
  {
    in3.calibrationError = true;
    logE("[HW] -> Fail -> temperature sensor is not calibrated");
  }

  {
    Preferences p;
    p.begin(NS_RT, true);
    in3.standby_time = p.getFloat(KEY_RT_STANDBY, 0.0f);
    in3.control_active_time = p.getFloat(KEY_RT_CTRL, 0.0f);
    in3.heater_active_time = p.getFloat(KEY_RT_HEATER, 0.0f);
    in3.fan_active_time = p.getFloat(KEY_RT_FAN, 0.0f);
    in3.phototherapy_active_time = p.getFloat(KEY_RT_PHOTO, 0.0f);
    in3.humidifier_active_time = p.getFloat(KEY_RT_HUM, 0.0f);
    p.end();
  }

  {
    Preferences p;
    p.begin(NS_GPRS, true);
    in3.actuating_gprs_period = p.getInt(KEY_ACT_PERIOD, 60);
    in3.phototherapy_gprs_period = p.getInt(KEY_PHOTO_PERIOD, 180);
    in3.standby_gprs_period = p.getInt(KEY_STBY_PERIOD, 3600);
    p.end();
  }

  {
    Preferences p;
    p.begin(NS_WIFI, true);
    String s = p.getString(KEY_SSID, "");
    String pw = p.getString(KEY_PASSWORD, "");
    strncpy(wifi_ssid, s.c_str(), sizeof(wifi_ssid) - 1);
    wifi_ssid[sizeof(wifi_ssid) - 1] = '\0';
    strncpy(wifi_pass, pw.c_str(), sizeof(wifi_pass) - 1);
    wifi_pass[sizeof(wifi_pass) - 1] = '\0';
    p.end();
  }

  {
    Preferences p;
    p.begin(NS_STATE, true);
    in3.actuation = p.getUChar(KEY_ACTUATION, 0);
    in3.phototherapy = p.getUChar(KEY_PHOTO_ACTIVE, 0);
    // Semilla de intensidad. La escribe actuatorsTest() cuando extrapola un PWM
    // para la corriente objetivo, y se relee aqui porque en un arranque con
    // restoreState ese autotest NO corre: sin esto la lampara arrancaba en el
    // 40 % fijo de PHOTOTHERAPY_INITIAL_PWM_PCT, que no apunta a ningun
    // objetivo y da una corriente distinta en cada unidad.
    const uint8_t photoPwmGuardado = p.getUChar(KEY_PHOTO_PWM, 0);
    // Solo vale si se calibro para el objetivo ACTUAL. Una semilla de otro
    // objetivo (o una sin objetivo, escrita por 18.43/18.44) se ignora y se
    // cae al camino normal: extrapolacion del autotest o 40 % fijo.
    const uint16_t objetivoGuardado = p.getUShort(KEY_PHOTO_PWM_TGT, 0);
    const uint16_t objetivoActual =
        (uint16_t)(PHOTO_TARGET_CURRENT * 1000.0f + 0.5f);
    if (photoPwmGuardado > 0 && objetivoGuardado != objetivoActual) {
      ESP_LOGW("APP", "[BOOT] semilla de fototerapia descartada: calibrada "
               "para %u mA, objetivo actual %u mA",
               (unsigned)objetivoGuardado, (unsigned)objetivoActual);
    }
    if (photoPwmGuardado > 0 && objetivoGuardado == objetivoActual) {
      in3.phototherapy_intensity = photoPwmGuardado;
      in3.photoFirstRun = false;   // ya hay semilla buena: no usar el 40 % fijo
    }
    // restoreState ya viene resuelto por security_check_reboot_cause()
    // (initHardware.cpp), que corre antes que initEEPROM() en setup(): se
    // recupera en todo reinicio salvo POWERON y BROWNOUT.
    p.end();
  }

  // En un arranque que NO es recuperacion (encendido normal o brownout) la
  // fototerapia no se reanuda, igual que no se reanuda el control de
  // temperatura: in3.actuation se lee siempre pero solo se APLICA bajo
  // restoreState, unas lineas mas abajo. in3.phototherapy no tenia ese filtro
  // y si se aplicaba siempre, en initHardware.cpp:
  //
  //     if (in3.phototherapy) { ...; ledcWrite(PHOTOTHERAPY_PWM_CHANNEL, ...) }
  //
  // Consecuencia observada en banco: apagas la unidad con la fototerapia
  // puesta, la enciendes en frio, el autotest prueba la lampara al 10 % de PWM
  // --correcto-- y justo despues esa linea la encendia a la intensidad de
  // trabajo (40 %, o hasta 255 si photoFirstRun ya era falso), es decir MAS
  // intensidad que el test, hasta que ~1 s despues llegaba el primer mandato
  // del HMI con photo=0 y la apagaba. Un destello de irradiacion que nadie ha
  // mandado, en cada encendido en frio posterior a una sesion.
  //
  // Intermitente a proposito de nadie: solo ocurre si se apago con la
  // fototerapia encendida.
  //
  // Ademas dejaba a las dos placas discrepando justo en lo que
  // security_check_reboot_cause() dice que se unifico: el HMI usa la misma
  // regla (g_hmiRestoreState) y por eso el que mandaba photo=0 era el.
  if (!in3.restoreState && in3.phototherapy) {
    ESP_LOGW("APP", "[BOOT] arranque en frio: no se reanuda la fototerapia");
    in3.phototherapy = false;
  }

  // Restore phototherapy timer if it was active
  if (in3.phototherapy)
  {
    Preferences p;
    p.begin("photo", true);
    bool was_active = p.getBool("active", false);
    int saved_mins = p.getInt("mins", 0);
    p.end();
    if (was_active && saved_mins > 0)
    {
      g_restore_photo_minutes = saved_mins;
      logI("[HW] -> restoreState: phototherapy timer restored (" + String(saved_mins) + " min remaining)");
    }
  }

  // Process actuation mode (restore temperature/humidity control state)
  //
  // ESP_LOGW, no logI(): esta y la de abajo son las dos lineas que dicen si un
  // equipo que acaba de reiniciarse vuelve controlando o vuelve parado, y con
  // LOG_INFORMATION a false (main.h) logI() no compila nada. Sin ellas, tras
  // un crash en banco no hay forma de saber si la recuperacion ocurrio: lo
  // unico observable es el comportamiento del equipo, que es justo lo que se
  // esta intentando explicar.
  ESP_LOGW("APP", "[BOOT] recap: restoreState=%d actuation=%d controlMode=%d",
           (int)in3.restoreState, (int)in3.actuation, (int)in3.controlMode);
  if (in3.restoreState)
  {
    switch (in3.actuation)
    {
    case ACTUATION_TEMPERATURE:
      in3.temperatureControl = true;
      in3.humidityControl = false;
      break;
    case ACTUATION_HUMIDITY:
      in3.temperatureControl = false;
      in3.humidityControl = true;
      break;
    case ACTUATION_TEMP_AND_HUMIDITY:
      in3.temperatureControl = true;
      in3.humidityControl = true;
      break;
    default:
      in3.temperatureControl = false;
      in3.humidityControl = false;
      break;
    }
    ESP_LOGW("APP",
             "[BOOT] recap: recuperado -> temperatureControl=%d humidityControl=%d",
             (int)in3.temperatureControl, (int)in3.humidityControl);
  }

  ESP_LOGI("APP", "Serial: %d, Lang: %d", in3.serialNumber, in3.language);
}
