medicalopenworld/IncuNest/Firmware/Display_HMI/src/tasks/UITask.cpp

#include "UITask.h"
// #include "AudioManager.h"  // Deshabilitado para migración Arduino 3.x
#include "CommTask.h"
#include "state/training_mode.h"
#include "buzzer.h"
#include "ui/AlarmCenter.h"
#include "ui/FactoryTest.h"
#include "ui/TelemetryHistory.h"
#include "ui/BabyHistory.h"
#include "ui/BabyExitDialog.h"
#include "ui/TimeDialog.h"
#include "ui/HelpDialog.h"
#include "ui/training/training.h"
#include "ui/training/training_progress.h"
#include "ui/MaintenanceDialog.h"
#include "ui/BabyWizard.h"
#include "modules/maintenance/maintenance.h"
#include "display_config.h"
#include "esp_lcd_panel_ops.h"
#include "esp_lcd_panel_rgb.h"
#include "esp_log.h"
// alarm_priority(): la prioridad del banner sale de la misma tabla de shared/
// que usa la motherboard, no de una copia local.
#include "alarm_policy.h"
// Y el RITMO de la senal acustica sale del mismo sitio, por lo mismo: los dos
// zumbadores del equipo tienen que emitir el patron identico.
#include "alarm_audio_pattern.h"
#include "main.h"
#include "ui.h"
#include <PCA9557.h>
#include <SPI.h>
#include <TAMC_GT911.h>

static const char *TAG = "UI";

// Test de fabrica HMI_I2C (shared-factory-test-bench2 D4): guardan si el
// init del touch (con reintentos) y la secuencia de backlight (5 reintentos)
// tuvieron exito en UI_Task(). UI_TouchInitOk()/UI_BacklightInitOk() los
// exponen; el sondeo de direcciones I2C queda solo informativo.
static bool s_touchInitOk = false;
static bool s_backlightInitOk = false;

SemaphoreHandle_t g_lvgl_mutex = NULL;

void LVGL_Mutex_Init(void) {
  if (!g_lvgl_mutex) {
    g_lvgl_mutex = xSemaphoreCreateRecursiveMutex();
  }
}

// --- Skin probe UI (RF-SKIN-008/009/010, UI-SKIN-002/003/004) ---
// Also the generic toast surface for the whole UI — see UI_ShowToast().
static lv_obj_t *ui_SkinProbeToast =
    nullptr; // Toast de bloqueo cuando sonda no válida

// --- Power-off popup UI elements ---
static lv_obj_t *ui_PwrOffOverlay = nullptr;
static lv_obj_t *ui_PwrOffArc = nullptr;
static lv_obj_t *ui_PwrOffSymbol = nullptr;
static bool pwrOffPopupVisible = false;

static lv_obj_t *ui_AudioPlayBtn;
static lv_obj_t *ui_AudioStopBtn;
static lv_obj_t *ui_AudioPlayLabel;
static lv_obj_t *ui_VolumeLabel; // Muestra "Vol: XX"
static lv_obj_t *ui_VolumeUpBtn;
static lv_obj_t *ui_VolumeDownBtn;

// Novedades para Gráficas Históricas (Declaradas en ElementsCreation.cpp)

// Series de datos (Se definen aquí para ser usadas por UITask)


// ==========================================
// Globals
// ==========================================
double airTempValue, skinTempValue;
volatile double airTempValueDetected = 0.00, skinTempValueDetected = 0.00;
int humValue;
volatile int humValueDetected = 0;
int selectedPanel = NO_PANEL_SELECTED;
int lastSelectedPanel = NO_PANEL_SELECTED;
bool skinPanelEnabled = false;
bool switchTemp = false;
bool switchHum = false;
bool tempSwitched = false;
bool humSwitched = false;
bool arrowsActive = false;
bool darkMode = false;
bool humidityEnabled = false;
int g_selectedAlarmId = -1;
volatile bool g_pendingAlarmUpdate = false;

bool alarmActive = false;
bool alarmsMuted = false;
// Hasta este instante, CTRL,STATE no puede revertir alarmsMuted. Cubre el
// viaje de ida y vuelta del comando de silencio (ver CommTask.cpp).
uint32_t g_muteHoldUntilMs = 0;
#define MUTE_HOLD_MS 2000u

bool prevTempAlarm = false;
bool prevHumAlarm = false;
int alarmSlotToIndex[MAX_ALARM_DISPLAY] = {-1, -1, -1, -1};

int chartLastPressed = -1;

bool wifiVisible = false;
bool isConnected = false;
static bool pendingReconnect = false;
static uint32_t disconnectTimestampMs = 0;
char wifi_ssid[64] = "";
char wifi_pass[64] = "";

bool LanguagesVisible = false;
bool locked = true;

static bool spo2ProbeAttached = false;

lv_chart_series_t *airTempSeries = NULL;
lv_chart_series_t *skinTempSeries = NULL;
lv_chart_series_t *humSeries = NULL;
lv_chart_series_t *lockPPGSeries = NULL;

bool g_stateSynced = false;
uint32_t g_lastStateReqMs = 0;
bool g_ui_initialized = false;

static bool eepromDirty = false;
static unsigned long lastVarChangeTime = 0;


// Phototherapy Timer
int photoTimerMinutes = PHOTO_TIMER_DEFAULT_MINUTES;
bool photoTimerActive = false;
unsigned long photoTimerStartMs = 0;
static bool g_photo_safety_confirmed = false;
// Same one-shot gate pattern as g_photo_safety_confirmed, for the baby-data
// wizard that now precedes phototherapy activation: the wizard re-triggers
// the switch when it finishes, and this flag lets that second pass through.
static bool g_photo_wizard_done = false;
// Same one-shot gate, for the baby-data wizard that now precedes humidity
// activation. Humidity hours are accounted per baby, so the profile has to be
// known before the humidifier starts.
static bool g_hum_wizard_done = false;
static int lastPhotoMinutesSent = -1;

Alarm alarmList[MAX_ALARMS];

// ==========================================
// esp_lcd RGB Panel (bounce buffers anti-flicker)
// ==========================================
static esp_lcd_panel_handle_t lcd_panel = NULL;

// Bounce buffer: N líneas en SRAM interno desacoplan LCD DMA de PSRAM.
// N=24 (divisor exacto de las 480 líneas del panel, evita wraps parciales)
// amplía el margen de "drenaje" frente a jitter de CPU/bus (p.ej. tráfico
// WiFi) sin comprometer el heap interno — medido con WiFi conectado:
// heap_int_min=87980 B (ver log [DIAG]); el salto de 20→24 líneas cuesta
// ~12.8 KB adicionales, dejando margen holgado para picos de TLS/mbedTLS.
// NO cubre stalls largos (borrado de sector NVS, hasta ~30 ms, ver comentario
// en UITask.cpp:doNVSWrite) — eso se ataca con WiFi.persistent(false)
// (Wifi_OTA.cpp) y CONFIG_SPIRAM_FETCH_INSTRUCTIONS/RODATA (platformio.ini).
// 800 * 24 * 2 = 38.4KB por bounce buffer (x2 ping-pong = ~76.8KB SRAM)
#define BOUNCE_BUF_LINES 24
#define BOUNCE_BUF_SIZE_PX (DISPLAY_WIDTH * BOUNCE_BUF_LINES)

// ==========================================
// LCD Glitch diagnostics
// ==========================================
// Frame interval > este umbral se considera frame lento (glitch potencial)
#define LCD_VSYNC_SLOW_THRESHOLD_US 25000 // 25 ms → <40 fps

// Lineas de bounce buffer con las que se logro crear el panel: puede ser
// menor que BOUNCE_BUF_LINES si no habia SRAM interna contigua (ver la
// escalera de reintentos en UI_Task).
static int g_lcd_bounce_lines = 0;

// true en cuanto los bounce buffers estan reservados. setup() espera a esta
// senal antes de arrancar WiFi para que el panel coja SRAM interna sin
// fragmentar; ver UI_IsLcdPanelReady() y main.cpp.
static volatile bool s_lcdPanelReady = false;

static volatile uint32_t g_lcd_bounce_empty_count = 0; // underruns DMA (solo aplica con num_fbs=0; con num_fbs=1 este callback no se invoca — ver g_lcd_bounce_frame_finish_count)
static volatile uint32_t g_lcd_vsync_slow_count = 0;   // frames lentos
static volatile uint32_t g_lcd_vsync_total = 0;        // frames totales
static volatile uint32_t g_lcd_bounce_frame_finish_count = 0; // ciclos de bounce buffer completados
static volatile int64_t g_lcd_last_vsync_us = 0;
static volatile int64_t g_lcd_worst_frame_us = 0; // peor intervalo visto

static bool IRAM_ATTR lcd_on_bounce_empty(esp_lcd_panel_handle_t panel,
                                          void *bounce_buf, int pos_px,
                                          int len_bytes, void *user_ctx) {
  g_lcd_bounce_empty_count++;
  return false;
}

// Con num_fbs=1 el driver rellena el bounce buffer por memcpy (no llama a
// on_bounce_empty). Este callback SÍ se invoca una vez por cada ciclo
// completo de bounce buffer (~1 por frame). Si el DMA se reinicia por un
// underrun (desync de un frame, ver esp_lcd_panel_rgb.c:
// lcd_rgb_panel_try_restart_transmission), ocurre dentro del vblank y no
// altera el intervalo entre vsyncs — por eso este contador es la única señal
// disponible sin parchear el driver vendored.
static bool IRAM_ATTR lcd_on_bounce_frame_finish(esp_lcd_panel_handle_t panel,
                                                 const esp_lcd_rgb_panel_event_data_t *edata,
                                                 void *user_ctx) {
  g_lcd_bounce_frame_finish_count++;
  return false;
}

static bool IRAM_ATTR lcd_on_vsync(esp_lcd_panel_handle_t panel,
                                   const esp_lcd_rgb_panel_event_data_t *edata,
                                   void *user_ctx) {
  int64_t now = esp_timer_get_time();
  if (g_lcd_last_vsync_us > 0) {
    int64_t delta = now - g_lcd_last_vsync_us;
    if (delta > g_lcd_worst_frame_us)
      g_lcd_worst_frame_us = delta;
    if (delta > LCD_VSYNC_SLOW_THRESHOLD_US)
      g_lcd_vsync_slow_count++;
  }
  g_lcd_last_vsync_us = now;
  g_lcd_vsync_total++;
  return false;
}

// Llamar periódicamente desde una tarea para volcar diagnóstico al log
void lcd_diagnostics_log() {
  uint32_t underruns = g_lcd_bounce_empty_count;
  uint32_t slow_frames = g_lcd_vsync_slow_count;
  uint32_t total = g_lcd_vsync_total;
  uint32_t frame_finish = g_lcd_bounce_frame_finish_count;
  int64_t worst_us = g_lcd_worst_frame_us;

  // Reset contadores después de leer
  g_lcd_bounce_empty_count = 0;
  g_lcd_vsync_slow_count = 0;
  g_lcd_vsync_total = 0;
  g_lcd_bounce_frame_finish_count = 0;
  g_lcd_worst_frame_us = 0;

  float fps = (worst_us > 0) ? (1000000.0f / worst_us) : 0.0f;

  // frame_finish debería igualar total (±1-2 por skew de lectura no atómica
  // entre ISR y esta función) en régimen normal. Una desviación mayor indica
  // ciclos de bounce buffer re-arrancados por underrun — el modo de fallo
  // que "underruns"/"slow_frames" NO detectan con num_fbs=1. Tolerancia=2
  // es una calibración inicial: si en campo aparecen falsos positivos
  // frecuentes con mismatch=2 y sin glitch visible reportado, subirla a 3.
  int32_t frame_mismatch = (int32_t)total - (int32_t)frame_finish;
  if (frame_mismatch < 0) frame_mismatch = -frame_mismatch;

  if (underruns > 0 || slow_frames > 0 || frame_mismatch > 2) {
    ESP_LOGW("LCD_DIAG",
             "GLITCH DETECTED — underruns=%lu  slow_frames=%lu/%lu  "
             "frame_finish=%lu (mismatch=%ld)  worst_frame=%.1fms (%.1f fps)",
             underruns, slow_frames, total, frame_finish, (long)frame_mismatch,
             worst_us / 1000.0f, fps);
  } else {
    // Bench-debug: imprime siempre para ver contención sub-umbral (worst_frame
    // por debajo de 25ms) que "GLITCH DETECTED" no reporta. Correlar con
    // glitches vistos a simple vista sin evento de WiFi/flash en el log.
    ESP_LOGI("LCD_DIAG", "ok — frames=%lu  worst_frame=%.2fms (%.1f fps)",
             total, worst_us / 1000.0f, fps);
  }
}

static uint32_t g_currentFreqWrite = DISPLAY_FREQ_WRITE;

uint32_t lcd_get_freq_write() { return g_currentFreqWrite; }

void lcd_set_freq_write(uint32_t freq_hz) {
  g_currentFreqWrite = freq_hz;
  { Preferences p; p.begin(HMI_NS_CFG, false); p.putUInt(HMI_KEY_DISP_FREQ, freq_hz); p.end(); }
  ESP_LOGW("LCD", "freq_write saved: %lu Hz — restarting...", freq_hz);
  delay(200);
  ESP.restart();
}

// Touch GT911 — pines y resolución desde display_config.h
TAMC_GT911 ts =
    TAMC_GT911(DISPLAY_TOUCH_SDA, DISPLAY_TOUCH_SCL, DISPLAY_TOUCH_INT,
               DISPLAY_TOUCH_RST, DISPLAY_WIDTH, DISPLAY_HEIGHT);

static uint32_t screenWidth;
static uint32_t screenHeight;
static lv_disp_draw_buf_t draw_buf;
static lv_color_t disp_draw_buf[DISPLAY_WIDTH * DISPLAY_HEIGHT / COLOR_DIVISOR];
static lv_disp_drv_t disp_drv;
static lv_timer_t *intro_timer = NULL;
static uint32_t intro_start_ms = 0;

// ==========================================
// Definitions
// ==========================================
void my_disp_flush(lv_disp_drv_t *disp, const lv_area_t *area,
                   lv_color_t *color_p) {
  int offsetx1 = area->x1;
  int offsetx2 = area->x2;
  int offsety1 = area->y1;
  int offsety2 = area->y2;
  esp_lcd_panel_draw_bitmap(lcd_panel, offsetx1, offsety1, offsetx2 + 1,
                            offsety2 + 1, color_p);
  lv_disp_flush_ready(disp);
}

static void intro_timer_cb(lv_timer_t *t) {
  uint32_t elapsed = millis() - intro_start_ms;
  bool synced      = g_stateSynced;
  bool min_elapsed = (elapsed >= 5000);
  bool timedout    = (elapsed >= 15000);
  if (!timedout && (!synced || !min_elapsed)) return;
  if (intro_timer) {
    lv_timer_del(intro_timer);
    intro_timer = NULL;
  }
  lv_scr_load(ui_ScreenMain);
  if (!synced)
    ESP_LOGW(TAG, "Intro: no state sync after 10s — proceeding anyway");
}

void my_touchpad_read(lv_indev_drv_t *indev_driver, lv_indev_data_t *data) {
  static uint16_t lastX = 0, lastY = 0;
  static uint8_t releaseCount = 0;
  // GT911 clears its buffer after each I2C read, causing phantom releases when
  // LVGL reads faster than the controller updates. Require 3 consecutive
  // "not touched" frames (~30ms at 10ms/frame) before reporting RELEASED.
  const uint8_t DEBOUNCE_FRAMES = 3;

  ts.read();
  if (ts.isTouched) {
    releaseCount = 0;
    lastX = ts.points[0].x;
    lastY = ts.points[0].y;
    data->state = LV_INDEV_STATE_PR;
    data->point.x = lastX;
    data->point.y = lastY;
  } else {
    if (releaseCount < DEBOUNCE_FRAMES) {
      releaseCount++;
      data->state = LV_INDEV_STATE_PR;
      data->point.x = lastX;
      data->point.y = lastY;
    } else {
      data->state = LV_INDEV_STATE_REL;
    }
  }
}

// Forward declarations
void set_active_panel(lv_obj_t *active, lv_obj_t *inactive);
void temp_chart_show_for_selected_panel(void);
void ui_set_switch_state_silent(lv_obj_t *sw, bool on);
void computeAndSendActuation(void);
void ActivateTempControlUI(bool isAirMode);

// Fully disables Skin mode — same effect as flipping the Skin switch OFF.
// Call this both from the switch-OFF handler and from the probe-disconnect
// path.
void UI_UpdatePowerBars(int tempPwm, int humPwm) {
  if (ui_AirPowerBar)  lv_bar_set_value(ui_AirPowerBar,  tempPwm, LV_ANIM_ON);
  if (ui_SkinPowerBar) lv_bar_set_value(ui_SkinPowerBar, tempPwm, LV_ANIM_ON);
  if (ui_HumPowerBar)  lv_bar_set_value(ui_HumPowerBar,  humPwm,  LV_ANIM_ON);
}

static void skin_mode_force_off() {
  // Uncheck the switch FIRST — line 3219 re-reads skinPanelEnabled from it
  // every cycle, so leaving it checked would immediately undo everything else.
  ui_set_switch_state_silent(ui_Switch4, false);

  skinPanelEnabled = false;
  hmi_msg.skinModeEnabled = false;
  hmi_msg.shouldSendData = true;

  if (ui_SkinPanelCont)
    lv_obj_add_flag(ui_SkinPanelCont, LV_OBJ_FLAG_HIDDEN);
  lastSelectedPanel = AIR_PANEL_SELECTED;
  if (ui_AirTempBarCont)
    lv_obj_clear_flag(ui_AirTempBarCont, LV_OBJ_FLAG_HIDDEN);

  if (selectedPanel == SKIN_PANEL_SELECTED) {
    selectedPanel = AIR_PANEL_SELECTED;
    lastSelectedPanel = selectedPanel;

    set_active_panel(ui_AirPanel, ui_SkinPanel);

    if (ui_AirTempBarCont)
      lv_obj_clear_flag(ui_AirTempBarCont, LV_OBJ_FLAG_HIDDEN);
    if (ui_SkinTempBarCont)
      lv_obj_add_flag(ui_SkinTempBarCont, LV_OBJ_FLAG_HIDDEN);
    if (ui_AirTempLockCont)
      lv_obj_clear_flag(ui_AirTempLockCont, LV_OBJ_FLAG_HIDDEN);
    if (ui_TargetAirTempCont)
      lv_obj_clear_flag(ui_TargetAirTempCont, LV_OBJ_FLAG_HIDDEN);
    if (ui_SkinTempLockCont)
      lv_obj_add_flag(ui_SkinTempLockCont, LV_OBJ_FLAG_HIDDEN);
    if (ui_TargetSkinTempCont)
      lv_obj_add_flag(ui_TargetSkinTempCont, LV_OBJ_FLAG_HIDDEN);

    if (tempSwitched) {
      hmi_msg.controlMode = CONTROL_AIR;
      temp_chart_show_for_selected_panel();
    }
  }
}

// Ultimo valor pintado de cada MEDIDA. A nivel de fichero y no dentro de
// update_labels() porque link_lost_blank_update() tiene que invalidarlos: al
// recuperar el enlace, la primera lectura debe volver a pintarse aunque
// coincida con la ultima buena, o los "--" se quedarian puestos.
static double l_airDet = -1.0, l_skinDet = -1.0;
static int l_humDet = -1;

// Borra las MEDIDAS mientras la placa este callada, y las barras con ellas.
//
// Es la parte de seguridad del asunto: una cifra congelada no se ve
// congelada. El operador lee 36,5 °C y entiende que el bebe esta a 36,5 °C
// AHORA, cuando es lo ultimo que llego antes de caerse el enlace. Un "--" no
// se puede malinterpretar.
//
// Las CONSIGNAS no se tocan: son lo que el operador pidio, no una medida, y
// siguen siendo ciertas. Lo que ha dejado de saberse es si se cumplen.
//
// Corre en CADA pasada del bucle de UI, no desde update_labels(): a esa solo
// se la llama cuando llega telemetria, que es exactamente lo que deja de
// pasar cuando el enlace cae.
// Reloj de pared de la cabecera.
//
// La cadena se recalcula en cada pasada pero SOLO se escribe cuando cambia:
// repintar dos labels a 20 Hz para que cambien una vez por minuto es trabajo
// tirado, y el repintado innecesario ya dio problemas de fluidez aqui.
//
// "Sin hora" solo cuando no hay ni epoch: sin eso no hay nada que pintar. Con
// epoch pero sin zona resuelta se pinta igual, sin aplicar offset (el epoch
// tal cual, probablemente UTC) — mismo criterio que ya usan AlarmCenter.cpp y
// BabyHistory.cpp (HMI_HasLocalTime() ? HMI_ToLocal(epoch) : epoch). Decision
// de producto 2026-09-02: una hora aproximada es mas util que ninguna, y el
// operador la corrige a mano si hace falta (tocar el reloj -> Adjust Time).
void clock_update(void) {
  if (!ui_ClockTime || !ui_ClockDate) return;

  // El buffer de la hora aloja dos cosas distintas: "HH:MM" cuando hay reloj y
  // el texto de STR_NO_TIME cuando no lo hay. Se dimensiona por el mayor de
  // los dos, y del segundo manda el catalogo — estaba fijado en 8 bytes,
  // medido solo para "HH:MM", y por eso "Sin hora" salia como "Sin hor".
  static constexpr size_t kTimeBuf = UI_StrBufBytes(STR_NO_TIME) > sizeof("HH:MM")
                                         ? UI_StrBufBytes(STR_NO_TIME)
                                         : sizeof("HH:MM");
  static char lastTime[kTimeBuf] = {0};
  static char lastDate[12] = {0};
  char nowTime[kTimeBuf];
  char nowDate[12];

  const uint32_t epochNow = HMI_GetEpochNow();
  if (epochNow == 0) {
    snprintf(nowTime, sizeof(nowTime), "%s", TR(STR_NO_TIME));
    nowDate[0] = '\0';
  } else {
    const time_t t =
        (time_t)(HMI_HasLocalTime() ? HMI_ToLocal(epochNow) : epochNow);
    struct tm tmv;
    gmtime_r(&t, &tmv);
    snprintf(nowTime, sizeof(nowTime), "%02d:%02d", tmv.tm_hour, tmv.tm_min);
    snprintf(nowDate, sizeof(nowDate), "%02d/%02d/%04d", tmv.tm_mday,
             tmv.tm_mon + 1, tmv.tm_year + 1900);
  }

  if (strcmp(nowTime, lastTime) != 0) {
    strncpy(lastTime, nowTime, sizeof(lastTime) - 1);
    lastTime[sizeof(lastTime) - 1] = '\0';
    lv_label_set_text(ui_ClockTime, nowTime);
    // Replica del reloj en el heading de ui_ScreenLock (ver "mantener
    // IncuNest/reloj/conectividad en la pantalla de bloqueo").
    if (ui_LockHeadingClockTime) lv_label_set_text(ui_LockHeadingClockTime, nowTime);
  }
  if (strcmp(nowDate, lastDate) != 0) {
    strncpy(lastDate, nowDate, sizeof(lastDate) - 1);
    lastDate[sizeof(lastDate) - 1] = '\0';
    lv_label_set_text(ui_ClockDate, nowDate);
    if (ui_LockHeadingClockDate) lv_label_set_text(ui_LockHeadingClockDate, nowDate);
  }
}

static char s_lastMbStatus[80] = {0};
static char s_lastHmiStatus[80] = {0};

// Los dos enlaces de la maquina, encima de SSID en la pantalla de WiFi.
//
// MB: es la motherBoard, la unica que sube telemetria a ThingsBoard
// (serverCommStatus, que llega en CTRL,STATE). DISPLAY: es el radio del
// propio HMI, que solo sirve para su OTA; conectado muestra el SSID, que es
// lo que decia la fila "WIFI CONECTADO A ..." que este par sustituye.
//
// Antes solo se veia el del display, y el de la placa era un "Placa: ..."
// suelto en una esquina: se podia leer "conectado" mientras el equipo no
// mandaba un solo dato. Juntos y con las mismas palabras no se confunden.
//
// Se refrescan solo con la pantalla visible, y solo escriben cuando cambian:
// el cache de lo ultimo escrito es s_lastMbStatus/s_lastHmiStatus.
static void wifi_link_status_update(void) {
  if (!wifiVisible) return;

  // Verde solo con servidor: tener WiFi pero no llegar a ThingsBoard es
  // exactamente el caso que esta pantalla tenia que dejar de ocultar.
  static const lv_color_t COLOR_UP = lv_color_hex(0x2E9E4F);
  static const lv_color_t COLOR_DOWN = lv_color_hex(0xCC7A00);

  if (ui_WifiBoardStatus) {
    char now[80];
    snprintf(now, sizeof(now), "MB: %s",
             getConnectivityString(ctrl_state_msg.serverCommStatus, g_lang));

    if (strcmp(now, s_lastMbStatus) != 0) {
      strncpy(s_lastMbStatus, now, sizeof(s_lastMbStatus) - 1);
      s_lastMbStatus[sizeof(s_lastMbStatus) - 1] = '\0';
      lv_label_set_text(ui_WifiBoardStatus, now);

      const bool onServer =
          (ctrl_state_msg.serverCommStatus == COMM_STATUS_WIFI_SERVER ||
           ctrl_state_msg.serverCommStatus == COMM_STATUS_GPRS_SERVER);
      lv_obj_set_style_text_color(ui_WifiBoardStatus,
                                  onServer ? COLOR_UP : COLOR_DOWN,
                                  LV_PART_MAIN);
    }
  }

  if (ui_WifiHmiStatus) {
    // El SSID puede tener hasta 32 caracteres; el label esta en LONG_DOT, asi
    // que si no cabe se corta con puntos suspensivos en vez de invadir el
    // boton de conectar que tiene al lado.
    const bool linkUp = (WiFi.status() == WL_CONNECTED);
    char now[80];
    snprintf(now, sizeof(now), "DISPLAY: %s",
             linkUp ? WiFi.SSID().c_str() : TR(STR_CONN_DISCONNECTED));

    if (strcmp(now, s_lastHmiStatus) != 0) {
      strncpy(s_lastHmiStatus, now, sizeof(s_lastHmiStatus) - 1);
      s_lastHmiStatus[sizeof(s_lastHmiStatus) - 1] = '\0';
      lv_label_set_text(ui_WifiHmiStatus, now);
      lv_obj_set_style_text_color(ui_WifiHmiStatus,
                                  linkUp ? COLOR_UP : COLOR_DOWN,
                                  LV_PART_MAIN);
    }
  }
}

// El repintado global de labels del modo oscuro deja estos dos en negro, y el
// cache de "no ha cambiado nada" impediria devolverles su color. Se llama
// desde ahi para que la siguiente pasada los vuelva a escribir.
static void wifi_link_status_invalidate(void) {
  s_lastMbStatus[0] = '\0';
  s_lastHmiStatus[0] = '\0';
}

// Aplica el estado de conectividad a UNA instancia del indicador (icono +
// 4 barras). Factorizado para que ui_ScreenMain y su replica en
// ui_ScreenLock (ver "mantener IncuNest/reloj/conectividad en la pantalla de
// bloqueo") pinten exactamente igual sin duplicar la logica. `lastSignature`
// es el cache de "no cambio nada desde la ultima pasada" de ESA instancia:
// cada llamador pasa su propia estatica, para que la primera pintura de una
// instancia no se salte solo porque la otra ya estaba al dia.
//
// `onDarkBg` es lo UNICO que cambia entre las dos instancias: ui_ScreenLock
// tiene fondo 0x242323, donde el negro del caso "sin servidor" no se lee, asi
// que ahi el acromatico es blanco en vez de negro (el verde de "hay servidor"
// no cambia: se lee igual sobre los dos fondos).
//
// EL INDICADOR ENTERO VA DE UN SOLO COLOR: el texto de arriba (el simbolo
// WIFI, "2G" o la X) y las barras llenas de abajo son UNA pieza visual, no
// dos, y pintarlas de colores distintos las hacia parecer dos cosas sin
// relacion. Un solo tono, el del estado, para todo.
static void apply_connectivity_indicator(lv_obj_t *icon, lv_obj_t *bars[4],
                                          int status, int linkBars,
                                          bool onDarkBg, int *lastSignature) {
  if (!icon) return;

  const int signature = status * 100 + (linkBars + 1);
  if (signature == *lastSignature) return;
  *lastSignature = signature;

  const bool onServer =
      (status == COMM_STATUS_WIFI_SERVER || status == COMM_STATUS_GPRS_SERVER);
  const bool hasTransport = (status != COMM_STATUS_NONE);

  // Verde (0x2E9E4F) SOLO cuando la placa esta hablando con ThingsBoard, y da
  // igual por que transporte: WIFI_SERVER y GPRS_SERVER pintan los dos verde.
  // Sin servidor el indicador se queda acromatico — negro sobre fondo claro,
  // blanco sobre el oscuro del bloqueo — y sin transporte ni dato fresco, un
  // gris apagado (que en el bloqueo tambien sube a blanco: ahi el gris se
  // hunde en el fondo).
  //
  // Antes el caso bueno era el azul de marca 0x0075EE, y sobre 0x242323 no se
  // leia: el indicador se ve mucho mas rato bloqueado que desbloqueado, asi
  // que el color del caso bueno lo manda esa pantalla. El verde es ademas el
  // mismo 0x2E9E4F que ya usa "MB: ..." en Ajustes/WiFi
  // (wifi_link_status_update) para decir exactamente esto — hay servidor —,
  // con lo que las dos lecturas de "sube telemetria" del HMI quedan en el
  // mismo tono.
  const lv_color_t achromatic =
      onDarkBg ? lv_color_hex(0xFFFFFF) : lv_color_hex(0x000000);
  const lv_color_t color = onServer ? lv_color_hex(0x2E9E4F)
                            : !hasTransport
                                ? (onDarkBg ? lv_color_hex(0xFFFFFF)
                                            : lv_color_hex(0x888888))
                                : achromatic;

  const char *iconTxt;
  switch (status) {
  case COMM_STATUS_WIFI_ONLY:
  case COMM_STATUS_WIFI_SERVER:
    iconTxt = LV_SYMBOL_WIFI;
    break;
  case COMM_STATUS_GPRS_ONLY:
  case COMM_STATUS_GPRS_SERVER:
    iconTxt = "2G";
    break;
  default:
    iconTxt = LV_SYMBOL_CLOSE;
    break;
  }
  lv_label_set_text(icon, iconTxt);
  lv_obj_set_style_text_color(icon, color, LV_PART_MAIN);

  // Sin transporte no hay cobertura que mostrar; con transporte pero sin dato
  // fiable (linkBars<0: placa antigua o lectura de RSSI/CSQ aun no llegada)
  // se pintan las 4 en gris, nunca se inventa un nivel.
  const int fillCount =
      (!hasTransport) ? 0 : (linkBars < 0) ? 0 : (linkBars > 4 ? 4 : linkBars);
  for (int i = 0; i < 4; i++) {
    if (!bars[i]) continue;
    if (!hasTransport) {
      lv_obj_add_flag(bars[i], LV_OBJ_FLAG_HIDDEN);
      continue;
    }
    lv_obj_clear_flag(bars[i], LV_OBJ_FLAG_HIDDEN);
    // Las llenas SIEMPRE con el color de estado, el mismo que el texto de
    // arriba (ver la cabecera de la funcion): el indicador se lee de una
    // pieza, verde entero con ThingsBoard.
    //
    // Lo unico que depende del fondo son las vacias. Sobre fondo claro, gris
    // CLARO y no oscuro: con el indicador acromatico las llenas son negras y
    // un vacio 0x404040 era casi el mismo tono, con lo que no se distinguia
    // el nivel. Sobre el fondo del bloqueo, 0x555555, que es el equivalente
    // de aquel 0xDDDDDD: se adivina el hueco sin leerse como barra llena (el
    // propio 0xDDDDDD sobre 0x242323 parecia llena, que era el problema).
    const lv_color_t emptyCol =
        onDarkBg ? lv_color_hex(0x555555) : lv_color_hex(0xDDDDDD);
    lv_obj_set_style_bg_color(bars[i], (i < fillCount) ? color : emptyCol,
                              LV_PART_MAIN);
  }
}

// Indicador de conectividad del heading, visible en TODAS las pantallas (a
// diferencia de wifi_link_status_update, que solo vive en Ajustes/WiFi): un
// icono WIFI/2G/sin enlace mas 4 barras de cobertura, para que el operador
// vea de un vistazo si el equipo puede subir telemetria sin tener que entrar
// a Ajustes. Se pinta tanto en ui_ScreenMain como en su replica de
// ui_ScreenLock, cada una con su propio cache de "sin cambios".
//
// Con el enlace HMI-placa caido (Display_IsBoardLinkLost()) no hay dato
// fresco del que fiarse: se pinta como "sin datos", igual criterio que
// link_lost_blank_update() aplica a las medidas.
void connectivity_heading_update(void) {
  const bool linkLost = Display_IsBoardLinkLost();
  const int status = linkLost ? COMM_STATUS_NONE : ctrl_state_msg.serverCommStatus;
  const int linkBars = linkLost ? -1 : ctrl_state_msg.linkBars;

  static int lastSignatureMain = -999;
  apply_connectivity_indicator(ui_ConnIcon, ui_ConnBar, status, linkBars,
                                /*onDarkBg=*/false, &lastSignatureMain);

  static int lastSignatureLock = -999;
  apply_connectivity_indicator(ui_LockHeadingConnIcon, ui_LockHeadingConnBar,
                                status, linkBars, /*onDarkBg=*/true,
                                &lastSignatureLock);
}

void link_lost_blank_update(void) {
  static bool wasLost = false;
  const bool lost = Display_IsBoardLinkLost();
  if (!lost) {
    wasLost = false;
    return;
  }
  if (wasLost) {
    return;  // ya estan en blanco; no hay que reescribir en cada pasada
  }
  wasLost = true;

  l_airDet = l_skinDet = -1.0;
  l_humDet = -1;

  const char *DEAD = "--";
  lv_label_set_text(ui_TempAirDetected, DEAD);
  lv_label_set_text(ui_TempAirDetectedRight, DEAD);
  lv_label_set_text(ui_Label18, DEAD);
  lv_label_set_text(ui_TempSkinDetected, DEAD);
  lv_label_set_text(ui_TempSkinDetectedRight, DEAD);
  lv_label_set_text(ui_Label14, DEAD);
  lv_label_set_text(ui_HumDetected, DEAD);
  lv_label_set_text(ui_HumDetectedRight, DEAD);
  lv_label_set_text(ui_Label20, DEAD);

  lv_bar_set_value(ui_AirTempBar, 0, LV_ANIM_OFF);
  lv_bar_set_value(ui_SkinTempBar, 0, LV_ANIM_OFF);
  lv_bar_set_value(ui_HumBar, 0, LV_ANIM_OFF);
}

void update_labels() {
  if (!g_ui_initialized)
    return;

  static double l_airDesired = -1.0, l_skinDesired = -1.0;
  static int l_humDesired = -1;
  static int l_photoMins = -1;

  char buffer[BUFFER_SIZE];

  if (abs(airTempValue - l_airDesired) > TEMP_LABEL_UPDATE_THRESHOLD) {
    l_airDesired = airTempValue;
    snprintf(buffer, sizeof(buffer), "%.1f°C", airTempValue);
    lv_label_set_text(ui_TempAirDesired, buffer);
    lv_label_set_text(ui_TargetAirTempNumLabel, buffer);
  }

  if (abs(skinTempValue - l_skinDesired) > TEMP_LABEL_UPDATE_THRESHOLD) {
    l_skinDesired = skinTempValue;
    snprintf(buffer, sizeof(buffer), "%.1f°C", skinTempValue);
    lv_label_set_text(ui_TempSkinDesired, buffer);
    lv_label_set_text(ui_TargetSkinTempNumLabel, buffer);
  }

  if (humValue != l_humDesired) {
    l_humDesired = humValue;
    snprintf(buffer, sizeof(buffer), "%d%%", humValue);
    lv_label_set_text(ui_HumDesired, buffer);
    lv_label_set_text(ui_Label24, buffer);
  }

  // Con el enlace caido NO se pintan medidas, y la guarda va AQUI DENTRO.
  //
  // Ponerla solo en link_lost_blank_update() no bastaba: update_labels()
  // tiene ocho llamantes (las flechas de consigna, el cambio de idioma, el
  // arranque...), asi que en cuanto se tocaba cualquier cosa las cifras
  // viejas volvian a pintarse un segundo despues de haberlas borrado, sin
  // que el enlace se hubiera recuperado. Fallo observado en banco.
  //
  // Con la guarda dentro da igual quien llame: mientras la placa calle, la
  // unica medida que se puede pintar es "no la hay".
  const bool linkLost = Display_IsBoardLinkLost();

  // Cada medida se juzga POR SEPARADO. El enlace puede estar perfectamente
  // vivo y faltar un solo sensor, y hasta ahora solo la caida del enlace tenia
  // derecho a "--": un sensor retirado pintaba el 0 que mandaba la placa, que
  // es un numero plausible y alarmante en vez de la ausencia de dato que es.
  // Mismo criterio para las dos causas — lo que se ha perdido es saberlo.
  const bool airOk =
      !linkLost && !PROTO_TEL_TEMP_IS_UNAVAILABLE(airTempValueDetected);
  const bool skinOk =
      !linkLost && !PROTO_TEL_TEMP_IS_UNAVAILABLE(skinTempValueDetected);
  const bool humOk = !linkLost && humValueDetected != PROTO_TEL_HUM_UNAVAILABLE;

  // Para no reescribir los mismos "--" en cada pasada, igual que hacen los
  // ultimos valores pintados con las medidas buenas.
  static bool airDead = false, skinDead = false, humDead = false;
  const char *NO_DATA = "--";

  if (airOk) {
    airDead = false;
    if (abs(airTempValueDetected - l_airDet) > TEMP_LABEL_UPDATE_THRESHOLD) {
      l_airDet = airTempValueDetected;
      snprintf(buffer, sizeof(buffer), "%.1f°C", airTempValueDetected);
      lv_label_set_text(ui_TempAirDetected, buffer);
      lv_label_set_text(ui_TempAirDetectedRight, buffer);
      lv_label_set_text(ui_Label18, buffer);
    }
  } else if (!airDead) {
    airDead = true;
    l_airDet = -1.0;  // fuerza repintado cuando el sensor vuelva
    lv_label_set_text(ui_TempAirDetected, NO_DATA);
    lv_label_set_text(ui_TempAirDetectedRight, NO_DATA);
    lv_label_set_text(ui_Label18, NO_DATA);
  }

  if (skinOk) {
    skinDead = false;
    if (abs(skinTempValueDetected - l_skinDet) > TEMP_LABEL_UPDATE_THRESHOLD) {
      l_skinDet = skinTempValueDetected;
      snprintf(buffer, sizeof(buffer), "%.1f°C", skinTempValueDetected);
      lv_label_set_text(ui_TempSkinDetected, buffer);
      lv_label_set_text(ui_TempSkinDetectedRight, buffer);
      lv_label_set_text(ui_Label14, buffer);
    }
  } else if (!skinDead) {
    skinDead = true;
    l_skinDet = -1.0;
    lv_label_set_text(ui_TempSkinDetected, NO_DATA);
    lv_label_set_text(ui_TempSkinDetectedRight, NO_DATA);
    lv_label_set_text(ui_Label14, NO_DATA);
  }

  if (humOk) {
    humDead = false;
    if (humValueDetected != l_humDet) {
      l_humDet = humValueDetected;
      snprintf(buffer, sizeof(buffer), "%d%%", humValueDetected);
      lv_label_set_text(ui_HumDetected, buffer);
      lv_label_set_text(ui_HumDetectedRight, buffer);
      lv_label_set_text(ui_Label20, buffer);
    }
  } else if (!humDead) {
    humDead = true;
    l_humDet = -1;
    lv_label_set_text(ui_HumDetected, NO_DATA);
    lv_label_set_text(ui_HumDetectedRight, NO_DATA);
    lv_label_set_text(ui_Label20, NO_DATA);
  }

  int airBar =
      (airTempValueDetected <= TEMP_BAR_DISPLAY_MIN)
          ? 0
          : (airTempValueDetected >= TEMP_BAR_DISPLAY_MAX
                 ? TEMP_BAR_RANGE
                 : (int)round(airTempValueDetected - TEMP_BAR_DISPLAY_MIN));
  int skinBar =
      (skinTempValueDetected <= TEMP_BAR_DISPLAY_MIN)
          ? 0
          : (skinTempValueDetected >= TEMP_BAR_DISPLAY_MAX
                 ? TEMP_BAR_RANGE
                 : (int)round(skinTempValueDetected - TEMP_BAR_DISPLAY_MIN));
  int humBar = constrain(humValueDetected, HUM_BAR_MIN, HUM_BAR_MAX);

  // Las barras salen de las mismas medidas muertas: a cero cuando la medida no
  // esta disponible, o dibujarian un nivel que ya nadie esta midiendo. Se juzga
  // por medida y no por enlace, por lo mismo que las cifras: con la sonda
  // retirada, una barra de piel a media altura seria igual de mentirosa.
  lv_bar_set_value(ui_AirTempBar, airOk ? airBar : 0, LV_ANIM_OFF);
  lv_bar_set_value(ui_SkinTempBar, skinOk ? skinBar : 0, LV_ANIM_OFF);
  lv_bar_set_value(ui_HumBar, humOk ? humBar : 0, LV_ANIM_OFF);

  // Update photo timer label if not active
  if (!photoTimerActive) {
    char buf[16];
    snprintf(buf, sizeof(buf), "%d:%02d",
             photoTimerMinutes / SECONDS_PER_MINUTE,
             photoTimerMinutes % SECONDS_PER_MINUTE);
    lv_label_set_text(ui_PhotoTimeValueLabel, buf);
  }

  // Derive skin probe presence from detected temperature and update switch
  // visibility. lastProbePresent starts as false so the first call with
  // skinTempValueDetected=0 (no TEL received yet) does NOT trigger a spurious
  // "probe lost" event that would undo state restoration done by
  // Display_ApplyCtrlState.
  static bool lastProbePresent = false;
  bool probePresent = (skinTempValueDetected > SKIN_PROBE_DETECT_THRESHOLD);
  if (probePresent != lastProbePresent) {
    lastProbePresent = probePresent;
    g_skinProbeState =
        probePresent ? SKIN_PROBE_VALID : SKIN_PROBE_NOT_CONNECTED;
    if (probePresent) {
      if (ui_Switch4)
        lv_obj_clear_flag(ui_Switch4, LV_OBJ_FLAG_HIDDEN);
      const char *text = TR(STR_SKIN_MODE);
      if (ui_SkinOptionLabel)
        lv_label_set_text(ui_SkinOptionLabel, text);
    } else {
      if (ui_Switch4)
        lv_obj_add_flag(ui_Switch4, LV_OBJ_FLAG_HIDDEN);
      const char *text = TR(STR_NO_SKIN_PROBE);
      if (ui_SkinOptionLabel)
        lv_label_set_text(ui_SkinOptionLabel, text);
      if (skinPanelEnabled) {
        skin_mode_force_off();
      } else if (ui_SkinPanelCont) {
        lv_obj_add_flag(ui_SkinPanelCont, LV_OBJ_FLAG_HIDDEN);
      }
    }
  }
}

const char *getConnectivityString(int status, ui_lang_t lang) {
  switch (status) {
  case COMM_STATUS_NONE:        return UI_StrIn(STR_CONN_DISCONNECTED, lang);
  case COMM_STATUS_GPRS_ONLY:   return UI_StrIn(STR_CONN_GPRS_ONLY, lang);
  case COMM_STATUS_GPRS_SERVER: return UI_StrIn(STR_CONN_GPRS_SERVER, lang);
  case COMM_STATUS_WIFI_ONLY:   return UI_StrIn(STR_CONN_WIFI_ONLY, lang);
  case COMM_STATUS_WIFI_SERVER: return UI_StrIn(STR_CONN_WIFI_SERVER, lang);
  default:                      return UI_StrIn(STR_CONN_UNKNOWN, lang);
  }
}

static void photo_safety_apply_language(ui_lang_t lang) {
  if (!ui_PhotoSafetyModal)
    return;
  lv_label_set_text(ui_PhotoSafetyTitleLabel,
                    UI_StrIn(STR_PHOTO_SAFETY_TITLE, lang));
  lv_label_set_text(ui_PhotoSafetyBodyLabel,
                    UI_StrIn(STR_PHOTO_SAFETY_BODY, lang));
  lv_label_set_text(ui_PhotoSafetyTurnOnLabel,
                    UI_StrIn(STR_PHOTO_SAFETY_TURN_ON, lang));
}

static void photo_safety_popup_show(bool show) {
  if (!ui_PhotoSafetyOverlay)
    return;
  if (show) {
    photo_safety_apply_language(g_lang);
    lv_obj_clear_flag(ui_PhotoSafetyOverlay, LV_OBJ_FLAG_HIDDEN);
    lv_obj_move_foreground(ui_PhotoSafetyOverlay);
  } else {
    lv_obj_add_flag(ui_PhotoSafetyOverlay, LV_OBJ_FLAG_HIDDEN);
  }
}

void photo_safety_overlay_cb(lv_event_t *e) {
  if (lv_event_get_target(e) == ui_PhotoSafetyOverlay)
    photo_safety_popup_show(false);
}

void photo_turnon_cb(lv_event_t *) {
  photo_safety_popup_show(false);
  g_photo_safety_confirmed = true;
  ui_set_switch_state_silent(ui_Switch3, true);
  lv_event_send(ui_Switch3, LV_EVENT_VALUE_CHANGED, NULL);
}

// Called by BabyWizard when its phototherapy flow completes. Mirrors
// photo_turnon_cb: raise the one-shot gate and re-trigger the switch, so the
// handler runs again and this time falls through to the ISO 7010 safety
// popup — which stays the last step before the lamp actually turns on.
void ActivatePhototherapyFromWizard() {
  g_photo_wizard_done = true;
  ui_set_switch_state_silent(ui_Switch3, true);
  lv_event_send(ui_Switch3, LV_EVENT_VALUE_CHANGED, NULL);
}

// Same shape for humidity: raise the one-shot gate and re-trigger ui_Switch2
// so its handler runs again and this time falls through to the real
// activation. No safety popup stands between the wizard and the humidifier.
void ActivateHumidityFromWizard() {
  g_hum_wizard_done = true;
  ui_set_switch_state_silent(ui_Switch2, true);
  lv_event_send(ui_Switch2, LV_EVENT_VALUE_CHANGED, NULL);
}

static void update_main_toggle_buttons() {
  if (!ui_TempToggleBtn || !ui_HumToggleBtn || !ui_PhotoToggleBtn)
    return;

  bool t = lv_obj_has_state(ui_Switch1, LV_STATE_CHECKED);
  bool h = lv_obj_has_state(ui_Switch2, LV_STATE_CHECKED);
  bool p = lv_obj_has_state(ui_Switch3, LV_STATE_CHECKED);

  lv_color_t blue = lv_color_hex(0x4EC7FF);
  lv_color_t red  = lv_color_hex(0xFF4040);
  lv_obj_t  *lbl;

  lv_obj_set_style_bg_color(ui_TempToggleBtn, t ? red : blue, LV_PART_MAIN | LV_STATE_DEFAULT);
  lv_obj_set_style_bg_color(ui_TempToggleBtn, t ? red : blue, LV_PART_MAIN | LV_STATE_PRESSED);
  lbl = lv_obj_get_child(ui_TempToggleBtn, 0);
  if (lbl) lv_label_set_text(lbl, t ? "TURN OFF" : "TURN ON");

  lv_obj_set_style_bg_color(ui_HumToggleBtn, h ? red : blue, LV_PART_MAIN | LV_STATE_DEFAULT);
  lv_obj_set_style_bg_color(ui_HumToggleBtn, h ? red : blue, LV_PART_MAIN | LV_STATE_PRESSED);
  lbl = lv_obj_get_child(ui_HumToggleBtn, 0);
  if (lbl) lv_label_set_text(lbl, h ? "TURN OFF" : "TURN ON");

  lv_obj_set_style_bg_color(ui_PhotoToggleBtn, p ? red : blue, LV_PART_MAIN | LV_STATE_DEFAULT);
  lv_obj_set_style_bg_color(ui_PhotoToggleBtn, p ? red : blue, LV_PART_MAIN | LV_STATE_PRESSED);
  lbl = lv_obj_get_child(ui_PhotoToggleBtn, 0);
  if (lbl) lv_label_set_text(lbl, p ? "TURN OFF" : "TURN ON");
}
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
