medicalopenworld/IncuNest/Firmware/motherBoard/include/config/telemetry_keys.h

#pragma once
// ThingsBoard telemetry key strings

#define SN_KEY "SN"
#define HW_NUM_KEY "HW_num"
#define HW_REV_KEY "HW_revision"
#define FW_VERSION_KEY "FW_version"
#define CCID_KEY "CCID"
#define IMEI_KEY "IMEI"
#define APN_KEY "APN"
#define COP_KEY "COP"
#define SYSTEM_RESET_REASON "RST_reason"
// Causa de la ULTIMA caida, publicada solo en el arranque siguiente a un
// reinicio anormal (ver CrashReporter.h). En un arranque normal no se envia
// ninguna de las tres, asi que no consumen del presupuesto de
// THINGSBOARD_FIELDS_AMOUNT en regimen permanente.
//
// Crash_log es un texto corto (<= 192 car.) con las ultimas lineas del log
// antes de morir. Es lo que distingue una averia de otra: en las caidas de
// banco del 2026-09-20 ponia "[MON] GPRS_Task hung, restarting it".
#define CRASH_REASON_KEY  "Crash_reason"
#define CRASH_REBOOTS_KEY "Crash_reboots"
#define CRASH_LOG_KEY     "Crash_log"
// Anillo completo (~4 KB). Solo por WiFi, ver TX_FEATURE_CRASH_FULLLOG_*.
#define CRASH_FULLLOG_KEY "Crash_log_full"
// Del coredump: la tarea que exploto y su backtrace. Crash_task es lo unico
// que senala al culpable sin deducirlo.
#define CRASH_TASK_KEY    "Crash_task"
#define CRASH_BT_KEY      "Crash_bt"
#define SYS_CURR_STANDBY_TEST_KEY "SYS_current_stanby_test"
#define HEATER_CURR_TEST_KEY "Heater_current_test"
#define FAN_CURR_TEST_KEY "Fan_current_test"
#define PHOTOTHERAPY_CURR_KEY "Phototherapy_current_test"
#define HUMIDIFIER_CURR_KEY "Humidifier_current_test"
#define BUZZER_CURR_TEST_KEY "Buzzer_current_test"
#define HW_TEST_KEY "HW_Test"
#define LOCATION_LONGTITUD_KEY "tri_longitud"
#define LOCATION_LATITUD_KEY "tri_latitud"
#define TRI_ACCURACY_KEY "tri_accuracy"
// Origen del valor publicado en las tres claves de arriba: "gsm" para el fix
// de torre del modem, "ip" para el aproximado por IP publica. Las claves de
// posicion se reutilizan a proposito para que los widgets de mapa sigan
// funcionando cuando una unidad se queda sin SIM; esta dice de que calidad es
// el dato, junto con tri_accuracy. Ver modules/util/ip_geoloc.h.
#define LOCATION_SOURCE_KEY "loc_source"
#define UI_LANGUAGE_KEY "UI_language"
// Skin_CAP retired: raw capacitance was a bring-up diagnostic, not
// clinical data. The probe state already travels in CTRL,TEL.
#define SKIN_TEMPERATURE_KEY "Skin_temp"
#define AIR_TEMPERATURE_KEY "Air_temp"
#define AIR_TEMPERATURE_REDUNDANT_KEY "Air_temp_redundant"
#define AMBIENT_TEMPERATURE_KEY "Amb_temp"
#define HUMIDITY_ROOM_KEY "Humidity"
#define HUMIDITY_AMBIENT_KEY "Amb_humidity"
#define SYSTEM_CURRENT_KEY "SYS_current"
#define SYSTEM_VOLTAGE_KEY "SYS_voltage"
#define CELL_SIGNAL_QUALITY_KEY "CSQ"
#define HEATER_CURRENT_KEY "Heater_current"
#define FAN_CURRENT_KEY "Fan_current"
#define FAN_FEEDBACK_PRESENT_KEY "fan_has_fb"
#define FAN_RPM_KEY "fan_rpm"
#define FAN_PWM_KEY "fan_pwm"  // applied fan control duty, raw 0-255 counts
#define V5_CURRENT_KEY "V5_current"
#define V5_VOLTAGE_KEY "V5_voltage"
#define BAT_CURRENT_KEY "BAT_current"
#define BAT_VOLTAGE_KEY "BAT_voltage"
#define CONTROL_ACTIVE_KEY "Control_active"
#define CONTROL_MODE_KEY "Control_mode"
#define DESIRED_TEMPERATURE_KEY "Temp_desired"
#define DESIRED_HUMIDITY_ROOM_KEY "Hum_desired"
#define HUMIDIFIER_CURRENT_KEY "Humidifier_current"
#define HUMIDIFIER_VOLTAGE_KEY "Humidifier_voltage"
// Espejo de Phototherapy_active, y por el mismo motivo: Hum_desired solo se
// publica DENTRO de if (in3.humidityControl), asi que el apagado es una
// ausencia de clave. Para la placa vale, pero una serie temporal no puede
// reconstruir un OFF desde un silencio: entre dos puntos separados horas, un
// grafico en escalon pinta encendido todo el hueco. Hace falta el 0 explicito.
#define HUMIDIFIER_ACTIVE_KEY "Humidifier_active"
#define PHOTOTHERAPY_PWM_KEY "PH_PWM"
#define PHOTOTHERAPY_CURRENT_KEY "Phototherapy_current"
#define PHOTOTHERAPY_ACTIVE_KEY "Phototherapy_active"
#define CALIBRATED_SENSOR_KEY "Calibrated_sensor"
#define STANBY_TIME_KEY "Standby_time"
#define CONTROL_ACTIVE_TIME_KEY "Control_active_time"
#define HEATER_ACTIVE_TIME_KEY "Heater_active_time"
#define FAN_ACTIVE_TIME_KEY "Fan_active_time"
#define PHOTHERAPY_ACTIVE_TIME_KEY "Phototherapy_active_time"
#define HUMIDIFIER_ACTIVE_TIME_KEY "Humidifier_active_time"
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
