medicalopenworld/IncuNest/(commit log)

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2025-11-14 Alarm's PC - Display communication done. Still missing Display - PC comm
    [communication.h, main.cpp]
2025-11-17 Basic communication completed. LGVL error avoided (not really fixed, but no problems encountered).
    [communication.h, main.cpp]
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2025-12-01 Temp and Hum Bars fixed. Thermometer and water drop images implemented (room for improvement)
    [main.cpp, main.h]
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2025-12-05 V1 Lock screen implemented (except for mini error for Air Temp mode, easy to fix)
    [main.cpp, main.h]
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2025-12-12 Wifi configuration finished and correct connection + Spinner for button unlocking progress in LockScreen (now Screen6 instead of 7)
    [main.cpp, main.h]
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2025-12-23 Fixed a mini problem with MuteAlarm. An Index problem in processReceivedAlarm was detected and now fixed.
    [main.cpp]
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2026-01-03 Fixed issue was caused by LVGL trying to free uninitialized memory (x_points)
    [main.cpp]
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2026-01-23 Alarm recognition after resetting display hmi checked. Still work on actuation of switches after resetiing
    [CommTask.cpp, main.h, security.cpp]
2026-01-23 Coherence in switches and panels when sending from motherborard to display STATE. Still need to fix on the opposite direction
    [CommTask.cpp, UITask.cpp, UITask.h]
2026-01-23 Fixed display - motherboard connectivity but still work regarding air and skin panels.
    [CommTask.cpp, UITask.cpp, main.cpp]
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2026-01-28 Phototherapy display reset coherence with the motherboard. If reset when still remain 5 mins (e.g), when reseting, display will start the phototherapy in 5 min.
    [CommTask.cpp, CommTask.h, ElementsCreation.cpp, UITask.cpp]
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2026-02-17 Configuration of PINs for Advanced HMI display. Still a little bit blue. Need to fix it
    [UITask.cpp, main.cpp, main.h]
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2026-02-17 Effective communication with motherboard with the new elements: stop button, new logic for phototherapy... Also phototherapy language labels and width fixed
    [CommTask.cpp, ElementsCreation.cpp, UITask.cpp]
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2026-02-20 Display buzzer silent. Only motherboard buzzer shows off when an alarm is active. Also docs of the project updated
    [UITask.cpp]
2026-02-24 Speaker working. Still need to fix normal speed of the song, screen lags and a cancell button for stopping the audio
    [IncuNest_display_v1_audio.csv]
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2026-02-24 Buttons logic finished. Start and stop buttons work correctly all the time
    [AudioManager.cpp]
2026-02-24 Speaker correctly implemented. Fixed sound cuts because of loops and delay in AudioManager.cpp (line 76)
    [AudioManager.cpp]
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2026-02-25 New variable created for naming the audio once. Replaced sapphire with heartbeat.mp3
    [AudioManager.cpp]
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2026-03-05 Basic version for dark mode. Still need to fix some small details
    [EEPROM.cpp, ElementsCreation.cpp, UITask.cpp, UITask.h, main.h]
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2026-03-13 Fixed error of Alarms indexes. Coherent apparition and resolution of alarmas between motherboard and displayhmi
    [CommTask.cpp]
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2026-03-16 Syncronization problem when recieving first alarm fixed with the use of flags in the code
    [CommTask.cpp, UITask.cpp]
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2026-04-01 fix: aumentada altura del pop up Comfort Zone (auto air) para mejor espaciado
    [ElementsCreation.cpp]
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2026-04-13 Switches of settings screen moved a littlebit to the right, to avoid overlapping
    [ElementsCreation.cpp]
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2026-04-18 fix(DriveUpload): harden CSV rotation against esp_littlefs mlist corruption
    Arduino-ESP32 2.x's esp_littlefs asserts `lfs_mlist_isopen` after a few
    rotation cycles when the writer and upload tasks hold LFS fds concurrently.
    Walk back the problematic patterns:
    - Writer uses POSIX ::open/::write/::close (no Print/stdio/FILE*).
    - Each window writes to a fresh /pox_<ms>.csv (no rename, no path reuse).
    - removeIfExists() probes via POSIX stat() to skip the framework's noisy
    [E] vfs_api.cpp logs when the target is missing.
    - Serialize: writer blocks opening a new window while the upload task still
    holds its reader fd; samples are dropped during that interval instead of
    crashing the board.
    -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
    [DriveUpload.cpp, DriveUpload.h, main.h]
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2026-04-19 fix(motherBoard): restore full incubator state after crash reboot
    - EEPROM.cpp: remove erroneous `restoreState = false` in default actuation
    case; restore phototherapy timer minutes from NVS on crash recovery
    - initHardware.cpp: skip actuatorsTest when restoring state; restart
    temperature/humidity PIDs and turn fan ON when control was active
    [EEPROM.cpp, initHardware.cpp]
2026-04-19 feat(motherBoard): boot diagnostics, GPRS monitor kill-count, CRASH_TEST_MB
    - main.cpp: persist boot-count, last reset reason, gprs/mon kill-counts to
    NVS diag namespace; write EEPROM_CONTROL_ACTIVE and EEPROM_PHOTOTHERAPY_ACTIVE
    on every HMI command so crash recovery can read them; add CRASH_TEST_MB task
    - GPRS.cpp: persist mon_kill counter and log to crash reporter when monitor
    kills a hung GPRS task
    - CommTask.cpp: communication task improvements
    - main.h: extern declarations for new diagnostic globals
    - platformio.ini: add CRASH_TEST_MB build flag (commented out)
    [CommTask.cpp, GPRS.cpp, main.cpp, main.h]
2026-04-19 feat(Display_HMI): fast crash recovery — skip delays, show lock screen
    - main.cpp: detect reset reason with esp_reset_reason(); set g_hmiRestoreState
    true for any non-power-on/brownout reset; skip STARTUP_DELAY_MS on restore;
    persist boot-count and last reset reason to NVS diag namespace;
    add CRASH_TEST_HMI task (null-ptr or abort, configurable delay)
    - UITask.cpp: skip STC8 I2C init delays on restore (saves ~340 ms); skip 5 s
    intro splash and go straight to lock screen on crash recovery; move
    LVGL_Mutex_Init() call to main.cpp setup() before task creation
    - main.h: extern bool g_hmiRestoreState
    [UITask.cpp, main.cpp, main.h]
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2026-04-26 fix(motherBoard): BQ25730 charger debug visibility and VINDPM tuning
    - Lower VINDPM from 19.52V (max) to 12V to give margin against input
    droop on a 24V supply; with VINDPM at the top of the range the chip
    was throttling input current at the slightest cable drop.
    - Periodic charge_status print (3s) and full register dump (10s) gated
    by BQ25730_TEST so the chip's runtime state is observable on serial.
    - On adapter absent->present transition, re-run init_BQ25730() to
    reapply VINDPM/IIN_HOST since some BQ25xxx variants drop those when
    VBUS is re-detected.
    - Forward decls for dump/print_charger_status so sensors_Task can call
    them without reordering the file.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
    [BQ25730.cpp, BQ25730.h, main.cpp]
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2026-05-19 chore: misc fixes across Display_HMI and motherBoard
    - display_config.h / lv_conf.h: config adjustments
    - ElementsCreation.cpp: UI element updates
    - motherBoard: board.h, main.h, DriveUpload, EEPROM, sensors fixes
    - motherBoard/.gitignore: ignore serial_log_*.txt and monitor_*.py
    [DriveUpload.cpp, EEPROM.cpp, ElementsCreation.cpp, board.h, display_config.h, main.h]
2026-05-19 fix(Display_HMI): reduce LCD bounce buffer to fix WiFi PSRAM contention
    - BOUNCE_BUF_LINES 20→8: reduces OPI PSRAM bus load from ~46MB/s to
    ~18MB/s, eliminating WiFi WPA2 handshake failures (AUTH_EXPIRE reason=2)
    - Debounce unlock long-press (20ms): prevents arc reset when finger
    drifts between child widgets during the hold gesture
    - Add HEAP log points (boot / before WiFi.begin / after LCD init)
    to verify internal SRAM margins for future sdkconfig tuning
    [UITask.cpp, Wifi_OTA.cpp, main.h]
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2026-05-19 feat(idf_main): port Display_HMI to pure ESP-IDF, restore BOUNCE_BUF_LINES=20
    Adds parallel [env:idf_main] PlatformIO environment using pioarduino
    framework=espidf. CONFIG_SPIRAM_TRY_ALLOCATE_WIFI_LWIP=n forces
    WiFi/lwIP to use internal SRAM instead of OPI PSRAM, eliminating the
    bus contention that required reducing bounce buffers.
    Key changes:
    - sdkconfig.defaults: CONFIG_SPIRAM_TRY_ALLOCATE_WIFI_LWIP=n
    - compat.h/compat.cpp: millis/delay/psramFound/ESPClass/UARTSerialClass shims
    - EEPROM_IDF.h/cpp: NVS-backed EEPROM replacement + initEEPROM()
    - i2c_bus.h/cpp: IDF i2c_master bus for backlight (I2C_ADDR_BACKLIGHT)
    - main.cpp: app_main() entry point for IDF, setup()/loop() for Arduino
    - lv_c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
    [UITask.cpp, Wifi_OTA.cpp, Wifi_OTA.h, main.cpp]
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2026-05-22 Revert "feat(idf_main): port Display_HMI to pure ESP-IDF, restore BOUNCE_BUF_LINES=20"
    This reverts commit 4885a27bec076e9c990f62426afa0d6ef925eb65.
    [UITask.cpp, Wifi_OTA.cpp, Wifi_OTA.h, main.cpp]
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2026-05-22 fix(flasher): use --flash-mode keep to preserve OPI PSRAM bootloader config
    Forcing --flash-mode qio was overwriting the bootloader header, breaking
    boot on Display HMI (ESP32-S3-WROOM-1-R16N8 with OPI PSRAM). Using keep
    preserves the flash mode and frequency embedded by PlatformIO at build time.
    Also drop baud to 460800 to match PlatformIO's reference upload speed.
    [flasher.py]
2026-05-22 feat(flasher): add Level 2 hotplug auto-detection
    Polls for Espressif VID (0x303A) devices every 500ms; automatically
    triggers board detection + flash when a new ESP32-S3 is plugged in.
    8-second post-flash cooldown prevents re-flashing on device reset.
    Manual controls (port dropdown, Detectar, FLASHEAR) kept as fallback.
    [main.py]
2026-05-22 feat(flasher): identify boards by VID/PID, auto-scan on Flashear
    FLASHEAR now scans COM ports by USB fingerprint instead of requiring
    manual port selection:
    - motherBoard → VID 0x303A (ESP32-S3 native USB)
    - Display HMI → VID 0x1A86 / PID 0x7522 (CH340K)
    Hotplug extended to both board types; skips esptool detect step since
    board type is already known from VID/PID.
    _active_flashes counter supports parallel flash of both boards
    simultaneously (UI not yet optimized for it — future work).
    [detector.py, main.py]
2026-05-22 feat(flasher): 3-slot parallel UI, fully automatic (no button needed)
    - Remove port selector, board label, and FLASHEAR button
    - Add 3 independent _Slot widgets (progress bar + status per device)
    - Hotplug detects any known-VID device and auto-flashes into next free slot
    - Per-port cooldown (8s) replaces global cooldown
    - Slot shows result for 5s then auto-resets for next device
    - Status banner shows live count of active flashes
    - Architecture supports up to NUM_SLOTS simultaneous flashes
    [main.py]
2026-05-22 fix(flasher): make progress bars visible and animated
    Each slot bar starts in indeterminate mode (bouncing) as soon as a
    device is detected, then switches to determinate 0-100% once esptool
    starts reporting percentages. Bar thickness increased to 18px via
    ttk style. Fixes invisible progress bar at flash start.
    [main.py]
2026-05-22 feat(flasher): serial number dialog + NVS write for motherBoard; fix progress bar
    - Show modal dialog asking for serial number (0-9999) when a motherBoard
    is hotplugged; flash is skipped if cancelled
    - After firmware flash, write a 4 KiB NVS partition to the address found
    in partitions.bin (mb_cfg::serial, uint16) so firmware reads it via
    Preferences.getUShort("serial")
    - Fix progress bar never leaving "Iniciando": set NO_COLOR=1 before
    calling esptool so rich outputs plain text; add address-based progress
    fallback that parses "Writing at 0x..." when no percentage is present
    [flasher.py, main.py, nvs_gen.py]
2026-05-23 fix(flasher): ignore WinError 32 when deleting NVS temp file
    On Windows, esptool may briefly hold a read lock on the temp file
    after returning, causing os.unlink to fail. Swallow the OSError
    silently — the OS will clean up the temp dir eventually.
    [flasher.py]
2026-05-23 fix(flasher): treat post-reset serial error as success on ESP32-S3 native USB
    ESP32-S3 native USB re-enumerates after a hard reset, making the COM
    port temporarily inaccessible. esptool raises a serial exception during
    cleanup even though all flash writes completed. Track whether a reset
    line appeared in the output and suppress the exception if so.
    [flasher.py]
2026-05-23 feat(flasher): auto-reset motherBoard into bootloader via usb_reset
    ESP32-S3 native USB-Serial/JTAG supports automatic download mode entry
    without pressing the BOOT button. Use --before usb_reset for motherBoard
    and keep --before default_reset (DTR/RTS) for Display HMI (CH340K).
    [flasher.py]
2026-05-24 fix(flasher): bundle esptool stub JSON files; fix usb-reset deprecation
    PyInstaller wasn't including esptool's stub_flasher JSON data files,
    causing 'Flasher stub data is missing for ESP32-S3'. Use
    collect_data_files('esptool') in the spec to include them all.
    Also rename usb_reset → usb-reset (deprecated alias removed in v5.x).
    [flasher.py]
2026-05-24 feat(flasher): bump baud to 2M; add per-slot elapsed time timer
    - Baud rate: 921600 → 2000000
    - _Slot tracks start time; shows live elapsed seconds during connecting/
    erase phase (ticks every 500 ms via root.after) and in progress updates;
    final time shown in Completado / Error status lines
    [flasher.py, main.py]
2026-05-24 fix(flasher): revert to default_reset; baud 921600
    usb-reset causes FileNotFoundError on Windows because the ESP32-S3
    re-enumerates mid-reset and esptool can't reopen the port in time.
    Reverting to default_reset (requires BOOT button) until hardware
    auto-reset circuit is added to the PCB.
    Baud rate: 2000000 → 921600.
    [flasher.py]
2026-05-24 fix(nvs_gen): correct CRC algorithm and header CRC range
    Two bugs causing ESP-IDF to reject the generated NVS page:
    1. _crc32 was returning zlib.crc32 (standard CRC32 with final XOR).
    ESP-IDF stores crc32_le(0xFFFFFFFF, data) which omits that final XOR.
    Fix: (~zlib.crc32(data)) & 0xFFFFFFFF.
    2. Page header CRC was computed over state+seq_no+version (bytes 0-8).
    ESP-IDF computes it over seq_no+version+reserved (bytes 4-27).
    The state field must be excluded; the reserved bytes must be included.
    Added test_nvs_gen.py with 15 tests covering CRC, structure, bitmap,
    and serial round-trips at boundary values (0, 1, 9999).
    [nvs_gen.py]
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2026-05-28 feat(hw17): add HW revision 17 support
    - HW_NUM 16→17, FWversion 17.0
    - New shunt values: heater 5mΩ, fan 100mΩ, phototherapy 5mΩ, USB/humidifier 100mΩ
    - BQ25730 RSNS_ACTUAL_MOHM 3→5 (shunts now match nominal; remove correction factor)
    - adcToCelsius: vExc 3.3V→2.048V for HW≥17 (LM4040EIM7-2.0 reference)
    - Extend all #if (HW_NUM == 16) guards to >= 16
    - Fix bug: secundary INA3221 setShuntRes used HEATER_SHUNT for CH2 instead of USB_SHUNT
    - CommTask: VCP/USB path guards changed from != 16 to < 16
    [BQ25730.h, CommTask.cpp, board.h, initHardware.cpp, main.cpp, security.cpp]
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2026-05-28 refactor: rename in3ator → IncuNest throughout codebase
    Replace every occurrence of 'in3ator' with 'IncuNest' in all source
    files: class names (MAM_IncuNest_Humidifier), typedefs (IncuNest_parameters,
    IncuNestHum_addr_t), include guards, UI strings and comments.
    Rename in3ator_humidifier.{h,cpp} → IncuNest_humidifier.{h,cpp}.
    [CrashReporter.cpp, DriveUpload.cpp, EEPROM.cpp, GPRS.cpp, ISR.cpp, IncuNest_humidifier.cpp, IncuNest_humidifier.h, PID.cpp]
2026-05-28 fix(nvs_gen): write full NVS partition to overwrite stale pages
    ESP-IDF picks the NVS page with the highest seq_no. Our generated page
    always used seq_no=0, so any pre-existing page with seq_no>=1 would be
    preferred and the new serial number would appear unchanged.
    Fix: generate_serial_nvs() now produces an image equal to the full
    partition size (read from partitions.bin, default 24 KB). The bytes
    beyond the first page are 0xFF (erased flash), which invalidates all
    pre-existing NVS pages so ESP-IDF can only find ours.
    Also adds find_nvs_partition() returning (offset, size) and keeps
    find_nvs_offset() as a backwards-compatible shim.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
    [flasher.py, nvs_gen.py]
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2026-05-28 feat(phototherapy): real-time current control + robust startup calibration
    Startup test:
    - Replace full-power sweep with quick 10% cold measurement for LED continuity check
    - Set phototherapy_intensity initial estimate proportionally from cold reading
    - First user turn-on always starts at PHOTOTHERAPY_INITIAL_PWM_PCT (40%)
    - Subsequent turn-ons reuse last calibrated intensity (photoFirstRun flag)
    Current stabilization (measureStabilizedCurrent):
    - Replace single-interval |curr-prev| check with sliding window of `window`
    samples (range max-min < threshold) to catch slow thermal drift in heater
    and phototherapy LEDs
    - Add `window` parameter (default 3 for fast loads, 10 for thermal loads)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
    [GPRS.cpp, Wifi_OTA.cpp, board.h, initHardware.cpp, main.cpp, main.h]
2026-05-28 fix(sensors): reduce room sensor reconnection delay from 5s to 500ms
    When all room sensors (SHTC3/STS35) fail to respond, switch polling period
    from ROOM_SENSOR_UPDATE_PERIOD_MS (5s) to ROOM_SENSOR_RECONNECT_MS (500ms).
    Reverts to 5s as soon as updateRoomSensor() succeeds again.
    [main.cpp, main.h]
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2026-05-28 feat(motherBoard): rewrite EEPROM.cpp using Preferences
    Replace all EEPROM.* calls with ESP32 Preferences API, add
    migrateFromEEPROM() for one-shot upgrade of existing flash data,
    and reorganise reads/writes under the mb_cfg/mb_cal/mb_wifi/mb_gprs/
    mb_rt/mb_state namespaces defined in main.h.
    [EEPROM.cpp]
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2026-05-28 feat(motherBoard): replace EEPROM write sites with Preferences
    Replace all remaining EEPROM.read/write/commit calls in CommTask.cpp,
    GPRS.cpp, main.cpp, Wifi_OTA.cpp, userInterface.cpp, initHardware.cpp,
    UI_actuatorsProgress.cpp and updateData.cpp with inline Preferences
    blocks using the NS_*/KEY_* constants from main.h. Remove the
    #include <EEPROM.h> from CommTask.cpp.
    [CommTask.cpp, GPRS.cpp, Wifi_OTA.cpp, initHardware.cpp, main.cpp, updateData.cpp]
2026-05-28 fix(motherBoard): remove orphaned KEY_CTRL_ACTIVE writes; fix KEY_PANIC_OTA
    - Remove KEY_CTRL_ACTIVE from migrateFromEEPROM() NS_STATE block (redundant
    with KEY_ACTUATION which encodes the same byte and IS read back)
    - Remove KEY_CTRL_ACTIVE write from recapVariables() else block (the entire
    else block was only writing this orphaned key; removed the block entirely)
    - Remove KEY_CTRL_ACTIVE constant from main.h (no remaining readers)
    - Remove KEY_PANIC_OTA migration write from migrateFromEEPROM() (no field in
    IncuNest_parameters struct and no reader anywhere in the codebase)
    - Remove KEY_PANIC_OTA constant from main.h and OLD_PANIC_OTA offset
    - Remove three commented-out legacy EEPROM l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
    [EEPROM.cpp, main.cpp, main.h]
2026-05-28 fix(motherBoard): restore initEEPROM() call in setup()
    Was accidentally removed by a subagent during review. initEEPROM() must
    be called before initGPIO() so that in3.serialNumber and all other
    persisted variables are loaded before they are first used.
    [main.cpp]
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2026-05-29 fix(motherBoard): write all keys in loaddefaultValues; fix initEEPROM namespace open
    loaddefaultValues() now writes every key read by recapVariables()
    (heat_max_A, skin_t_max, air_t_max, all NS_RT keys, NS_STATE keys),
    eliminating nvs_get_blob NOT_FOUND log spam on first boot.
    initEEPROM() opens NS_CFG in write mode (false) instead of read-only
    so the namespace is created silently instead of logging NOT_FOUND.
    [EEPROM.cpp]
2026-05-29 fix(motherBoard): load real operational defaults on first boot
    loaddefaultValues() now uses HEATER_MAX_POWER_AMPS, SKIN_TEMPERATURE_SET_MAX,
    AIR_TEMPERATURE_SET_MAX and concrete GPRS periods (60/180/3600 s) instead of 0.
    recapVariables() guards fall back to the same constants so a corrupted or
    missing NVS value never leaves the device in an unconfigured state.
    [EEPROM.cpp]
2026-05-29 fix(nvs_gen): write serial as I32 to match Preferences.getInt
    The flasher was writing 'serial' as NVS type U16 (0x02) but the firmware
    reads it with Preferences.getInt() which calls nvs_get_i32() expecting
    type I32 (0x14). The type mismatch caused nvs_get_i32 to return
    ESP_ERR_NVS_TYPE_MISMATCH and the serial always read back as 0.
    Fix: use _T_I32 = 0x14 and struct.pack('<i', ...) for the serial entry.
    [nvs_gen.py]
2026-05-29 fix(motherBoard): preserve flasher serial across first-boot resetFlash
    initEEPROM() calls resetFlash() when KEY_LANG is absent (first boot),
    which cleared NS_CFG including any serial written by the flasher tool.
    Fix: save KEY_SERIAL before resetFlash() and restore it afterwards.
    [EEPROM.cpp]
2026-05-29 diag: add NVS generation and initEEPROM diagnostic logs
    flasher.py: logs NVS entry (offset, size, ns, type, key, value) before
    writing so we can verify the generated binary matches the serial entered.
    EEPROM.cpp: logs initialized flag and flashedSerial value at the start
    of initEEPROM so we can see whether the firmware reads the NVS serial
    before the resetFlash clears it.
    [EEPROM.cpp, flasher.py]
2026-05-29 chore(flasher): update motherboard firmware.bin
    Includes EEPROM.cpp fix (KEY_FAN_PWM → KEY_FAN_PWR_SUPPLY_PWM) and
    diagnostic logs for NVS serial number debugging.
    [EEPROM.cpp]
2026-05-29 fix(nvs_gen): correct CRC formula to match ESP-IDF and official generator
    The previous formula (~zlib.crc32(data)) & 0xFFFFFFFF was wrong.
    The official nvs_partition_gen.py uses zlib.crc32(data, 0xFFFFFFFF)
    which passes 0xFFFFFFFF as zlib's starting value — this internally
    starts the table loop from 0 (0xFFFF^0xFFFF), processes data, then
    XORs result with 0xFFFFFFFF. This matches ESP-IDF's crc32_le(0xFFFFFFFF,data).
    The incorrect CRC caused ESP-IDF to silently mark our NVS page as
    CORRUPT and discard it, so the serial number was never read.
    Added test_crc32_header_matches_known_value to pin against the
    official generator's output (0xB9BA2D84 for the standard header).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
    [nvs_gen.py]
2026-05-29 feat(flasher): auto-detect existing serial; skip dialog if already set
    When require_serial=true, the tool now reads the NVS partition from the
    device before showing the serial number dialog:
    - If serial > 0 already exists → logs it and flashes without touching NVS
    - If serial = 0 or absent → shows dialog as before
    Implementation:
    - nvs_gen.parse_nvs_serial(): scans NVS partition binary for mb_cfg::serial
    - flasher.read_board_serial(): read_flash with --no-stub --before no_reset
    --after no_reset so device stays in ROM DL mode for the write step
    - main.py: _check_existing_serial() background thread → _on_serial_read()
    main-thread callback decides dialog or direct flash
    Co-Authored-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
    [flasher.py, main.py, nvs_gen.py]
2026-05-29 fix(flasher): add baud 921600 to NVS read; fix 'Leyendo serial' status
    - read_board_serial: add --baud 921600 (was defaulting to 115200, causing
    20s delay for 20KB read)
    - _Slot.set_status(): new method for persistent tick-safe status override
    - _check_existing_serial: uses set_status() so '🔍 Leyendo serial…' stays
    visible and isn't overwritten every 500ms by the tick loop
    [flasher.py, main.py]
2026-05-29 fix(flasher): use stub for NVS read (remove --no-stub)
    ROM mode reads flash in ~256B chunks with per-packet ACK at 115200 baud
    → ~20s for 20KB. Stub mode transfers in bulk with compression → ~2s.
    [flasher.py]
2026-05-29 refactor(flasher): replace unreliable pre-read with 'Conservar' button
    The esptool pre-read approach caused port-locking and 30s timeouts on
    Windows. Replaced with a dialog that has three explicit options:
    - 'Asignar serial' — enter a new serial and write it to NVS
    - 'Conservar serial existente' — flash firmware only, leave NVS untouched
    - 'Cancelar' — abort
    No extra esptool connection needed; no risk of port busy errors.
    Also keeps read_board_serial/parse_nvs_serial available for future use.
    [main.py]
2026-05-29 feat(flasher): auto-detect existing firmware via 4-byte app partition read
    Reads only 4 bytes at 0x10000 (app partition magic) using ROM bootloader
    (--no-stub, no port-locking risk). If bytes != 0xFF*4 → firmware exists
    → skip serial dialog and preserve NVS. New devices (all 0xFF) still show
    the serial dialog.
    Reverts 'Conservar serial existente' button; dialog is back to original.
    [flasher.py, main.py]
2026-05-29 refactor(motherBoard): rename fanPWM → fanPwrSupplyPWM; fix FAN default
    - FAN_PWM / KEY_FAN_PWM / in3.fanPWM renamed to FAN_PWR_SUPPLY_PWM /
    KEY_FAN_PWR_SUPPLY_PWM / in3.fanPwrSupplyPWM for clarity
    - NVS key updated to "fan_pwr_sup_pwm"
    - loaddefaultValues and recapVariables now use FAN_PWR_SUPPLY_PWM as
    default/fallback instead of 0
    [CommTask.cpp, EEPROM.cpp, Wifi_OTA.cpp, board.h, main.h]
2026-05-29 fix(flasher): add explicit --after hard_reset; remove NVS diag log
    Adds --after hard_reset to write-flash args so the device always resets
    after flashing (was relying on esptool's version-dependent default).
    Also removes the temporary NVS diagnostic log added for debugging.
    [flasher.py]
2026-05-29 fix(flasher): clear RTC_CNTL_FORCE_DOWNLOAD_BOOT before reset
    The ESP32-S3 ROM sets bit 0 of RTC_CNTL_OPTION1_REG (0x600080DC)
    when entering download mode. This flag persists through software resets
    and causes the device to re-enter download mode even with GPIO0/BOOT high.
    Fix: flash with --after no_reset to keep stub in RAM, then do a second
    esptool call (write_reg 0x600080DC 0 0x1 + hard_reset) that clears the
    flag before resetting. With the flag cleared, the next reset reads the
    strapping pins (BOOT=high) and boots the firmware normally.
    [flasher.py]
2026-05-29 fix(flasher): fix deprecated option names; run write_reg with timeout
    - Rename all --before/--after options to use hyphens (default-reset,
    no-reset, hard-reset) — underscore form was deprecated in esptool 5.x
    - Wrap the post-flash write_reg reset step in a daemon thread with 8s
    timeout so a failed connection never blocks the flash completion
    [flasher.py]
2026-05-29 fix(flasher): use --after soft-reset to boot app after flash on ESP32-S3
    --after hard-reset via USB-JTAG triggers USB_UART_CHIP_RESET which always
    enters download mode on ESP32-S3, regardless of BOOT pin or RTC flags.
    --after soft-reset sends ESP_RUN_USER_CODE to the stub, which jumps
    directly into the flashed application without a hardware reset cycle.
    This avoids the USB reset entirely and boots the firmware correctly.
    Also removes the two-step write_reg+hard-reset thread approach which was
    hanging due to stub timeout.
    [flasher.py]
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2026-05-29 revert(flasher): remove --after reset attempts; back to default behavior
    All reset approaches (hard-reset, soft-reset, write_reg) cause issues
    specific to ESP32-S3 native USB without hardware reset circuit.
    Reverted to no explicit --after flag. The reset problem requires a
    hardware solution (EN pin reset circuit) on the motherboard PCB.
    [flasher.py]
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2026-05-29 feat(display-ui): drive spo2ProbeAttached from CTRL,PROBE messages, remove variance heuristic
    Replace PPG-variance-based probe detection with authoritative CTRL,PROBE
    message handling; edge transitions now reset normalisation and show/hide
    chart + HR container based on SPO2_PROBE_APPLIED state.
    [UITask.cpp]
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2026-05-29 fix(boot): add overcurrent early-exit to parallel actuator test
    Add per-channel 2-consecutive-reading overcurrent counters
    (hOverMax/pOverMax/fOverMax) to measureThreeActuatorsParallel(),
    mirroring the protection in measureStabilizedCurrent(). A confirmed
    overcurrent on any channel now breaks out of the 8 s loop immediately
    instead of waiting for the full timeout.
    Also align the function opening brace to K&R style (same line as ')').
    [initHardware.cpp]
2026-05-29 perf(boot): shorten startup beep to 300ms (-400ms)
    Add dedicated BUZZER_BEEP_DURATION_MS 300 constant (replaces generic
    CURRENT_STABILIZE_TIME_DEFAULT 700 in the HW>=17 testBuzzer path).
    [initHardware.cpp]
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2026-05-30 debug(display): disable inactivity timeout; add probe parse-error log; silence LCD diag OK
    - INACTIVITY_TIMEOUT_MS set to 0 (disables EEPROM commit delay, avoids interference during dev testing)
    - CommTask: log error on malformed CTRL,PROBE message
    - UITask: comment out LCD_DIAG OK log (reduces noise in normal operation)
    [CommTask.cpp, UITask.cpp]
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2026-05-30 refactor(main): replace Serial.println with logI in BQ25730 diagnostics
    Gate dump_BQ25730_regs() and print_charger_status() behind LOG_CHARGER
    flag and route output through logI() for consistency with the rest of
    the codebase.
    [main.cpp]
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2026-05-30 fix(touch): debounce GT911 phantom releases in my_touchpad_read
    The GT911 clears its I2C buffer after each read. When LVGL polls at
    10ms intervals (faster than the controller's update rate), intermediate
    reads return isTouched=false during a sustained press, generating a
    spurious RELEASED→CLICKED cycle that toggles widgets twice.
    Require 3 consecutive 'not touched' frames (~30ms) before reporting
    LV_INDEV_STATE_REL, filtering phantom releases without perceptible
    input latency.
    [UITask.cpp]
2026-05-30 revert(sensors): remove skin forecast algorithm (Prony estimator)
    Remove updateSkinForecast(), all constants, enum, struct fields,
    telemetry keys and ThingsBoard serialization. Restore SKIN_WARMUP
    log to 4-column format (t_ms, raw_C, filtered_C, calibrated_C).
    The Prony approach was not accurate enough in practice due to
    multi-compartment thermal dynamics and NTC quantization limits.
    [GPRS.cpp, Wifi_OTA.cpp, main.h]
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2026-05-31 fix(comm): capture millis() once per PPG waveform interval check
    Avoids drift where last_ppg_time was set slightly after the interval
    was evaluated, accumulating processing time into each 40 ms period.
    Applied to both UART and USB paths in Communication_Task.
    [CommTask.cpp]
2026-05-31 fix(sensors): correct negative heater current readings on HW17
    INA3221 IN+ is routed to the MOSFET switching node instead of the shunt
    pad (PCB layout bug). PWM switching injects inductive transients that
    flip the reading negative with amplified magnitude. Apply empirical
    correction for HW17: I_real ≈ |I_measured| / HEATER_CURRENT_CORRECTION_FACTOR (2.5).
    Factor is tunable in board.h. Fix IN+ routing in next PCB revision.
    Also:
    - platformio.ini: add build_lib_flags=-w and -Wno-attributes to suppress
    third-party library warnings (INA3221 packed attribute, requestFrom overload)
    - initHardware.cpp: scope testCurrent/offsetCurrent inside #else block to
    fix unused-variable warnings on HW>=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
    [SPO2.cpp, board.h, initHardware.cpp]
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2026-06-01 feat(hal): introduce HAL abstraction, add IncuNest_V16/V17 PIO environments (Phase 2)
    - Replace [env:main] with [env:IncuNest_V17] and [env:IncuNest_V16] sharing a
    [common] section; each env excludes the other HW's HAL file via build_src_filter
    - Remove hardcoded #define HW_NUM 17 from board.h; add #error guard requiring
    HW_NUM to be set via build_flags
    - Fix testBuzzer() missing offsetCurrent declaration (latent bug exposed by V16 build)
    - Drop lib_build_flags = -w so warnings from project source are now visible
    [board.h, hal.h, hal_hw16.cpp, hal_hw17.cpp, initHardware.cpp]
2026-06-01 feat(state): introduce DeviceState module alongside existing in3 (Phase 4)
    state_init() wired into setup(). Replaced stdatomic.h atomic_uint with
    mutex-protected uint32_t (xtensa-esp32s3 GCC C++ does not support _Atomic).
    Full in3 migration happens progressively as modules are extracted in Phases 5-7.
    [main.cpp]
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2026-06-02 feat(charger): fix VBAT/VSYS ADC offset and add absorption-to-float transition
    - Fix BQ25730_ADC_VBAT/VSYS_OFFSET_MV from 2880 to 8192 mV: this chip
    variant (PDF V2 register layout) shifts the ADC window to 8.19–24.5 V,
    confirmed empirically against direct pin measurements (code 85 = 13.6 V,
    code 97 = 14.3 V with 64 mV/bit step).
    - Add absorption→float state machine in sensors_Task: after ICHG stays
    below BQ25730_ICHG_TERM_MA (320 mA ≈ C/22) for 60 s, switches
    MaxChargeVoltage to BQ25730_VCHARGE_FLOAT_MV (13.648 V). Resets to
    absorption on adapter reconnect, which already triggers init_BQ25730().
    - Update battery type comment from AGM to flooded lead-acid (abierto).
    Co-A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
    [BQ25730.cpp, BQ25730.h, main.cpp]
2026-06-02 feat(provisioning): retry with name suffix when device already exists in ThingsBoard
    When NVS is erased and the device tries to re-provision, ThingsBoard rejects
    the request because the device name (CCID) already exists. On failure, the
    retry counter increments and the next attempt uses CCID_N as device name,
    up to PROVISION_MAX_RETRIES (3) attempts.
    [GPRS.cpp, GPRS.h, Wifi_OTA.cpp, Wifi_OTA.h]
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2026-06-03 fix(flasher): force serial dialog when force_serial_number_entry=true
    When force_serial_number_entry=true: always show the serial number dialog
    regardless of whether the device already has firmware flashed.
    When force_serial_number_entry=false: auto-detect firmware presence via
    4-byte read; if firmware exists, preserve NVS (no serial write); if not,
    just flash without serial.
    [main.py]
2026-06-08 fix(hmi): increase CommTask stack 8→16 KB to prevent overflow in LVGL calls
    CommTask currently calls deep LVGL functions from an 8 KB stack, which
    causes overflow and memory corruption. This doubles the stack size to 16 KB
    to provide immediate headroom while the architectural fix (moving LVGL calls
    out of CommTask) is done in a later task.
    [main.h]
2026-06-08 fix(hmi): remove duplicate _ui_screen_change call in ui_event_Settings
    The function Settings_cb(e) called from ui_event_Settings already invokes
    _ui_screen_change internally. The duplicate direct call was redundant and,
    after the _ui_screen_delete fix, would cause ui_ScreenSettings_screen_init()
    to be called twice on subsequent visits to the Settings screen.
    [ElementsCreation.cpp]
2026-06-08 fix(hmi): skip ui_ScreenIntro load in ui_init when g_hmiRestoreState is true
    When the device auto-restarts (crash recovery, watchdog, etc.), g_hmiRestoreState
    is true. The UITask handles loading ui_ScreenMain in this case, but ui_init() was
    still unconditionally loading ui_ScreenIntro at the end. This is fragile and could
    cause one LVGL frame of the intro to render before the main screen is loaded.
    Wrapped the lv_scr_load(ui_ScreenIntro) call in ElementsCreation.cpp with a guard
    to skip it when g_hmiRestoreState is true.
    [ElementsCreation.cpp]
2026-06-08 fix(hmi): add NULL guards in ui_ScreenSettings_screen_init to prevent crash on LVGL OOM
    [ElementsCreation.cpp]
2026-06-08 fix(hmi): fix partial-init crash in screen guards and _ui_screen_change
    - Add post-init NULL check in _ui_screen_change to skip lv_scr_load_anim
    if target_init() returned early due to LVGL OOM, preventing broken screen load
    - Include esp_log.h in ui_helpers.c for ESP_LOGE
    - Split LVGL_INIT_GUARD into LVGL_INIT_GUARD_ROOT (root screen: just return)
    and LVGL_INIT_GUARD_CHILD (child widgets: delete+nullify root before return)
    so a partial-init Settings screen cannot persist as non-NULL between taps
    - Add LVGL_INIT_GUARD_CHILD for ui_WifiConnectButton (previously unguarded)
    - Add #undef for both macros after ui_ScreenSettings_screen_init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
    [ElementsCreation.cpp]
2026-06-08 refactor(hmi): move all LVGL calls from CommTask to UITask — CommTask now flag-only
    CommTask no longer calls LVGL functions directly. applyHMIData() now only
    updates shared numeric variables and sets g_pendingTelemetryApply. Display_StateSync_Service
    no longer calls Display_ApplyCtrlState; UITask polls ctrl_state_msg.newState and
    g_pendingTelemetryApply inside its LVGL_Lock region. AlarmSound_Update() also moved to
    the g_pendingAlarmUpdate handler in UITask. Display_ApplyCtrlState is made public (non-static)
    and CommTask_GetHandle() added for future diagnostics.
    [CommTask.cpp, CommTask.h, UITask.cpp]
2026-06-08 fix(hmi): protect telemetry double-writes and move AlarmSound_Update outside LVGL lock
    - Declare airTempValueDetected, skinTempValueDetected, humValueDetected as
    volatile (main.h + UITask.cpp) to prevent compiler reordering
    - Add portMUX_TYPE g_telemetry_mux spinlock (CommTask.cpp/h); wrap writes
    in applyHMIData() with taskENTER/EXIT_CRITICAL (ARQ-THREAD-001)
    - Wrap telemetry reads in UITask with same spinlock; snapshot values before
    calling update_labels/chart_add_* to ensure consistent data
    - Move AlarmSound_Update() (which calls Wire.endTransmission, ~50ms I2C)
    to after LVGL_Unlock via doAlarmSound flag (ARQ-LOCK-001)
    [CommTask.cpp, CommTask.h, UITask.cpp, main.h]
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2026-06-08 feat(hmi): track heap minimum watermark in diagnostics and ThingsBoard
    Add heap_caps_get_minimum_free_size(MALLOC_CAP_INTERNAL) to both UART
    diagnostics (every 60s) and ThingsBoard telemetry. The minimum watermark
    captures the lowest free heap ever seen since boot, preventing transient
    allocation peaks from being missed between periodic samples.
    Changes:
    - UITask.cpp: Added heap_int_min variable and updated both ESP_LOGE and
    ESP_LOGW log lines to include it; threshold check now uses heap_int_min
    - Wifi_OTA.cpp: Added hmi_heap_int_min_b field to ThingsBoard telemetry
    [UITask.cpp, Wifi_OTA.cpp]
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2026-06-08 refactor(hmi): reorganize src/ into drivers/tasks/ui/assets layers
    - drivers/: buzzer.cpp, EEPROM.cpp (hardware drivers)
    - tasks/: CommTask.cpp, UITask.cpp, AudioManager.cpp, Wifi_OTA.cpp (FreeRTOS tasks)
    - ui/: ElementsCreation.cpp, ui_helpers.c, and assets/ (LVGL UI code and generated assets)
    - Update platformio.ini build_src_filter to reference tasks/AudioManager.cpp
    [AudioManager.cpp, CommTask.cpp, EEPROM.cpp, ElementsCreation.cpp, UITask.cpp, Wifi_OTA.cpp, buzzer.cpp]
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2026-06-08 fix(display_hmi): fix three boot-crash bugs — ODR vtable, NetworkEvents race, backlight retry
    - platformio.ini: add THINGSBOARD_ENABLE_STREAM_UTILS=0 to prevent ODR
    violation between main-project and library TUs that caused a vtable
    mismatch in Arduino_MQTT_Client, crashing every boot in global ctors
    (LoadProhibited at 0x0000ff00 in ThingsBoardSized::setBufferSize)
    - platformio.ini: add NETWORK_EVENTS_MUTEX to serialize _cbEventList
    access in Arduino ESP32 NetworkEvents; without it the NetworkEvents
    task (priority 19) could preempt OTA task mid-emplace_back() during
    vector reallocation, reading an uninitialized std::function::_M_invoker
    (DRAM address 0x3fcc4940) and triggeri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
    [UITask.cpp, main.h]
2026-06-10 feat(motherboard): upgrade incunest_afe4490 to master HEAD (v0.32+)
    Updates the AFE4490 PPG/SpO2 driver from commit d831a20 (v0.31) to
    7d8c20a (17 new commits). Key changes in the library:
    - v0.32: default LED current raised to ~19.9 mA, TIA gain set to RF_100K
    - fix: rsqm_disconn_i_pd_thr raised 50→150 nA to avoid false
    NOT-DISCONNECTED due to ambdac=2µA offset
    - feat: AFE4490DebugData + getData(data, dbg*) atomic debug retrieval
    - feat: AFE4490AnalogState — physical analog reconstruction per sample
    - refactor: rename AFE4490TIAGain→AFE4490RF, AFE4490Stage2Gain→AFE4490RG
    - refactor: rename led1_aled1→led1_sub, led2_aled2→led2_sub,
    ppg→ppg_disp across AFE4490Data struct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
    [CommTask.cpp, DriveUpload.cpp, DriveUpload.h, SPO2.cpp]
2026-06-12 feat(display_hmi): replace pulse icon with red heart, add BPM label
    - New 30x30 red heart icon (RGB565+alpha C array, mathematical heart curve)
    replaces the ECG waveform icon on the lock screen HR widget
    - HR container now uses LVGL flex column layout (centered on all axes)
    so the three elements — heart, BPM value, and unit label — are
    automatically stacked and horizontally centred
    - Added "BPM" unit label (Montserrat 14, white) below the numeric value
    to make the reading unambiguous at a glance
    [ElementsCreation.cpp, UITask.cpp]
2026-06-12 feat(hmi+mb): add Perfusion Index to CTRL,VIT protocol and lock-screen display
    Protocol (both firmwares):
    - Motherboard CommTask: extend VIT frame from "CTRL,VIT,<hr>,0" to
    "CTRL,VIT,<hr>,0,<pi>" — adds g_spo2_data.pi (%.2f) as third field
    for both UART (hmiSerial) and USB-CDC paths; buffer 20→32 bytes
    HMI CommTask:
    - Add float pi to ControlBoard_Message_VIT struct
    - sscanf updated to parse optional third %f field; n>=2 keeps
    backward compatibility if old protocol is running
    - Initializer updated {0, 0, 0.0f, false}
    HMI Display (lock screen):
    - HR container narrowed 170→110 px, shifted left (x=-80) to make room
    - New PI container (65×105 px, x=-10, flex-column centered): title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
    [CommTask.cpp, CommTask.h, ElementsCreation.cpp, UITask.cpp]
2026-06-12 fix(display_hmi): PI same font size as BPM, hide on probe disconnect
    - ui_LockPILabel font: Montserrat 20 -> Montserrat 48 (same as BPM)
    - PI container width: 65 -> 110 px to fit Montserrat 48 numerals
    - BPM container x-offset: -80 -> -125 to maintain 5 px gap to PI
    - PPG chart width: 600 -> 550 px to accommodate the wider PI widget
    - Probe falling-edge handler: add ui_LockPICont hide alongside
    ui_LockHRCont so PI disappears immediately on probe removal,
    not just on the next VIT message
    Final bottom-strip layout (800 px):
    [10px margin] [PPG chart 550px] [5px] [BPM 110px] [5px] [PI 110px] [10px]
    [ElementsCreation.cpp, UITask.cpp]
2026-06-12 fix(display_hmi): stop deleting Settings/Lock/Charts screens to prevent UI_SyncAll dangling-pointer crashes
    UI_SyncAll unconditionally reads ui_Switch4 (on ScreenSettings), ui_TargetAirTempCont /
    ui_ArrowAirLock / ui_AirTempLockCont / ui_HumLockDesiredCont (on ScreenLock), and
    ui_TabView1 / ui_HistoryChart* (on ScreenCharts). Deleting those screens via
    scr_unloaded_delete_cb freed their LVGL children but left the global pointers non-null;
    the next UI_SyncAll call then accessed dangling memory and crashed with
    EXCVADDR=0x0000b044 (observed on Settings→Main back navigation).
    Remove scr_unloaded_delete_cb registrations from:
    - ui_event_ImgButton8 / ImgButton8_cb (Charts → Main)
    - ui_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
    [ElementsCreation.cpp, UITask.cpp]
2026-06-13 fix(display_hmi): remove remaining scr_unloaded_delete_cb for Alarms and PulseOxi screens
    Alarms→Main navigation crashed because update_alarm_panels() (called every loop
    iteration when g_pendingAlarmUpdate is set) unconditionally accesses ui_Alarm1Cont /
    ui_Alarm2Cont / ui_AlarmDetailLabel — all children of ui_ScreenAlarms — without null
    checks. Deleting ui_ScreenAlarms left those pointers dangling, causing a
    LoadProhibited crash on the next alarm-panel refresh.
    PulseOxi also removed: UI_ApplyLanguage() accesses ui_Label39 (child of
    ui_ScreenPulseOxi) without a null check; deleting the screen would crash on any
    subsequent language operation.
    All secondary screens (Alarms, Charts, Pu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
    [ElementsCreation.cpp]
2026-06-13 fix(mb+flasher): heater power limits, task stacks, current correction, flasher config
    - Adjust HEATER_CURRENT_CORRECTION_FACTOR from 2.5 to 5.80 to match measured current
    - Refactor heater power limits by HW_NUM range: HW14-16 → 7.5A, others → 9.5A; replace HEATER_SAFE_POWER_AMPS with HEATER_SAFE_MARGIN_AMPS 1
    - Enable THINGSBOARD_ENABLE_STREAM_UTILS to reduce memory pressure
    - Double GPRS and OTA task stack sizes (8192 → 16384) to prevent stack overflows
    - Fix flasher config key rename: require_serial → force_serial_number
    - Fix flasher config path resolution in dev mode (parent.parent)
    - Update firmware.bin and flasher binary
    - Code style cleanup in EEPROM.cpp (brace formatting)
    C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
    [EEPROM.cpp, GPRS.cpp, PID.cpp, Wifi_OTA.cpp, board.h, main.cpp, main.h, main.py]
2026-06-17 refactor(display_hmi): replace hardcoded web server credentials with macros
    Remove hardcoded www_username and www_password variables from Wifi_OTA.cpp.
    Replace all 5 occurrences with WEB_SERVER_USERNAME and WEB_SERVER_PASSWORD
    macros now available via main.h (from Task 1 of credential refactor).
    [Wifi_OTA.cpp]
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2026-06-17 fix(flasher): address post-review findings in wifi_flasher and _WifiTab
    - Fix socket leak in _local_subnet(): close socket in finally block
    - Cancel pending futures on timeout in _discover_subnet() executor drain
    - Add intentional-credentials comment above _AUTH_SEQUENCES
    - _identify_board_type() returns Optional[Board]: None on ambiguous result
    (connection error / unexpected status) instead of defaulting to MOTHERBOARD;
    _probe_ip() skips host when board is None to avoid wrong-firmware flash
    - _active_flashes pre-assigned atomically before flash loop in _on_scan_done
    - Remove stale stub comment from WiFi tab construction
    [main.py, wifi_flasher.py]
2026-06-17 fix(display_hmi): move AA and photo-timer NVS writes outside LVGL lock
    Replace immediate Preferences writes in autoair_popup_update_labels(),
    PhotoTimeMinusBtn_cb() and PhotoTimePlusBtn_cb() with the existing
    EEPROM_COMMIT_DELAY deferred cycle. Adds aa_weight, aa_gest, aa_age_h
    and photo_min to the single doNVSWrite transaction that runs outside
    LVGL_Lock, eliminating flash writes on every spinbox button press.
    [UITask.cpp]
2026-06-17 fix(flasher+fw): fix WiFi discovery on hotspot; add MDNS service
    - wifi_flasher: replace _local_subnet() with _local_subnets() using
    ifaddr to enumerate all local interfaces. The previous socket trick
    returned the internet-facing IP (e.g. 192.168.1.x) and missed the
    Windows hotspot adapter (192.168.137.x) entirely.
    - Display HMI + Motherboard firmware: add MDNS.addService("http","tcp",80)
    so the mDNS ServiceBrowser can discover devices after next OTA update.
    [Wifi_OTA.cpp, wifi_flasher.py]
2026-06-17 feat(flasher+fw): progress bar, serial number, update-locals button
    - wifi_flasher: _ProgressFile wrapper streams upload progress (0-99%) via
    progress_cb on each read(), replacing the single end-of-upload callback
    - wifi_flasher: add sn field to WifiBoard; _probe_ip reads sn from
    /get_fw_version JSON and falls back to OS mDNS reverse-lookup;
    _discover_mdns parses sn from hostname (IncuNest_Display-7 -> 7)
    - main: WiFi slot now shows SN:N next to IP when available
    - main: "Actualizar binarios locales" button in WiFi tab copies the most
    recently built .pio firmware.bin to data/firmware/; hidden in frozen exe
    - Firmware: /get_fw_version now returns {"version":"...","sn":N} on both
    Dis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
    [Wifi_OTA.cpp, main.py, wifi_flasher.py]
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2026-06-17 fix(wifi-flasher): detect all boards and handle OTA response on restart
    - discover_boards now always runs both mDNS and subnet scan and merges
    results, so boards not advertising via mDNS (old firmware) are still
    found when mDNS finds other boards first
    - Add delay(500) before ESP.restart() in both firmware OTA handlers so
    the TCP stack can flush "OK" before the hardware resets
    - Defensively handle ConnectionReset when reading the POST response body:
    an empty body on a 200 status is treated as success
    - Update TestDiscoverBoards to reflect always-both-scans behavior; add
    deduplication and merge tests (37 tests pass)
    [Wifi_OTA.cpp, wifi_flasher.py]
2026-06-17 fix(wifi-flasher): real network-level upload progress via MultipartEncoderMonitor
    Replace _ProgressFile (which fired progress in-memory before any bytes
    were sent over the wire) with requests_toolbelt.MultipartEncoderMonitor,
    which streams the multipart body in chunks and calls the callback during
    the actual TCP send — progress bar now reflects true network transfer.
    Add requests-toolbelt>=1.0 to requirements.txt and flasher.spec hidden imports.
    [wifi_flasher.py]
2026-06-18 fix(flasher): ask serial number only for virgin boards, not re-flashes
    - _on_firmware_check_done: when firmware absent → show serial dialog;
    when firmware present → skip dialog and preserve existing NVS
    - has_firmware_flashed: return True on read error (conservative) so a
    board that fails the probe is not mistakenly treated as unflashed
    - force_serial_number=true still overrides to always ask (factory use)
    [flasher.py, main.py]
2026-06-19 feat(flasher): add Windows hotspot button in WiFi tab
    - hotspot.py: start/stop Windows hosted-network via netsh wlan;
    is_supported() guards the button; human-readable errors for missing
    admin rights or unsupported adapter
    - _WifiTab: adds '📡 Hotspot in3wifi' button (Windows-only, hidden on Mac);
    disabled if hosted network not available on this machine
    - Both PyInstaller specs include hotspot module
    [hotspot.py, main.py]
2026-06-19 fix(flasher): replace PowerShell WinRT hotspot with Python winrt package
    PowerShell 5.x cannot properly await WinRT IAsyncOperation<T> COM objects
    via reflection. Switch to the `winrt` Python package which uses native
    WinRT projection and async/await — tested working on this machine.
    [hotspot.py]
2026-06-19 fix(flasher): sequential HMI-first WiFi OTA queue, button layout, version sort
    - WiFi OTA now flashes Display HMIs before Motherboards sequentially so
    MB reboots cannot interrupt an ongoing HMI transfer
    - Fix "Actualizar binarios locales" button invisible due to tkinter pack
    order: button frame now packed side='bottom' before the log's expand=True
    - _get_build_sources picks highest version-numbered PlatformIO environment
    (e.g. IncuNest_V17 over IncuNest_V16) instead of most-recently-modified
    [main.py]
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2026-06-19 fix(lock): null timer before self-delete, reset thumb on show, unlock state before screen load
    [UITask.cpp]
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2026-06-19 feat(flasher): redesign WiFi tab with 8 slots, auto-scan, per-device flash
    - 8 device slots replace the old 3-slot shared list
    - Auto-scan every 5s (pauses during flash, resumes after)
    - Per-slot Flash button + Flash All button (HMI-first queue)
    - Stale devices removed on rescan; new ones fill free slots
    - Window height increased to 820px to fit 8 compact slot rows
    [main.py]
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2026-06-19 fix(flasher): compact WiFi slots (2-line) and reduce log height to fit button
    Slots were ~68px each × 8 = 544px, exceeding the 820px window budget and
    squeezing the button to near-invisible. Redesigned to 2-line compact rows
    (~45px each = 360px total), reduced log from height=7 to height=5.
    [main.py]
2026-06-19 fix(flasher): force hotspot band to 2.4 GHz
    ESP32 devices only support 2.4 GHz; explicitly set TetheringWiFiBand.
    TWO_POINT_FOUR_GIGAHERTZ so the hotspot never starts on 5 GHz.
    [hotspot.py]
2026-06-19 fix(flasher): thread-local stdout proxy for concurrent USB flashing
    sys.stdout was a global replaced per-thread, so with 2+ simultaneous
    flashes each thread overwrote the other's redirection: progress callbacks
    fired on the wrong slot and log lines got mixed.
    Fix: install _EsptoolProxy once as sys.stdout/stderr. Each flash thread
    sets _tl.writer (threading.local) to its own _Writer; the proxy routes
    write() calls to the current thread's writer. Threads are now fully
    isolated — correct progress bars and separate log output per slot.
    [flasher.py]
2026-06-19 fix(lock): z-order, PPG touch, border color/thickness, TURN ON/OFF buttons
    - show_unlock_only: move popup to foreground, keep LockButton hidden
    - ElementsCreation: add LV_OBJ_FLAG_EVENT_BUBBLE to LockPPGChart,
    LockHRCont, LockPICont so taps propagate to lock screen handler
    - Border bars: color 0xFFFFFF → 0x4EC7FF, thickness 5 → 10px
    - Toggle buttons: restore "TURN ON"/"TURN OFF" labels and blue color
    (changes were lost in slide-to-unlock revert)
    [ElementsCreation.cpp, UITask.cpp, main.h]
2026-06-19 fix(ui): invert toggle text, red on ON, white popup border, fix lock icon tiling
    - Toggle buttons: OFF state shows "TURN ON" (blue), ON state shows "TURN OFF" (red 0xFF4040)
    - Unlock popup: add 2px white border to Panel11 to delimit contact area
    - ui_LockButton2: replace lv_imgbtn with lv_img at zoom 384 (1.5x=60px)
    to eliminate LVGL middle-tile duplication of the 40x40 candado image
    [ElementsCreation.cpp, UITask.cpp]
2026-06-26 feat(hmi): add Senegal flag, medical icon (ISO7010) and baby logo assets
    - Move RASD.jpg from flags/ to data/ (unified asset directory)
    - Add senegal-flag.png and corresponding LVGL C asset
    - Add ISO_7010_M025.png (mandatory-sign icon) and LVGL C asset
    - Add IncuNest_baby_logo.png, Incunest_logo_NOBG.png and LVGL C asset
    - Replace display_v1_audio.csv with hmi_16mb_ota.csv (16 MB OTA partition layout)
    [hmi_16mb_ota.csv]
2026-06-26 feat(hmi): v2.3.0 - alarm UI overhaul, humidity panel redesign, WiFi reconnect fix
    - Bump firmware version to 2.3.0
    - PCLK 18→20 MHz: fixes row-bleed on panels requiring ≥20 MHz gate isolation
    - LVGL PSRAM allocator: restore MALLOC_CAP_SPIRAM for heap_caps alloc/realloc
    - Bounce buffer 8→20 lines for smoother DMA transfer
    - Intro timeout 10→15 s to allow slower state-sync on boot
    - fan/heater alarm: hide entire TempCont instead of showing error overlay widgets;
    block temp switch-on and Label9/TempToggleBtn when fan or heater alarm is active
    - Photo timer container shown/hidden in sync with phototherapy switch state
    - Humidity panel: taller container (163→220 px), larger fonts (26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
    [CommTask.cpp, EEPROM.cpp, ElementsCreation.cpp, UITask.cpp, UITask.h, Wifi_OTA.cpp, Wifi_OTA.h]
2026-06-26 feat(motherboard): security refactor, bidirectional alarms, humidity threshold
    - evaluateAlarm() gains bidirectional=false param for |measured-setpoint| checks
    - Humidity alarm threshold lowered 12→10 %RH
    - ACTUATORS_ALARM_STABILIZATION_MINS constant (30 min) replaces magic number
    - heaterCriticalError latching logic removed: alarm state now re-evaluated each cycle
    - security.cpp reformatted to K&R brace style for readability
    - initHardware, main, EEPROM, CommTask, GPRS and Wifi_OTA minor fixes/updates
    - platformio.ini, board.h, task_config.h configuration updates
    [CommTask.cpp, EEPROM.cpp, GPRS.cpp, Wifi_OTA.cpp, board.h, initHardware.cpp, main.cpp]
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2026-06-26 feat(hmi): animate power bars on CTRL,DUTY, show/hide on control state changes
    - UI_UpdatePowerBars() calls lv_bar_set_value with LV_ANIM_ON for visible bars
    - UITask loop consumes g_pendingDutyApply inside LVGL lock
    - Switch_cb: show/hide on temp ON/OFF and hum ON/OFF
    - AirPanel_cb/SkinPanel_cb: swap bar visibility on panel switch
    - skin_mode_force_off: swap to AirPowerBar when forced back to air
    [UITask.cpp, UITask.h]
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2026-06-26 fix(ui): use fixed coords for power bars to avoid LVGL deferred layout bug
    lv_obj_align_to evaluated at creation time against placeholder "37" text
    (~55px); at runtime labels show "36.5" (~100px) so bars landed at the
    decimal point. Switch to absolute LEFT_MID + x/y positioning, all values
    from named defines. Also shift ui_Label24 (humidity desired) right to
    visually center it under the temperature values.
    [ElementsCreation.cpp, display_config.h]
2026-06-26 fix(ui): widen power bars and shift right to clear unit suffixes (°C, %)
    Temperature labels show "40.0°C" (~146 px) and humidity shows "95%" (~84 px).
    Previous x positions were calculated without unit text; bars overlapped the
    units. New positions: temp bars x=185, hum bar x=145 (both with 15 px gap
    after the unit character). Bar width doubled to 16 px for better visibility.
    [display_config.h]
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2026-07-02 fix(motherboard): replace bool sentinels with numeric literals, tune PWM and remove BQ25730 debug code
    - Replace false/true used as 0/1 placeholders across legacy UI, calibration,
    hardware init, security and updateData with explicit numeric/float literals
    - Increase PHOTOTHERAPY_PWM_FREQUENCY from 10kHz to 50kHz
    - Drop ARDUINO_USB_MODE/ARDUINO_USB_CDC_ON_BOOT build flags
    - Remove BQ25730_TEST debug dump/print helpers from main.cpp
    - Drop const from minDesiredTemp/maxDesiredTemp/presetTemp externs
    - Add photoFirstRun reset in actuatorsTest phototherapy checks
    - Add SensorBoard roadmap doc; rebuild flasher_tool firmware binaries
    [BQ25730.cpp, IncuNest_humidifier.cpp, PID.cpp, board.h, initHardware.cpp, main.cpp, security.cpp]
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2026-07-03 test: failing specs for usb_comm framing (red)
    Scaffold ESP-IDF v6 compilable (CMake raiz con COMPONENTS minimo,
    sdkconfig.defaults S3 N16R8, partitions 16MB OTA, main stub, usb_comm
    con stubs) + test app Unity comm_test con TEST_CASEs para cada Scenario
    del spec usb-transport: CRC16-CCITT (4), encoder (6), decoder (5,
    incluida longitud excesiva). Los tests compilan y fallan sobre stubs.
    Senales de reintento: el primer idf.py build fallo por un internal
    compiler error de GCC en esp_lcd (componente no usado); resuelto
    recortando el build con set(COMPONENTS main).
    [partitions.csv]
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2026-07-03 test: failing specs for env_sensors and status registry (red)
    Componente env_sensors (stubs puros: CRC-8 Sensirion, conversiones
    SHT4x, builder de evento posicional, conversion ALS) + registro
    sensorBoard_status_set_sensor stub en usb_comm. Test apps:
    env_sensors_test nuevo (12 TEST_CASE) y comm_test ampliado (4 tests
    de registro/status). Compilan y fallan sobre stubs.
    [sb_env_convert.c, sb_env_convert.h, sb_env_sensors.c, sb_env_sensors.h]
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2026-07-03 fix: review feedback fase 2 (code-reviewer + security-reviewer)
    Bloqueante medico: gate de plausibilidad de temperatura en sht40_read
    (-40..+125C del SHT4x) — un dato CRC-valido pero fuera de rango fisico
    ya no se publica como bueno hacia el lazo de control termico.
    Criticos/altos:
    - Persistido el handle del bus I2C principal + accessor interno
    sb_env_get_main_i2c_bus() (la Fase 5/SCCB no puede recrear el bus).
    - isfinite() en append_val: NaN/inf emitiria JSON invalido con CRC
    valido; ahora degrada a null (fail-safe).
    Medios/menores:
    - ESP_LOGE cuando la resp de status no cabe en 256B (fail-closed
    pero ya no mudo) + test del techo con 8 nombres al limite.
    - Constantes con nombre pa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
    [sb_env_convert.c, sb_env_i2c.h, sb_env_sensors.c]
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2026-07-03 test: failing specs for door_sensor (red)
    Componente door_sensor con fsm y builder puros en stub + test app
    door_test con 7 TEST_CASE (estado inicial, cambio estable unico,
    supresion de repetidos, polaridad, JSON exacto, fail-closed).
    Compila y falla sobre stubs.
    [sb_door_logic.c, sb_door_logic.h, sb_door_sensor.c, sb_door_sensor.h]
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2026-07-03 fix: review feedback fase 4 (code-reviewer + security-reviewer)
    Critico FreeRTOS: xTaskNotifyStateClear solo limpia el flag, no
    ulNotifiedValue — N flancos de rebote dejaban N-1 ciclos fantasma de
    debounce (250ms cada uno) retrasando la deteccion real. Sustituido por
    ulTaskNotifyValueClear(NULL, 0xFFFFFFFF).
    Altas (seguridad):
    - Re-asercion periodica del estado (CONFIG_SB_DOOR_REASSERT_S=30s):
    el modelo edge-only era lossy — un evento perdido por backpressure
    dejaba a la motherboard desincronizada indefinidamente.
    - ESP_LOGE si un evento de puerta se descarta (cola llena).
    - Anti-tormenta: gpio_intr_disable durante la ventana de debounce
    (un hall oscilante preemptaba a todo el sis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
    [main.c, sb_door_sensor.c]
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2026-07-03 test: failing specs for camera and binary transport (red)
    Registro de comandos (sensorBoard_cmd_register stub) + builders de
    capture en stub + tests: 4 de registro, 2 de guardas de send_binary
    (args invalidos / sin init — la implementacion actual devuelve
    NOT_SUPPORTED y fallan), round-trip binario TYPE=0x01 de 4KB, y
    camera_test nuevo con 4 tests de builders. Todo compila.
    [sb_cam_builder.c, sb_cam_builder.h]
2026-07-03 feat: implement camera_sensor and binary transport (green)
    usb_comm (reapertura acotada prevista desde Fase 1): registro de
    comandos (tabla estatica, dispatcher extendido tras status),
    send_binary con frame completo en PSRAM (fallback heap interna) y
    ownership transferido a la cola TX (item con puntero; usb_tx_task
    escribe por chunks con deteccion de stall y SIEMPRE libera).
    camera_sensor: esp32-camera 2.1.7 con pinout DVP de hardware.md,
    SCCB compartiendo el bus I2C principal via sccb_i2c_port=1 (validado
    que env_sensors lo creo antes), camera_task prio 3, handler capture
    que solo notifica (busy si hay captura en vuelo), resp ok/err + JPEG
    TYPE=0x01, sensors.cam. Init no fatal tras env_sen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
    [main.c, sb_cam_builder.c, sb_camera_sensor.c]
2026-07-03 fix: review feedback fase 5 (code-reviewer + security-reviewer)
    Criticos/altos (convergentes en ambas reviews):
    - Cola TX dividida: JSON (telemetria/heartbeat/resp) SIEMPRE drena
    primero; binarios en cola separada de profundidad 1 => cota dura de
    un JPEG en vuelo (PSRAM acotada) y un JSON urgente espera como mucho
    un frame (~600ms peor caso, budget de stalls reducido). Un flood de
    capture ya no puede inanizar la telemetria que gobierna actuadores.
    - JPEG SOLO en PSRAM: eliminado el fallback a DRAM interna (fail-safe:
    descartar la captura antes que competir con stacks/cJSON).
    Medios:
    - Respuestas desde contexto usb_rx con send_json_noblock (timeout 0):
    un flood de comandos no fre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
    [sb_cam_builder.c, sb_cam_builder.h, sb_camera_sensor.c]
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2026-07-04 feat(comm,tools): retencion de logs de arranque + monitor con reconexion
    Firmware: ring estatico de 24 frames JSON en usb_tx_task — sin host
    (DTR bajo) los frames se retienen en vez de descartarse y se vuelcan
    en orden al conectar: el arranque completo es visible aunque el
    puerto tarde en enumerar tras un reset (USB nativo re-enumera).
    La telemetria binaria no se retiene (solo JSON).
    monitor_sb.py: espera a que el puerto exista al arrancar y reconecta
    solo tras cada reset/re-enumeracion (holder compartido con el hilo
    de stdin, decoder reiniciado para descartar frames a medias).
    [monitor_sb.py]
2026-07-04 fix(comm): capturar el arranque completo en la retencion
    Tres causas de perdida de los primeros frames:
    - Nivel DEBUG: el escaneo I2C emite ~110 frames D-nack por bus y
    rotaba el ring => nivel por defecto a INFO (DEBUG via menuconfig).
    - El ring rotaba (ultimos N): ahora CONSERVA LOS PRIMEROS 32 frames y
    se congela — para diagnosticar un arranque importa el principio.
    - El interceptor se instalaba al final del init: ahora va antes de
    TinyUSB (colas primero), asi los logs del propio arranque USB entran
    al canal; main loguea "booting" tras comm_init (antes no hay canal).
    El fail path restaura vprintf.
    [main.c]
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2026-07-07 feat(motherboard): add fan RPM feedback NVS key, struct fields and error code
    [EEPROM.cpp, main.h, preferences_keys.h]
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2026-07-07 fix(motherboard): restore fan diagnostic on concurrent heater fault, document RPM read invariants
    [initHardware.cpp]
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2026-07-07 fix(motherboard): let fan RPM filter settle before reading it at boot
    filter_0 (the Butterworth filter behind fanSpeedHandler()) is stateful and
    had never been fed a sample before the boot RPM check calls it, so its
    cold-state first output was near zero and blew up FAN_RPM_CONVERSION/period
    to an absurd value (observed in the field: RPM in the trillions). Feed it
    real pulses for ~2s before trusting in3.fan_rpm.
    [initHardware.cpp]
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2026-07-08 fix(motherboard): send heater/humidifier duty as raw 0-255 PWM, zero on critical alarm
    CTRL,DUTY normalized the heater duty against the dynamic
    heaterSafeMAXPWM ramp instead of the fixed HEATER_MAX_PWM used by the
    log, so the HMI power bar and the serial log disagreed. It also never
    checked ongoingCriticalAlarm(), so the bar stayed non-zero even when
    PIDHandler() had already zeroed the physical heater output.
    Send the raw HeaterPIDOutput (already 0..PWM_MAX_VALUE) gated by
    ongoingCriticalAlarm(), and rescale the humidifier window duty to the
    same 0..PWM_MAX_VALUE range instead of a percentage.
    [CommTask.cpp, PID.h]
2026-07-08 fix(hmi): scale power bars to raw 0-255 PWM instead of percent
    Matches the motherBoard's CTRL,DUTY change to 0..PWM_MAX_VALUE: the
    bar range and the g_tempDutyPct/g_humDutyPct variables (and
    UI_UpdatePowerBars' params) are renamed to *Pwm to stop implying a
    0-100 percentage now that they carry the raw duty value.
    [CommTask.cpp, CommTask.h, ElementsCreation.cpp, UITask.cpp, UITask.h, display_config.h]
2026-07-08 fix(motherboard): alinear alarmTimerStart con restoreState y retirar calibracion muerta
    Tras validar en hardware la eliminacion de la UI legacy (commit anterior),
    tres ajustes pedidos por Pablo:
    - alarmTimerStart() gana un parametro assumeStabilized (default false). El
    arranque con restoreState (initHardware.cpp) lo llama con true: al
    resumir una sesion de control que ya estaba activa, TEMPERATURE_ALARM y
    HUMIDITY_ALARM se tratan como si la ventana de estabilizacion ya hubiera
    pasado, en vez de exigirle a la incubadora esperar otros 30 min tras un
    reinicio (no parte de un arranque en frio).
    - resetCalibration()/saveCalibrationToEEPROM() (EEPROM.cpp) eliminadas:
    quedaron sin ning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
    [EEPROM.cpp, initHardware.cpp, main.h, security.cpp]
2026-07-08 feat(shared): add AIR_BLOCKED_ALARM and fix HMI MAX_ALARMS to track it
    motherboard: no consumer yet (added in a later commit).
    hmi: MAX_ALARMS now tracks NUM_ALARMS instead of a stale hardcoded 10,
    so this and any future new alarm ID isn't silently dropped.
    [alarm_ids.h, main.h]
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2026-07-08 fix(motherboard): re-power fan during boot RPM checks, include AIR_BLOCKED_ALARM in ongoingAlarms()
    The boot RPM/duty checks (both HW>=16 and legacy paths) ran for several
    seconds with the fan's power line already cut, coasting to a stop instead
    of being driven. Also: AIR_BLOCKED_ALARM was missing from ongoingAlarms(),
    which would silence the buzzer while it's still active whenever any other
    alarm cleared.
    [initHardware.cpp, security.cpp]
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2026-07-08 fix(motherboard): power the fan when phototherapy alone activates it
    turnFans()'s FAN_PWM_CHANNEL (and the non-feedback FAN_CTL_PWM_CHANNEL
    fallback) were gated on mode alone instead of in3.fanCommandedOn
    (mode || in3.phototherapy), unlike ACTUATORS_EN and the HW<8 fallback which
    already handled this correctly. Phototherapy-only activation enabled
    ACTUATORS_EN and engaged fanControlPID (AUTOMATIC) but never actually
    powered the fan. Pre-existing bug, found via manual testing; not introduced
    by the fan RPM feedback/speed control work on this branch.
    [Actuators.cpp]
2026-07-08 fix(motherboard): stop false FAN_ISSUE/AIR_BLOCKED alarms on fan startup
    Field failure: enabling temperature control fired AIR_BLOCKED_ALARM
    immediately and FAN_ISSUE_ALARM at 3s, cutting the fan (spins briefly,
    then stops). Four causes, four fixes:
    - fanSpeedHandler(): the first encoder edge after an idle gap pairs a
    fresh timestamp with one from the last time the fan spun, producing a
    huge bogus period that poisons the stateful Butterworth filter for
    hundreds of samples, holding fan_rpm near 0 well past the grace
    period. Discard periods longer than the zero-RPM timeout window.
    - FAN_SPINUP_GRACE_MS 3000 -> 6000: the fan physically takes ~3s to spin
    up; 3s grace had zero margin f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
    [board.h, initHardware.cpp, main.cpp, security.cpp, sensors_module.cpp]
2026-07-08 fix(motherboard): retune fan PID and seed it at baseline duty on engage
    The fan revved up hard and braked hard in a limit cycle. Two causes:
    - Gains ~15x too hot for the plant: it needs ~137/255 duty for 4000 rpm
    (~29 rpm per duty count), so KP=0.5 alone slammed the output rail to
    rail for errors as small as 500 rpm, fighting the few-hundred-ms lag
    of the 6th-order Butterworth on the measured RPM. Resized to
    KP=0.03/KI=0.05 for a ~1 rad/s crossover; comment documents the
    sizing rationale for bench trimming.
    - The loop engaged with output seeded at 0, so the integrator wound up
    through the entire spin-up and overshot. PID_v1 latches *myOutput
    into its integral sum on the MANUAL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
    [Actuators.cpp, PID.h, initHardware.cpp]
2026-07-08 fix(motherboard): soft-start fan open-loop, close PID after spin-up
    The fan overshot to ~6000rpm on a 4000 target at startup. Cause: the PID
    engaged AUTOMATIC the instant the fan was commanded on, so it ran through
    the entire ~3s mechanical spin-up chasing a lagged, still-ramping RPM
    measurement (6th-order Butterworth) and wound the duty far past the
    baseline that already holds 4000.
    Fix: turnFans() now holds the calibrated baseline duty open-loop while the
    fan spins up (open-loop can't overshoot its own steady speed), and
    PIDHandler() closes the loop bumplessly only after FAN_SPINUP_GRACE_MS,
    seeding the integral at that baseline. FAN_SPINUP_GRACE_MS moved to board.h
    so PID.cpp and securit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
    [Actuators.cpp, PID.cpp, board.h, security.cpp]
2026-07-09 feat(motherboard): runtime toggle for fan PID + report fan PWM to ThingsBoard
    - New in3.fanPidEnabled (NVS KEY_FAN_PID_EN, default FAN_PID_ENABLED_DEFAULT).
    When false, the fan runs at the fixed fanCtlPWM duty with the closed-loop
    PID bypassed (same path as a no-feedback unit) and AIR_BLOCKED_ALARM is not
    evaluated. Editable in the WiFi /config page ("Fan Speed PID" dropdown)
    and over USB (FAN_PID_EN param); applied immediately via setFanPidEnabled().
    - New fan_pwm telemetry key: the applied fan control duty in raw 0-255 counts
    (PID output when closed-loop, else fanCtlPWM), sent on both GPRS and WiFi
    while the fan is commanded on, next to fan_rpm.
    [Actuators.cpp, CommTask.cpp, EEPROM.cpp, GPRS.cpp, PID.cpp, Wifi_OTA.cpp, board.h, initHardware.cpp]
2026-07-10 fix(hmi): reduce RGB LCD screen drift (bounce buffer 24 lines + diagnostics)
    Bounce buffer 20->24 lines (exact divisor of 480, wider drain margin vs CPU/
    bus jitter; ~+12.8KB SRAM, heap headroom verified with WiFi connected), added
    LCD frame-finish/underrun diagnostics, and WiFi.persistent(false) to avoid NVS
    sector-erase stalls. platformio.ini carries a documented (not-yet-applied)
    investigation note on the CONFIG_SPIRAM_FETCH_INSTRUCTIONS/RODATA mitigation
    blocked by the local MSYS2/CMake toolchain.
    [UITask.cpp, Wifi_OTA.cpp]
2026-07-10 fix(motherboard): guard phototherapy PWM extrapolation against out-of-range result
    A near-zero photo current made the 1/x extrapolation blow up toward/past
    PWM_MAX_VALUE. Now only commit phototherapy_intensity/clear photoFirstRun when
    the raw unclamped result is in range; otherwise flag the error and fall back
    to the safe PHOTOTHERAPY_INITIAL_PWM_PCT default instead of maxing the light.
    Applied to both HW>=16 and legacy actuatorsTest() paths.
    [initHardware.cpp]
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2026-07-11 refactor(motherboard): remove remaining dead HW_NUM<16 branches found in sweep (phase 2e of legacy cleanup)
    Exhaustive HW_NUM grep over board.h, main.h, initHardware.cpp, CommTask.cpp,
    and sensors_module.cpp turned up several dead branches Tasks 3-6 missed since
    their scans were samples, not exhaustive:
    - board.h: dead HW_NUM<=8/==9 branch of SCREEN_BRIGHTNESS_FACTOR (its
    condition combines HW_NUM with HW_REVISION, unlike the simpler patterns
    earlier tasks searched for)
    - main.h: always-true HW_NUM!=6 wrapper around CURRENT_STABILIZE_THRESHOLD_RATIO,
    and always-false HW_NUM==6 branch of ENCODER_TICKS_DIV
    - initHardware.cpp: several always-true HW_NUM>=16/>=6/>=9 wrappers (I2C2 init,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
    [board.h, initHardware.cpp, main.h]
2026-08-03 fix(motherboard): cap crash log retention to bound boot-time directory scan
    crash_mb_/crash_hmi_ logs are only deleted locally once driveUploadTask
    processes them (upload OK, upload failed, or no network) — but a crash
    loop reboots faster than that task can ever get scheduled, so logs pile
    up indefinitely across reboots. Each un-uploaded log costs ~47ms in the
    LittleFS directory scan that already runs every boot in initDriveUpload();
    166 accumulated logs measured on a bench unit added an 8.3s silent gap
    between "HARDWARE OK" and the AFE4490 init log.
    The same scan now keeps only the DRIVE_CRASH_LOG_RETENTION_CAP (5) most
    recent files per prefix and deletes the rest outright, independent o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
    [DriveUpload.cpp]
2026-08-03 fix(motherboard): stop startPID() from zeroing Ki on every HMI heartbeat
    Communication_Receiver() calls startPID(in3.controlMode) on every HMI
    command, not only on a genuine OFF->ON transition or setpoint change.
    startPID() unconditionally re-zeroed Ki each time, so with KP_AIR=150
    saturating the proportional term below ~1.7C error, closing the last
    fraction of a degree depended almost entirely on integral action that
    kept getting wiped out before it could finish - the air loop would
    track close to setpoint but never fully reach it.
    - startPID() is now idempotent: skip re-init if the requested loop is
    already AUTOMATIC.
    - PIDHandler()'s anti-windup for the air loop is now symmetric: it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
    [PID.cpp]
2026-08-03 chore(motherboard): relocate build-identity macros to main.h, bump FWversion, disable verbose logging
    HW_REVISION/HWversion/FWversion/WIFI_NAME/CURRENT_FIRMWARE_TITLE lived in
    board.h even though they are firmware-identity constants, not hardware-
    revision config - move them next to the rest of main.h's build-time
    switches and bump FWversion 17.4 -> 17.5.
    Also flip LOG_MODEM_DATA/LOG_INFORMATION/LOG_ERRORS/LOG_ALARMS/
    LOG_PULSIOXIMETRY/LOG_DRIVE/LOG_CHARGER to false for this build.
    [main.h]
2026-08-03 fix(motherboard): re-enable heater current-limit check disabled by missing macro
    PID.cpp's heaterPowerConsumptionCheck() has gated its current-based
    throttling behind HEATER_CURRENT_LIMIT_ENABLED since the last commit,
    but that macro was never actually defined - an undefined macro in
    #if evaluates to 0, so #if !HEATER_CURRENT_LIMIT_ENABLED was silently
    taking the "disabled" branch and pinning heaterSafeMAXPWM at
    HEATER_MAX_PWM with no current-based ramp at all. Define it true in
    board.h to restore the intended behavior.
    Also drop the HW_NUM==17 override that forced heaterMaxPowerAmps to
    the compiled HEATER_MAX_POWER_AMPS default regardless of what was
    stored in NVS - HW17 now follows the sa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
    [EEPROM.cpp, board.h]
2026-08-03 feat(motherboard): persist HMI-driven setpoint changes to NVS for restoreState boots
    Communication_Receiver() updated in3.desiredControlTemperature/
    desiredControlHumidity from HMI commands in memory only. A
    restoreState boot (crash/WDT) re-reads KEY_CTRL_TEMP/KEY_CTRL_HUM from
    NVS via recapVariables(), so the PID restarted at whatever was last
    persisted - the compiled-in preset default if the user had changed the
    setpoint since the last explicit save, not the value actually in use
    before the crash.
    Write the new setpoint to NVS whenever it actually changes, so a
    restoreState boot resumes control at the setpoint the user configured.
    [main.cpp]
2026-08-03 refactor(motherboard): make alarmTimerStart's restoreState grace period configurable
    alarmTimerStart(bool assumeStabilized) only supported two grace values
    for TEMPERATURE_ALARM/HUMIDITY_ALARM after a restart: the full
    ACTUATORS_ALARM_STABILIZATION_MINS wait or none at all. Replace the
    bool with alarmTimerStart(long graceMinutes) so a restoreState boot can
    use its own RESTART_ALARM_GRACE_MINS - short re-sync pause instead of
    either extreme - while a fresh activation still defaults to the full
    stabilization window (unchanged behavior).
    Move ACTUATORS_ALARM_STABILIZATION_MINS/RESTART_ALARM_GRACE_MINS to
    main.h since initHardware.cpp's restoreState resume path needs them
    alongside security.cpp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
    [initHardware.cpp, main.h, security.cpp]
2026-08-03 fix(hmi): add exponential backoff to WiFi reconnect retries
    A prolonged AP outage (NO_AP_FOUND observed in the field for 50+
    minutes straight) made WifiOTAHandler() hammer wifiInit() every
    WIFI_RECONNECT_INTERVAL (30s) indefinitely, and each attempt's NVS
    write could desync an LCD frame (see UITask.cpp's LCD_DIAG).
    Double the retry interval on each consecutive failed reconnect up to
    WIFI_RECONNECT_MAX_INTERVAL (5 min), resetting back to the base
    interval on the next STA_GOT_IP.
    [Wifi_OTA.cpp, Wifi_OTA.h]
2026-08-03 chore(hmi): add wifi_off_test bench environment for LCD glitch A/B testing
    New [env:wifi_off_test] build (DISABLE_WIFI_TEST) skips CreateOTATask()
    entirely, isolating whether the WiFi/OTA stack is the source of
    observed LCD glitching. lcd_diagnostics_log() now always logs (not
    only on GLITCH DETECTED) at 3s resolution instead of 10s, to correlate
    sub-threshold frame contention with glitches seen without a matching
    WiFi/flash log event.
    [UITask.cpp, main.cpp]
2026-08-03 feat(motherboard): add HW_NUM 18 support, bump FWversion to 18.1
    New [env:IncuNest_V18] (-DHW_NUM=18), reusing hal_hw17.cpp's pinout -
    HW18 is the same pin mapping as HW17, only current-sense calibration
    changes.
    HEATER_CURRENT_CORRECTION_FACTOR was a HW17-only workaround for a PCB
    layout bug (INA3221 IN+ tapping the MOSFET switching node) - HW18 fixes
    that wiring, so heater_current no longer needs the correction
    (sensors_module.cpp's #if (HW_NUM == 17) around it already scopes it
    correctly and needed no change).
    HW18 shunt values: SYSTEM_SHUNT 5 mΩ, HEATER_SHUNT 2 mΩ.
    FAN_SHUNT/PHOTOTHERAPY_SHUNT/USB_SHUNT/BATTERY_SHUNT stay the same as
    HW17 (100/5/100/27000 mΩ).
    Split board.h's HW_NU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
    [board.h, main.h]
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2026-08-13 fix(motherboard): corregir el offset ADC de VBAT/VSYS del BQ25730
    El offset depende del strap CELL_BATPRESZ: 2.88 V en modo 1S-4S y 8.16 V en
    5S. Esta placa es la variante plomo-acido 12V (1S-4S), pero el driver usaba
    8192 mV, asi que una VBAT real de ~13.4 V se decodificaba como ~18.5 V.
    [BQ25730.h]
2026-08-13 fix(motherboard): limpiar las alarmas latcheadas al desactivar el control
    evaluateAlarm() es el unico sitio que puede bajar TEMPERATURE_ALARM /
    HUMIDITY_ALARM, y solo se llamaba con el control activo. Si el control se
    apagaba con la alarma latcheada, esta se quedaba encendida para siempre
    (alarma fantasma, familia de docs/known_issues.md #1). Ahora la rama de
    control desactivado resetea la alarma en curso.
    [security.cpp]
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2026-08-13 fix(hmi): ajustar el rango de edad gestacional del wizard a 20-40 semanas
    El wizard de datos de bebe aceptaba 24-42 semanas. El rango operativo
    pasa a 20-40: admite prematuros extremos por debajo de 24 y deja de
    ofrecer 41-42.
    Aviso: la tabla NTE (shared/src/nte_table.cpp) solo cubre gestWeeks >= 24,
    asi que una EG de 20-23 se guarda en el perfil pero calculateNteRange
    devuelve rango no valido (fail-safe, sin crash). Extender la tabla para
    20-23 es un cambio aparte en shared/ con sus tests.
    Verificacion: pio run -e main SUCCESS. Sin prueba en el CrowPanel real
    todavia (solo cambian dos constantes de validacion y el texto del hint).
    [BabyWizard.cpp]
2026-08-13 fix(hmi): reconectar el WiFi en <=60s tras volver el AP
    El tope del backoff de reconexión (WIFI_RECONNECT_MAX_INTERVAL) era de 5
    minutos, así que el HMI podía quedarse desconectado hasta 5 min con el AP ya
    disponible. En campo solo reconectaba al pulsar "Conectar" en ajustes, que
    conecta en ~180 ms con exactamente las mismas credenciales.
    La premisa que justificó ese tope en 1901cb5 ("cada reintento es una escritura
    NVS -> glitch LCD") ya no aplicaba: WiFi.persistent(false) eliminó esa
    escritura en f4115c3, tres semanas antes. Medido en el log de campo, cada
    WiFi.begin() cuesta 5-20 ms y el panel no se entera (LCD_DIAG: worst_frame
    ~20.7 ms estable durante los reintentos).
    - Tope 300s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
    [UITask.cpp, Wifi_OTA.cpp, Wifi_OTA.h]
2026-08-14 fix(hmi): ocultar la grafica PPG cuando la sonda satura al retirarla
    La libreria incunest_afe4490 v0.53 clasifica el canal saturado por exceso de
    luz como un cuarto estado, PROBE_SATURATING=3, que es justo lo que ocurre al
    retirar la sonda: queda expuesta a la luz ambiente y el ADC se va al rail
    positivo. La motherboard reenvia el valor crudo, pero el HMI validaba
    state <= SPO2_PROBE_APPLIED (2) y descartaba el mensaje, asi que
    ctrl_probe_msg.updated no se activaba y el flanco de bajada que oculta la
    grafica y el recuadro de HR nunca llegaba a ejecutarse. La traza quedaba
    congelada porque la placa si corta el CTRL,PPG al perder el APPLIED.
    Ahora un estado parseable nunca se descarta: solo A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
    [CommTask.cpp, CommTask.h, ElementsCreation.cpp, UITask.cpp]
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2026-08-14 chore(motherboard): desactivar el logging verboso por defecto
    Apaga LOG_MODEM_DATA, LOG_INFORMATION, LOG_ERRORS, LOG_ALARMS, LOG_DRIVE
    y LOG_CHARGER. Va en su propio commit, separado del cambio de politica de
    transporte con el que compartia fichero, para que revertirlo sea trivial.
    Pendiente de revisar: apagar LOG_ERRORS y LOG_ALARMS deja sin traza los
    incidentes de alarma en campo, que es justo lo que hace falta para
    investigar un evento en un equipo medico.
    [main.h]
2026-08-14 feat(motherboard): contabilizar los minutos de humedad por bebe
    Anade humidityMinutes al perfil de bebe, junto a los contadores de
    fototerapia y de control termico que ya existian. Cuenta cualquier
    actuacion que incluya humedad (act=2 o act=3), asi que un tramo con
    temperatura y humedad suma en thermoMinutes y en humidityMinutes a la vez.
    El registro de historial pasa de 55 a 59 bytes. Se conserva el tamano
    anterior como BABY_HISTORY_RECORD_SIZE_LEGACY_V1 para que babyStore_init()
    reconozca un log escrito por un firmware antiguo y lo resetee, en lugar de
    leerlo con el stride equivocado y decodificar basura como si fuera un
    registro clinico.
    Protocolo v2.1.0: CTRL,PROFILE_LIST y CTRL,PROFIL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
    [CommTask.cpp, telemetry_keys.h]
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2026-08-15 feat(shared): conjunto de alarmas y prioridades segun IEC 60601
    Reescribe el enum AlarmId de shared/alarm_ids.h con las 16 condiciones
    de alarma derivadas de IEC 60601-2-19 y su prioridad segun la Tabla 1
    de IEC 60601-1-8, expuesta via alarm_priority() en el nuevo modulo
    shared/alarm_policy. Se mantienen NO_ALARMS/NUM_ALARMS como alias de
    compatibilidad.
    Corrige ademas un desbordamiento de buffer latente en motherBoard/state.h:
    alarmToReport tenia un tamano de 10 escrito a mano que quedaba corto
    frente a las 16 condiciones nuevas indexadas por AlarmId; ahora usa
    ALARM_COUNT y el header incluye alarm_ids.h.
    alarm_machine_any_critical() usaba 4 identificadores de alarma que
    dejaron de existi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
    [alarm_ids.h, alarm_policy.cpp, alarm_policy.h]
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2026-08-15 fix(motherboard): acotar los umbrales de corte termico a 38/40 C
    El comando USB (CommTask.cpp) y la pagina /config (Wifi_OTA.cpp)
    escribian in3.airTemperatureSetMax / in3.skinTemperatureSetMax sin
    ningun limite: hoy se podia poner el corte termico en 45 C desde un
    navegador. Ambas rutas pasan ahora por alarm_clamp_air_cutout() /
    alarm_clamp_skin_cutout() antes de persistir en NVS.
    Tambien se acota la restauracion en el arranque (EEPROM.cpp): un valor
    persistido antes de este cambio, o corrupto, ya no puede superar el
    tope normativo al recargarse.
    [CommTask.cpp, EEPROM.cpp, Wifi_OTA.cpp]
2026-08-15 feat(motherboard): detectar condiciones contra la maquina de alarmas normativa
    security.cpp deja de mantener estado propio de alarmas: detecta condiciones
    fisicas y se las pasa a alarm_machine_condition(). Desaparecen alarmOnGoing[],
    displayAlarm[], clearedAlarm[], evaluateAlarm(), setAlarm() y resetAlarm().
    Cambios de comportamiento que exige IEC 60601-2-19:
    - 201.15.4.2.1 dd)/ee): la desviacion de temperatura pasa de una condicion
    bidireccional con umbral de 1 C a cuatro condiciones direccionales, +-3 C en
    control por aire y +-1 C en control por piel. El calefactor solo se corta por
    el lado caliente; por el frio tiene que seguir calentando.
    - 201.12.3.102: el fallo de sonda de piel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
    [CommTask.cpp, GPRS.cpp, Wifi_OTA.cpp, initHardware.cpp, main.cpp, main.h, security.cpp, sensors_module.cpp]
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2026-08-15 fix(motherboard): no inhibir el corte de calefactor durante la estabilizacion
    Tres correcciones de la revision de la Task 9.
    C-1 (critico): la ventana de estabilizacion multiplicaba las cuatro
    desviaciones de temperatura, asi que dentro de ella la condicion se declaraba
    false, alarm_machine_heater_must_cut() no la veia y el calefactor NO se
    cortaba. Cuando esa desviacion solo encendia un aviso era inofensivo; al
    convertirla en la puerta de un corte que 60601-2-19 clasifica como ESSENTIAL
    PERFORMANCE, la supresion paso de silenciar a inhibir una proteccion — y por
    el offset de alarmTimerStart(), justo durante los primeros 30 min de vida del
    equipo, que es la rampa de calentamiento desde fr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
    [security.cpp]
2026-08-15 fix(motherboard): no borrar el autotest de obstruccion ni alarmar al calentar
    Dos regresiones introducidas por la ronda anterior de correcciones.
    N-1: retirar la condicion en las salidas tempranas de checkAirBlockage()
    borraba el resultado del autotest de arranque. initHardware.cpp declara
    ALARM_AIR_OUTLET_BLOCKED cuando el duty medido en banco supera el umbral y
    acto seguido deja el PID del ventilador en MANUAL con el ventilador cortado,
    asi que el primer securityCheck() salia por GetMode() != AUTOMATIC y tiraba el
    hallazgo; y si turnFans() reenganchaba el lazo, lo volvia a tirar la salida de
    spin-up. Se anade la bandera hasObservedClosedLoop: hasta que la funcion no ha
    medido de verdad un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
    [security.cpp]
2026-08-15 fix(motherboard): contar la ventana de estabilizacion desde la activacion
    Ronda 3 de correcciones de la Task 9.
    R-1: hasObservedClosedLoop protegia el resultado del autotest de arranque,
    pero si checkAirBlockage() nunca llegaba a medir, la declaracion quedaba
    congelada con heater_must_cut() en true y sin via de limpieza — la condicion
    no es latching, asi que el reset manual la rechaza. Disparo concreto: el
    autotest declara obstruccion y el operador desactiva in3.fanPidEnabled
    (conmutable en caliente y persistido) antes de la primera medida en lazo
    cerrado; PIDHandler() ya no vuelve a poner AUTOMATIC y el calefactor queda
    cortado indefinidamente. Con el PID del ventilador deshabilitado la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
    [security.cpp]
2026-08-15 fix(hmi): adaptar las referencias al nuevo conjunto de alarmas
    Actualiza los identificadores del enum de alarmas tras su renombrado en
    shared/alarm_ids.h y corrige lib_deps en platformio.ini (lib_extra_dirs
    no compilaba shared/src/*.cpp, igual que le pasaba a motherBoard).
    UI_IsCriticalAlarmActive() ahora delega en alarm_cuts_heater() de
    shared/alarm_policy.h en vez de mantener una copia manual del conjunto
    critico, eliminando la duplicacion que forzo este arreglo.
    [UITask.cpp, main.h]
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2026-08-15 fix(motherboard): el audio de alarma deja de cesar por tiempo (60601-1-8 6.10)
    buzzerAlarmUpdate() sustituye el disparo por flanco de driveAlarmBuzzer() y
    retira el contador de agotamiento de la maquina vieja (se apagaba solo a
    los ~250 s). El motor nuevo se gobierna por prioridad activa en cada ciclo
    de securityCheck(), asi que un cambio a una prioridad mas alta toma el
    canal de inmediato sin esperar a que termine la rafaga en curso, en vez de
    quedar mudo mientras audio_required() ya fuera true (hallazgo de la
    revision de la tarea 9). Se retiran buzzerAlarmTone/BeepTime/BeepCount de
    main.h, dead code el primero e inutil el resto tras el cambio de motor.
    [Buzzer.cpp, main.h, security.cpp]
2026-08-15 fix(hmi): revertir la delegacion en alarm_cuts_heater para el criterio de interrupcion de la UI
    alarm_cuts_heater() responde si hay que cortar el calefactor, no si hay
    que interrumpir el asistente: son preguntas distintas y su parecido
    anterior era casualidad, no diseno. UI_IsCriticalAlarmActive() vuelve a
    tener su propia lista, mapeo 1:1 del conjunto viejo (TEMPERATURE_ALARM,
    AIR_THERMAL_CUTOUT_ALARM, SKIN_THERMAL_CUTOUT_ALARM, FAN_ISSUE_ALARM) a
    los IDs nuevos, incluyendo las cuatro variantes de desviacion de
    temperatura ya que la condicion vieja era simetrica.
    Se mantiene el arreglo de platformio.ini (symlink://../shared en vez de
    lib_extra_dirs): corrige un defecto real de compilacion,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
    [UITask.cpp]
2026-08-15 fix(motherboard): el zumbador arranca la rafaga ya y usa la prioridad audible real
    C-1: buzzerAlarmUpdate() esperaba el periodo completo entre rafagas (10-30 s)
    antes del primer pulso al activarse o al escalar de prioridad, dejando la
    alarma muda justo cuando mas importaba sonar de inmediato. Ahora arranca el
    primer pulso en el mismo ciclo en que se detecta la activacion o el cambio
    de prioridad; el periodo entre rafagas solo aplica a rafagas sucesivas de un
    patron que ya esta sonando.
    C-2: driveAlarmBuzzer() alimentaba el zumbador con alarm_machine_top_priority(),
    que incluye SILENCED/ACKED para la señal visual. Una ALTA silenciada le
    prestaba su prioridad al audio de una BAJA activa dist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
    [Buzzer.cpp, security.cpp]
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2026-08-15 fix(motherboard): completar media rafaga de ALTA con 1500 ms, no 1200
    ALARM_MIN_BURST_MS_HIGH valia 1200 ms, pero el patron que reproduce
    buzzerAlarmUpdate() usa pulsos de 150 ms con huecos de 150 ms: media rafaga
    de prioridad ALTA son 5 pulsos, es decir 5*150 + 4*150 = 1350 ms hasta el
    final del quinto. Con 1200 ms el audio se cortaba tras el CUARTO, y 6.10
    exige media rafaga completa.
    Las dos familias de constantes nacieron en tareas distintas que no se vieron.
    Se atan con un comentario en ambos sentidos —la aritmetica escrita en
    alarm_machine.h, la advertencia en main.h junto a las constantes de pulso—
    para que no puedan volver a divergir en silencio.
    [main.h]
2026-08-15 fix(hmi): derivar los anchos de CTRL,ALM de los buffers y no hardcodearlos
    El parseo de CTRL,ALM usaba "%31[^,]" para los dos campos de texto. El ancho
    de %[...] no trunca: sscanf para al llenarlo, no encuentra la coma que el
    formato exige a continuacion, devuelve 3 campos en vez de 4 y la LINEA ENTERA
    se descarta. Las descripciones que escribio esta rama son frases clinicas de
    hasta 43 caracteres —28 de las 48 pasan de 31—, asi que en espanol, el idioma
    por defecto, 12 de las 16 alarmas no llegaban a la pantalla: ni tarjeta, ni
    identidad, ni prioridad, mientras el zumbador sonaba. No habia segunda via,
    porque la sincronizacion por bitmask del display solo apaga slots.
    Habia ademas un d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
    [CommTask.cpp, alarm_ids.h, alarm_text.cpp, alarm_text.h, main.h, protocol.h, security.cpp]
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2026-08-15 fix(motherboard): caducar la ventana de rafaga en el tick y no al consultarla
    audio_hold_pending() solo se alcanzaba con la entrada en INACTIVE, por el
    cortocircuito del || en entry_requires_audio(). Mientras la condicion estaba
    ACTIVE el flag quedaba armado y audio_hold_until_ms congelado en el instante
    de la activacion. Si una condicion non-latching aguantaba ACTIVE mas de 2^31
    ms y despues el detector la retiraba, la resta con signo volvia a ser negativa
    y reaparecia exactamente el fallo de la ronda anterior: zumbador sonando,
    bitmask a 0, sin senal visual, sin CTRL,ALM, y esta vez sin poder forzar
    siquiera silence()/ack(), porque la entrada ya estaba INACTIVE. El audio
    fantasma duraba 24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
    [security.cpp]
2026-08-15 fix(motherboard): cablear el boton de silencio del display al audio de alarma
    El campo muteAlarm que el display envia en su trama de comandos llegaba a
    hmi_cmd_msg.muteAlarm y no se usaba para nada: solo se registraba en log y se
    devolvia en el eco de la trama de estado. El unico camino de silencio era
    encSwitchHandler(), que leia el pulsador de un encoder fisico de una revision
    de hardware anterior que ya no se monta, asi que era codigo inalcanzable.
    Resultado: el boton de silencio del display no silenciaba nada. El defecto es
    anterior a esta rama —la motherboard tampoco actuaba sobre muteAlarm en
    0d0f03c— pero quedaba tapado porque el zumbador se agotaba solo a los ~4
    minutos. Al cerr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
    [CommTask.cpp, ISR.cpp, main.h, security.cpp]
2026-08-15 fix(motherboard): fijar FAN_DUTY_BLOCKED_THRESHOLD en 190 con su razonamiento
    El umbral valia 160 y el propio comentario admitia que no estaba calibrado.
    160 es un valor peligroso, y no por falta de calibracion sino por donde cae:
    el duty de fabrica para sostener FAN_TARGET_RPM con la salida limpia es 137, y
    con el calefactor a maxima potencia la tension se hunde y el PID sube el duty
    para mantener las rpm hasta ~158 con una caida del 10-15%. Es decir, 160 esta
    justo encima de la compensacion legitima, asi que un pico normal disparaba la
    alarma — y desde que AIR_BLOCKED corta el calefactor, ese falso positivo
    enfria al bebe.
    190 son linea base +53 (+39%), holgadamente por encima de esa co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
    [board.h]
2026-08-15 fix(hmi): mostrar el boton de silencio cuando hay una alarma activa
    Verificado en banco: el boton de silencio no aparecia nunca. ui_MuteAlarm se
    crea en ui_ScreenAlarms y se oculta al arrancar, y MuteAlarm_cb() lo vuelve a
    ocultar al pulsarlo, pero no habia ni un solo lv_obj_clear_flag() en todo el
    fichero. El callback funcionaba; lo que faltaba era hacerlo visible.
    Es un defecto preexistente, no introducido por esta rama, y pasaba
    desapercibido porque el zumbador de la motherboard se agotaba solo a los ~4
    min: nadie echaba de menos poder callarlo. Desde que el audio solo cesa por
    accion del operador (IEC 60601-1-8 6.10) es la diferencia entre una alarma que
    se puede silenciar y una que no.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
    [UITask.cpp]
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2026-08-15 fix(shared): decir que el corte termico es una averia, no un ciclo normal
    El titulo pasa de "CORTE TERMICO AIRE/PIEL" a "FALLO TERMICO AIRE/PIEL" y la
    descripcion de "CALEFACTOR CORTADO - REVISAR AL BEBE" a "CALEFACTOR CORTADO -
    REVISAR AL BEBE - AVERIA: AVISO FIJO HASTA REINICIAR", en los tres idiomas.
    Motivo: que el corte termico salte significa que el termostato ha fallado, y
    201.15.4.2.1 aa) lo describe exactamente asi. "Corte" sugiere que el equipo se
    esta protegiendo de una situacion pasajera; "fallo" dice lo que de verdad
    pasa. La alarma es latching y solo se limpia apagando el equipo, lo cual es
    correcto para una condicion de servicio, pero el operador tiene que saberlo o
    creera que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
    [alarm_text.cpp]
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2026-08-15 feat(hmi): centro de alarmas con registro y pop-up de descripcion
    Sustituye ui_ScreenAlarms como destino de todas las vias de entrada a alarmas
    por un overlay con la misma presentacion de tarjetas que el historial de
    bebes: alarmas activas arriba, registro de las ultimas 10 debajo, y un pop-up
    con la descripcion al pulsar cualquiera de las dos.
    Cuelga de lv_layer_top() y no de una pantalla, asi que se abre igual desde el
    bloqueo sin tener que desbloquear primero — que era el camino largo justo
    cuando hay prisa.
    Arregla ademas que el registro fuese inaccesible en el estado mas comun. Sin
    alarmas activas se ocultan las DOS vias (ui_AlarmButton en la barra y el badge
    del bloqueo) y en su si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
    [AlarmCenter.cpp, CommTask.cpp, CommTask.h, ElementsCreation.cpp, UITask.cpp, main.h]
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2026-08-15 fix(hmi): dirigir el badge del bloqueo al centro de alarmas
    ui_event_AlarmLockImg/ui_event_AlarmLockCont son los handlers realmente
    registrados sobre el badge y seguian cargando ui_ScreenAlarms. Los homonimos
    AlarmLockImg_cb/AlarmLockCont_cb de UITask.cpp, que si se habian redirigido,
    no estan enganchados a nada.
    [ElementsCreation.cpp]
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2026-08-15 fix(shared): reaparecer el boton de silencio cuando el audio vuelve
    El operador silenciaba una alarma, el zumbador volvia solo a los 2 min
    —correcto, 60601-2-19 201.12.3.104 exige que las alarmas silenciadas reanuden
    su funcion— y el boton de silencio ya no volvia a aparecer: la alarma se
    quedaba sonando sin forma de callarla.
    La causa era que el HMI guardaba el silencio en una copia local que solo se
    limpiaba al irse todas las alarmas o al llegar una nueva. La caducidad de la
    pausa ocurre en la placa y el display no se enteraba.
    El campo mute de CTRL,STATE devolvia g_last_cmd.muteAlarm, es decir, el eco de
    lo que el propio display habia pedido: no lo consumia nadie y ademas mentia.
    Ah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
    [CommTask.cpp, UITask.cpp, security.cpp]
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2026-08-15 fix(hmi): reevaluar el banner en cada pasada, no solo al cambiar las alarmas
    El banner seguia viendose fuera de la pantalla de bloqueo pese al commit
    anterior. La condicion estaba bien; el problema es que nadie la volvia a
    evaluar: alarm_banner_update() solo se llamaba desde update_alarm_panels(),
    que corre con g_pendingAlarmUpdate, o sea cuando llega un CTRL,ALM.
    El banner cuelga de lv_layer_top() y ese no se entera de los lv_scr_load(),
    asi que al salir del bloqueo hacia cualquier otra pantalla se quedaba pintado
    hasta el siguiente cambio de alarma. Antes no se notaba porque la pantalla
    solo decidia la POSICION (arriba o abajo); desde que decide la VISIBILIDAD, el
    calculo perezoso es el b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
    [UITask.cpp]
2026-08-15 fix(hmi): el registro de alarmas llegaba siempre vacio
    Dos fallos encadenados, los dos en el lado del display.
    1. Colision de prefijo en el despachador. La rama de CTRL,ALM comparaba
    strlen("CTRL,ALM") = 8 caracteres, y "CTRL,ALM" es prefijo de
    "CTRL,ALM_HISTORY" y de "CTRL,ALM_DESC". Al ser una cadena else-if, esa
    rama se tragaba las respuestas del historial y del detalle, intentaba
    parsearlas como un evento de alarma, fallaba el conteo de campos y las
    descartaba en silencio. Las ramas que las atendian eran codigo muerto: el
    registro nunca se rellenaba y el detalle de una entrada decia siempre
    "descripcion no disponible". Ahora se compara "CTRL,ALM," con la coma.
    2. E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
    [AlarmCenter.cpp, CommTask.cpp]
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2026-08-15 fix(hmi): el chasquido sonaba al tocar el fondo
    El filtro miraba LV_OBJ_FLAG_CLICKABLE, que no distingue nada: LVGL lo pone en
    el constructor de TODOS los objetos (lv_obj.c, `obj->flags =
    LV_OBJ_FLAG_CLICKABLE`), asi que pantallas y paneles decorativos tambien lo
    llevan.
    Ahora la pregunta es la util —si tocar eso HACE algo—: se acepta un widget que
    sea control por clase (btn, imgbtn, switch, checkbox, slider, dropdown, roller,
    btnmatrix) o cualquier objeto con manejadores propios registrados, que es como
    este proyecto usa contenedores e imagenes de boton (el badge del bloqueo, el
    check de "todo OK", las tarjetas del centro de alarmas). Las pantallas se
    rechazan por no tener padre.
    Se q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
    [ElementsCreation.cpp, UITask.cpp]
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2026-08-15 fix(hmi): el teclado del asistente pitaba en cada letra
    El filtro solo excluia lv_keyboard_class, pero el teclado del asistente de
    bebe es un lv_btnmatrix a proposito y no un lv_keyboard: BabyWizard.cpp
    documenta el motivo (LVGL 8.3 guarda los keymaps en un global de fichero, asi
    que lv_keyboard_set_map() reescribiria el mapa de todos los teclados de la
    app, incluido el de credenciales WiFi). Ahora se excluye cualquier matriz de
    botones, con excepcion de la interna de un lv_tabview, que son pestanas de
    navegacion y no teclas.
    Se quitan ademas tres envios de estado que solo eran navegacion: entrar en
    ajustes (ui_event_Settings) y los dos botones de volver a la principal
    (ui_event_ImgButton7,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
    [ElementsCreation.cpp, UITask.cpp]
2026-08-15 feat(shared): prueba de funcionamiento de las alarmas (201.12.3.105)
    "Means shall be provided for the OPERATOR to check the operation of audible and
    visual alarms." Era un shall incumplido, y ademas es un habilitador de banco:
    convierte "provocar diez condiciones" en "pulsar un boton y comprobar senales".
    Boton PROBAR ALARMAS en ajustes, como una fila mas de ui_Container3 en el hueco
    libre de la parte superior. Se construye desde UITask y no desde
    ElementsCreation porque ese fichero lo genera SquareLine y no se reescribe a
    mano.
    La secuencia reproduce UNA rafaga de cada prioridad, de BAJA a ALTA, por el
    MISMO camino de audio que las alarmas reales (buzzerAlarmUpdate). Eso es lo que
    le da v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
    [Buzzer.cpp, CommTask.cpp, CommTask.h, UITask.cpp, security.cpp]
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2026-08-16 fix(hmi): la fila no se repintaba al silenciar la alarma de sonda
    viewSignature() mezclaba sus tres campos con XOR:
    activeIdSignature() ^ silencedBitmask ^ (alarmsMuted ? 0x8000 : 0). Con UNA
    sola alarma activa de id N la firma vale 32+N, y al silenciarla se le hacia
    XOR con (1<<N) y con 0x8000, que se cancelan exactamente cuando N = 15 — o
    sea ALARM_SKIN_SENSOR_FAULT_AIR_MODE, justo la que se provoca desenchufando
    la sonda. La firma no cambiaba, la lista no se repintaba y el boton se
    quedaba como estaba hasta que vencia el temporizador.
    Se encadena por multiplicacion en vez de por XOR: dos campos distintos ya no
    pueden anularse entre si.
    Y se quita el "..." del boton mientras espera con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
    [AlarmCenter.cpp]
2026-08-16 fix(shared): quitar el pitido al recibir trama y avisar del enlace en el display
    DOS COSAS QUE DESTAPO EL LATIDO DE 1 Hz.
    1. La motherBoard pitaba cada vez que recibia una trama del display. Con el
    latido nuevo eso era un pitido por segundo, pero el problema de fondo es
    mas serio y llevaba ahi desde antes: buzzerHandler()/buzzerTone() y
    buzzerAlarmUpdate() escriben el MISMO canal PWM, asi que cada trama
    recibida hacia shutBuzzer() —ledcWrite(0)— pisando la rafaga de alarma que
    estuviera sonando y destrozando el patron de la Tabla 3. Antes pasaba en
    cada pulsacion; ahora habria pasado cada segundo.
    Se elimina. Ese pitido era el truco con el que el display conseguia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
    [CommTask.cpp, CommTask.h, UITask.cpp, main.cpp]
2026-08-16 fix(hmi): las telemetrias volvian a su valor viejo tras borrarlas
    Con el enlace caido las cifras se ponian a "--" y un segundo despues
    reaparecian, sin que el enlace se hubiera recuperado. La guarda estaba solo en
    link_lost_blank_update(), que corre una vez en la transicion, pero
    update_labels() tiene OCHO llamantes —las flechas de consigna, el cambio de
    idioma, el arranque, la sincronizacion de estado— y cualquiera de ellos
    repintaba los valores viejos. Peor todavia: el borrado invalida los estaticos
    de ultimo-valor-pintado, asi que el repintado estaba garantizado.
    La guarda pasa a estar DENTRO de update_labels(), donde da igual quien llame.
    Las barras van con ella. Las consignas se si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
    [UITask.cpp]
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2026-08-16 fix(hmi): el aviso emergente salia detras de los overlays y se leia mal
    ui_SkinProbeToast colgaba de ui_ScreenMain, asi que no se veia en ninguna otra
    pantalla y, sobre todo, quedaba DEBAJO del centro de alarmas y del asistente,
    que viven en lv_layer_top(). Justo los sitios desde donde mas se avisa: el
    aviso de la prueba de alarmas salia detras de la propia tarjeta.
    Pasa a lv_layer_top() y se mueve al frente al mostrarlo, porque en esa capa el
    orden lo fija quien se mueve el ultimo y no la jerarquia: el banner de alarma
    y el centro de alarmas tambien estan ahi.
    Mas grande, ademas: 460 px de ancho, fuente montserrat_20 y 16 px de relleno.
    [UITask.cpp]
2026-08-16 fix(hmi): la prueba de alarmas no mostraba banner, solo sonaba
    Efecto secundario de mover el boton al centro de alarmas.
    alarm_banner_update() suprime el banner mientras ese overlay esta abierto
    —se penso para no pintarlo encima de la tarjeta— y la prueba se lanza
    precisamente desde su cabecera, asi que la mitad visual quedaba invisible: la
    secuencia sonaba pero no se veia nada.
    Media clausula sin cumplir: 201.12.3.105 pide comprobar las alarmas "audible
    AND visual", y lo visual es justo lo que la prueba tiene que ejercitar en el
    display.
    La supresion deja de aplicarse a la prueba, y tampoco a la perdida de enlace,
    por el mismo razonamiento: con la placa callada el contenido del centro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
    [UITask.cpp]
2026-08-16 fix(hmi): el display arrancaba mostrando "ALARM TEST" sin motherBoard
    ctrl_state_msg se inicializa a CERO y el centinela de "sin prueba en curso" es
    255, pero cero es ALARM_PRIORITY_LOW: una prioridad perfectamente valida. Sin
    placa conectada no llega ningun CTRL,STATE que corrija el campo, asi que el
    display arrancaba convencido de que habia una prueba de alarmas corriendo y
    pintaba el banner para siempre.
    Misma familia que el clearedEpoch del registro: un centinela que coincide con
    un valor legitimo. Se rompe el empate poniendo el centinela de verdad antes de
    arrancar la tarea de comunicaciones.
    Se anade ademas Display_BoardEverSeen() a la condicion: la prueba corre EN LA
    PLACA, asi que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
    [CommTask.cpp, CommTask.h, UITask.cpp]
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2026-08-16 chore(motherboard): traza al silenciar para localizar el fallo del boton
    El boton de la fila vuelve a SILENCIAR tras silenciar, aunque el audio si se
    calla. Descartado por analisis que el fallo este en el formato o el parseo:
    probado el sscanf exacto del display contra una linea real de CTRL,STATE con
    21 campos, devuelve result=21 y el silencedBitmask correcto. Tambien
    descartado el buffer: la linea son 97 bytes de los 192 disponibles. Y el
    display guarda bien el AlarmId en alarmList[].id, asi que el bit que consulta
    es el que toca.
    Queda por saber en que lado se pierde. Esta traza imprime, en la propia
    transicion, el estado en que queda la condicion y el bitmask que la placa va
    a publicar.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
    [CommTask.cpp]
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2026-08-16 chore(motherboard): trazar la linea CTRL,STATE exacta mientras haya silencio
    La placa hace lo correcto —confirmado en banco: estado=3, bitmask=0x8— pero el
    display recibe 0. Descartado por analisis todo lo demas: el sscanf del display
    parsea una linea sintetica equivalente devolviendo los 21 campos y el bitmask
    correcto; la linea son 97 bytes de 192; HW_REVISION es 'A' (char, correcto
    para %c) y FWversion "18.2" (literal corto, correcto para %s); el display
    guarda bien el AlarmId; y solo hay un escritor de ctrl_state_msg.
    Lo unico que queda por mirar son los bytes de verdad. Se traza la linea tal
    cual sale, solo mientras silencedBitmask != 0, lo que la limita de forma
    natural a una por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
    [CommTask.cpp]
2026-08-16 fix(hmi): el simbolo de AUDIO PAUSED se dibujaba fuera de su propia caja
    Fallo de renderizado, no de datos: la placa publicaba bien el bitmask
    (confirmado en banco, estado=3 bitmask=0x8) y el display lo recibia. El icono
    se creaba, se coloreaba y no se veia.
    La causa es lv_img_set_zoom(). lv_img transforma alrededor de un PIVOTE que
    por defecto es el centro de la imagen FUENTE — (24,24) para la lamina de
    48 px. Al forzar el objeto a 28x28 (o 36x36 en la esquina), ese punto queda
    casi en su esquina, asi que la imagen escalada se dibujaba desplazada fuera
    del objeto y el recorte se la comia entera.
    Se usa a tamaño natural: ni lv_obj_set_size() ni lv_img_set_zoom(). Reducir
    la lamina a 32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
    [AlarmCenter.cpp, UITask.cpp]
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2026-08-16 fix(hmi): la interfaz se arrastraba por repintar el banner en cada pasada
    alarm_banner_update() y audio_paused_icon_update() corren en cada vuelta del
    bucle de UI, y llamaban a lv_label_set_text() y lv_obj_move_foreground()
    incondicionalmente. Los dos invalidan y fuerzan redibujado aunque el contenido
    sea identico, asi que la franja se repintaba y lv_layer_top() se reordenaba a
    la frecuencia del bucle. No se noto al escribirlo porque entonces el banner
    solo aparecia en la pantalla de bloqueo, donde no compite con nada.
    Ahora ambas solo tocan LVGL cuando cambia algo: el banner compara el texto que
    va a pintar con el ultimo pintado, y el icono compara visibilidad y el SEGUNDO
    que toca mostrar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
    [UITask.cpp]
2026-08-16 fix(motherboard): CTRL,STATE no era periodico y congelaba el estado del display
    send_state_to_hmi() solo se ejecutaba al tomar el semaforo de peticion, y el
    display deja de pedir estado en cuanto se sincroniza. En la practica CTRL,STATE
    salia unas pocas veces al arrancar y nunca mas, asi que TODO lo que viaja en
    esa linea se quedaba congelado con el valor del arranque.
    Explica los tres sintomas de banco a la vez: la campana de AUDIO PAUSED solo
    aparecia si ya habia una alarma silenciada al encender —porque entonces el
    bitmask ya venia puesto en la ultima trama recibida—, no aparecia al silenciar
    una alarma posterior, y la cuenta atras nunca bajaba. Tambien afectaba a la
    prioridad de la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
    [CommTask.cpp]
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2026-08-16 fix(motherboard): no fiarse de WiFi.status() para saber si hay enlace
    Tras una desconexion con reason=2 (AUTH_EXPIRE), arduino-esp32 deja
    _sta_status en WL_CONNECTED: es el unico motivo cuya rama en el manejador
    de STA_DISCONNECTED esta vacia y no llama a _setStatus() (2.0.14
    WiFiGeneric.cpp:1068, el core que fija espressif32@6.6.0). WL_CONNECTED
    solo se reescribe en STA_GOT_IP, y el auto-reconnect del core —lo unico
    que lo corregiria— esta desactivado a proposito por el event storm de
    ASSOC_TOOMANY.
    Con WiFi.status() mintiendo, WifiOTAHandler() nunca reintenta wifiInit()
    porque su guarda cree que hay enlace, y WIFI_TB_OTA() sigue llamando a
    tb_wifi.connect() cada THINGSBOARD_RECONNECT_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
    [DriveUpload.cpp, Wifi_OTA.cpp]
2026-08-16 fix(hmi): avisar del enlace ausente al arrancar sin la placa
    Display_IsBoardLinkLost() devolvia false mientras no hubiera llegado
    ninguna linea CTRL, asi que arrancar el display sin el cable dejaba un
    equipo que juraba estar bien: sin banner, sin borrar cifras y sin nada
    que delatase que al otro lado no habia placa.
    La guarda existia por un motivo valido —el display arranca antes que la
    placa y sin ella saltaria un aviso en cada encendido— pero trataba "no
    lo he visto nunca" como un estado permanente. Ahora esa espera caduca a
    los 10 s desde el arranque (minimo del splash + la ventana de silencio
    ya establecida): a partir de ahi, no haber hablado nunca cuenta como
    enlace perdido.
    Cubre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
    [CommTask.cpp, CommTask.h]
2026-08-16 fix(motherboard): declarar el enlace perdido si el display nunca aparece
    checkHmiLink() salia sin declarar nada mientras g_hmiEverSeen fuera
    false. Es el mismo razonamiento que el display aplicaba en espejo, y
    tenia el mismo agujero: una placa encendida con el display nunca
    conectado no levantaba ALARM_HMI_LINK_LOST jamas, que es exactamente la
    condicion que esa alarma existe para avisar.
    Mismo margen de arranque que el display (10 s) para que los dos extremos
    sigan contando igual, que es el criterio que ya seguian las ventanas de
    silencio.
    Verificado: pio run -e IncuNest_V18 compila; pio test -e native 188/188.
    Pendiente de prueba en banco (arrancar la placa sin display conectado).
    [security.cpp]
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2026-08-16 fix(hmi): el eje X de la grafica de peso salia lleno de ceros
    Dos causas encadenadas, ninguna de pintado:
    1. Las marcas mayores se reparten como min + (max-min)*i/(n-1) en
    ENTEROS. Se pedian 5 fijas, asi que sobre un rango 0..1 salian
    0,0,0,0,1 — el eje de ceros que se veia. Ahora nunca se piden mas
    marcas que numeros enteros caben en el rango.
    2. dayOffset tiene resolucion de DIAS, de modo que todos los pesos
    tomados en la misma jornada valen 0, y tambien valen 0 todos cuando
    la placa no tenia hora al registrarlos. Un eje de "dia de vida" ahi
    no informa de nada. En ese caso se pasa a numerar la medida, y la
    etiqueta del eje cambia con el: llamar "dia de vida" a un e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
    [BabyHistory.cpp]
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2026-08-16 feat(motherboard): emitir el centinela cuando un sensor deja de responder
    La frescura se juzga con lastSuccesfullSensorUpdate[] y la MISMA ventana
    de 5 s que usa checkStatusOfSensor() para levantar las alarmas de fallo
    de sensor, de modo que el "--" y la alarma aparezcan a la vez en vez de
    contradecirse en pantalla.
    Se decide en la via de presentacion y NO tocando in3.temperature[]: ese
    array alimenta el PID y las alarmas, y cambiar su convencion para
    arreglar una etiqueta seria meter mano en el control de un actuador por
    un motivo cosmetico.
    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
    [CommTask.cpp]
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2026-08-16 feat(hmi): reloj de fecha y hora local en la cabecera
    Hora en grande y fecha debajo en cuerpo menor, a la derecha de
    "IncuNest". Dos labels porque LVGL no admite dos tamanos de fuente en
    uno solo. Se recalcula cada pasada pero solo se ESCRIBE cuando cambia:
    repintar a 20 Hz algo que cambia una vez por minuto es trabajo tirado, y
    el repintado innecesario ya dio problemas de fluidez en esta pantalla.
    Sin hora o sin zona pone "Sin hora", no una hora UTC disfrazada de
    local: en un equipo clinico una hora equivocada es peor que ninguna. Por
    eso HMI_HasLocalTime() exige AMBAS cosas — un offset 0 con fuente
    desconocida no es UTC+0, es que no se sabe.
    AlarmCenter y BabyHistory pasan por el mismo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
    [AlarmCenter.cpp, BabyHistory.cpp, CommTask.cpp, CommTask.h, ElementsCreation.cpp, UITask.cpp]
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2026-08-30 chore(afe4490): actualizar la libreria a v0.81 y adaptar los consumidores
    La dependencia esta fijada a `#master`, asi que "actualizar la version" es
    traer el HEAD del repo de la libreria: 0.53.0 (V18) / 0.32.0 (V16, V17) ->
    0.81.0 en los tres entornos. Se actualiza solo esa dependencia; las demas
    son URLs git sin pin y un `pio pkg update` global habria movido medio
    proyecto.
    La v0.69 de la libreria migro `ppg_disp` al dominio OT y cambio su tipo de
    `int32_t` (cuentas de ADC) a `float` (A/A, magnitud ~1e-5..1e-6). El
    firmware seguia compilando sin un solo error porque `float -> int32_t` es
    una conversion implicita legal: los cuatro consumidores se rompian en
    silencio, truncando cada muestra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
    [CommTask.cpp, DriveUpload.cpp, DriveUpload.h, PpgSnapshot.cpp, PpgSnapshot.h, PpgSnapshotPublish.cpp, SPO2.cpp]
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2026-08-30 chore(afe4490): fijar la libreria a un commit y blindar el contrato de datos
    La libreria vive en otro repo con otro dueno. Con `#master`, su trabajo en
    curso entraba en este firmware en cualquier instalacion nueva (clon nuevo,
    worktree nuevo, CI) sin que ninguna de las dos partes lo decidiera: asi es
    como el cambio de `ppg_disp` de int32_t a float (v0.69) llego hasta aqui sin
    un commit que lo relacionara.
    - platformio.ini: pin a `#4e0dd91` (v0.81.0). Comprobado que PlatformIO
    detecta el cambio de spec y reinstala solo en el siguiente `pio run`, sin
    `pkg update` manual. De paso arregla un dato enganoso: con `#master` el
    `.piopm` conservaba la version de la instalacion original (V17 rep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
    [CommTask.cpp, GPRS.cpp, GPRS.h, SPO2.h]
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2026-08-30 fix(motherboard): la hora puesta a mano no debe llevar offset de zona
    Al juntar el ajuste manual del reloj con el reloj de hora local del HMI
    aparecia un desplazamiento silencioso de la hora.
    Son dos modelos distintos del mismo dato. El ajuste manual guarda LO QUE
    TECLEA el operador como epoch, sin zona (civil_to_unix_utc con offset
    0), de modo que ese epoch YA es hora local. El reloj del HMI, en cambio,
    asume epoch UTC y le suma el offset que aprende de NITZ o de la consulta
    por IP. Juntos: se pone la hora a las 14:32 en Espana, la via IP resuelve
    UTC+2, y la pantalla muestra 16:32 — dos horas de error, sin aviso, en la
    hora que sella el historial de alarmas.
    Se anade TZ_SOURCE_MANUAL: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
    [CommTask.cpp, system_clock.cpp, test_tz_source.cpp, tz_source.cpp, tz_source.h]
2026-08-30 fix(hmi): no prefijar el peso del wizard con el ultimo conocido
    Al reactivar control para un bebe ya existente, el cuadro de peso
    aparecia con el valor de la ULTIMA vez que se peso -a veces del dia
    anterior- y bastaba con pulsar "continuar" sin tocarlo para que quedase
    registrado como si fuera la medida de hoy. Un peso equivocado en el
    registro clinico, silencioso.
    El campo empieza ahora vacio siempre: obliga a teclear un peso real o a
    pulsar "SIN PESO" explicitamente. El ultimo peso conocido sigue
    visible, de forma no editable, en la lista de seleccion de bebe.
    Verificado: pio run -e main compila. Pendiente de prueba en banco.
    [BabyWizard.cpp]
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2026-08-30 refactor(shared): mover el patron de Tabla 3 de main.h a shared/
    Las constantes de rafaga y pulso eran privadas de motherBoard, y el display
    las necesita para emitir el mismo patron por su propio zumbador. Dos copias
    de una tabla normativa divergen en el primer ajuste, y la divergencia no la
    delata nadie hasta que suenan las dos senales a la vez con ritmos distintos
    — que es la inconsistencia que prohibe 6.3.3.1.
    Traslado sin cambio de valores: los static_assert de Buzzer.cpp que
    comprueban las ventanas de las Tablas 3 y 4 siguen pasando, ahora blindando
    a las dos placas.
    [alarm_audio_pattern.h, main.h]
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2026-08-31 feat(hmi): señal acústica propia al perder el enlace con la placa
    El display detectaba la perdida de enlace pero delegaba la mitad audible
    en la motherBoard, que es justo el extremo que puede estar muerto (firmware
    colgado, reset loop): en ese caso no sonaba nada, solo el banner visual.
    Anade link_audio_service(), servido desde el bucle de UI y fuera de
    LVGL_Lock (misma razon que AlarmSound_Update: cada transicion es I2C).
    Emite el patron MEDIA de shared/alarm_audio_pattern.h -- el mismo que la
    placa usa para ALARM_HMI_LINK_LOST, con el mismo freshStart y sin agotarse
    (6.10). Se acepta sonar junto al zumbador de la placa si el cable esta roto
    y ella sigue viva: no puede saber si lo esta,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
    [UITask.cpp, alarm_policy.h, main.h]
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2026-08-31 fix(hmi): el check "OK" seguia en verde con el enlace caido
    update_alarm_panels() decide el check de "todo OK" (pantalla principal y
    pantalla de bloqueo) mirando solo totalActiveAlarms y fanHeaterAlarm —
    nunca miraba Display_IsBoardLinkLost(), a diferencia de
    alarm_banner_update() que si lo hace. Con el enlace caido se veia el
    banner de "LINK LOST" y, a su lado, un check verde que decia lo
    contrario.
    Con el enlace caido no sabemos si hay una alarma real en curso, solo
    que hemos dejado de escuchar a la placa: "OK" es una afirmacion que ya
    no se puede hacer, asi que el check pasa a ocultarse, igual que con
    fanHeaterAlarm.
    Verificado: pio run -e main compila. Pendiente de prueba en banco.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
    [UITask.cpp]
2026-08-31 fix(motherboard): la cifra pasaba por "0" antes de llegar a "--"
    sensorReadingFresh() por si sola no bastaba. Mide cuanto ha pasado
    desde la ULTIMA lectura buena (ventana de 5 s), pero sensors_module.cpp
    pone in3.temperature[]/in3.humidity[] a 0 en el mismo ciclo (~200 ms)
    en que falla la lectura — mucho antes de que esos 5 s expiren.
    Resultado observado en banco: la cifra se veia "0.0°C" varios segundos
    antes de pasar a "--", justo el valor plausible-y-alarmante que este
    centinela existia para evitar.
    0.0 nunca es una lectura real de estas dos magnitudes (se clampan a el
    SOLO en fallo, en sensors_module.cpp); ahora se exige ademas raw > 0,
    y lo primero en fallar de las dos condiciones d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
    [CommTask.cpp]
2026-08-31 fix(motherboard): log cuando AT+CCLK? no contesta, no solo cuando la fecha es invalida
    GPRSEnsureTimeZoneSynced() salia en silencio si modem.getNetworkTime()
    devolvia false, y solo logueaba en la rama de "fecha 2004 por defecto"
    (civil_to_unix_utc rechazandola). Round de banco (2026-08-31): con GPRS
    "Attached" y WiFi conectado, no aparecio NINGUNA de las dos lineas — el
    modem podia no estar contestando al AT+CCLK?, y era indistinguible de
    "el operador simplemente no manda NITZ" porque el primer caso no
    dejaba rastro.
    No arregla el NITZ en si (puede que el operador de la SIM de pruebas no
    lo mande, que es un limite conocido, no un bug); esto solo cierra el
    hueco de diagnostico para la prox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
    [GPRS.cpp]
2026-08-31 fix(hmi): la etiqueta de estado de la placa se solapaba con el teclado
    BOTTOM_LEFT quedaba debajo de ui_Keyboard1 (750x185, centrado en un
    contenedor de 770x361): el teclado ocupa casi todo el ancho y su borde
    inferior sobresale del propio contenedor, asi que cualquier cosa
    anclada abajo queda tapada en cuanto se muestra. Confirmado en banco.
    La unica esquina realmente libre es la superior izquierda: SSID, Pass
    y los botones de conectar/desconectar viven todos en la mitad derecha.
    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
    [ElementsCreation.cpp]
2026-08-31 fix(hmi): ampliar 5s el margen de arranque antes de LINK LOST
    En banco se ha visto que un arranque normal, con la motherBoard
    presente, a veces tarda algo mas de lo habitual en emitir su primera
    linea. El margen justo (10 s) disparaba un LINK LOST fantasma que se
    autocorregia segundos despues. Solo afecta al margen de primer
    arranque (BOARD_LINK_BOOT_GRACE_MS), no al timeout de silencio en
    marcha ya establecido (BOARD_LINK_TIMEOUT_MS).
    [CommTask.h]
2026-08-31 fix(motherboard): ampliar 5s el margen de arranque antes de ALARM_HMI_LINK_LOST
    Mismo motivo y mismo valor que BOARD_LINK_BOOT_GRACE_MS en el display:
    un arranque normal, con el display presente, a veces tarda algo mas de
    lo habitual en emitir su primera trama, y el margen justo (10 s)
    disparaba la alarma por un instante antes de autocorregirse. Solo
    afecta al margen de primer arranque (HMI_LINK_BOOT_GRACE_MS), no al
    timeout de silencio en marcha (HMI_LINK_TIMEOUT_MS).
    [security.cpp]
2026-08-31 feat(shared): mostrar conectividad y cobertura en el heading del HMI
    Anade al heading de ui_ScreenMain (junto al reloj) un icono WIFI/2G/sin
    enlace mas 4 barras de cobertura, visible en todas las pantallas y no
    solo en Ajustes > WiFi como el indicador existente.
    Protocolo: CTRL,STATE gana un campo nuevo, linkBars (0-4, o -1 sin
    transporte/dato no fiable), calculado en la motherBoard a partir de
    WiFi.RSSI() o GPRS.CSQ segun el transporte activo en commStatus.
    Backward-compatible: una placa antigua que no lo mande se interpreta
    como -1 y el display no pinta nivel alguno.
    De paso, corrige un bug real encontrado al cablear esto: el parseo de
    CTRL,STATE en el HMI leia commStatus pero nunca lo c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
    [CommTask.cpp, CommTask.h, ElementsCreation.cpp, UITask.cpp, protocol.h]
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2026-09-01 fix(motherboard): deshabilitar apagado por pulsacion larga de ON_OFF_SWITCH
    Hasta nuevo aviso, PowerManagement_Task se autoelimina en el arranque y
    deja de reaccionar al boton fisico. El equipo se mantiene encendido
    (PWR_EN sigue latcheado por el power-latch de setup()) y solo puede
    apagarse cortando la alimentacion externa.
    Verificado: pio run -e IncuNest_V18 compila correctamente.
    [main.cpp]
2026-09-01 fix(hmi): apilar el indicador de conectividad y no tapar el bloqueo
    El icono WIFI/2G + barras se pintaba en horizontal y a 160px de ancho,
    que se solapaba con ui_ImgButton1 (boton de bloqueo, centrado en
    pantalla con TOUCH_EXT_SMALL=40 de zona tactil ampliada).
    Se apila en vertical (texto arriba, barras debajo) en un contenedor de
    40px de ancho: cabe en el hueco a la izquierda del boton de bloqueo,
    justo despues del reloj, sin invadir su zona tactil ni su area visual.
    El boton de bloqueo queda como centro visual despejado del heading.
    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
    [ElementsCreation.cpp]
2026-09-01 fix(motherboard): detectar perdida de adjunto GPRS en estado estable
    Encontrado en banco al probar el heading nuevo: quitar la SIM con el
    modem ya adjunto (GPRS.post==true) no bajaba el icono de "2G" a "sin
    enlace" ni pasado un minuto. Dos bugs independientes:
    - GPRS.post se fijaba a true una sola vez en GPRSPowerUp() caso 2 y
    nada lo volvia a comprobar en estado estable: el timeout de
    GPRSStatusHandler() solo se evalua durante powerUp/connect, no
    durante post. Se anade GPRSVerifyStillAttached(), que reverifica
    AT+CREG? (modem.isNetworkConnected()) cada 30 s mientras GPRS.post
    este activo, y fuerza el mismo reset "apaga y reintenta" que ya
    usaba ese timeout (factorizado en GPRSF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
    [GPRS.cpp, GPRS.h]
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2026-09-01 fix(hmi): quitar el titulo IncuNest del heading y reajustar el reparto
    Sin "IncuNest" quedan 6 widgets en el heading (reloj, conectividad,
    bloqueo, bebes, alarmas, ajustes) en vez de 7. El lado izquierdo
    (reloj+conectividad) se reajusta a un margen de 20px con paso propio
    hasta el centro; el lado derecho no cambia, porque ya estaba en el
    minimo que permite la zona tactil ampliada del boton de bloqueo
    (TOUCH_EXT_SMALL=40) sin solapar con "Bebes".
    Se retira ui_Incunest por completo (globals + extern), incluida su
    replica en ui_ScreenLock.
    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
    [ElementsCreation.cpp]
2026-09-01 fix(hmi): separar la cabecera de Temperature control del anillo de bloqueo
    El anillo de auto-bloqueo (ui_LockAutoArc, termina en y=60 absoluto)
    invadia 2.5px el borde superior de la fila de cabecera de
    "Temperature control" (Panel4/Switch1/Label2/9/15, empezaba en y=53).
    Busque una norma de separacion entre controles en los 8 PDF de
    Regulatory/ (texto completo, EN/ES) y no hay ninguna aplicable a
    controles tactiles/software -- 60601-1 15.4.6 es sobre par de apriete
    de mandos giratorios mecanicos. A falta de una cifra normativa, se
    usa el maximo margen que cabe sin cascada: 9px, el total de holgura
    libre entre esta fila y ui_AirPanelCont (empieza en y=113) que no
    depende de ningun otro eleme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
    [ElementsCreation.cpp]
2026-09-01 fix(hmi): centrar el reloj del heading en vez de anclarlo por el borde
    El reparto de la izquierda (reloj + conectividad) usaba LV_ALIGN_LEFT_MID
    para el reloj con un x pensado para centrado: como "9:05" y "23:59"
    tienen ancho distinto, el CENTRO visual del reloj no caia en el punto
    calculado, quedaba mas cerca de la conectividad que del margen izquierdo
    y el reparto se veia descuadrado aunque los tres huecos midieran 126-127px
    sobre el papel.
    Se cambia a LV_ALIGN_CENTER (offset desde el centro de pantalla, igual
    que el resto de widgets del heading salvo la conectividad, que sigue en
    LEFT_MID porque su ancho de 40px es fijo y no necesita el cambio).
    Mismo fix en la replica de ui_ScreenLock.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
    [ElementsCreation.cpp]
2026-09-01 fix(hmi): alinear Temperature control/Phototherapy y su TURN ON
    Dos ajustes de precision sobre el fix anterior:
    - Panel4/Label2 ("Temperature control") vivian en y=-177 y
    Switch1/Label9/Label15 ("TURN ON"/ON/OFF) en y=-178, 1px de
    diferencia ya presente en el original (-186/-187) antes de bajar la
    fila 9px. El boton quedaba visiblemente descuadrado con el texto.
    Unificados los cinco en -178.
    - ui_PhotoCont (cabecera de "Phototherapy") y ui_PhotoTimerCont (su
    panel de cuenta atras, se mueve con ella para no descuadrar la
    posicion relativa) bajan los mismos 9px que la cabecera de
    Temperature control, con el mismo criterio (despejar el anillo de
    auto-bloqueo): ambas cabeceras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
    [ElementsCreation.cpp]
2026-09-01 fix(hmi): igualar exactamente la altura de Temperature/Phototherapy
    El fix anterior alineaba los bordes SUPERIORES de ambas cabeceras
    (ambas a ~2px del anillo de auto-bloqueo), pero como el contenedor de
    Phototherapy es 4px mas alto que el Panel4 de Temperature, sus
    contenidos (texto + switch) no caian en el mismo absoluto: 86 vs 90.
    Se calcula el punto T (coordenada absoluta comun) que ambos lados
    pueden alcanzar sin solapar nada: TempCont exige T<=88 (no tocar
    ui_AirPanelCont, empieza en y=113) y PhotoCont exige T>=88 (no tocar
    el anillo de auto-bloqueo, termina en y=60). T=88 es el UNICO valor
    que cumple las dos, con margen exactamente cero en ambas — cabecera y
    AirPanelCont se tocan,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
    [ElementsCreation.cpp]
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2026-09-01 feat(motherboard): parsear el protocolo del SensorBoard
    Logica pura del enlace, separada de la capa USB para poder probarla en el
    entorno native: CRC16-CCITT FALSE portado literal del SensorBoard, framer
    incremental del binario Magic+Type+Length+Payload+CRC, codec JSON con
    ArduinoJson (la misma libreria que ya usa GPRS.cpp), maquina del enlace con
    el margen de 90 s del heartbeat y deteccion de flapping del hall de puerta.
    Contratos de fail-safe tomados de SensorBoard_v2/README.md: antes del primer
    heartbeat el enlace cuenta como caido, un frame corrupto se descarta y el
    parser se resincroniza solo, y una posicion null de sensor_data se propaga
    como "sin lectura" en vez de como un cero.
    36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
    [sb_crc16.cpp, sb_crc16.h, sb_door_state.cpp, sb_door_state.h, sb_frame_parser.cpp, sb_frame_parser.h, sb_json_codec.cpp]
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2026-09-01 fix(hmi): bajar el switch TURN ON de Temperature control 4px
    En banco el switch de "Temperature control" se veia mas alto que el
    de "Phototherapy" pese a estar calculado a la misma coordenada
    absoluta que Switch3 (ver el analisis geometrico del commit anterior,
    5775c41). No hay una segunda causa identificada en el codigo -- Panel4
    y Label2 usan la misma y y no se tocan; solo el switch (y las
    etiquetas ON/OFF que viajan con el, no con el texto) baja 4px, de
    -176 a -172, ajuste verificado directamente en banco por el usuario.
    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
    [ElementsCreation.cpp]
2026-09-01 fix(hmi): bajar 10px mas el switch TURN ON de Temperature control
    Seguia viendose mas alto que ui_Switch3 (Phototherapy) tras el ajuste
    de 4px anterior. Total acumulado: 14px por debajo de Panel4/Label2
    (que se quedan en -176, sin tocar). Ajuste empirico verificado en
    banco.
    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
    [ElementsCreation.cpp]
2026-09-01 debug(hmi): ocultar ui_Switch1 para diagnosticar subida de firmware
    Diagnostico temporal, NO es un fix: el switch TURN ON de Temperature
    control seguia viendose en la misma posicion en banco pese a varios
    ajustes de coordenadas ya confirmados en el codigo fuente (grep
    completo del repo: ui_Switch1 solo se posiciona en este fichero, sin
    ninguna otra ruta que lo reposicione en tiempo de ejecucion).
    Se oculta por completo para una prueba inequivoca: si desaparece de
    la pantalla tras subir, confirma (a) que es el widget correcto y (b)
    que el .bin subido si refleja el codigo actual -- descartando una
    sospecha de bloqueo de archivo por OneDrive dejando un binario
    antiguo en disco. Revertir en cua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
    [ElementsCreation.cpp]
2026-09-01 fix(hmi): mover el boton TURN ON real (ui_TempToggleBtn), no el switch
    Causa raiz de toda la saga de ajustes fallidos: ui_Switch1 (junto con
    Label9/Label15, sus etiquetas ON/OFF) es un widget LEGACY que el
    propio ElementsCreation.cpp oculta con LV_OBJ_FLAG_HIDDEN mas abajo en
    la misma funcion, reemplazado por ui_TempToggleBtn -- un boton con un
    label dinamico "TURN ON"/"TURN OFF" (ver TempToggleBtn_cb en
    UITask.cpp). El switch nunca fue el widget visible en pantalla: por
    eso ningun ajuste de posicion tuvo efecto, incluido ocultarlo por
    completo en el commit de diagnostico anterior (93df757) -- ya estaba
    oculto por otra via, asi que "seguir viendolo" no decia nada sobre si
    el .bin se habia ac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
    [ElementsCreation.cpp]
2026-09-02 fix(motherboard): blindar el parseo del enlace del SensorBoard
    Cuatro defectos de la primera version, ninguno detectable sin leer las dos
    implementaciones a la vez:
    - Escritura fuera de rango de decenas de KB: el dueno del parser cambiaba
    payload_buf/payload_cap en caliente (buffer pequeno para JSON, grande para
    una captura) y el limite solo se comprobaba al cerrar la cabecera. Al
    soltarse el cable a mitad de un JPEG, el stream siguiente escribia desde
    payload_idx sobre un array de 256 B en .bss, encima del estado del enlace y
    de la puerta. Ahora se comprueba en cada byte y el buffer solo se cambia por
    sb_frame_parser_set_buffer(), que resincroniza.
    - Length validado solo contra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
    [sb_door_state.cpp, sb_door_state.h, sb_frame_parser.cpp, sb_frame_parser.h, sb_json_codec.cpp, sb_json_codec.h, sb_link_state.cpp, sb_link_state.h]
2026-09-02 fix(motherboard): un solo dueno del enlace USB y DTR obligatorio
    El bloqueante real de la primera version no era el VID/PID: el SensorBoard
    guarda TODA su transmision con la senal de line state (s_cdc_ready), y la
    motherboard nunca asertaba DTR. El enlace enumeraba, abria, y no llegaba ni un
    byte; el unico sintoma habria sido la alarma de enlace perdido 90 s despues,
    con la sesion de banco entera gastada en la pista equivocada.
    Con el DTR arreglado quedaba el modelo de propiedad, que tenia una carrera
    real: el callback de desconexion cerraba el handle mientras otra tarea podia
    estar transmitiendo sobre el. Ahora la tarea del modulo es la UNICA que abre,
    cierra y transmite; el callback solo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
    [sensorboard_comm.cpp, sensorboard_comm.h, task_config.h]
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2026-09-02 feat(motherboard): registrar causa de fallecimiento en alta e historial
    HMI,PROFILE_DISCHARGE y CTRL,PROFILE_HISTORY añaden el campo cause (0-6,
    BabyCause), solo relevante cuando outcome=2 (Fallecido). Registro de
    auditoria binario de 59 a 60 bytes (mismo mecanismo de reset si es
    incompatible que ya existia para humidityMinutes). Añadido tambien al
    payload JSON de ThingsBoard (baby_discharge_cause) en baby_cloud.cpp,
    junto a baby_outcome -- el transporte real (GPRS/WiFi) que drena esa cola
    sigue pendiente en otra rama, así que viajará solo en cuanto aterrice.
    Probado: pio run -e IncuNest_V18 (compila) y pio test -e native
    (220/220, incluye los tests nuevos de cause en test_baby_profile,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
    [CommTask.cpp]
2026-09-02 feat(hmi): pedir causa al dar de alta y arreglar solape del botón X
    - El botón "X" (cierre del diálogo de salida) es hijo de la tarjeta, fuera
    del flex-layout de las pantallas de botones; un título corto dejaba que
    el primer botón empezara justo debajo de la esquina y quedara pintado
    por debajo de la X ("SOBREVIVIO"/"SURVIVED"). makeColumn() reserva ahora
    60px de margen superior en las tres pantallas del diálogo.
    - Al elegir "NO SOBREVIVIO"/"DID NOT SURVIVE" (diálogo automático y alta
    manual desde el historial) se pide la causa antes de enviar nada: 6
    opciones ordenadas por frecuencia de mortalidad neonatal en entornos de
    bajos recursos (OMS/UNICEF). BabyHistory.cpp mue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
    [BabyExitDialog.cpp, BabyHistory.cpp, CommTask.cpp, CommTask.h]
2026-09-02 fix(hmi): evitar carrera de eco que apagaba la fototerapia sola
    Display_ApplyCtrlState() resincronizaba actuation/controlMode/
    phototherapyMode/muteAlarm/skinModeEnabled desde el CTRL,STATE de la
    motherBoard en CADA trama (1 Hz), sin parar -- pensado solo para
    recuperar el estado tras un reinicio del HMI (known_issues.md #4). Al
    encender fototerapia, un CTRL,STATE ya en vuelo (con el valor viejo, de
    antes de que la motherBoard procesara el comando) resincronizaba
    hmi_msg de vuelta al valor anterior; el siguiente latido del HMI
    reenviaba ese valor viejo y la motherBoard apagaba la lámpara de
    verdad -- visible en menos de un segundo tras encenderla.
    Fix: ventana de gracia de 2.5s (más que u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
    [CommTask.cpp]
2026-09-02 fix(sensorboard): corregir pinout DVP de la camara
    El esquema real reasigna D0-D7, VSYNC, HREF, PCLK, PWDN y XCLK de la
    camara respecto al pinout documentado el 2026-07-03. IO4/5 (I2C
    principal), IO41/42 (I2C temperatura), IO1 (ALS), IO39/40 (microfono),
    IO19/20 (USB) y IO47 (Hall) no cambian.
    docs/hardware.md actualizado como fuente de verdad.
    [sb_camera_sensor.c]
2026-09-02 feat(hmi): dialogo de teclado para ajustar hora y vista de tendencia en el bloqueo
    - Sustituye los 5 spinboxes prefijados de Adjust Time por un dialogo modal
    con mascara vacia (DD/MM/AA HH:MM) y teclado numerico (TimeDialog.cpp),
    mismo patron que el paso de peso del BabyWizard: prefijar invitaba a
    confirmar por reflejo una hora que nadie habia comprobado.
    - El reloj de cabecera (y su replica en Lock) ya no se oculta cuando falta
    la zona horaria: pinta el epoch tal cual (sin offset) en vez de "Sin
    hora", igual que ya hacen AlarmCenter.cpp y BabyHistory.cpp. El operador
    corrige a mano si hace falta.
    - Sustituye la pestaña "History" de graficas (TabViewMainCharts) por
    TelemetryHi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
    [BabyWizard.cpp, CommTask.cpp, ElementsCreation.cpp, UITask.cpp]
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2026-09-02 fix(motherboard): ajustar la caducidad del dato de aire al periodo medido
    Verificacion en banco con una SensorBoard real (fw 1.0.0): la cadencia de
    sensor_data no es 1000 ms clavados sino 1034 de media (min 1034, max 1036
    sobre 20 muestras) -- el polling arrastra la conversion de los tres SHT40.
    Con los 3000 ms que salian de suponer "3 x 1000", perder DOS publicaciones
    seguidas daba un hueco de 3102 ms, ya se declaraba el dato rancio y acababa
    cortando el calefactor. Con 3600 ms hacen falta tres pérdidas, que es lo que
    la constante pretendia decir.
    Medido tambien, y coherente con lo implementado: heartbeat cada 30 s,
    re-asercion de puerta cada 30 s, sound_level cada ~4965 ms, y 0 frames c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
    [sb_protocol.h]
2026-09-02 fix(shared): el texto del enlace perdido decia lo contrario de lo que pasa
    Verificado en banco leyendo la linea CTRL,ALM real:
    CTRL,ALM,18,!! SENSORBOARD LINK LOST,AUXILIARY TELEMETRY UNAVAILABLE -
    DOES NOT AFFECT THERMAL CONTROL
    Ese texto es de cuando esto se diseno como telemetria auxiliar. En un equipo
    con SensorBoard sus SHT40 SON el sensor de aire: perder el enlace deja al PID
    sin variable de control y dispara ALARM_AIR_SENSOR_FAULT, que corta el
    calefactor. El operador habria leido "no afecta al control termico" con el
    calefactor cortado y las dos alarmas sonando a la vez.
    Ahora dice la causa y que revisar: "SIN TEMPERATURA DE AIRE - REVISAR CONEXION
    DEL SENSORBOARD".
    Ademas se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
    [alarm_text.cpp, sensorboard_comm.cpp]
2026-09-03 fix(motherboard): votar las tres posiciones de sensor, no promediarlas
    El valor que sale de sensorboard_apply_room_sensor() gobierna A LA VEZ el PID
    de aire, el corte termico (security.cpp:322) y la alarma de desviacion
    (security.cpp:680): las tres barreras leen la misma variable. Con una media
    simple, UN solo sensor sesgado las engana a las tres y en la direccion
    peligrosa.
    La cuenta: consigna 36 C y la posicion 2 pegada a 25 C (cualquier valor dentro
    del gate de 5-60 C pasaba). (T+T+25)/3 = 36 da T real = 41.5 C. El corte
    termico compara esa misma media, lee 36 y nunca cruza el umbral; la desviacion
    respecto a consigna es cero. Hipertermia silenciosa de 5.5 C. El caso simetrico
    es benigno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
    [sb_env_fusion.cpp, sb_env_fusion.h, sensorboard_comm.cpp]
2026-09-03 fix(motherboard): la telemetria descartaba constantes vitales en silencio
    Bug PREEXISTENTE, no de esta rama, medido al integrar el SensorBoard.
    El limite real de la publicacion no eran los 64 campos ni el buffer MQTT: era
    el pool de 1024 B del StaticJsonDocument. Las 17 claves de alarma se pasaban
    como String, y ArduinoJson COPIA la clave al pool cuando es un String y solo la
    ENLAZA cuando es un literal: 274 B que dejaban el pool en 46 claves utiles.
    En el ciclo siguiente a que se apaga la ultima alarma se escriben las 17 a
    false, y ahi la publicacion pedia 66 claves por GPRS y ~76 por WiFi. Se
    descartaban las ULTIMAS insertadas, que son SpO2, SpO2_SQI, PI y HR1-3 con sus
    SQI. Sin ningun e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
    [GPRS.cpp, Wifi_OTA.cpp, main.h, telemetry_keys.h]
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2026-09-03 fix(comm): detectar la perdida del host por el bus, no solo por el DTR (green)
    El reinicio para re-enumerar (719073a) nunca se disparaba en el caso que
    lo motivo: al desenchufar el cable o reiniciarse la motherboard sin
    cortar VBUS, TinyUSB no invoca el callback de line-state (solo lo hace
    ante SET_CONTROL_LINE_STATE) y, sin sensado de VBUS, el DCD no reporta
    UNPLUGGED sino SUSPEND. El DTR se quedaba en true y el vigilante no
    armaba el temporizador.
    - Senal de host presente = DTR && tud_ready(); la politica (solo si hubo
    host, 15 s, rearme al recuperar, vuelco de uint32) va a sb_host_watch,
    funcion pura con tests Unity.
    - Callback de eventos TinyUSB (SUSPENDED/DETACHED/RESUMED) que limp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
    [main.c]
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2026-09-03 fix(flasher): permitir reflashear una SensorBoard que ya tiene firmware
    Dos causas encadenadas impedian el segundo flasheo de una SensorBoard:
    - La sonda flash-id que desambigua el PID 0x1001 (motherBoard vs.
    SensorBoard virgen) terminaba con el hard-reset por defecto de esptool.
    Con firmware ya grabado, ese reset arrancaba la app, TinyUSB tomaba el
    PHY USB y el puerto USB-Serial/JTAG desaparecia antes del write-flash.
    Ahora la sonda usa --after no-reset y la placa sigue en modo descarga.
    - El PID 0x4001 (app TinyUSB CDC) se trataba como placa flasheable, pero
    esp_tinyusb ignora la secuencia DTR/RTS de esptool y siempre acababa en
    'Failed to connect'. Deja de ser un fingerprint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
    [detector.py, main.py]
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2026-09-03 feat(flasher): mostrar en el slot la identificacion de placa mientras corre la sonda
    Al conectar una placa con el PID nativo ambiguo (0x1001), la sonda
    flash-id que decide entre motherBoard y SensorBoard bloquea varios
    segundos antes de reservar el slot, y la UI no mostraba nada en ese
    tiempo. Ahora el slot se reserva antes de sondear (assign_pending) con
    el titulo 'Identificando placa... · COMx', la barra indeterminada y el
    estado 'Leyendo tamano de flash...' con cronometro; al resolverse se
    promociona al slot normal conservando el reloj, y si la sonda falla el
    slot pasa a error y se libera tras el retardo habitual. Las
    comprobaciones de admision (enfriamiento, descarga en curso, slots
    l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
    [main.py]
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2026-09-03 fix(motherboard): soltar los pull-ups internos de GPIO19/20 antes del host USB
    gpio_reset_pin() deja el pull-up interno (~45k) habilitado; sobre las
    lineas USB del host se suma a su pull-down de 15k y deja la linea baja a
    ~0,8 V, en el umbral del receptor del PHY. El SensorBoard HW4 con D+/D-
    intercambiados no llegaba a detectarse como conectado (banco 2026-09-03;
    con un PC como host si). Con las lineas flotantes el PHY pone sus pulls y
    el enlace sube en ambas orientaciones del conector.
    [sensorboard_comm.cpp]
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2026-09-03 feat(shared): tabla y codec del test de fabrica (FTEST)
    - shared/include/factory_test.h + shared/src/factory_test.cpp: IDs de
    motherBoard (0..29) y del display (64..72), estados, flags optional,
    claves ASCII, y el codec CTRL,FTEST*/HMI,FTEST (design.md D1/D2).
    - motherBoard/src/modules/factory_test/ftest_summary.{h,cpp}: acumulador
    puro de PASS/FAIL/SKIP y sus mascaras, mas la fusion de reintento
    (mb-factory-test "Bateria completa"/"Persistencia del resultado").
    - platformio.ini [env:native]: se anade ftest_summary.cpp al
    build_src_filter (shared/src ya lo compila pre_native.py entero).
    - tasks.md: 1.1-1.4 y 2.1-2.4 marcadas.
    pio test -e native -f test_factory_test y pio test -e n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
    [factory_test.cpp, factory_test.h]
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2026-09-03 feat(hmi): informe de depuracion y peticion de soporte via ThingsBoard
    support_report.cpp: un solo formateador ASCII clave=valor (<=400 B) para las
    dos vias de contacto, asunto con el numero de serie, mailto: percent-encoded
    y la peticion pendiente UI -> tarea WiFi/OTA bajo portMUX. Wifi_OTA.cpp la
    publica como telemetria (support_request/message/report/to) con el broker
    conectado, antes de la telemetria periodica. Nada de red bajo el mutex de
    LVGL (ARQ-LOCK-001).
    [Wifi_OTA.cpp]
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2026-09-03 fix(hmi): review feedback de hmi-boton-ayuda
    Seguridad (bloqueantes):
    - La ayuda cede ante CUALQUIER alarma activa o enlace perdido (criterio de
    TelemetryHistory::mustYield), no ante la lista fija de ids de
    UI_IsCriticalAlarmActive, que deja fuera cuatro condiciones ALTA.
    - La exencion del auto-bloqueo tiene tope: HELP_IDLE_TIMEOUT_MS (3 min) sin
    tocar cierra menu y tutorial; el banner de alarma solo vive en Lock.
    - ArduinoJson copia char[]: JSON_OBJECT_SIZE(4) truncaba la peticion y se
    publicaba 'OK'. Ahora const char* (cero copia) + overflowed().
    Seguridad (recomendados): el tutorial ya no se sube con move_foreground
    (quedaba sobre el banner y AUDIO PAUSED); aviso 'sin datos del pa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
    [Wifi_OTA.cpp, Wifi_OTA.h]
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2026-09-03 feat(hmi): pantalla de test de fabrica con tests locales y remotos
    Modulo src/ui/FactoryTest.cpp + include/ui/FactoryTest.h (molde
    AlarmCenter), overlay en lv_layer_top() con lista de filas scrollable,
    zona de instruccion/pregunta y resumen final:
    - Boton "TEST FABRICA" en ui_ScreenIntro (ElementsCreation.cpp), abajo a
    la izquierda; intro_timer_cb() no navega mientras g_factoryTestRequested
    este activo; inactivity_timer_cb() no bloquea mientras
    FactoryTest_IsOpen().
    - Tests locales en orden (SYSINFO, I2C, PANEL, TOUCH, BUZZER, SPEAKER,
    WIFI, NVS, LINK), sin delay(), I2C y NVS liberando LVGL_Lock() durante
    la E/S. HMI_BUZZER arbitra el zumbador del display con
    FactoryTest_AudioBu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
    [CommTask.cpp, CommTask.h, ElementsCreation.cpp, FactoryTest.cpp, UITask.cpp]
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2026-09-03 fix(shared): review feedback (cota de 3 digitos en los campos numericos FTEST)
    Rechaza campos numericos de mas de 3 digitos antes de mirar el valor: en el
    host de 64 bits strtoul("4294967296") devolvia 0 y pasaba como id valido.
    Test nuevo en test_factory_test.
    [factory_test.cpp]
2026-09-03 fix(motherboard): review feedback del test de fabrica
    - Gate g_factoryTestActive en el bloque newCommand de main.cpp, la regulacion
    de fototerapia y buzzerHandler(): el keepalive del HMI a 1 Hz ponia el
    calefactor a 0 durante actuatorsTest() y dejaba ALARM_HEATER_FAULT latcheada.
    - Cotas del estado inhibido: task WDT, 6 min de bateria, dead-man del HMI 5 s,
    re-check de actuation/fototerapia en cada espera.
    - NaN nunca es PASS; BQ25730_Status inicializado; LittleFS.begin(false);
    restore() apaga USB_EN y humidificador; CONFIRM se arma antes de emitirse;
    SB_STATUS distingue sin respuesta; sb_fw saneado a ASCII imprimible.
    Compilado pio run -e IncuNest_V18 y pio test -e native (304/304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
    [Buzzer.cpp, CommTask.cpp, CommTask.h, main.cpp, sensorboard_comm.cpp, sensors_module.cpp]
2026-09-03 fix(hmi): review feedback del test de fabrica
    - Off-by-one en los prefijos CTRL,FTEST_DONE/REJECT (17->16, 19->18): el
    display nunca los procesaba. Ahora sizeof(literal)-1.
    - Drena el anillo y los flags al abrir y antes de START (eventos obsoletos).
    - UI_ReassertAlarmOverlays() tras move_foreground del overlay.
    - Callbacks de boton como hand-off puro resueltos en Poll (sin soltar el lock
    ni destruir objetos en el despacho del evento).
    - Barrera de entrada "equipo vacio" (Step::Gate), 120 s sin CTRL,FTEST* ->
    enlace perdido, resumen se cierra a los 10 min.
    Compilado pio run -e main.
    [CommTask.cpp, FactoryTest.cpp, UITask.cpp, UITask.h]
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2026-09-03 feat(motherboard): publicar la telemetria del SensorBoard tambien por GPRS
    TX_GROUP_SENSORBOARD_GPRS pasa a 1. El punto de llamada en GPRS.cpp ya
    estaba dentro de su #if, asi que el flag era lo unico que faltaba: en un
    equipo conectado por modem no llegaba ni una clave sb_*.
    Estaba apagado por presupuesto de campos, y eso era cierto: por GPRS el peor
    caso son 87 claves (CORE 69 + CELLULAR 4 + DIAG 8 + CALIBRATION 6) y el
    bloque son 12, o sea 99, que no cabian en 96. THINGSBOARD_FIELDS_AMOUNT sube
    a 112 y quedan 13 de margen. Cuesta 512 B de .bss exactos, medidos: RAM
    85984 -> 86504 B.
    La OTRA razon que daba el comentario era falsa y se corrige: MAX_MESSAGE_SIZE
    (1024 B) no es un limite aqu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
    [main.h, transport_policy.h]
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2026-09-03 feat(motherboard): aplicar UTC+2 por defecto cuando el reloj lo pone el modem GPRS
    Una unidad solo-GPRS podia quedarse sin zona horaria de por vida: hay
    operadores que no mandan NITZ, Movistar lo manda a 0 (que se descarta a
    proposito por no ser un dato de zona fiable) y la consulta por IP
    necesita un WiFi que esa unidad no tiene. Sin zona, el display pintaba
    UTC, dos horas por debajo del reloj de la pared.
    GPRSEnsureTimeSynced() deja ahora GPRS_DEFAULT_TZ_QUARTERS (8 = UTC+2)
    como suelo, con una fuente nueva TZ_SOURCE_DEFAULT que es la de MENOR
    prioridad de todas: no pisa a NITZ, ni a IP, ni al reloj puesto a mano, y
    cualquiera de las tres la corrige en cuanto aparece, sin esperar a un
    rei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
    [CommTask.cpp, GPRS.cpp, GPRS.h, Wifi_OTA.cpp, test_tz_source.cpp, tz_source.cpp, tz_source.h]
2026-09-03 feat(display): ocultar el boton de TREND de la pantalla de bloqueo
    El acceso a la tendencia de telemetria desde el bloqueo se retira de la
    interfaz, pero el overlay sigue construido (TelemetryHistory_Init) y se
    puede abrir por codigo con TelemetryHistory_Open(), asi que revertirlo es
    quitar una linea.
    Se oculta el contenedor (ui_ChartLockCont) y no solo la etiqueta: con
    LV_OBJ_FLAG_HIDDEN el icono y su area de toque extendida desaparecen
    tambien del hit-test, de modo que no queda una zona muerta que se coma
    el toque de desbloqueo.
    [ElementsCreation.cpp]
2026-09-03 revert(motherboard): quitar la zona horaria por defecto por GPRS
    Revierte 713d52d por decision de producto: el equipo vuelve a quedarse
    sin zona horaria cuando el reloj lo pone el modem y nadie la comunica, en
    vez de suponer UTC+2.
    Se va la feature entera porque todo lo que traia existia solo para
    sostenerla: TZ_SOURCE_DEFAULT y su regla de prioridad,
    GPRS_DEFAULT_TZ_QUARTERS, el tzsrc=4 del protocolo y sus 7 tests. Y
    tz_source_is_resolved() tambien, que solo hacia falta porque el defecto
    enganaba a tz_source_known() en las dos cadencias de busqueda de zona:
    sin defecto que aplicar, las dos preguntas vuelven a ser la misma.
    Revert y no reescritura de historia porque 713d52d ya estaba en
    or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
    [CommTask.cpp, GPRS.cpp, GPRS.h, Wifi_OTA.cpp, test_tz_source.cpp, tz_source.cpp, tz_source.h]
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2026-09-04 fix(hmi): review feedback de hmi-cursos-formacion (fase 1)
    Bloqueantes de seguridad y verify:
    - inactivity_timer_cb reiniciaba el contador de LVGL cada 200 ms con la
    ayuda o la formacion abiertas, asi que el tope de 3 min no llegaba nunca
    (afectaba tambien al menu de ayuda ya mergeado). Ahora exime del bloqueo
    sin reiniciar el contador; los _Poll() lo leen y cierran.
    - El selector cede ante alarma / enlace / apagado e inactividad
    (TrainingSelector_Poll) y un aborto de leccion no reabre el selector:
    la pantalla clinica queda limpia.
    - Los botones CONECTAR / DESCONECTAR WiFi se rechazan en formacion
    (cambiaban el equipo de verdad y persistian en NVS).
    - Bucle de enterStep acotado y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
    [CommTask.cpp, UITask.cpp, UITask.h]
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2026-09-04 fix(motherboard): test de fabrica tras el banco (sensorboard unico, WARN, flags GSM)
    - ftest_sensorboard: PASA por USB o por I2C2 con lectura real y fresca; los
    sb_* hacen SKIP sin USB. Sustituye a sensor_src + sb_link, que daban FAIL
    con SensorBoard conectada por el ACK falso del sondeo I2C2.
    - GPRS.modemResponded / GPRS.simReady: gsm_at ya no depende de powerUp (solo
    es true durante el arranque del modem) y gsm_sim basta con +CPIN: READY.
    - gsm_net, wifi, tb_provision y time: 30 s y WARN en vez de SKIP/FAIL.
    - FTEST_DONE con warn y NVS mb_ftest/warn.
    Compilado pio run -e IncuNest_V18 (RAM 26.3 %, Flash 54.4 %).
    [GPRS.cpp, GPRS.h, preferences_keys.h]
2026-09-04 fix(hmi): boton HW test centrado y armado, cuadricula de tests, sin panel ni toque
    - El test se abria solo: toque fantasma del GT911 en una esquina durante el
    init, estirado por el debounce a un CLICKED valido sobre un boton en la
    esquina con area extendida. Ahora centrado abajo, sin area extendida,
    armado a 1,5 s y con comprobacion del punto del indev.
    - Sin tests de panel ni de toque.
    - Cuadricula de 3 columnas ordenada FALLA > AVISO > en curso > PASA, SKIP
    ocultos, panel de detalle con descripcion/valor/Reintentar.
    - FTEST_DONE de 4 campos, WARN final, resumen errores/avisos/OK, NVS mb_warn.
    Compilado pio run -e main (RAM 38.6 %, Flash 78.7 %).
    [CommTask.cpp, CommTask.h, ElementsCreation.cpp, FactoryTest.cpp, UITask.cpp]
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2026-09-04 fix(hmi): review feedback de la cuadricula del test de fabrica
    Botones creados una vez por fila y actualizados in-place; reorden con
    lv_obj_move_to_index solo si cambia el orden; SKIP ocultos con HIDDEN.
    El panel de detalle se cierra si llega un WAIT/CONFIRM y no se abre con una
    pregunta Si/No pendiente. Compilado pio run -e main (RAM 38.8 %, Flash 78.7 %).
    [FactoryTest.cpp]
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2026-09-05 fix(hmi): review feedback de las lecciones (fases 2 y 3)
    Bloqueantes de seguridad:
    - endLesson() decidia volver a la principal con UI_IsScreenLocked(), pero
    la global 'locked' vale true en la principal casi siempre (la rearma
    unlock_timeout_cb 5 s tras desbloquear): un aborto por alarma desde
    Ajustes dejaba Ajustes en pantalla, sin banner ni icono de alarmas. Ahora
    se mira lv_scr_act() == ui_ScreenLock. UI_IsScreenLocked() se retira para
    que nadie vuelva a usarla como 'pantalla bloqueada'.
    - E8/E9 usaban 'locked' como objetivo y se daban por hechas sin bloquear ni
    desbloquear. Objetivos por pantalla activa y pop-up visible.
    Recomendados: los objetivos por visibilidad exigen adema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
    [UITask.cpp, UITask.h]
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2026-09-05 fix(hmi): salvaguardas de la actuacion real en formacion (review de seguridad)
    - Confirmacion previa a cada leccion interactiva: el selector pide a la
    placa la lista REAL de bebes activos (antes de entrar en formacion) y
    rechaza la leccion si hay alguno o no responde en 2,5 s; el alumno tiene
    que pulsar 'SI, LA CABINA ESTA VACIA. EMPEZAR' tras un aviso que nombra lo
    que va a pasar; queda en el log. El gate de la HMI no puede ver un bebe
    sin terapia.
    - Watchdog de la lampara: en formacion la linea de estado nunca sale con
    fototerapia ON y 0 minutos (TRAINING_PHOTO_TIMER_MIN = 5), por si la HMI
    se reinicia con la lampara encendida (la placa no corta la terapia al
    perder el enla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
    [BabyHistory.cpp, BabyWizard.cpp, CommTask.cpp, UITask.cpp]
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2026-09-05 fix(hmi): test de fabrica paginado, colores unificados, barra de progreso y veredicto
    - Cuadricula paginada 3x3 con < > e indicador; sigue al test en curso salvo
    paginacion manual. Sin scroll.
    - Colores: blanco en curso, verde OK, amarillo aviso, rojo error.
    - HMI_I2C decide con el init del GT911 y del backlight; el sondeo es informativo.
    - Sin tests de zumbador ni altavoz del display.
    - Barra de progreso y veredicto HW OK / HW ERROR persistido; watchdog de
    100 s por fila de la placa.
    Compilado pio run -e main (RAM 39.2 %, Flash 80.6 %).
    [FactoryTest.cpp, UITask.cpp, UITask.h]
2026-09-05 fix(motherboard): review feedback (sello de frescura del BQ25730 en charger)
    g_bq_status_ms junto a g_bq_status_valid: un true rancio de una sensors_Task
    parada ya no vale como PASS. Correccion de la atribucion: quien refresca el
    BQ25730 es sensors_Task, no PowerManagement_Task. Compilado pio run -e IncuNest_V18.
    [BQ25730.h, main.cpp]
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2026-09-06 fix(motherboard): buzzer sin confirmacion, power_src y sb_door omitidos, charger WARN sin vbus
    - buzzer: sin microfono -> SKIP sin microfono; retirada la infraestructura de
    CONFIRM (semaforo y factoryTestConfirm), HMI,FTEST,CONFIRM se descarta con log.
    - power_src y sb_door omitidos por ahora (SKIP): a bateria el BQ25730 no esta
    alimentado y el jig no monta la puerta.
    - charger: sin respuesta -> WARN sin vbus.
    - 60 ms entre el final de un test y el RUNNING del siguiente para no desbordar
    el anillo del display con rafagas de SKIP.
    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
    [CommTask.cpp]
2026-09-06 fix(hmi): sin logs en secciones criticas, anillo de 32, cabecera desde filas, aviso en pop-up
    - El HMI se reiniciaba con Interrupt wdt timeout on CPU1: el log de anillo
    lleno estaba dentro de taskENTER_CRITICAL. Ahora la seccion critica solo
    copia datos; el log sale fuera. Anillo 8 -> 32 y contador de descartes
    visible en la fila Enlace.
    - Cabecera y persistencia calculadas siempre desde las filas (antes usaban
    FTEST_DONE y podian decir 0 errores con botones rojos).
    - Aviso de equipo vacio como pop-up modal centrado.
    Compilado pio run -e main (RAM 39.6 %, Flash 80.7 %).
    [CommTask.cpp, CommTask.h, FactoryTest.cpp]
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2026-09-06 fix(hmi): la pagina sigue al ultimo RUNNING; WAIT antes que RUNNING; watchdog por fila a 150 s
    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
    [FactoryTest.cpp]
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2026-09-06 fix(hmi): la fila Test de hardware se deshabilita en modo formacion
    dev trae el modo formacion (Training_IsActive): el test inhibe alarmas y PID
    en la placa, un efecto real que un alumno no debe poder disparar. Subtexto
    propio "No disponible en formacion". Compilado pio run -e main (RAM 40.5 %,
    Flash 83.2 %).
    [FactoryTest.cpp]
2026-09-06 fix(hmi): centrar el boton TREND del bloqueo en la columna derecha
    Misma x que Status/Photo (x=240): el usuario percibia 3 columnas en la
    pantalla de bloqueo (medidas / hueco / Status-Photo-Alarm) y el boton
    quedaba descolgado en la del medio. Coordenada vertical sin tocar
    (y=70, sigue libre de ui_LockPPGChart/ui_LockHRCont).
    Verificado: pio run -e main (SUCCESS). Verificacion visual en hardware
    real pendiente.
    [ElementsCreation.cpp]
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2026-09-06 feat(motherboard): activar la SIM Onomondo en el test de fabrica
    Cada incubadora lleva una SIM Onomondo que hay que activar en la plataforma
    antes de que la unidad salga de fabrica. Hasta ahora era un paso manual y no
    quedaba constancia de si se habia hecho.
    Se anade el test `sim_act` (FTEST_MB_SIM_ACT, id 28) a la bateria de fabrica:
    lee el ICCID que GPRS_Task ya saca del modem, consulta
    GET /sims/{iccid} y, si `activated` es false, manda
    PATCH /sims/{iccid} con {"activated":true}. Si ya estaba activada no hace
    nada, para no repetir llamadas.
    A diferencia de gsm_net/wifi/tb_provision/time, este test NO es opcional:
    agotar el plazo es FAIL y no WARN, porque una incubadora no puede salir de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
    [Credentials_public.h, factory_test.cpp, factory_test.h]
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2026-09-06 fix(hmi): reservar los bounce buffers del panel antes de arrancar WiFi
    El HMI no arrancaba: esp_lcd_new_rgb_panel() devolvia ESP_ERR_NO_MEM y el
    ESP_ERROR_CHECK lo convertia en abort() en bucle, con la pantalla negra. El
    panel pide DOS bounce buffers de 38,4 KB contiguos y DMA-capaces en SRAM
    interna, y los pedia dentro de UI_Task, o sea despues de que WiFi hubiese
    arrancado y partido el heap. El libre total (133 KB) despistaba: lo que
    faltaba era un bloque contiguo.
    Lo que agoto el margen fue el historico de telemetria (ventanas 1h/2h/4h):
    17,3 KB de .bss interno para tres arrays que solo toca la CPU.
    - TelemetryHistory: los tres canales pasan a un unico bloque de PSRAM
    reservado al vue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
    [UITask.cpp, UITask.h, main.cpp, main.h]
2026-09-06 fix(hmi): ordenar la pantalla de Ajustes (fila de test, aviso de mantenimiento y panel WiFi)
    Tres defectos vistos en banco, los tres de colocacion de objetos LVGL:
    - La fila TEST DE HARDWARE no se veia: ui_HwTestCont y ui_MaintCont estaban
    las dos en y=120 dentro de ui_Container3 y, como la de mantenimiento se
    crea despues, se pintaba encima. La de test pasa a y=175 (sexta ranura de
    la lista, 55 px por fila desde y=-100), su subtexto de aviso a y=208, y el
    contenedor crece de 420 a 450 px de alto para que ambos quepan: LVGL
    recorta a los hijos que se salen del padre.
    - El aviso de mantenimiento salia al volver ATRAS: el overlay cuelga de
    ui_ScreenMain, asi que pulsando VER RECO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
    [ElementsCreation.cpp, MaintenanceDialog.cpp, UITask.cpp]
2026-09-06 fix(ftest): no perder lineas de resultado y cerrar las filas sin ellas
    En banco quedaban tests "en curso" para siempre al terminar la bateria (3
    por WiFi, 13 por GPRS). La motherBoard emite UNA sola linea de resultado por
    test; si esa linea se pierde, el display no tiene con que cerrar la fila, y
    Step::Summary ya no drena eventos ni vigila plazos, asi que la fila se queda
    "en curso" hasta que se cierra la pantalla. Tres arreglos, uno por cada sitio
    donde se puede perder la linea, mas el cierre honesto de las filas huerfanas:
    - HMI, anillo de RX (la causa mas probable): el driver de UART reservaba los
    256 B por defecto, ~22 ms de linea a 115200. La tarea Comm deja de drenar
    mientras espe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
    [CommTask.cpp, CommTask.h, FactoryTest.cpp, factory_test.h, main.cpp, main.h]
2026-09-07 fix(hmi): sacar la fila "Test de hardware" de debajo de la de Mantenimiento
    En `dev` la fila del test de fabrica no se ve en Settings: `ui_HwTestCont` y
    `ui_MaintCont` estan los dos en y=120 del mismo contenedor, y Mantenimiento se
    crea despues, asi que se pinta encima y tapa la fila entera (panel, texto y
    flecha). El boton sigue ahi y sigue siendo pulsable, pero es invisible.
    Se mueve la fila a la sexta ranura (y=175, la lista va cada 55 px desde
    y=-100), su subtexto de aviso a y=208, y el contenedor de 420 a 450 de alto
    para que la ultima fila y su subtexto no queden recortados: el borde inferior
    cae en y=+215 de pantalla, dentro de los 480 del panel.
    Es el mismo arreglo que estaba sin c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
    [ElementsCreation.cpp]
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2026-09-07 fix(hmi): el contador de progreso del test de hardware excluye los omitidos
    Hechos = terminales que no son SKIP; total = esperados menos omitidos, con el
    rango de la barra actualizado. Antes decia 34 tests con una cabecera que
    sumaba 26. Compilado pio run -e main (RAM 40.5 %, Flash 83.8 %).
    [FactoryTest.cpp]
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2026-09-07 fix(hmi): el aviso de mantenimiento se pinta en la pantalla activa
    Abierto desde Ajustes con VER RECORDATORIO, el overlay colgaba de
    ui_ScreenMain y no se veia hasta pulsar ATRAS. Ahora se muda a lv_scr_act()
    al abrirse, vuelve a su padre al cerrarse, y _Poll() lo cierra si la pantalla
    cambia debajo para no dejar s_open bloqueando el auto-bloqueo.
    [MaintenanceDialog.cpp]
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2026-09-07 fix(flasher): flashear otadata en las tres placas, la SPIFFS del HMI y la SensorBoard completa
    - ota_data_initial.bin se genera en local (8 KB de 0xFF) para motherboard
    (0xE000), HMI (0xE000) y SensorBoard (0xD000): una placa actualizada por
    OTA seguia arrancando app1 tras un reflasheo USB aparentemente correcto.
    - spiffs.bin del HMI en 0xA10000: sin el, la unidad salia sin heartbeat.mp3.
    - La copia desde .pio/build lleva bootloader, particiones y SPIFFS, no solo
    firmware.bin; la release incluye los assets de la SensorBoard.
    - Faltas y checksums malos salen en el registro en vez de saltarse.
    76 tests pytest en verde.
    [flasher.py, main.py, updater.py]
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2026-09-08 feat(motherboard): permanencia en la red WiFi como logica pura y probada
    Cuenta dias UTC DISTINTOS en la misma SSID, no tiempo transcurrido: un
    equipo embalado dos semanas tras una sola asociacion no acumula nada, y
    uno enchufado 14 dias si. El cambio de SSID resetea el contador con
    reloj o sin el, que es lo que evita acreditar al hospital los dias del
    sitio del montaje.
    Sin Arduino ni Preferences, como tz_source, para que entre en
    [env:native]: 21 tests Unity en verde. El struct lo persiste el
    llamante, y solo cuando update() dice que algo cambio, con lo que un
    enlace que parpadea no produce ninguna escritura en NVS.
    Aqui no hay ninguna constante de politica -- ni el umbral de 14 dias ni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
    [wifi_dwell.cpp, wifi_dwell.h]
2026-09-08 feat(motherboard): posicion aproximada por IP, parseada como dato hostil
    Al dar de baja la SIM desaparece la unica fuente de posicion que tiene la
    flota: la triangulacion por torres del modem, y
    TX_FEATURE_TRIANGULATION_WIFI esta a 0 porque el WiFi no da un fix de
    torre. Esto mantiene la unidad en el mapa con precision de ciudad, sin una
    sola peticion nueva: la consulta a ip-api.com que ensureWifiTimeZoneSynced()
    ya hace a diario para la zona horaria solo tiene que pedir mas campos.
    Esa consulta va en HTTP EN CLARO (el nivel gratuito no tiene TLS), asi que
    la respuesta es manipulable y se parsea como tal: se exige
    "status":"success", claves entrecomilladas para no casar con "latency" ni
    "lo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
    [ip_geoloc.cpp, ip_geoloc.h, test_ip_geoloc.cpp]
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2026-09-08 perf(motherboard): limitar el sondeo de permanencia WiFi a una vez por minuto
    La tarea de OTA corre a 20 Hz (OTA_TASK_PERIOD_MS = 50) y WiFi.SSID()
    devuelve un String: veinte asignaciones de heap por segundo para vigilar algo
    cuya resolucion util es el DIA. La primera pasada sigue siendo inmediata para
    que los atributos aparezcan en cuanto haya broker. El precio es que un cambio
    de red tarda hasta un minuto en verse, que no significa nada frente a un
    criterio de catorce dias.
    [Wifi_OTA.cpp]
2026-09-08 feat(motherboard): arranque silencioso, sin ningun pitido al encender
    El encendido emitia tres senales acusticas seguidas: el pitido fijo de 300 ms
    de testBuzzer() en las placas HW>=17 y los dos pitidos cortos de
    buzzerTone(2, ...) con los que initHardware() anunciaba el fin del autotest.
    Se retiran las dos.
    El pitido de testBuzzer() no verificaba nada en HW>=17: esa rama no mide
    corriente, testCurrent se queda en 0.0 y la comparacion con
    BUZZER_CONSUMPTION_MIN == 0 nunca declara DEFECTIVE_BUZZER. La medida real
    sigue intacta en la rama HW<=16, que si energiza el zumbador para leer su
    consumo por el shunt de sistema.
    Nada mas cambia: el zumbador de alarmas (buzzerAlarmUpdate) y el test de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
    [initHardware.cpp]
2026-09-08 fix(flasher): el HMI se identificaba como motherBoard en la actualizacion WiFi
    El firmware del HMI se anuncia por mDNS como "IncuNest-Display-<sn>"
    (WIFI_NAME en Display_HMI/include/main.h), con guion. _board_from_hostname
    comparaba contra "IncuNest_Display", con guion bajo, asi que ningun HMI
    casaba y todos caian en la rama generica "IncuNest" -> MOTHERBOARD.
    No era solo la etiqueta de la UI: wb.board tambien elige la carpeta de
    imagen en flash_board_wifi, de modo que actualizar por WiFi le habria
    escrito data/firmware/motherboard/firmware.bin a un Display HMI.
    Dos cambios:
    - _board_from_hostname acepta ambas grafias, y compara en minusculas
    porque los nombres mDNS son case-insensitive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
    [wifi_flasher.py]
2026-09-08 revert(motherboard): recuperar el pitido de arranque de testBuzzer()
    El commit anterior (8f78ab3) se llevo por delante los dos pitidos de
    buzzerTone() Y el de testBuzzer(). Este ultimo se queda: aunque en HW>=17 no
    mide corriente, es la unica comprobacion audible que recibe el operador de que
    el zumbador de alarmas funciona antes de usar la incubadora, y perderla
    significa enterarse de un zumbador muerto cuando falte la primera alarma.
    Queda retirado solo el buzzerTone(2, ...) de fin de autotest, que no verificaba
    nada. Arranque: un pitido, no tres.
    Verificado: pio run -e IncuNest_V18 y -e IncuNest_V17, ambos SUCCESS.
    [initHardware.cpp]
2026-09-08 fix(ota): cada placa rechaza por si misma el firmware de otra placa
    Complemento de 0363e2b, que arreglo la herramienta. Aquel commit corrige quien
    elige el binario; este quita la premisa de que la herramienta acierte.
    Lo que paso: un Display HMI actualizado por WiFi se quedo con la pantalla
    violeta, sin tactil y sin enlace (la MB dando alarma), mientras el mismo
    binario por USB arrancaba bien. El flasher le habia subido el firmware de la
    motherBoard, y nada aguas abajo objeto: las dos placas son ESP32-S3, la imagen
    de la MB (1,5 MB) entra de sobra en el slot de app del HMI (5 MB) y esp_ota
    solo mira el chip y el tamano. El HMI arranco con firmware de MB, que nunca
    crea el panel RGB. Solo se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
    [GPRS.cpp, Wifi_OTA.cpp, fw_guarded_updater.h, fw_image_tag.cpp, fw_image_tag.h, wifi_flasher.py]
2026-09-08 fix(hmi): el LINK LOST fantasma al caer el WiFi era una inversion de prioridades
    Al perderse la senal WiFi aparecia BOARD LINK LOST unos segundos, con las
    cifras en blanco y el patron acustico, y se corregia solo. La placa nunca
    habia dejado de hablar: era el display el que dejaba de escuchar.
    La tarea Comm, unica oyente del cable, era la de MENOR prioridad de las tres
    del core 1 (UI 5, OTA/WiFi 4, Comm 3). PubSubClient espera bytes con espera
    ACTIVA de hasta MQTT_SOCKET_TIMEOUT (15 s de serie): readByte() gira en
    `while(!available()) yield();` y connect() gira sin ceder siquiera. yield() es
    taskYIELD(), que no cede a tareas de menor prioridad, y available() es un
    ioctl que nunca bloquea, a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
    [CommTask.cpp, CommTask.h, main.h]
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2026-09-10 fix(hmi): review feedback del registro desde Bebes
    Hallazgos de code-reviewer y security-reviewer (2026-09-10):
    - ACK huerfano: g_pendingProfileAck/Range se descartan al abandonar
    cualquier espera de Bebes (timeout, alarma critica, cierre) y justo antes
    de cada envio, tambien en el asistente (selectExisting, PROFILE_NEW) y en
    el alta. Sin esto, un ACK de registro llegado tarde se convertia en el ACK
    del PROFILE_SELECT del asistente y rango, peso y minutos iban a otro bebe.
    - Guarda positiva: BEBE NUEVO solo con lista de activos venida de la placa
    (s_activeFromBoard) y enlace vivo; con la lista vacia por timeout la
    guarda de tres dejaba pasar el PROFILE_NEW y la placa desalojaria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
    [BabyHistory.cpp, BabyWizard.cpp, CommTask.cpp]
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2026-09-10 fix(motherboard): publicar la posicion por IP solo cuando cambia
    Regresion introducida en df1c4d2. El root chain de ThingsBoard manda TODA la
    telemetria al chain "Country estimator", que llama a Nominatim mientras el
    equipo no tenga guardado el atributo de servidor `country`. Por WiFi se
    publica cada TX_WIFI_PUBLISH_MS (5 s), asi que soltar ahi la posicion por IP
    en cada ciclo son ~17.000 peticiones al dia POR UNIDAD, todas con el MISMO
    valor: eso banea la IP del servidor y se lleva por delante la estimacion de
    pais de toda la flota. Con 200 unidades a punto de darse de alta, son
    millones al dia.
    La posicion por IP cambia una vez al dia como mucho, asi que la cadencia
    correcta es "cuando ca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
    [Wifi_OTA.cpp, ip_geoloc.cpp, ip_geoloc.h, test_ip_geoloc.cpp]
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2026-09-10 fix(flasher): no empaquetar nunca el binario de los entornos de fabrica
    Consecuencia no vista de 6de94fe. "Actualizar binarios locales" elegia el
    build ordenando los .pio/build/*/firmware.bin por una clave que extrae el
    numero de revision del NOMBRE del entorno. "IncuNest_V18_factory" contiene
    V18, asi que puntuaba 18 igual que "IncuNest_V18", y el desempate era el
    mtime: se copiaba a data/firmware/ el que se hubiera compilado mas tarde.
    Comprobado en este workspace: V18_factory (17:40) es mas reciente que V18
    (17:38), asi que hoy se habria empaquetado el de fabrica -- el que lleva
    ONOMONDO_API_KEY, en la carpeta que acaba como asset de GitHub Releases de un
    repo publico. Separar los dos bu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
    [main.py]
2026-09-10 fix(hmi): el sello del enlace se iba al futuro y disparaba un LINK LOST
    En banco (2026-09-10), en CADA desbloqueo: se abria el pop-up de
    mantenimiento, salia BOARD LINK LOST unos ms con su pitido y sus cifras en
    blanco, el pop-up se cerraba solo y todo volvia a la normalidad. En el
    registro de la placa NO habia ningun ALARM_HMI_LINK_LOST, asi que el
    latido del display nunca se paro: la placa seguia oyendo, y el unico que
    afirmaba haber perdido el enlace era el propio display.
    El fallo estaba en el descuento que se anadio como tercera capa del arreglo
    del LINK LOST fantasma por WiFi (7f6475d). La contabilidad de la cabecera de
    Comm_Task() mide `gap` desde la CABECERA de la pasada anterior, p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
    [CommTask.cpp]
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2026-09-10 fix(hmi): centrar el boton BEBE NUEVO en la pantalla Bebes
    El cuerpo de la lista es un flex en columna con la alineacion por defecto
    (izquierda), asi que el boton, mas estrecho que las tarjetas, quedaba pegado
    al margen. Va en una fila propia de 600 px y centrado en ella, como la fila
    de paginacion; centrar el flex entero habria movido tambien los rotulos de
    seccion y las tarjetas.
    Verificacion: pio run -e main en verde (RAM 124 996 B, Flash 2 665 916 B).
    [BabyHistory.cpp]
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2026-09-10 fix(hmi): el eco viejo ya no apaga el control recien encendido
    Tras el asistente del bebe -- seleccionar bebe, meter el peso, APLICAR la
    temperatura propuesta -- el control de temperatura se ponia en ON y caia a
    OFF acto seguido. Lo mismo con la fototerapia.
    El unico sitio del display que puede apagar esos switches solo es
    Display_ApplyCtrlState(), que resincroniza actuation/controlMode/
    phototherapyMode/muteAlarm/skinModeEnabled desde el CTRL,STATE de la placa
    en cada trama (hace falta para que un display reiniciado herede el estado
    real, known_issues.md #4). Una trama ya en vuelo lleva todavia el valor de
    ANTES de que la placa procesara la orden; adoptarla no solo repinta el
    switch, escri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
    [CommTask.cpp]
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2026-09-10 fix(port): configuracion de build y cabeceras hub del HMI
    Tres arreglos de configuracion y dos de cabeceras que, juntos, bajan el HMI
    de 28 a 16 ficheros sin compilar. Ninguno toca logica.
    CONFIGURACION
    1. LVGL usa el lv_conf.h del proyecto, no su Kconfig. El componente de LVGL
    para ESP-IDF, si le dejas, se configura por menuconfig y se salta
    include/config/lv_conf.h. Eso habria sido un cambio de comportamiento
    encubierto: ahi viven la profundidad de color, el pool de LVGL y el juego
    de fuentes con el que esta cuadrada la UI. Se apaga con LV_KCONFIG_IGNORE
    y se apunta con LV_CONF_PATH. Quita de golpe 41 errores de
    lv_font_montserrat_* y lv_qrcode_*.
    2. Estandar de C++ fi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
    [CommTask.h, UITask.h, Wifi_OTA.h, display_comms.h]
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2026-09-11 fix(motherboard): dimensionar la respuesta de los 9 RPC, que nunca contestaban
    Ningun RPC server-side respondia, por ninguno de los dos transportes. Los
    nueve RPC_Callback se construian sin el tercer argumento responseSize, cuyo
    defecto es JSON_OBJECT_SIZE(Default_RPC_Amount) con Default_RPC_Amount = 0
    (Constants.h del SDK 0.13.0): capacidad cero. Con THINGSBOARD_ENABLE_DYNAMIC=1
    el SDK monta TBJsonDocument(0), el primer response[...] desborda, se loguea
    "RPC response overflowed" y ThingsBoard.h hace break SIN enviar la respuesta.
    El handler si corre -- checkOta llegaba a forzar la comprobacion de OTA --,
    pero el servidor espera hasta agotar el plazo y devuelve 504. Medido el
    2026-09-10: 50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
    [GPRS.cpp, Wifi_OTA.cpp]
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2026-09-11 fix(motherboard): avisar a 1 C de desviacion de aire, no a 3 C
    Con +-3 C y el corte termico topado a 38 C, la desviacion de aire solo
    avisaba antes que el corte con consignas por debajo de 35 C: a 35 C
    alarmaba en el mismo punto que el corte —que ademas es ALTA, latching y
    exige reset manual— y a partir de 36 C no alarmaba nunca. Entre la
    consigna y el disyuntor no quedaba ningun aviso intermedio.
    Es lo que dejo callada a una unidad en campo con consigna de 35 C que la
    fototerapia subio a 37 C: +2 C sobre la consigna, con el bebe dentro, el
    lazo saturado a 0 y sin capacidad de refrigerar, porque el calor lo metia
    una fuente externa. La correccion era del operador y nadie le aviso.
    201.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
    [alarm_text.cpp, security.cpp]
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2026-09-11 fix(port): cinco fallos encontrados en el primer arranque en hardware
    Primera vez que el porte corre en placa. Las dos arrancan, se hablan por el
    cable y la OTA por WiFi completa. Cinco cosas que solo se ven con hardware:
    1. LA MOTHERBOARD ENTRABA EN PANIC: "A stack overflow in task main", justo
    tras leer la configuracion de NVS. Causa: arduino-esp32 NO llamaba a
    setup()/loop() desde app_main, creaba una tarea propia "loopTask" y las
    ejecutaba alli. De esa tarea dependian tres cosas que yo habia perdido:
    pila de 8192 B (main_task tiene 4096), NUCLEO 1 (main_task corre en el 0,
    y todo el reparto de tareas del firmware se calibro con setup() en el 1) y
    prioridad 1. Ahora app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
    [ESP32_config.cpp]
2026-09-12 refactor(motherboard): retirar el encoder rotativo
    Hardware de una revision anterior que no se monta en esta placa.
    encoderISR() no estaba enganchada a ninguna interrupcion —initInterrupts()
    solo registra fanEncoderISR, que es el TACOMETRO DEL VENTILADOR y se queda—
    asi que era codigo inalcanzable en produccion.
    Se retiran el objeto RotaryEncoder, sus variables, las macros
    (ENCODER_TICKS_DIV, NUMENCODERS, encPulseDebounce, buzzerRotaryEncoderTone) y
    la libreria vendorizada.
    Y los pines: ENC_A/ENC_B/ENC_SWITCH eran FAKE_PIN, que es GPIO46 — un pin
    real, y de strapping, que se estaba configurando de verdad con pull-up en cada
    arranque sin que nadie lo usara.
    [ISR.cpp, board.h, initHardware.cpp, main.h]
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2026-09-12 fix(alarmas): tres defectos de banco — ventilador, enclavamiento y un aviso que sonaba sin verse
    1) ALARM_FAN_FAILURE NO SE PODIA RETIRAR NUNCA. Estaba en
    ongoingFanCriticalAlarm(), asi que declararla CORTABA LA ALIMENTACION del
    ventilador; sin alimentar las rpm son 0 por construccion y checkFanSpeed()
    volvia a declararla. Enclavamiento de hecho, sin reset que lo levante. Es lo
    que se vio en banco: la alarma seguia puesta despues de corregir el fallo
    del sensor de aire.
    Quitarla no relaja nada: el calefactor lo corta alarm_cuts_heater(), que
    lista ALARM_FAN_FAILURE explicitamente. Y un ventilador a 2800 rpm sigue
    moviendo aire; cortarlo a 0 quitaba la poca ventilac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
    [AlarmCenter.cpp, UITask.cpp, alarm_policy.cpp, alarm_policy.h, security.cpp]
2026-09-12 feat(debug): modo depuracion en las dos placas, bateria de banco y reset manual de alarmas
    MODO DEPURACION. Endpoints /debug/* sobre el servidor web que ya existia, con
    la autenticacion de /config. Reglas que cumple, porque esto va en un equipo que
    calienta a un recien nacido:
    1. Arranca SIEMPRE apagado. No se persiste en NVS a proposito: un reinicio
    —incluido el del watchdog— devuelve la placa a la realidad.
    2. Apagarlo retira TODAS las simulaciones de golpe.
    3. Las simulaciones no tocan la maquina de alarmas por la puerta de atras:
    inyectan la MEDIDA y securityCheck() decide. Lo que se prueba es la logica
    de verdad, no una maqueta.
    4. /debug/state es de SOLO LEC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
    [CommTask.cpp, CommTask.h, Wifi_OTA.cpp, main.cpp]
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2026-09-12 feat(hmi): el display deja de publicar telemetria; conserva la OTA remota
    Publicaba addTelemetriesToWIFIJSON() cada 5 s. Se quita por dos motivos que
    apuntan al mismo sitio:
    1. LA PANTALLA. El framebuffer vive en PSRAM y el bounce buffer del panel se
    rellena leyendo de ahi; el trafico WiFi le roba ancho de banda y desactiva
    interrupciones. En banco, cortar esta publicacion fue lo que mas mejoro el
    temblor. El arreglo de fondo fue CONFIG_SPI_FLASH_AUTO_SUSPEND, pero no hay
    razon para pagar este trafico si ademas no hace falta:
    2. NO ES SUYO. La duena de la telemetria es la motherBoard, que debe ser el
    unico dispositivo en ThingsBoard (openspec shared-cascade-ota-distribution)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
    [Wifi_OTA.cpp]
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2026-09-14 fix(motherboard): el aviso del corte por debajo de la consigna no se veia
    Lo puse con logI(), que esta detras de LOG_INFORMATION, y ese flag es false
    en include/main.h. Se compilaba a nada: un aviso que no avisa. Pasa a
    ESP_LOGW, que no esta condicionado.
    Verificado en banco, y de paso confirma la trampa que el aviso existe para
    cazar. La unidad 353, recien flasheada, arranca con:
    W (660) APP: corte termico de aire a 38.0 C, por debajo del tope de
    consigna (39.0 C): una consigna por encima del corte disparara
    ALARM_AIR_THERMAL_CUTOUT sin poder alcanzarse. Ajusta air_tmax a 40.0
    en /config.
    Es decir: lleva 38 guardado en NVS de su inicializacion de fabrica y NVS
    manda sobre el comp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
    [EEPROM.cpp]
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2026-09-14 fix(hmi): el display preguntaba por OTA una vez y se quedaba enganchado
    WIFICheckOTA() ponia OTA_inprogress = true, y esa bandera solo la limpiaba
    updatedCallback(false). Si ThingsBoard NO tiene firmware asignado a este
    dispositivo ese callback no llega nunca: Start_Firmware_Update() se suscribe
    y se queda esperando un atributo que no existe. La bandera se quedaba puesta
    para siempre y, como la comprobacion periodica de WIFI_TB_OTA() esta guardada
    por !OTA_inprogress, el display preguntaba UNA VEZ al conectar y nunca mas.
    Medido en banco (2026-09-14), display asociado y TB conectado:
    I (5178) WiFi: TB connected
    I (5xxx) WiFi: Checking ThingsBoard firmware update... <- una, al arranca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
    [Wifi_OTA.cpp]
2026-09-14 fix(motherboard): ensanchar la histeresis del corte termico del aire a 0.5 C
    Con 0.2 C la banda quedaba DENTRO DEL RUIDO del sensor. En banco (2026-09-14,
    consigna 39 C, corte 40 C, fototerapia al 82 %) la alarma de corte se activaba
    y desactivaba sola alrededor de los 40 C. En ese mismo banco los dos sensores
    de aire leian 38.18 y 38.34 en el mismo instante: 0.2 C es directamente el
    suelo de ruido entre lecturas, no una banda de histeresis.
    Solo mueve el punto de RETIRADA. La condicion se declara igual que antes, al
    superar in3.airTemperatureSetMax; lo que cambia es que ahora hace falta bajar
    de 39.5 en vez de 39.8 para retirarla. O sea que NO relaja la proteccion: la
    hace mas conservadora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
    [security.cpp]
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2026-09-14 fix(motherboard): quitar dos caminos que tumbaban la placa con la sonda puesta
    Banco 2026-09-14: con la sonda de PPG aplicada la MB aborto. Coredump:
    E esp_littlefs: lfs.c:702:error: No more free space 0x135 (en bucle)
    abort() was called at PC 0x42132abb on core 1
    #13 std::string::append(" HR3=")
    #6 operator new (sz=323) -> lanza std::bad_alloc
    #4 std::terminate() -> abort()
    Son dos defectos encadenados, los dos en el camino que SOLO corre con sonda
    aplicada — por eso no se habia visto en toda la flota hasta el 2026-09-10.
    1) UNA LINEA DE LOG TUMBABA EL EQUIPO (SPO2.cpp)
    Se montaba encadenando ~20 concatenaciones de String: cada `+` crea un
    temporal y realoca, y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
    [DriveUpload.cpp, Logger.cpp, SPO2.cpp, main.h]
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2026-09-14 fix(platform): FsFile::name() devolvia la ruta y rompia tres subsistemas
    Regresion del porte, de la misma familia que las otras: la capa de
    compatibilidad se comportaba distinto que Arduino y nada daba error.
    `FsFile::name()` devolvia `path_` entero ("/littlefs/pox_123.csv") cuando el
    firmware, que viene de Arduino, espera el NOMBRE PELADO ("pox_123.csv"). Los
    cuatro llamantes que hay lo asumen asi, y los tres primeros quedaban mudos:
    - DriveUpload.cpp, limpieza de arranque: `strncmp(nameBuf, "pox_", 4)` no
    casa con "/littlefs/pox_...". Las ventanas de PPG de arranques anteriores
    NO SE BORRABAN NUNCA.
    - El mismo bucle aplica el tope de 5 a los crash_mb_/crash_hmi_. Tampoco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
    [Wifi_OTA.cpp]
2026-09-14 fix(motherboard): tres umbrales calibrados contra un punto de trabajo supuesto
    Los tres tienen la MISMA forma: una constante elegida contra un punto de
    trabajo estimado que no es el real, y que por eso disparaba siempre o no
    disparaba nunca. Los tres salen de medir en banco (2026-09-14, unidad 353).
    1) ALARM_AIR_OUTLET_BLOCKED: 190/15 -> 220/20
    El razonamiento de board.h partia de un baseline de 137 y un peor caso
    legitimo de ~158. 97 muestras con el ventilador a 4006 rpm, calefactor a
    255 y fototerapia al 82 %, con la salida LIMPIA, dan otra cosa:
    duty min 186 max 188 media 187,0
    Con el umbral en 190 quedaban DOS cuentas de margen, no el 39 % que decia
    el text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
    [DriveUpload.cpp, board.h, security.cpp]
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2026-09-15 fix(security): sacar del codigo la contrasena del servidor web
    Estaba EN CLARO en fuentes versionadas de un repositorio PUBLICO. No hacia
    falta extraerla de ningun binario: se leia en GitHub.
    motherBoard/src/tasks/Wifi_OTA.cpp comprobacion de login en JavaScript
    flasher_tool/flasher/wifi_flasher.py pares HTTPBasicAuth en duro
    4 documentos de docs/superpowers/ usuario y contrasena en el texto
    La contrasena del servidor web y el par de provisioning de ThingsBoard se
    rotaron el 2026-09-15, asi que los valores que habia publicados ya no sirven.
    Este commit impide que la nueva acabe en el mismo sitio.
    1) Wifi_OTA.cpp: se quita la comprobacion de credenciales en JavaScript.
    No pr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
    [Wifi_OTA.cpp, wifi_flasher.py]
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2026-09-15 fix(motherboard): OTA por 2G de extremo a extremo con esp_modem
    Cadena de defectos que impedia completar una actualizacion por celular en el
    port ESP-IDF, todos medidos en banco (SN 353) el 2026-09-15/16:
    - Modem mudo tras cualquier reset del ESP32: queda en CMUX y PWRKEY no esta
    cableado. Rescate auto-verificado (CLD, comandos, DETECT + cierre) en
    gprs_modem.cpp, tambien en el camino de recuperacion en marcha. powerDown ya
    no manda AT+CPOWD=1: apaga el modem y nada puede volver a encenderlo.
    - AT+SAPBR=1,1 respondia NO CARRIER y mataba la sesion PPP: fuera.
    - tb.connect() es asincrono con esp-mqtt: se espera la sesion antes de
    suscribir y de pedir la OTA (antes fallaban las seis su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
    [GPRS.cpp, GPRS.h, Wifi_OTA.cpp, Wifi_OTA.h, main.h]
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2026-09-16 refactor(motherboard): un unico punto por el que se fija el reloj
    Todas las rutas que ponen el reloj pasan ya por systemClockSet(epoch, src), y
    el orden lo arbitra time_source. systemClockSetManual() se queda como envoltorio
    para no tocar a sus cuatro llamantes (/config, HMI,SET_TIME, DriveUpload,
    debug_mode).
    El arreglo que de verdad importa esta en GPRS.cpp. GPRSEnsureTimeSynced() tenia
    dos ramas —AT+CCLK? (NITZ de la red) y el fallback AT+CNTP contra
    pool.ntp.org— que compartian la variable `got` y acababan en el mismo
    settimeofday(). Eran indistinguibles aguas abajo, pero son el ultimo y el
    segundo rango de la jerarquia. Sin separarlas, un NTP bueno quedaba etiquetado
    como NITZ, y e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
    [GPRS.cpp, main.cpp, system_clock.cpp, system_clock.h]
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2026-09-16 fix(motherboard): retirar el RPC wipeBabies, que borraba el historial en remoto
    El codigo de confirmacion {"confirm":1234} evitaba el disparo accidental,
    pero no cambiaba quien tenia la capacidad: cualquiera con permiso de RPC
    sobre el dispositivo podia dejar sin registros clinicos una incubadora en
    produccion, desde fuera del hospital y sin tocarla.
    El borrado sigue existiendo por la via de servicio /config,BABY_WIPE,1234
    sobre el cable entre placas (CommTask.cpp), que exige acceso fisico. Esa
    via no la ejerce la pantalla tactil: el firmware del HMI no emite ninguna
    linea /config, y el inyector de /debug/inject solo acepta el prefijo HMI,.
    Estaba registrado solo en el transporte GPRS; por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
    [GPRS.cpp]
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2026-09-16 fix(hmi): el indicador de conectividad se lee en la pantalla de bloqueo
    El icono y las barras de cobertura del heading se pintaban con el azul de
    marca (0x0075EE) cuando la placa estaba hablando con ThingsBoard, y con negro
    cuando habia transporte pero no servidor. Sobre el fondo de ui_ScreenLock
    (0x242323) ninguno de los dos se lee, y ahi es justo donde mas rato se ve el
    indicador: la unidad pasa la mayor parte del tiempo bloqueada.
    Ahora el caso bueno va en verde 0x2E9E4F, el mismo tono con el que
    wifi_link_status_update() ya pinta "MB: ..." en Ajustes/WiFi para decir
    exactamente esto (hay servidor), con lo que las dos lecturas de "sube
    telemetria" del HMI quedan por fin en el mismo color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
    [ElementsCreation.cpp, UITask.cpp]
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2026-09-16 fix(motherboard): el log del modem adivinaba quien habia puesto el reloj
    "[GPRS] -> time already synced (WiFi NTP)" no era un dato, era una suposicion:
    esa rama salta con el reloj puesto por CUALQUIER fuente y siempre culpaba al
    NTP por WiFi. En banco el 2026-09-16 salio anunciando WiFi NTP con la hora
    tecleada a mano en /config, y otra vez con la hora sembrada desde el RTC del
    HMI. Dos sesiones distintas lo tomamos por prueba de que SNTP habia funcionado
    y razonamos sobre el estado de la red a partir de algo que no lo decia.
    Ahora que time_source sabe de verdad quien fijo el reloj, el mensaje dice el
    rango y se acabo la adivinanza. Es exactamente el problema que motivaba esta
    feature, esco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
    [GPRS.cpp]
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2026-09-16 fix(motherboard): recuperar el estado de control tras cualquier reinicio salvo brownout
    La recuperacion se decidia enumerando los reinicios "malos" (PANIC y los tres
    watchdog). Esa lista deja fuera POR DEFECTO cada ruta de reinicio que se anada
    despues, y ya habia tres alcanzables con el equipo en marcha que no recuperaban
    nada: el esp_restart() de DriveUpload cuando el heap queda critico —justo la
    condicion de un equipo que se esta quedando sin memoria, que es cuando mas
    falta hace—, el RPC de reinicio de ThingsBoard y el reinicio tras OTA. Las tres
    imprimen el mismo rst:0xc (RTC_SW_CPU_RST) que un panico en el bootloader de
    ROM, asi que desde el log no se distinguian.
    La regla se invi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
    [EEPROM.cpp, initHardware.cpp]
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2026-09-16 feat(hmi): retirar el boton TREND de la pantalla de bloqueo
    Peticion para la tanda de fabricacion del 2026-09-17. Se va el boton
    entero (ui_ChartLockCont/Img/Label), sus dos handlers, las areas de toque
    extendidas y las declaraciones del header.
    Con el se va la leccion 9 de enfermeria ("Tendencia"), que pedia abrir la
    grafica con ese boton y sin el no tenia como completarse. Se deja el hueco
    en la numeracion (8 -> 10) a proposito: el progreso se guarda por indice de
    array (TrainingProgress_MarkLesson), asi que renumerar no lo arregla, y
    cambiar los nombres de las dos siguientes solo anadiria ruido. En una
    unidad con progreso ya guardado las marcas de las lecciones 10 y 11 se
    desplazan un in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
    [ElementsCreation.cpp, UITask.cpp]
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2026-09-17 fix(hmi): cerrar la ventana de carrera que apagaba el control recien encendido
    El operador enciende el control de temperatura o la fototerapia y a los
    pocos MILISEGUNDOS el switch se apaga solo, como si hubiera pulsado OFF.
    Intermitente, y sin rastro en el log.
    La guarda de confirmacion de a475635 esta bien y cubre los siete campos;
    lo que fallaba es CUANDO se arma. Se armaba solo en el sondeo de 10 ms de
    Comm_Task, pero quien decide es UITask, dentro de Display_ApplyCtrlState().
    Entre el toque (UITask escribe hmi_msg) y el siguiente sondeo cabe un
    CTRL,STATE viejo ya parseado: al aplicarlo `pending` sigue false, gana el
    eco, se reescribe hmi_msg, y el sondeo siguiente ya no ve ningun cambi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
    [CommTask.cpp]
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2026-09-20 feat(debug): modo depuracion en las dos placas, bateria de banco y reset manual de alarmas
    (cherry picked from commit 17312e36fab2a6b5d57972de779d2aef9605a897)
    Portado a dev-pio desde el port a ESP-IDF. Adaptaciones respecto al original,
    todas por diferencias de plataforma y ninguna de comportamiento:
    - Se quitan los includes de platform/plat_time.h (no existe aqui) en las dos
    debug_mode.cpp; no se usaba ninguna funcion de esa cabecera.
    - HMI Wifi_OTA.cpp: delay_ms(300) -> delay(300).
    - HMI lib/TAMC_GT911_Fixed: se anaden los cinco contadores gt911_* que
    /debug/state ya consultaba y que en el port viven en el componente GT911
    (7a8463a): read_failures, press_events, last_x, last_y, to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
    [CommTask.cpp, CommTask.h, Wifi_OTA.cpp, main.cpp, security.cpp]
2026-09-20 fix(hmi): el RTC portado habla con Wire y Preferences, no con la capa del port
    Los dos ficheros del cambio del RTC (fe95a7f) que dependian de la capa de
    plataforma del port a ESP-IDF, adaptados a lo que hay en esta linea:
    - drivers/rtc_pcf8563.cpp usaba `g_i2c` (I2cBus de platform/plat_i2c.h). Se
    reescribe sobre la `Wire` de Arduino con cuatro primitivas que replican la
    semantica de I2cBus —probe, readReg, write, writeReg8—, cada una una
    transaccion completa que devuelve false ante NACK o lectura corta. El RTC
    entra en el mismo bus que el tactil, la retroiluminacion y el zumbador, que
    ya lo compartian sin cerrojo comun: no se anade uno aqui para no cambiar el
    patron del rest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
    [CommTask.cpp, rtc_pcf8563.cpp]
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2026-09-20 fix(flasher): no borrar la NVS cuando el serial no cambia
    Una unidad reflasheada con la herramienta dejo de conectarse a ThingsBoard.
    No era del servidor: flasher_config.json trae force_serial_number, asi que el
    flasher pide el serial tambien a una placa que ya tiene firmware, y con un
    serial en la mano flash_board escribe la imagen de generate_serial_nvs. Esa
    imagen es del tamano de la particion entera y lleva un solo dato
    (mb_cfg/serial), asi que arrasa con todo lo demas que vive en NVS: el token de
    ThingsBoard y la marca de provisionado (mb_gprs) y las credenciales WiFi
    (mb_wifi).
    Lo que se ve luego no se parece a la causa. Sin WiFi guardada la placa cae al
    SSID compilado, que fuera del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
    [flasher.py, main.py]
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2026-09-20 fix(motherboard): la OTA no podia terminar nunca, se reiniciaba sola cada 10 min
    Dos defectos encontrados probando una OTA por 2G en banco, los dos silenciosos.
    1) FIRMWARE_PACKET_SIZE era 4096 y no cabe en el buffer del cliente MQTT, que
    es MAX_MESSAGE_SIZE (1024 B). Ese buffer tiene que alojar el paquete MQTT
    entero --cabecera y topico ademas del payload-- asi que el trozo util no
    llega a 1 KB. El chunk se descartaba por tamano, el cliente agotaba sus 10 s
    y lo volvia a pedir. Medido: 92 trozos de 365 en ~9 min con 40 expiraciones,
    ~293 B/s. Con 512: ~638 B/s y CERO expiraciones.
    2) GPRSCheckOTA() se guardaba con updateRequestSent, declarada a false y NUNCA
    ASIGNADA en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
    [GPRS.cpp, Wifi_OTA.cpp, main.h]
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2026-09-20 chore(hmi): version 4.2.0 y binarios al dia en el flasher
    Compilado el entorno `main` y ademas la imagen del sistema de archivos con
    `pio run -e main -t buildfs`, que un build normal NO genera: spiffs.bin lleva
    /heartbeat.mp3 y sin el la unidad arranca sin sonido de latido y sin dar error
    de flasheo.
    Comprobado dentro de los binarios, no de palabra: la cadena 4.2.0 esta y la
    4.1.0 ya no; heartbeat.mp3 viaja en spiffs.bin; y las credenciales compiladas
    son las reales de Credentials.h, no los valores de relleno de
    Credentials_public.h.
    Sin probar en hardware: las placas no estan conectadas al USB.
    [main.h]
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2026-09-20 fix(motherboard): AIR SENSOR FAULT en cada arranque, y provisioning mudo por WiFi
    1) La alarma de sensor de aire saltaba en todos los encendidos y se retiraba
    sola a los pocos ms. checkStatusOfSensor() mide la caducidad contra
    lastSuccesfullSensorUpdate[], que vale 0 hasta la primera lectura buena; y
    cuando la tarea de seguridad hace su primera pasada, millis() ya va muy por
    encima de los 5 s del limite porque initHardware() tarda mas que eso. O sea
    que el sensor salia caducado ANTES de haber tenido ocasion de hablar.
    No es cosmetico: ALARM_AIR_SENSOR_FAULT es de prioridad ALTA y corta el
    calefactor. Una alarma de seguridad que suena en todos los arranques entrena
    al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
    [GPRS.cpp, Wifi_OTA.cpp, main.h, security.cpp]
2026-09-20 fix(motherboard): AIR SENSOR FAULT seguia saltando en el arranque
    El arreglo anterior no servia de nada y la placa lo demostro: guardaba solo
    contra lastSuccesfullSensorUpdate[] == 0, y en el arranque ese sello NO es 0.
    initHardware() llama a updateRoomSensor() para su autotest (initHardware.cpp:463)
    y sella el sensor ahi, pero despues sigue varios segundos mas antes de crear las
    tareas. Para cuando la tarea de seguridad mira por primera vez, ese sello ya ha
    caducado aunque el sensor este perfecto.
    La referencia pasa a ser el instante MAS RECIENTE entre la ultima lectura buena
    y el arranque de sensors_Task (g_sensorsTaskStartedMs), que es cuando de verdad
    empiezan las muestras periodicas: e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
    [main.cpp, main.h, security.cpp]
2026-09-20 feat(motherboard): /debug/state cuenta el estado de la nube
    "No conecta con ThingsBoard" no se podia diagnosticar sin abrir el puerto
    serie, y en una unidad montada ese puerto no esta a mano: en fabrica o en campo
    no hay forma de saber en que punto se atasca. Paso real (unidad 356,
    2026-09-20): WiFi levantada, activacion de SIM por TLS correcta --o sea
    internet de sobra-- y ni un dispositivo creado en el servidor, sin manera de
    mirar por que.
    El endpoint ya existia, es de solo lectura y pide usuario y clave. Ahora trae
    un bloque "cloud" que separa las averias, que es lo unico que hacia falta:
    wifi.connected=0 -> no hay red; no mires mas alla
    serial=0 -> sin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
    [main.h]
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
